makermare/UAV-FlyingControlSystem-LightFlightControl/5. 飞控官方基础源代码/对应的光流模块源码/README.txt

This is a Micro Python board

You can get started right away by writing your Python code in 'main.py'.

For a serial prompt:
 - Windows: you need to go to 'Device manager', right click on the unknown device,
   then update the driver software, using the 'openmv.inf' file found on this drive.
   Then use a terminal program like Hyperterminal or putty.
 - Mac OS X: use the command: screen /dev/tty.usbmodem*
 - Linux: use the command: screen /dev/ttyACM0

Please visit https://openmv.io/ or http://micropython.org/help/ for further help.
