makermare/UAV-FlyingControlSystem-LightFlightControl/15. 飞控外围模块资料2：蓝牙模块配置资料/先读我，补充说明.txt

蓝牙 与飞控连接  之前

确认蓝牙与TTL 是否连接正常(TXD接RXD)，波特率是否与AT指令模式 的波特率 一致
蓝牙模块未连接设备就一直是AT指令模式，AT指令模式的波特率 默认是9600，
而卖家发货前已修改为38400，以后是上一次更改过的

指令集中的 发送 AT\r\n 的本质不是让你 发送 “AT\r\n ”字符串，而是发送“AT”后加回车结尾，
加回车结尾 千万别理解成 回车键是发送，“AT”后加回车结尾 然后手动点击发送 检查是否通信正常，
有无OK回应，不正常请检查前几步骤。

发送“AT+BAUD6“ 后加回车结尾 改波特率为38400,1停止位,无校验
