makermare/UAV-FlyingControlSystem-LightFlightControl/6. 飞控官方源代码讲解/代码讲解.md

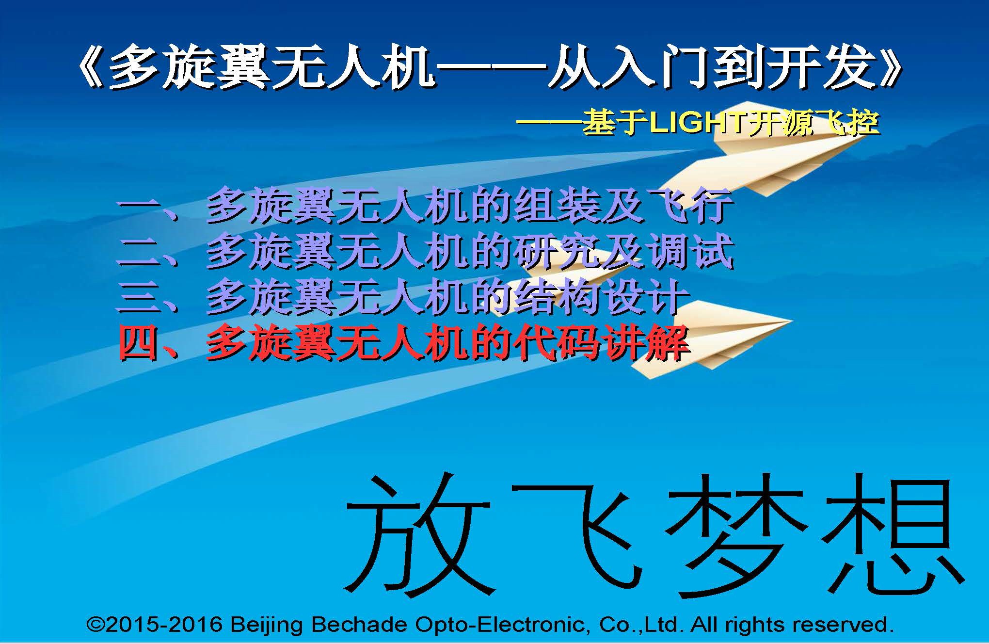
[picture p87: 6. 飞控官方源代码讲解/media/image1.jpeg]


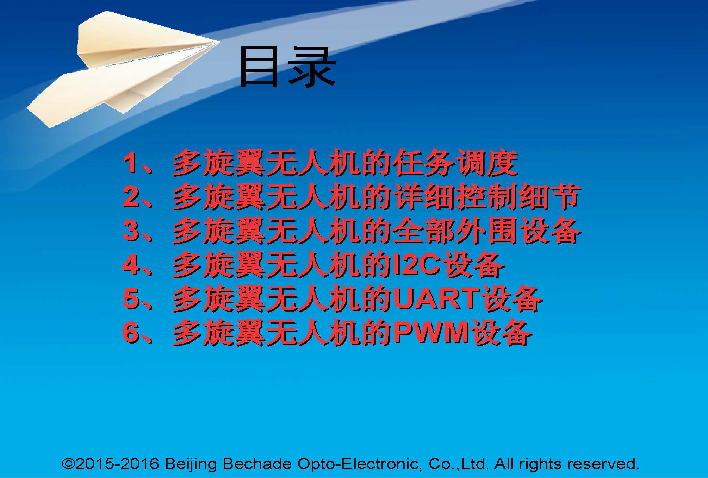
[picture p88: 6. 飞控官方源代码讲解/media/image2.jpeg]


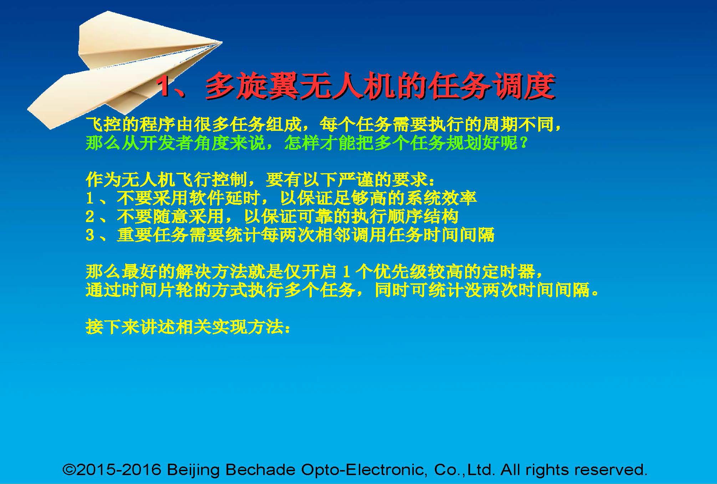
[picture p89: 6. 飞控官方源代码讲解/media/image3.jpeg]


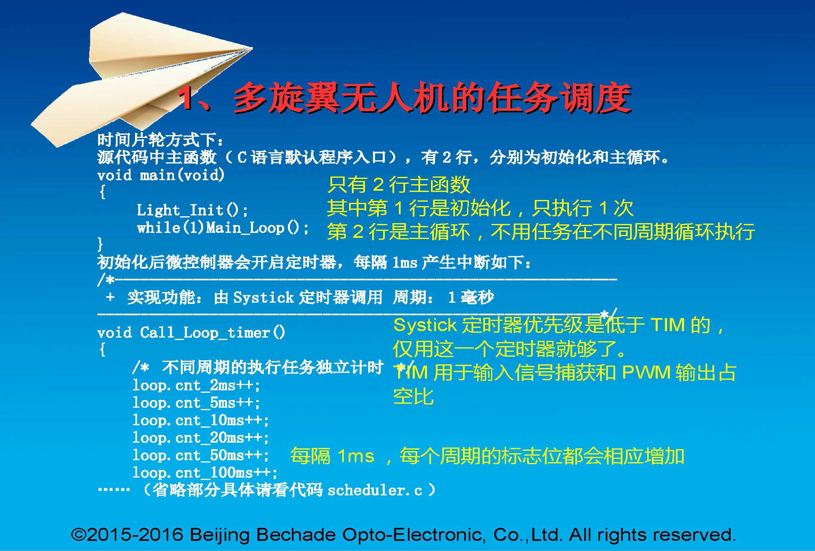
[picture p90: 6. 飞控官方源代码讲解/media/image4.jpeg]


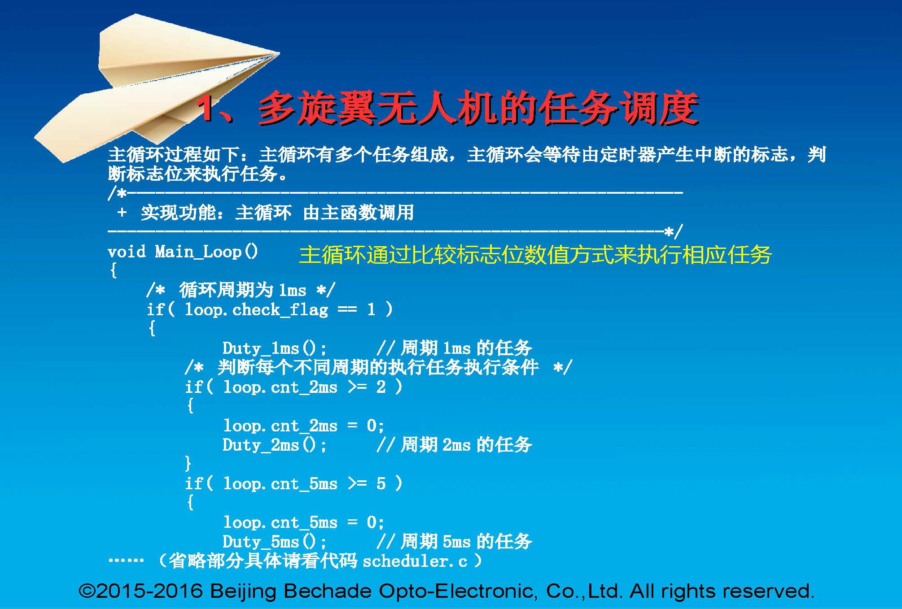
[picture p91: 6. 飞控官方源代码讲解/media/image5.jpeg]


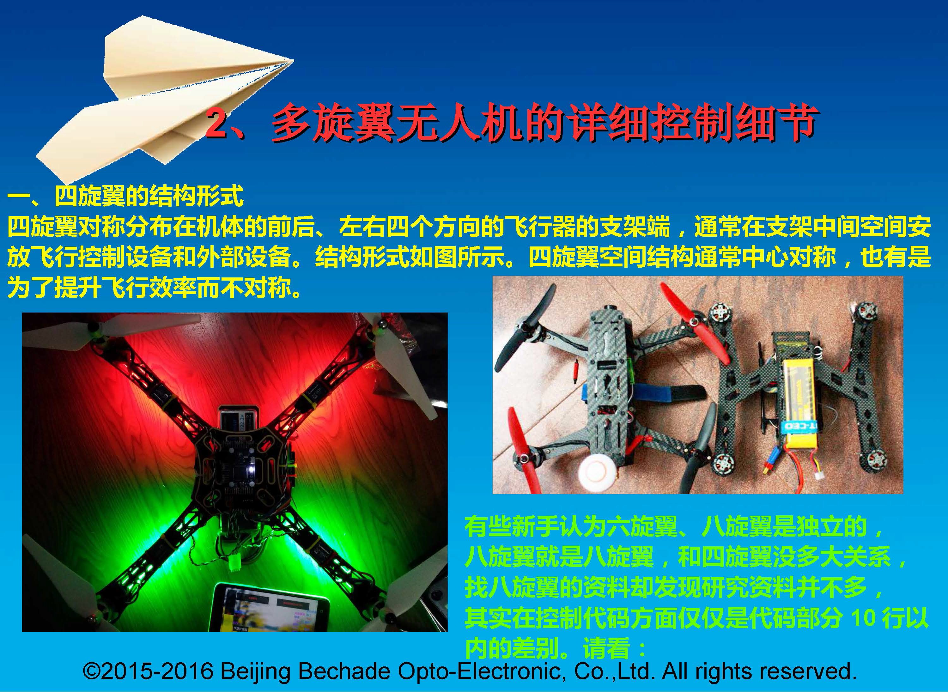
[picture p92: 6. 飞控官方源代码讲解/media/image6.jpeg]


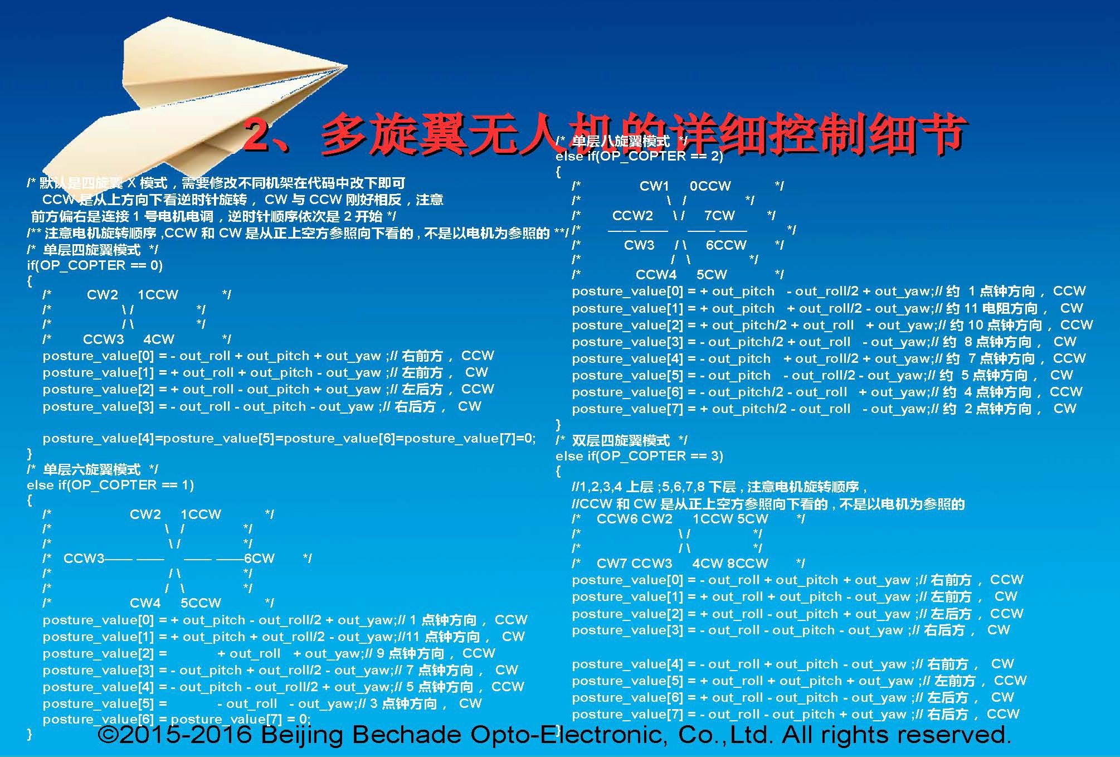
[picture p93: 6. 飞控官方源代码讲解/media/image7.jpeg]


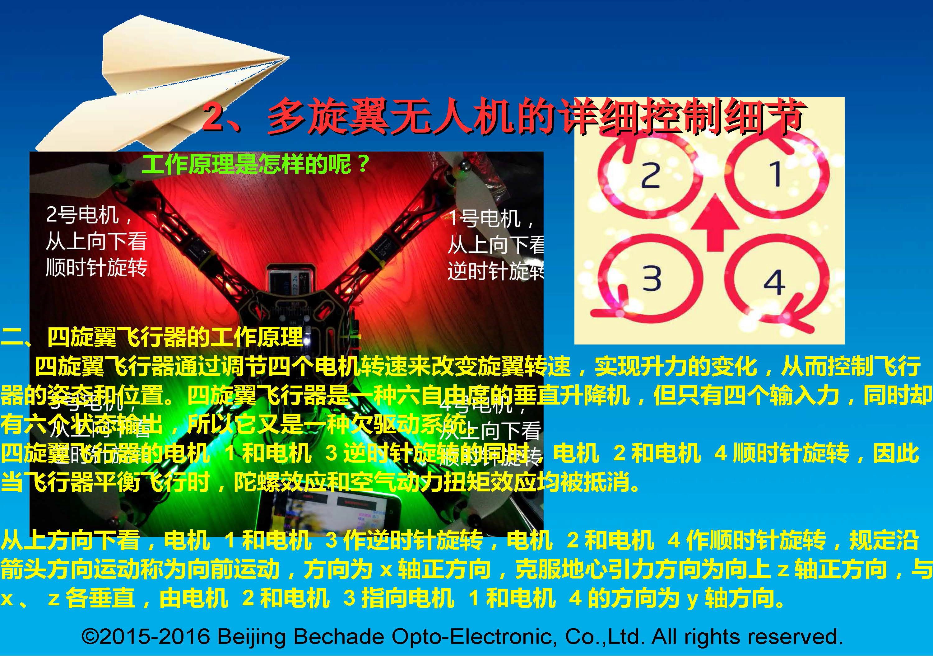
[picture p94: 6. 飞控官方源代码讲解/media/image8.jpeg]


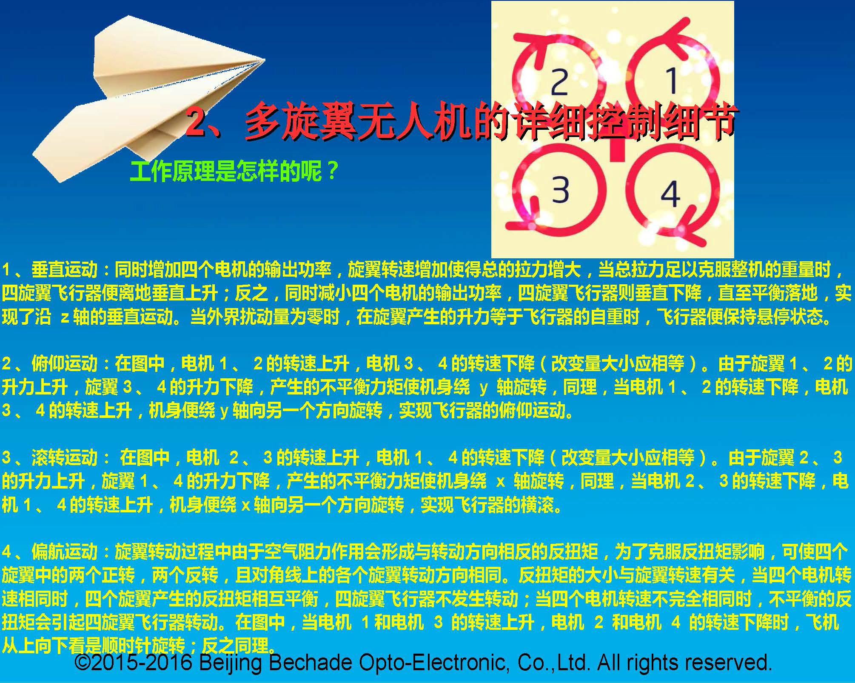
[picture p95: 6. 飞控官方源代码讲解/media/image9.jpeg]


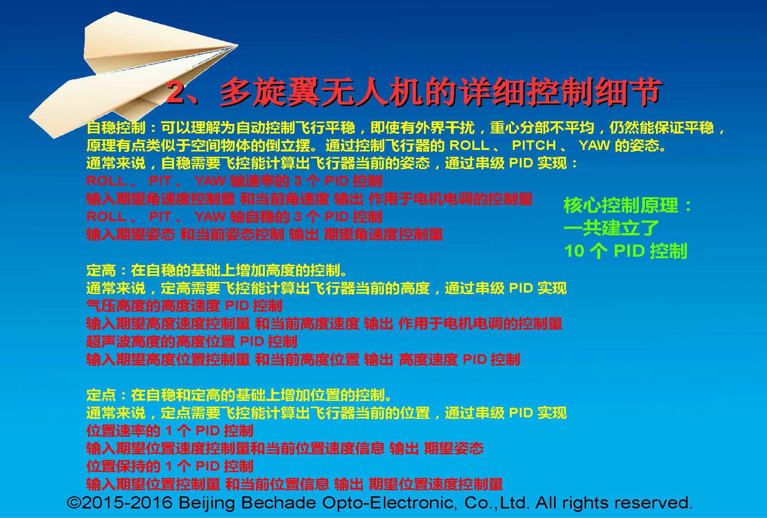
[picture p96: 6. 飞控官方源代码讲解/media/image10.jpeg]


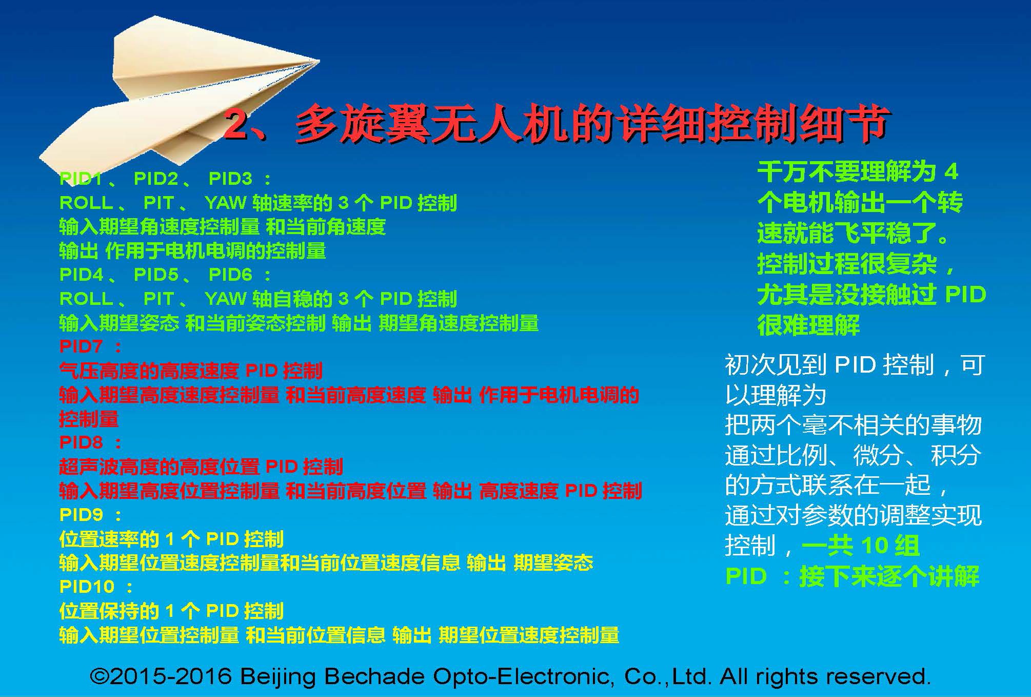
[picture p97: 6. 飞控官方源代码讲解/media/image11.jpeg]


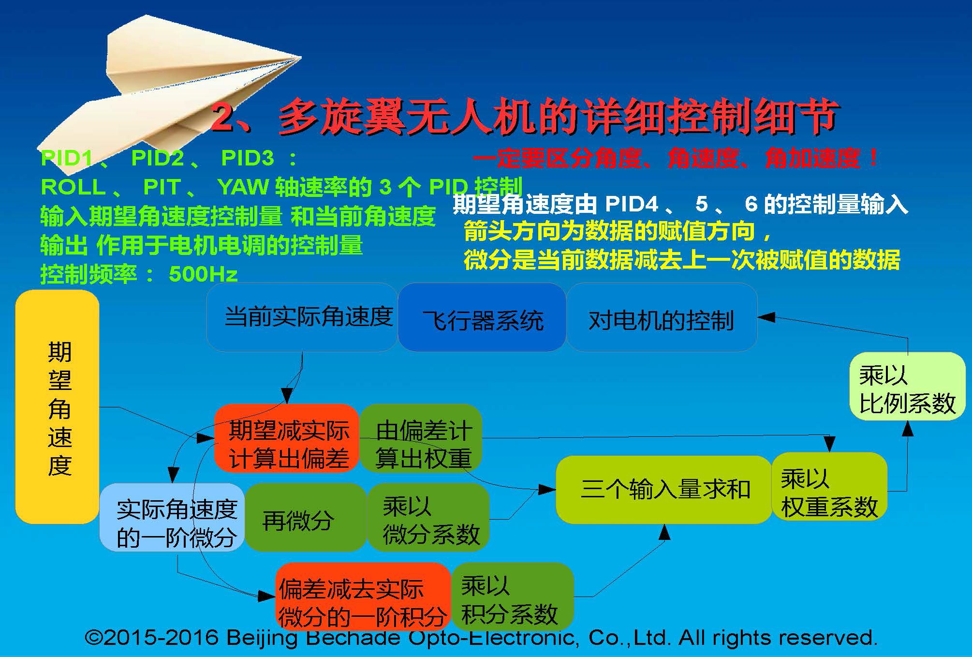
[picture p98: 6. 飞控官方源代码讲解/media/image12.jpeg]


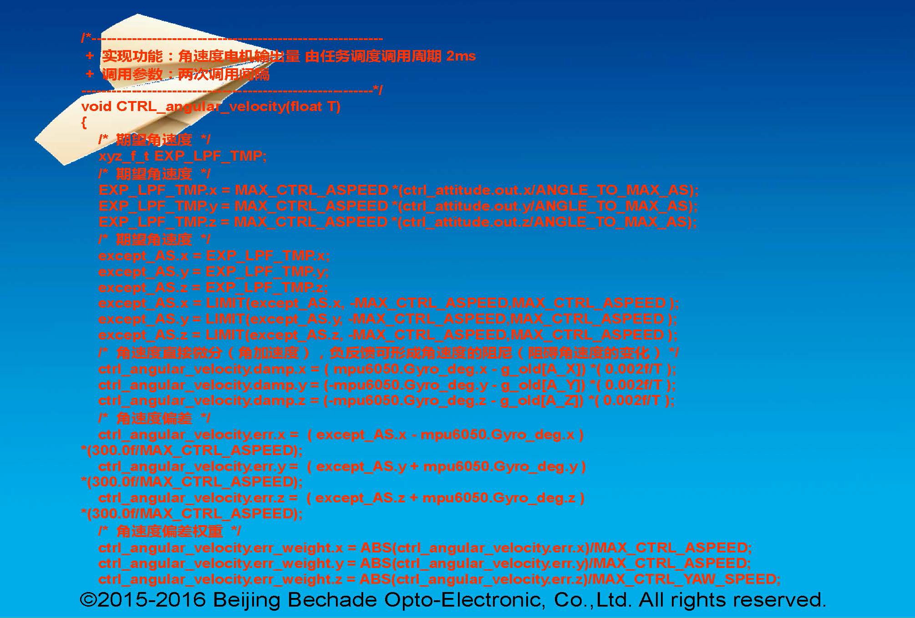
[picture p99: 6. 飞控官方源代码讲解/media/image13.jpeg]


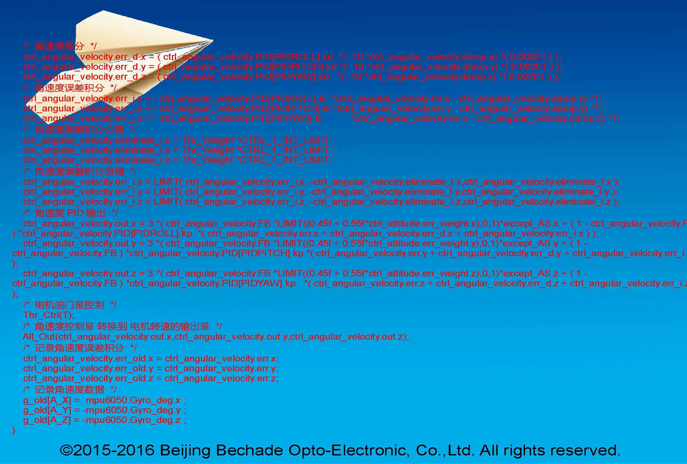
[picture p100: 6. 飞控官方源代码讲解/media/image14.jpeg]


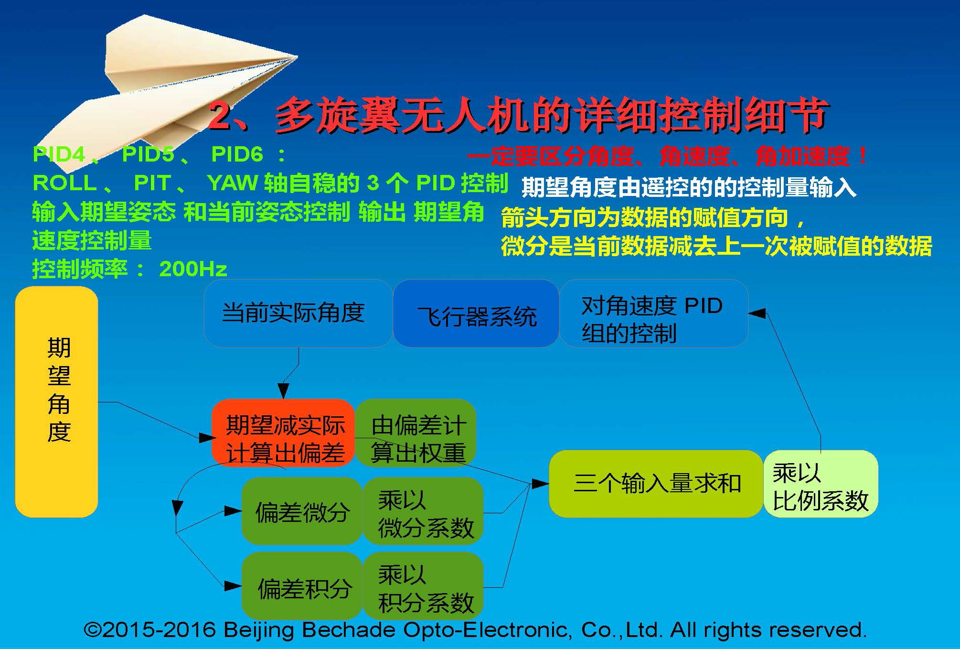
[picture p101: 6. 飞控官方源代码讲解/media/image15.jpeg]


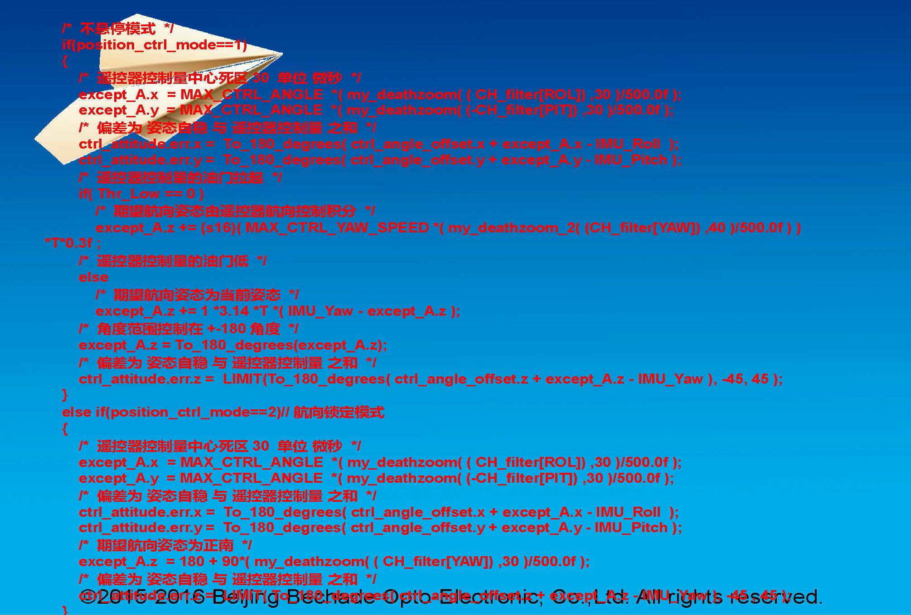
[picture p102: 6. 飞控官方源代码讲解/media/image16.jpeg]


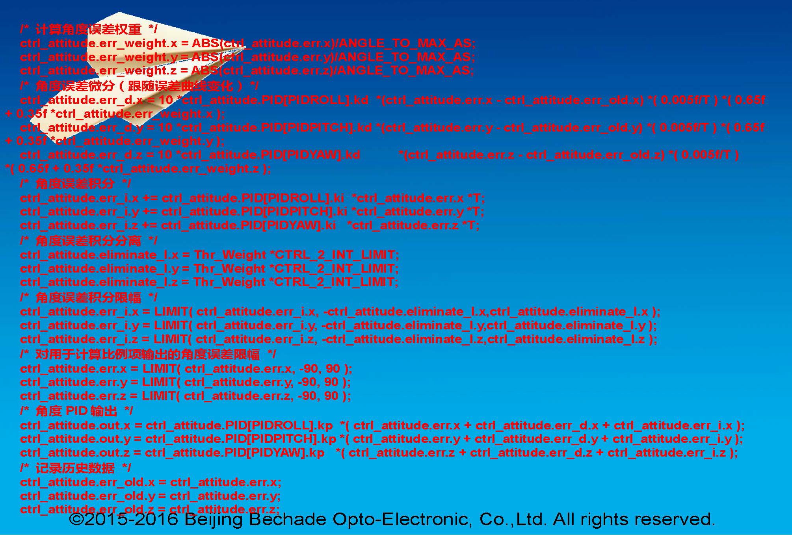
[picture p103: 6. 飞控官方源代码讲解/media/image17.jpeg]


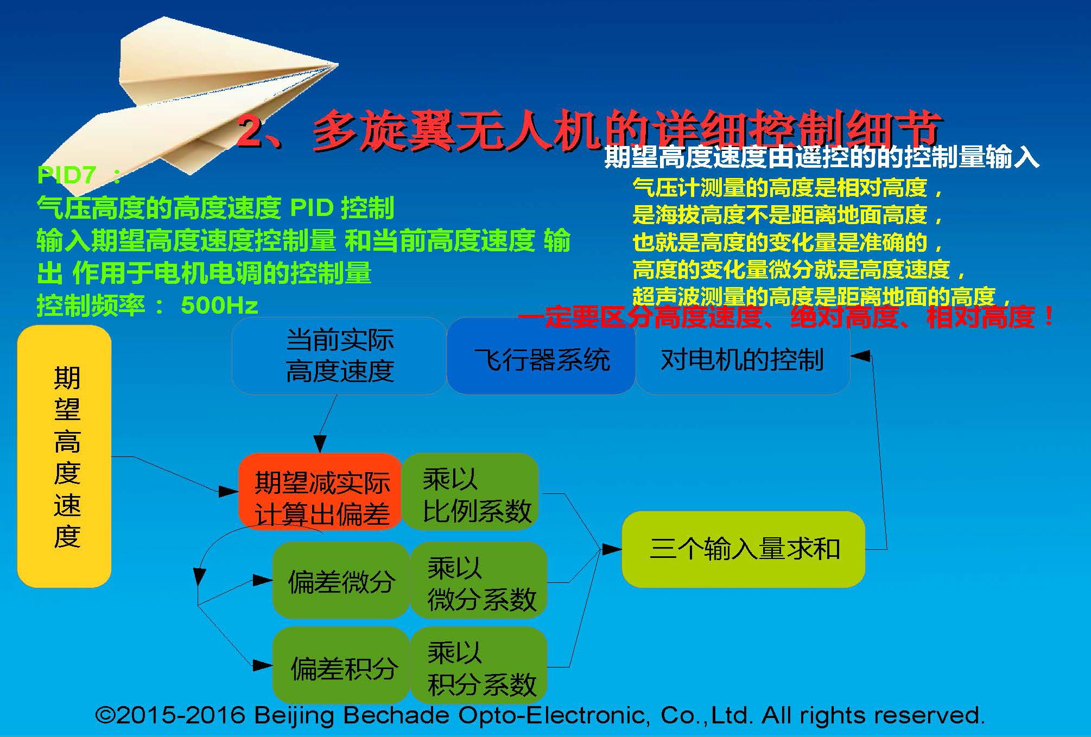
[picture p104: 6. 飞控官方源代码讲解/media/image18.jpeg]


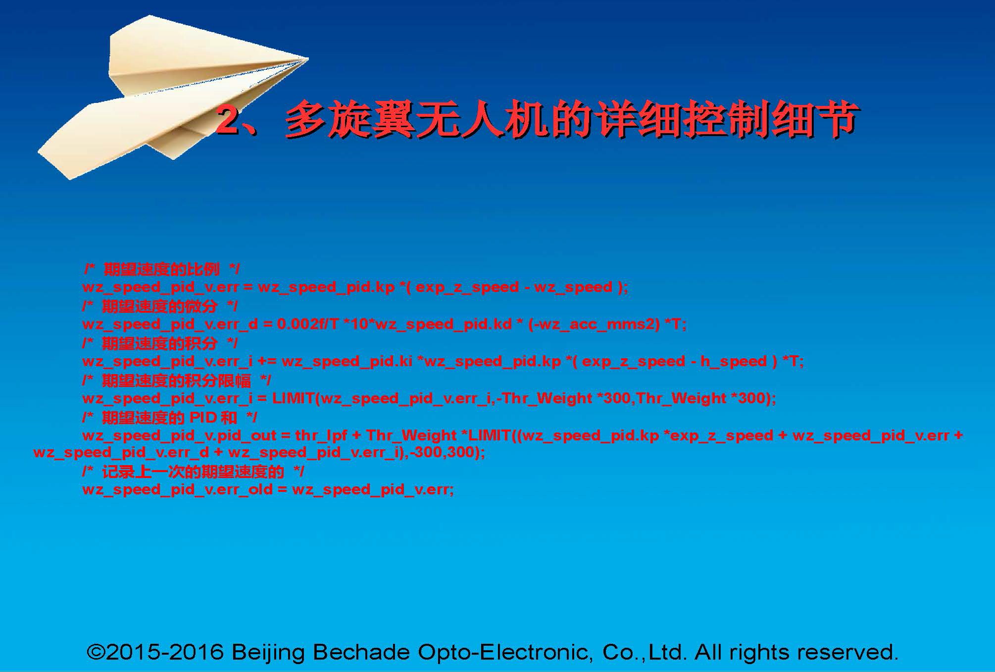
[picture p105: 6. 飞控官方源代码讲解/media/image19.jpeg]


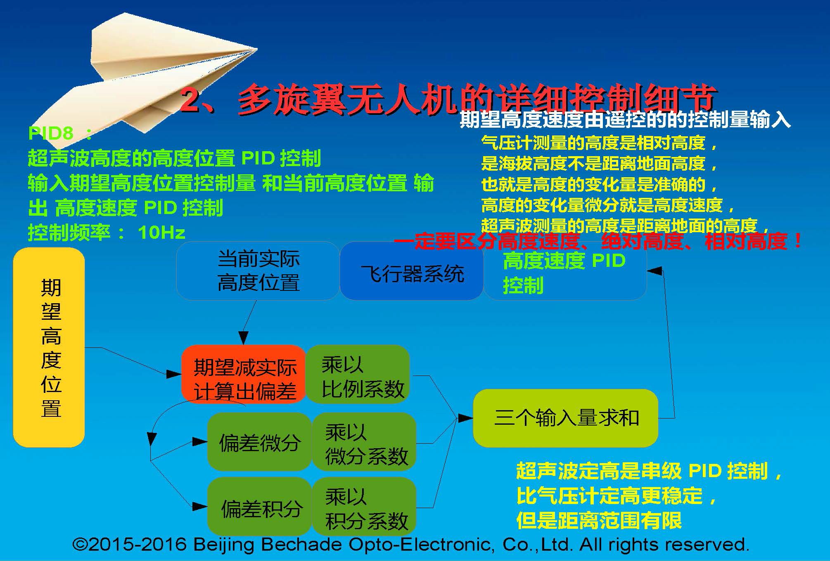
[picture p106: 6. 飞控官方源代码讲解/media/image20.jpeg]


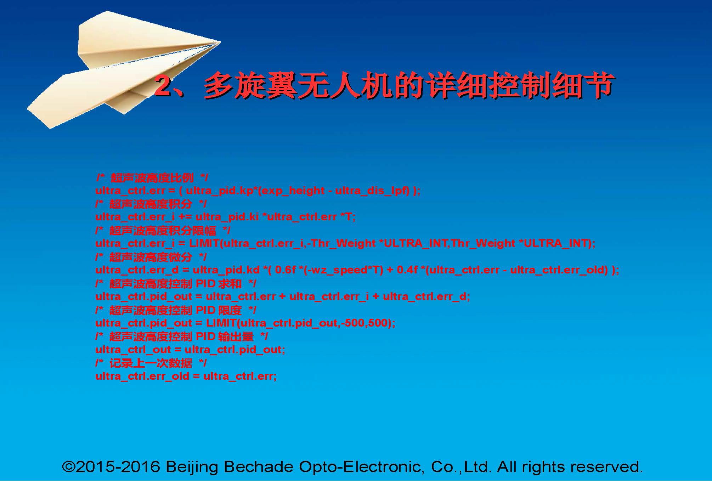
[picture p107: 6. 飞控官方源代码讲解/media/image21.jpeg]


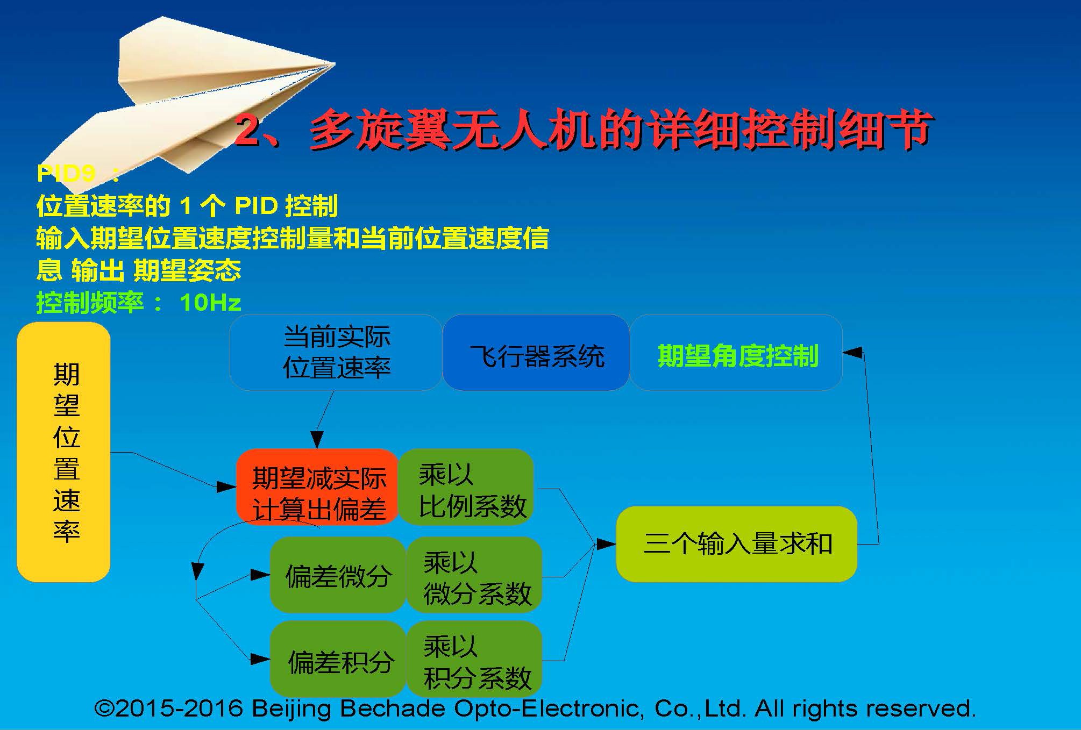
[picture p108: 6. 飞控官方源代码讲解/media/image22.jpeg]


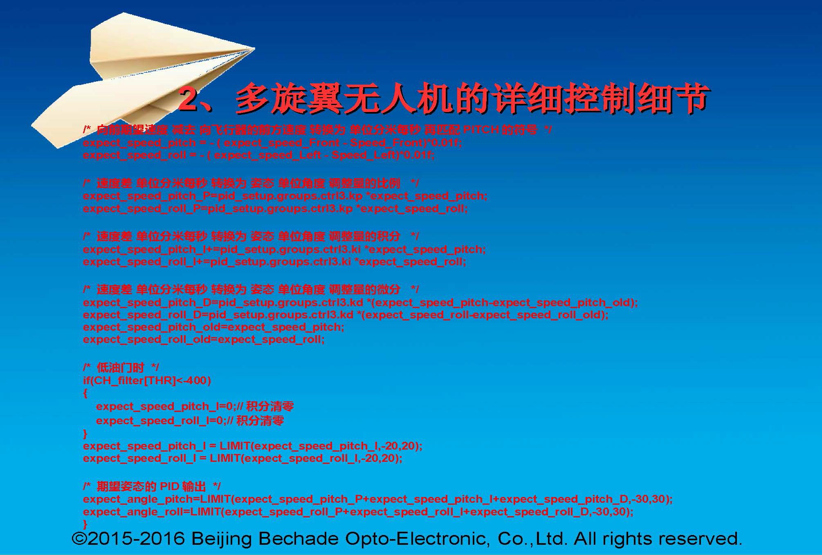
[picture p109: 6. 飞控官方源代码讲解/media/image23.jpeg]


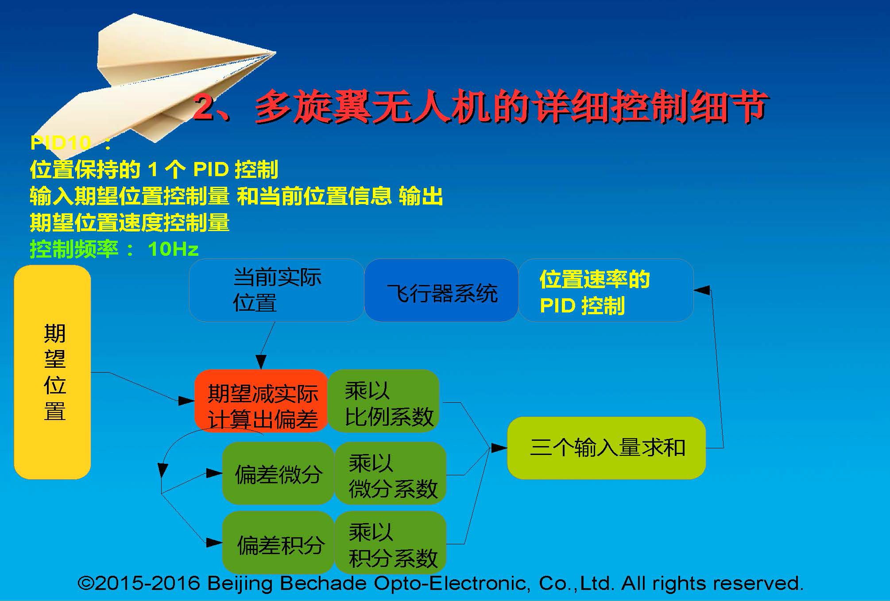
[picture p110: 6. 飞控官方源代码讲解/media/image24.jpeg]


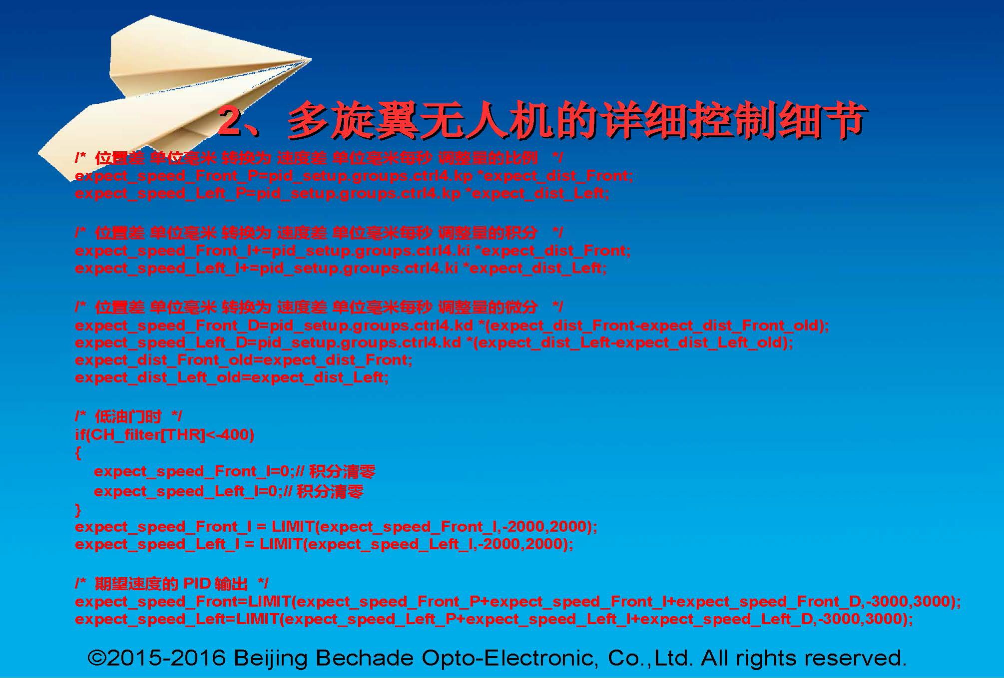
[picture p111: 6. 飞控官方源代码讲解/media/image25.jpeg]


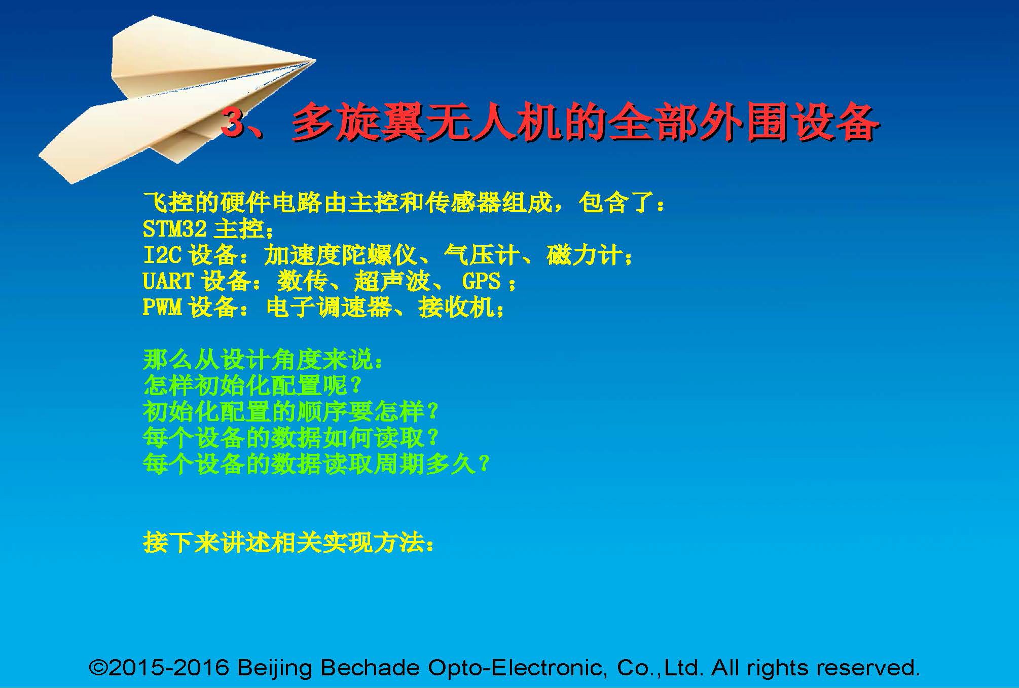
[picture p112: 6. 飞控官方源代码讲解/media/image26.jpeg]


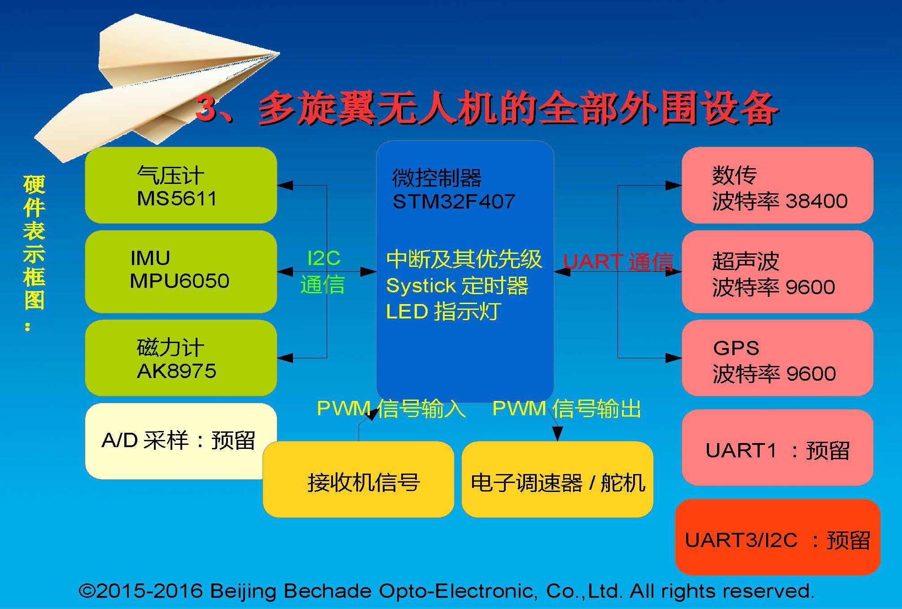
[picture p113: 6. 飞控官方源代码讲解/media/image27.jpeg]


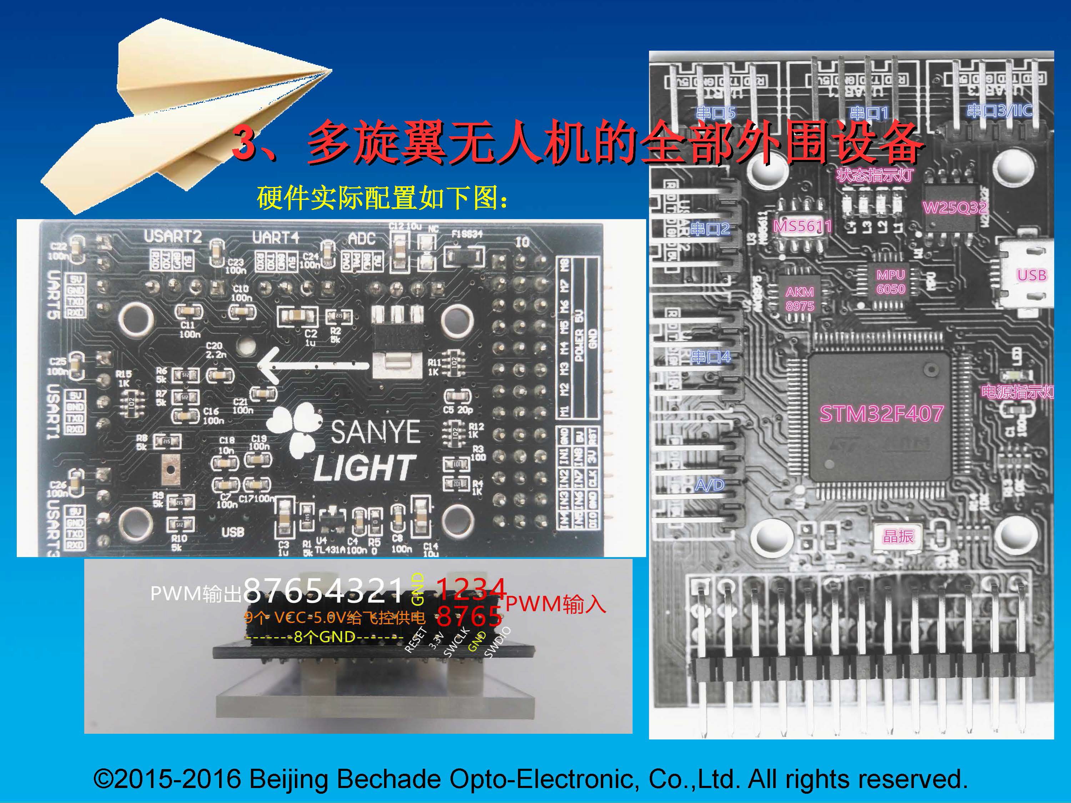
[picture p114: 6. 飞控官方源代码讲解/media/image28.jpeg]


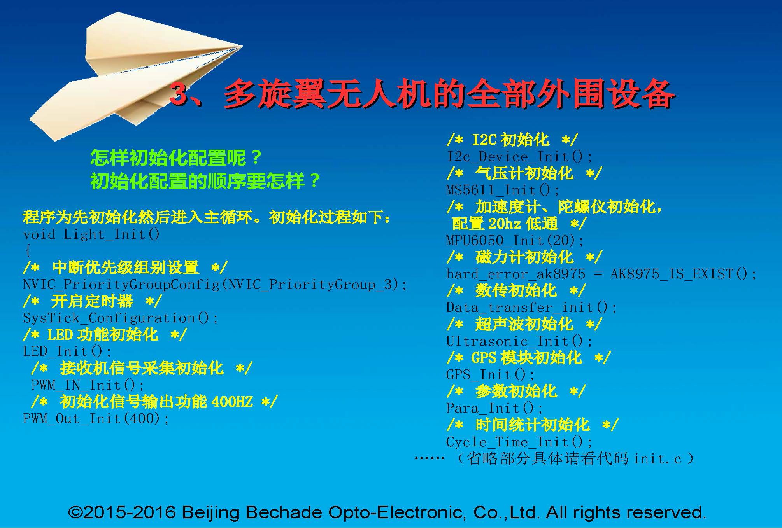
[picture p115: 6. 飞控官方源代码讲解/media/image29.jpeg]


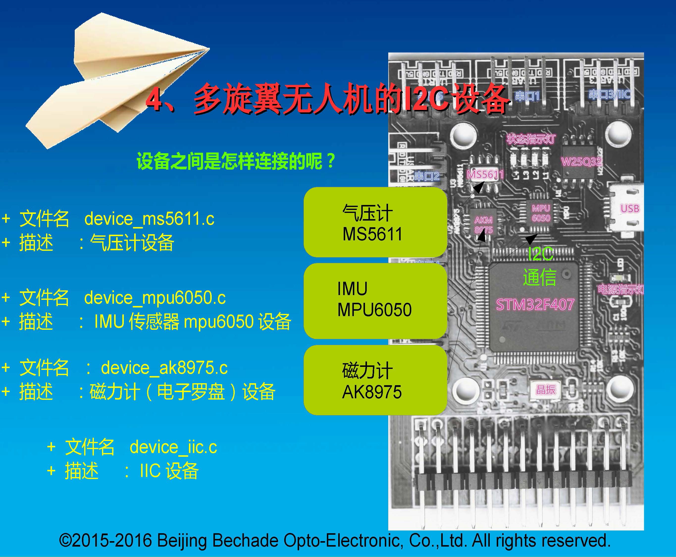
[picture p116: 6. 飞控官方源代码讲解/media/image30.jpeg]


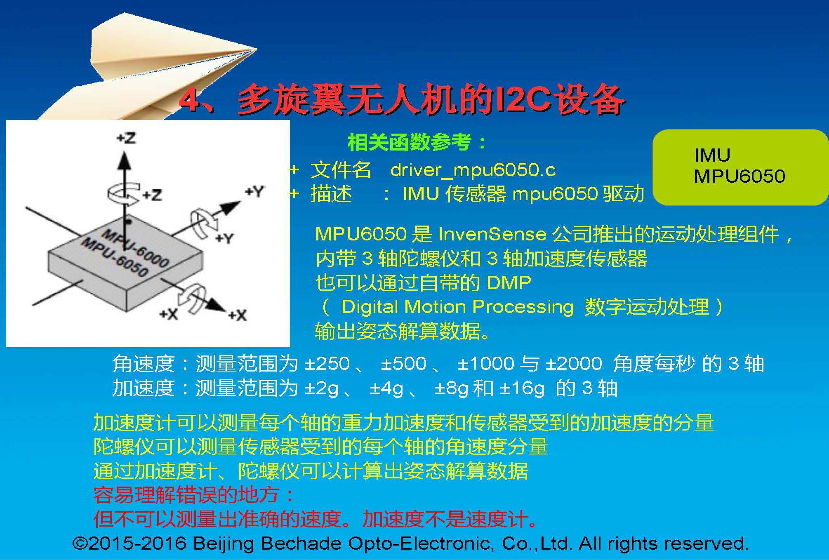
[picture p117: 6. 飞控官方源代码讲解/media/image31.jpeg]


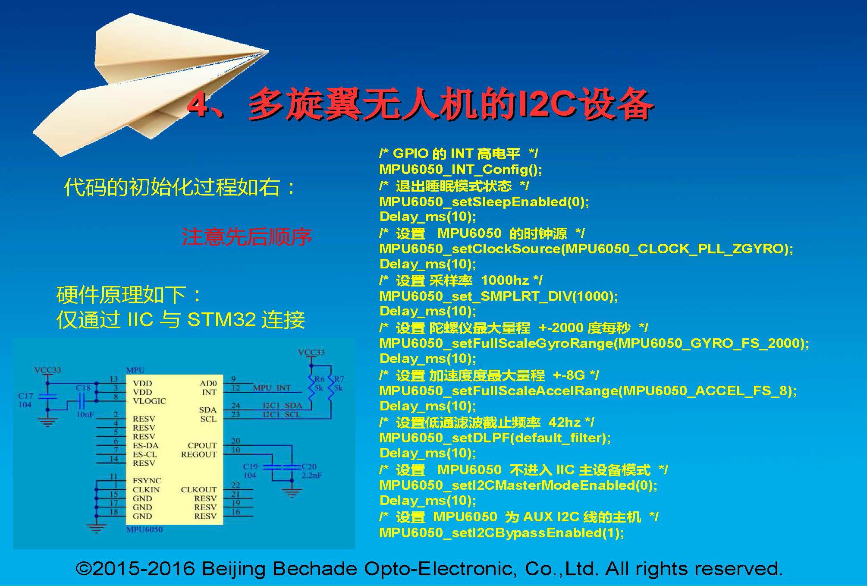
[picture p118: 6. 飞控官方源代码讲解/media/image32.jpeg]


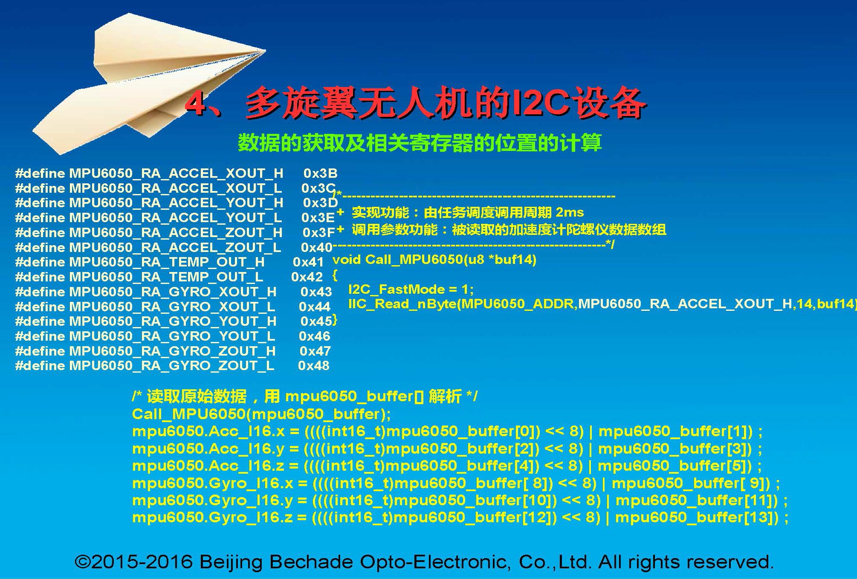
[picture p119: 6. 飞控官方源代码讲解/media/image33.jpeg]


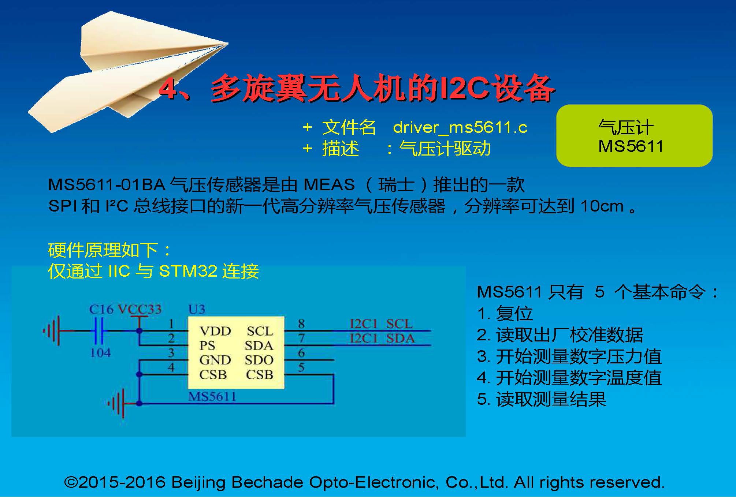
[picture p120: 6. 飞控官方源代码讲解/media/image34.jpeg]


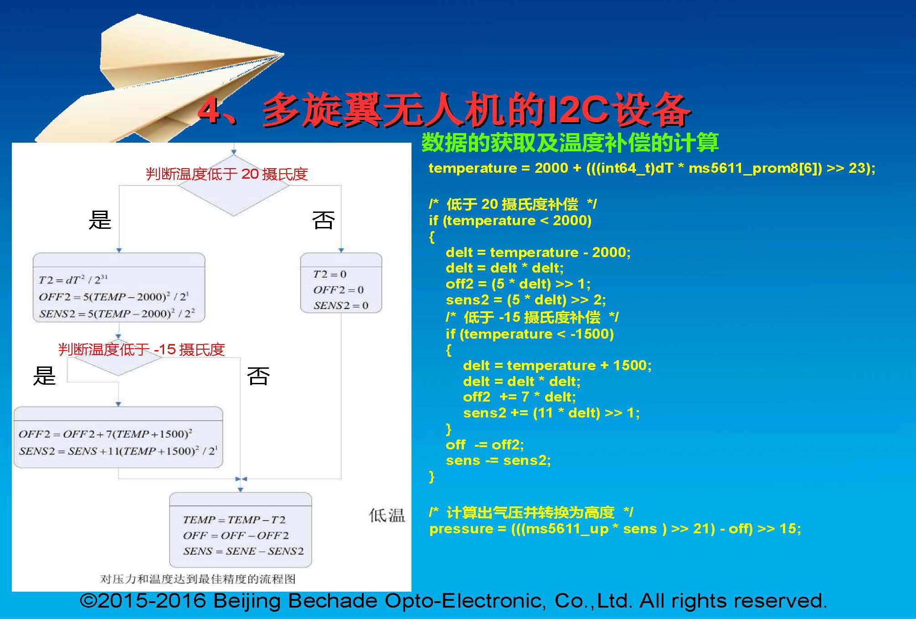
[picture p121: 6. 飞控官方源代码讲解/media/image35.jpeg]


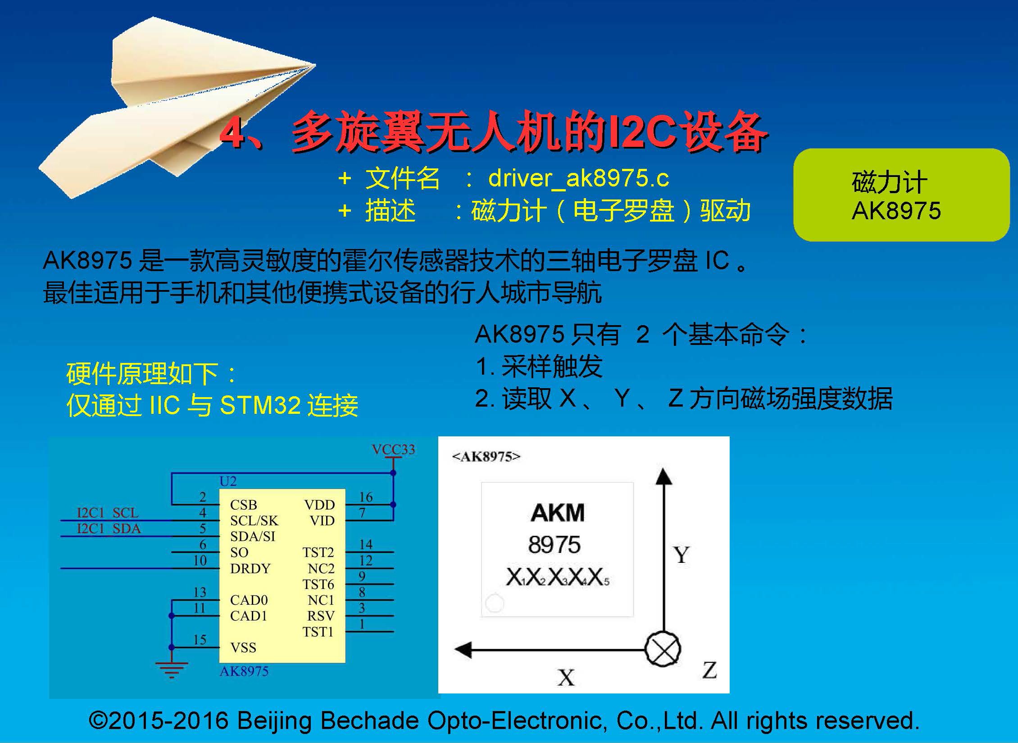
[picture p122: 6. 飞控官方源代码讲解/media/image36.jpeg]


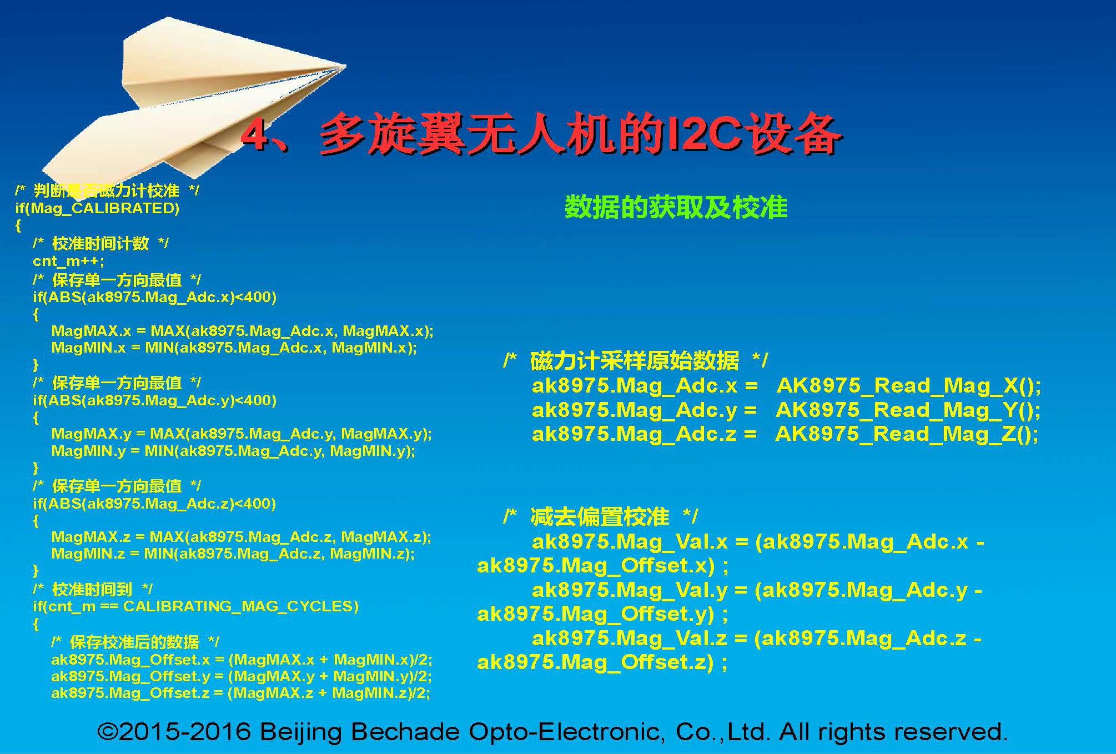
[picture p123: 6. 飞控官方源代码讲解/media/image37.jpeg]


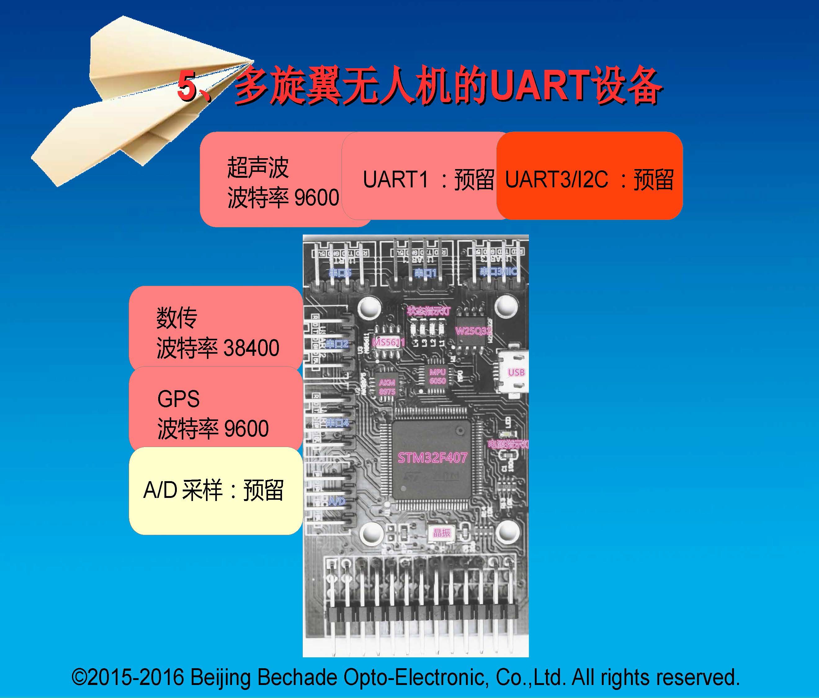
[picture p124: 6. 飞控官方源代码讲解/media/image38.jpeg]


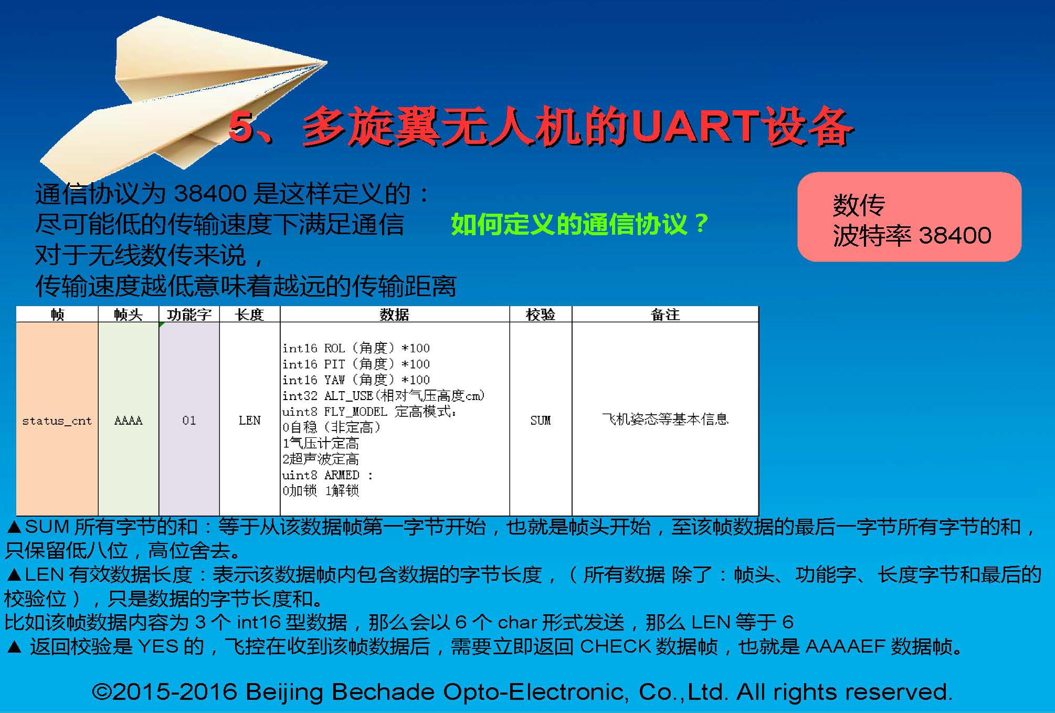
[picture p125: 6. 飞控官方源代码讲解/media/image39.jpeg]


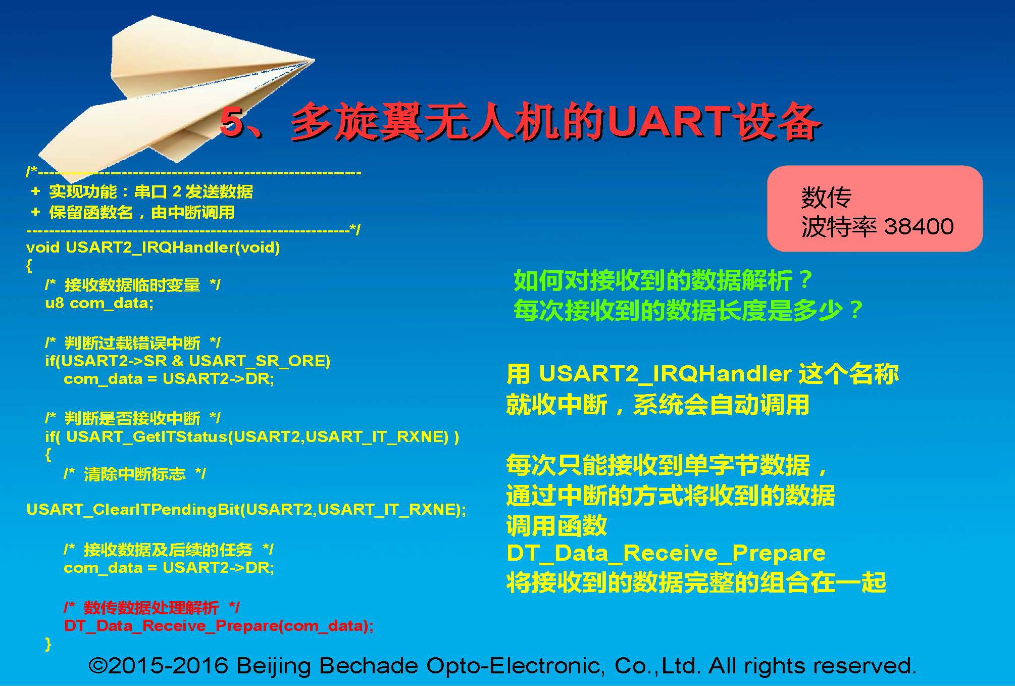
[picture p126: 6. 飞控官方源代码讲解/media/image40.jpeg]


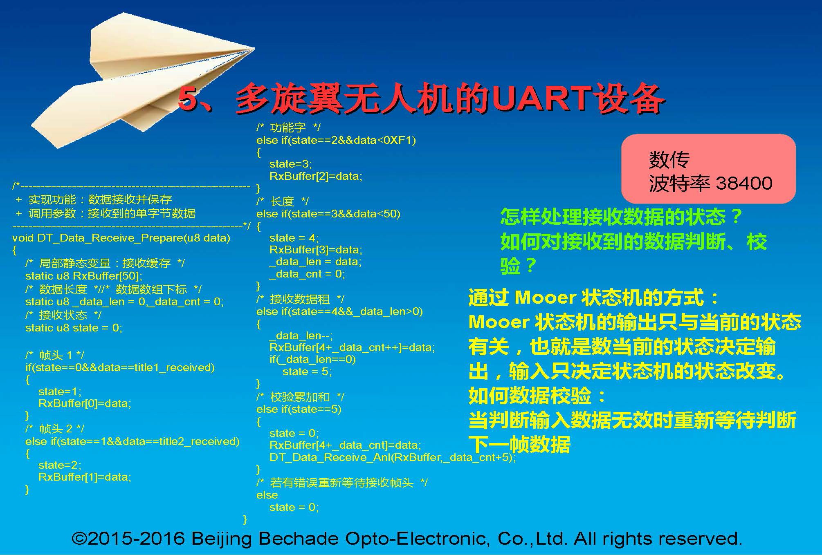
[picture p127: 6. 飞控官方源代码讲解/media/image41.jpeg]


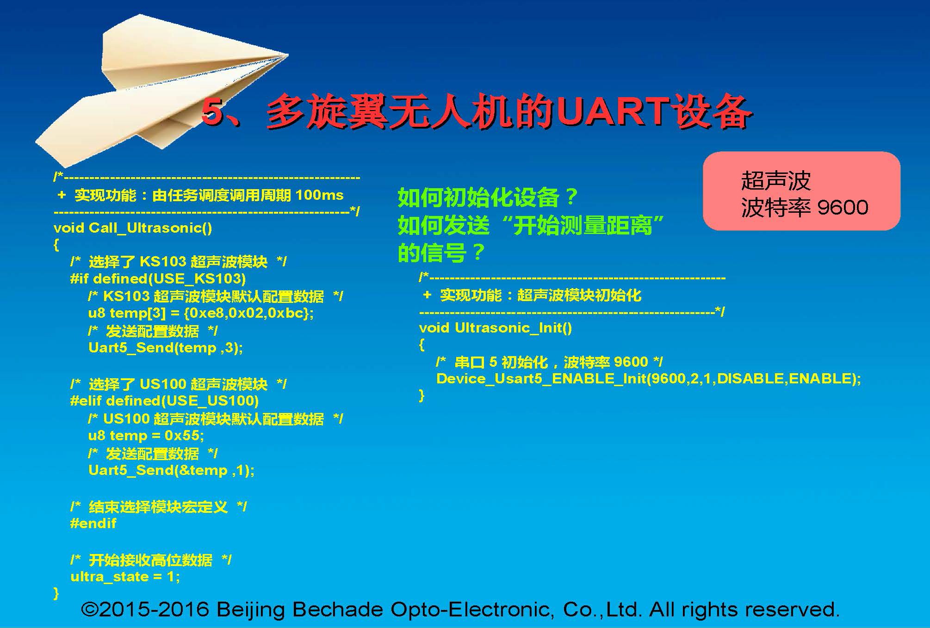
[picture p128: 6. 飞控官方源代码讲解/media/image42.jpeg]


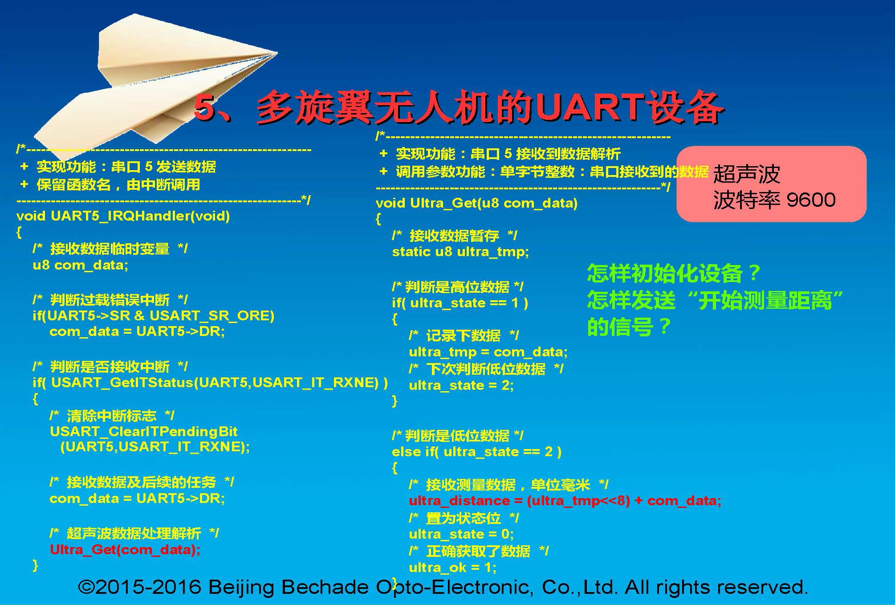
[picture p129: 6. 飞控官方源代码讲解/media/image43.jpeg]


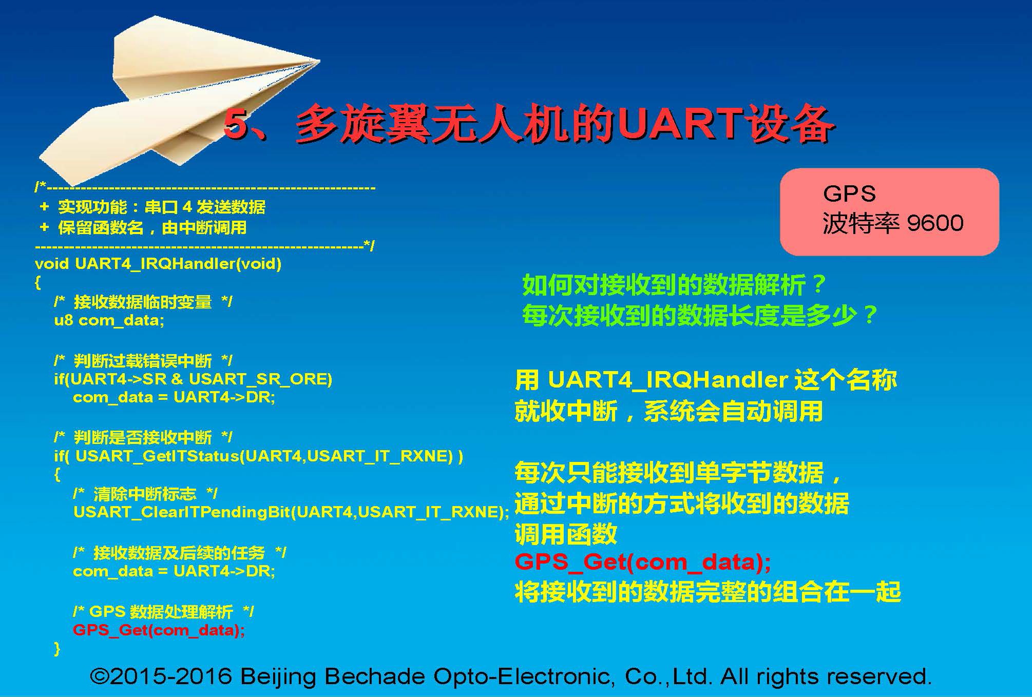
[picture p130: 6. 飞控官方源代码讲解/media/image44.jpeg]


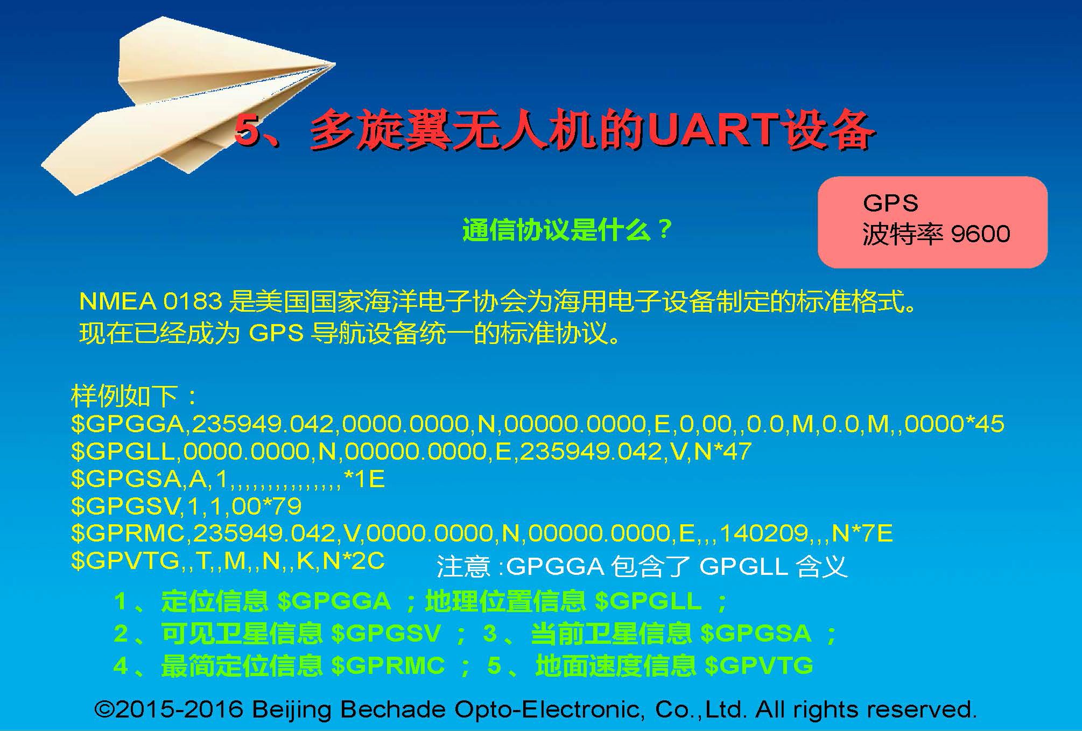
[picture p131: 6. 飞控官方源代码讲解/media/image45.jpeg]


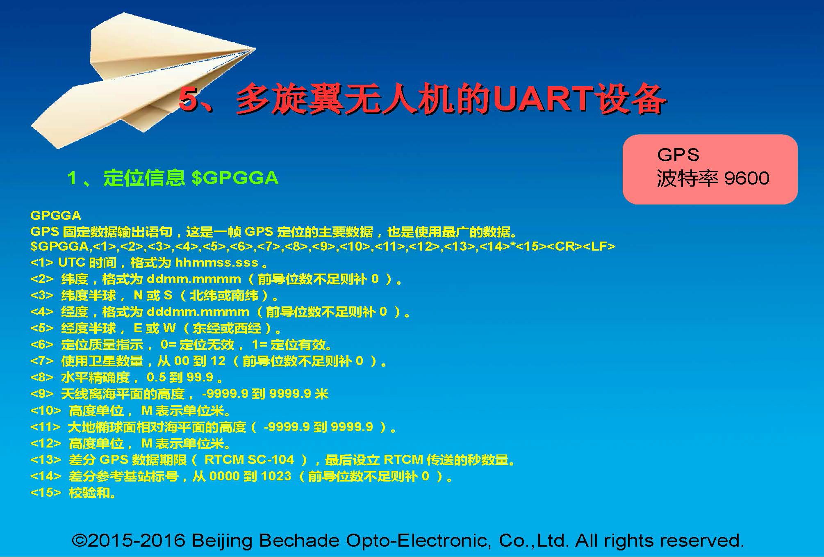
[picture p132: 6. 飞控官方源代码讲解/media/image46.jpeg]


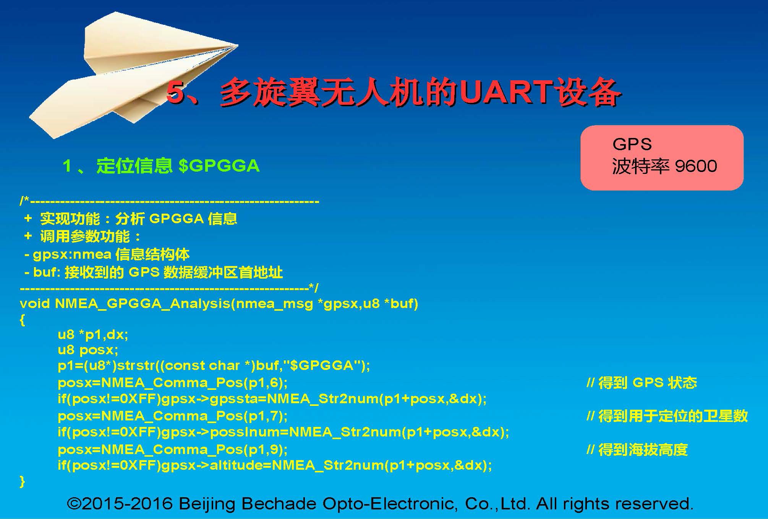
[picture p133: 6. 飞控官方源代码讲解/media/image47.jpeg]


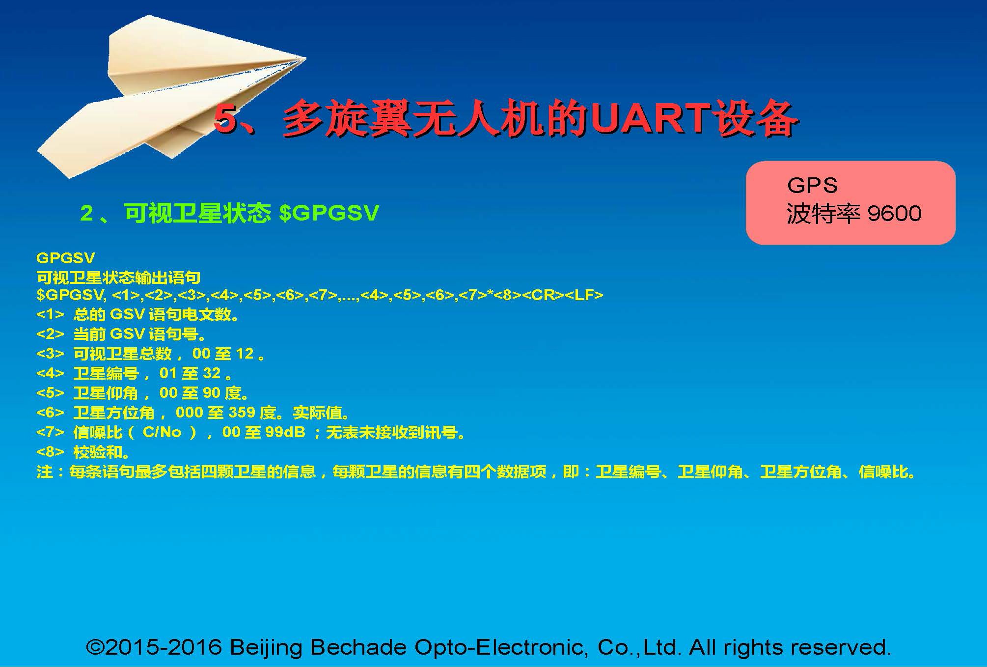
[picture p134: 6. 飞控官方源代码讲解/media/image48.jpeg]


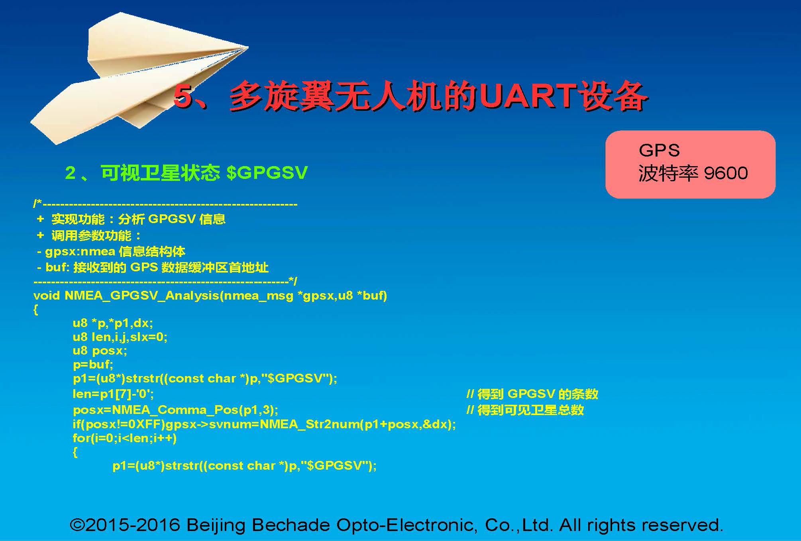
[picture p135: 6. 飞控官方源代码讲解/media/image49.jpeg]


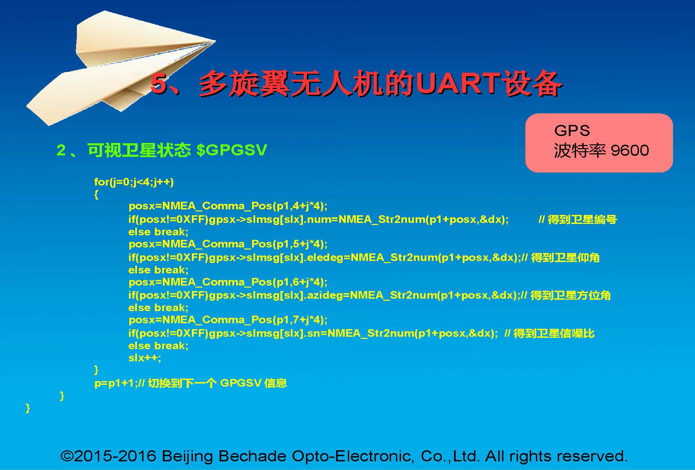
[picture p136: 6. 飞控官方源代码讲解/media/image50.jpeg]


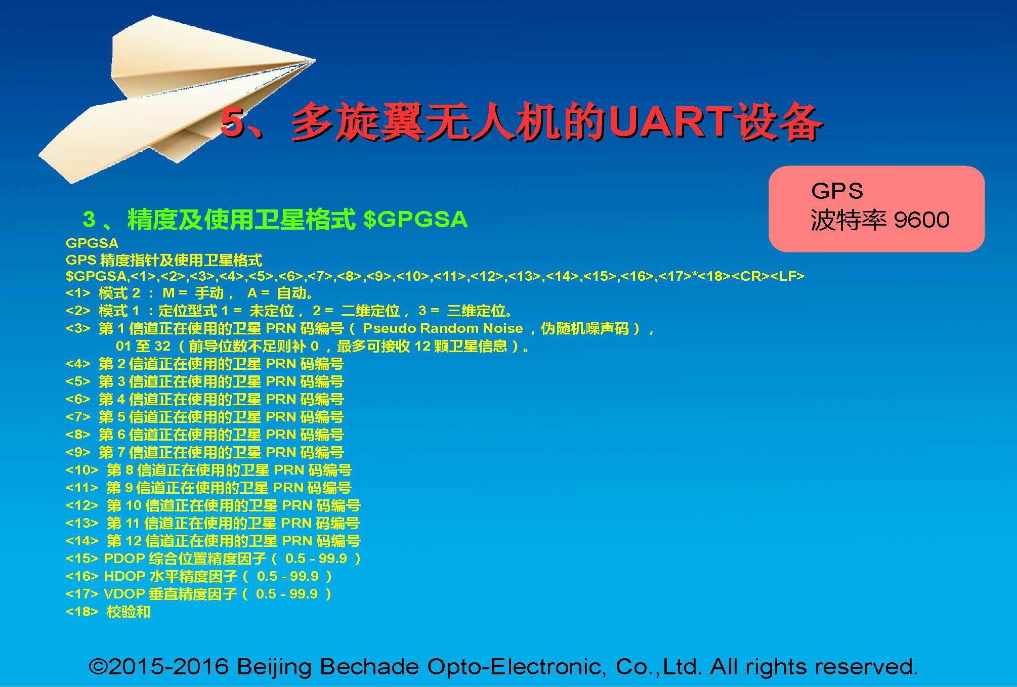
[picture p137: 6. 飞控官方源代码讲解/media/image51.jpeg]


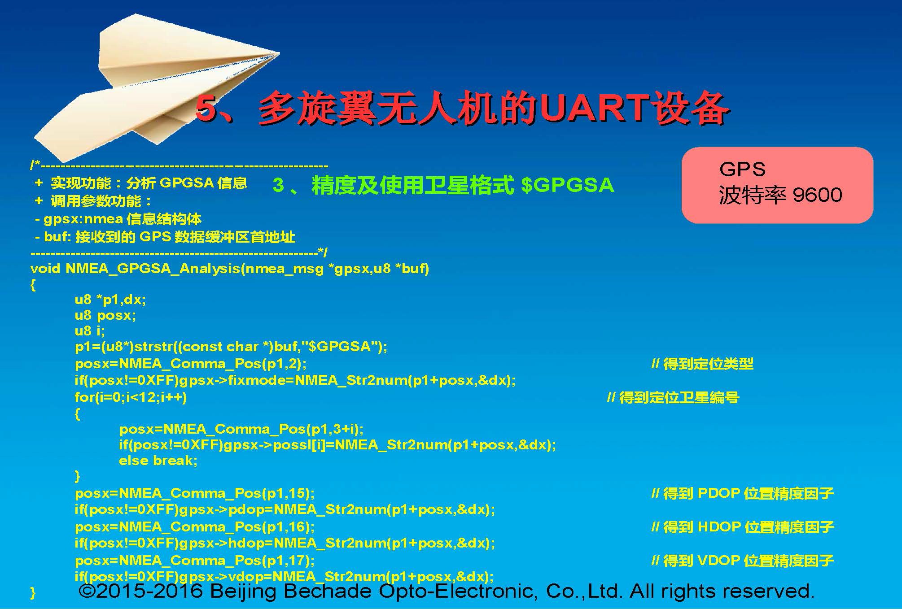
[picture p138: 6. 飞控官方源代码讲解/media/image52.jpeg]


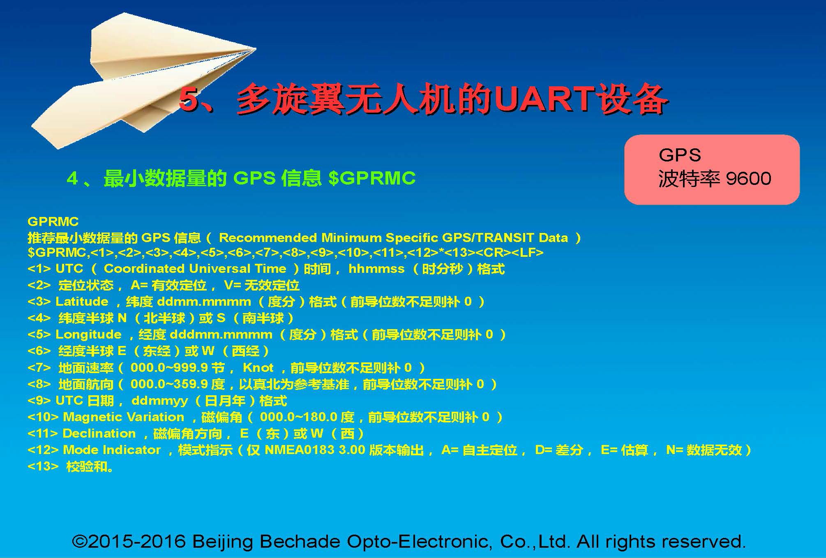
[picture p139: 6. 飞控官方源代码讲解/media/image53.jpeg]


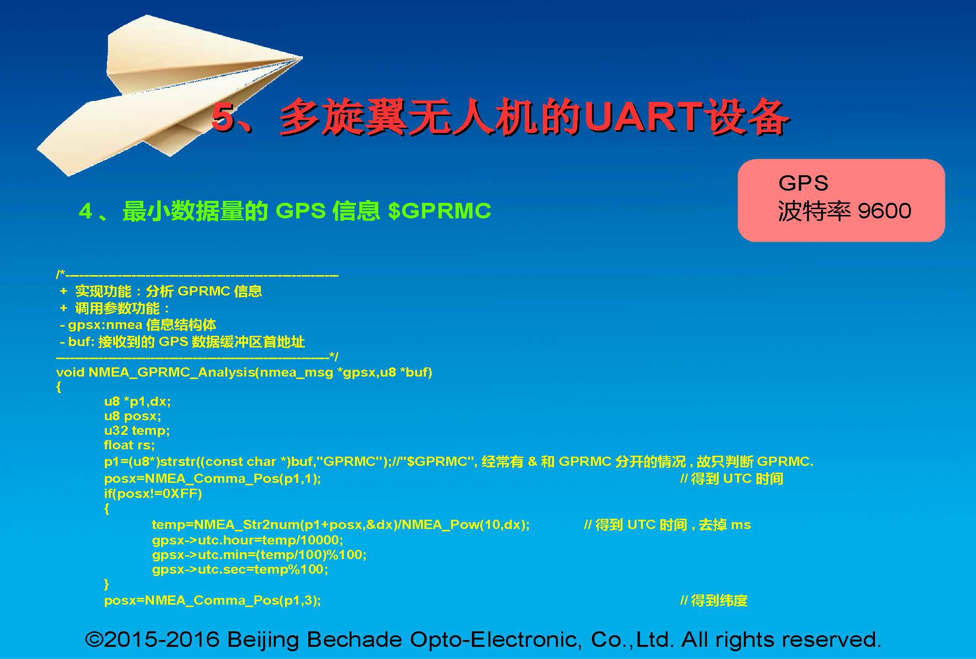
[picture p140: 6. 飞控官方源代码讲解/media/image54.jpeg]


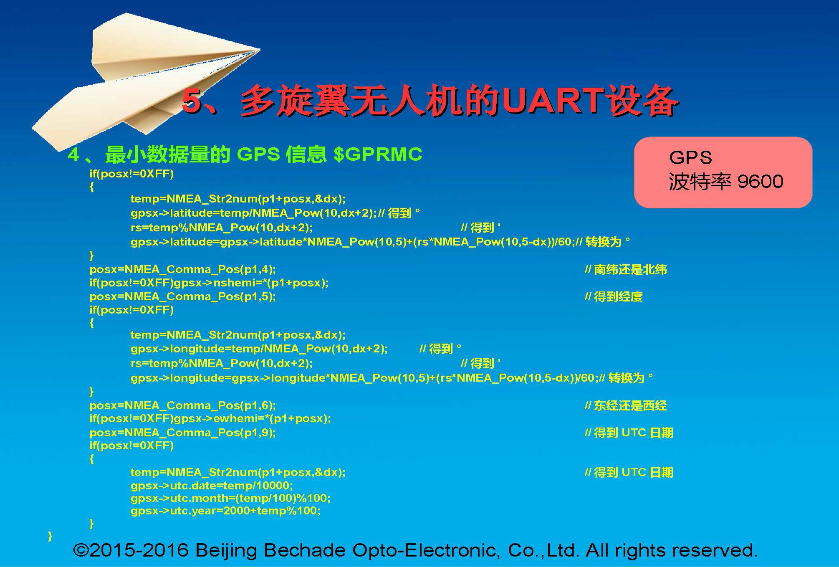
[picture p141: 6. 飞控官方源代码讲解/media/image55.jpeg]


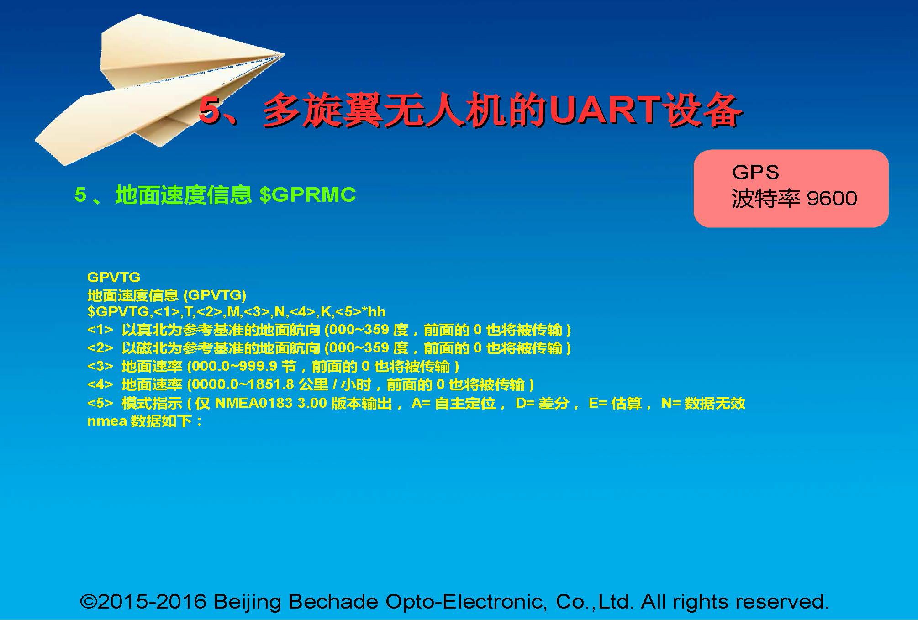
[picture p142: 6. 飞控官方源代码讲解/media/image56.jpeg]


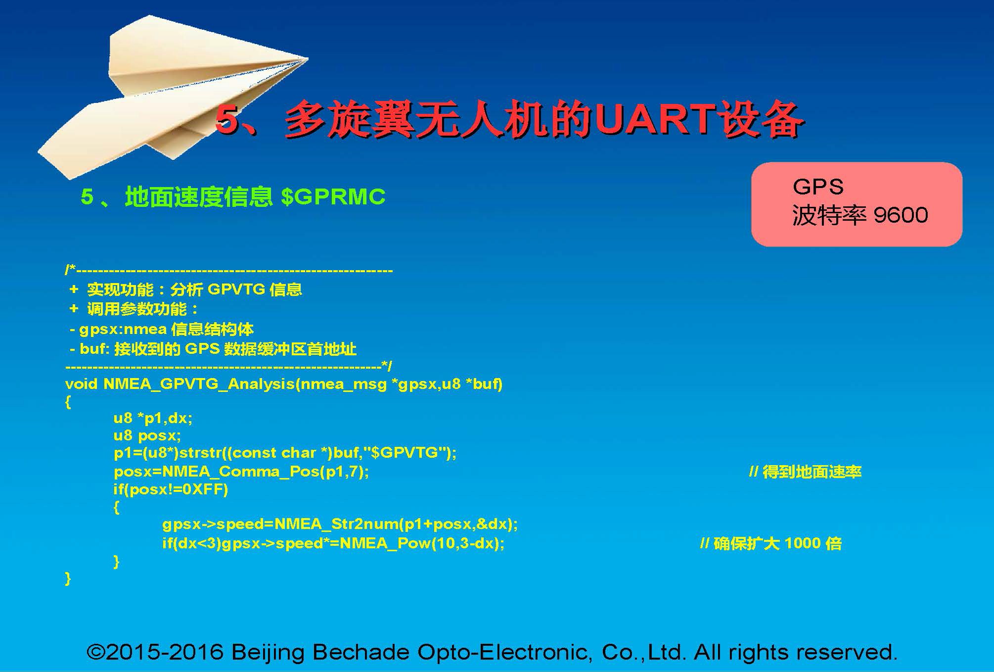
[picture p143: 6. 飞控官方源代码讲解/media/image57.jpeg]


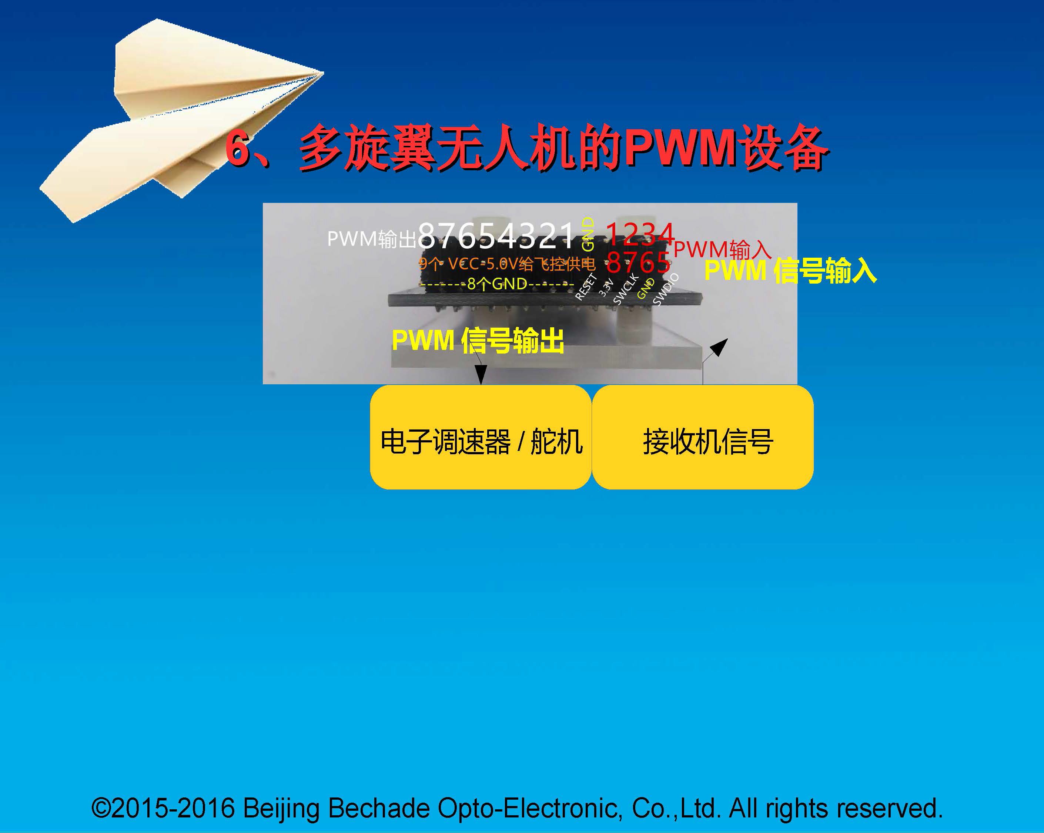
[picture p144: 6. 飞控官方源代码讲解/media/image58.jpeg]


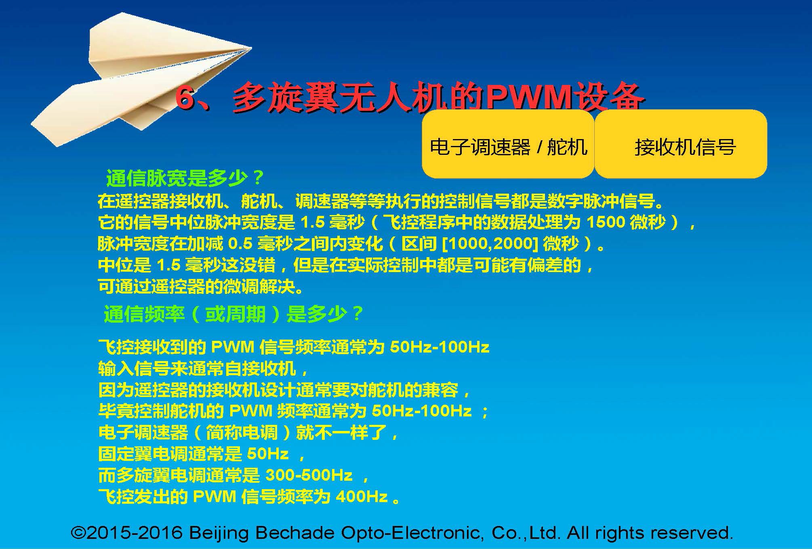
[picture p145: 6. 飞控官方源代码讲解/media/image59.jpeg]


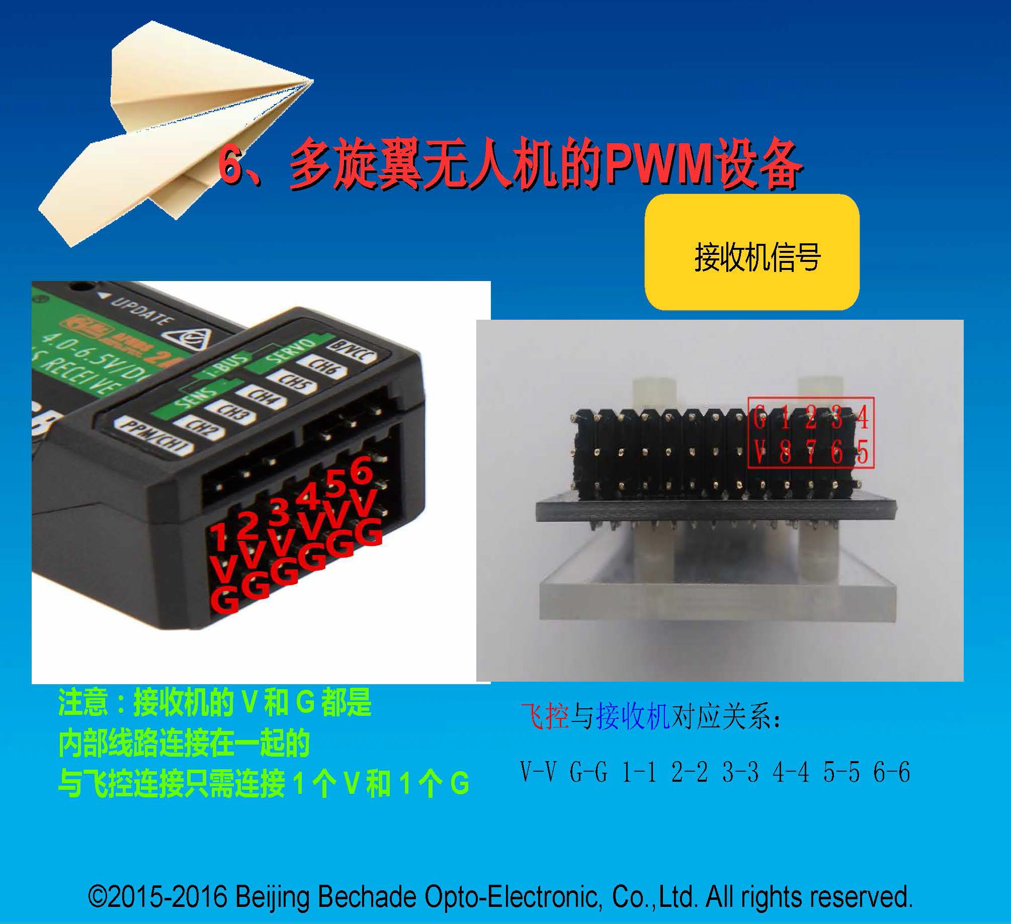
[picture p146: 6. 飞控官方源代码讲解/media/image60.jpeg]


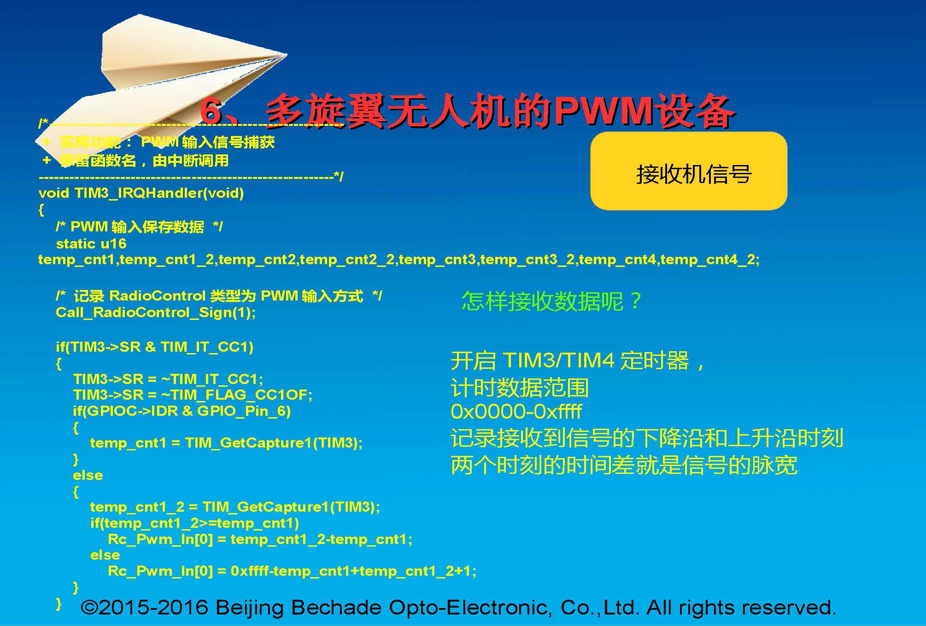
[picture p147: 6. 飞控官方源代码讲解/media/image61.jpeg]


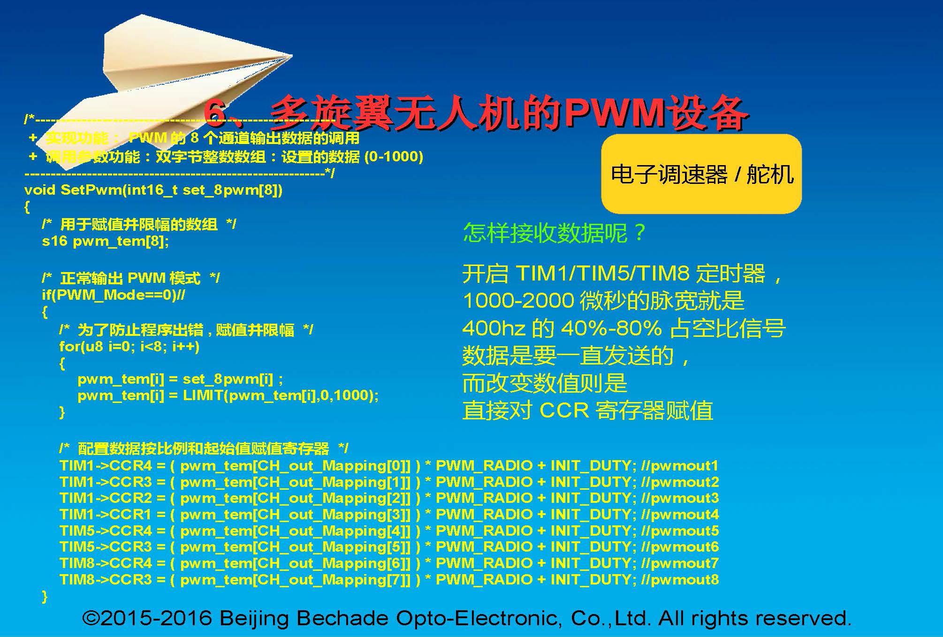
[picture p148: 6. 飞控官方源代码讲解/media/image62.jpeg]
