makermare/UAV-FlyingControlSystem-LightFlightControl/2. 使用说明必看！/media/image79.jpeg

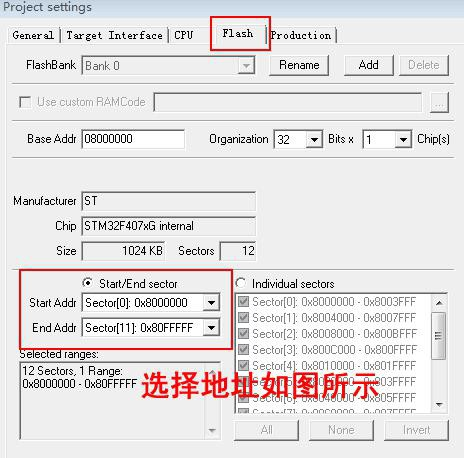
2. 使用说明必看！/media/image79.jpeg
