makermare/UAV-FlyingControlSystem-LightFlightControl/6. 飞控官方源代码讲解/参考目录 (3).png

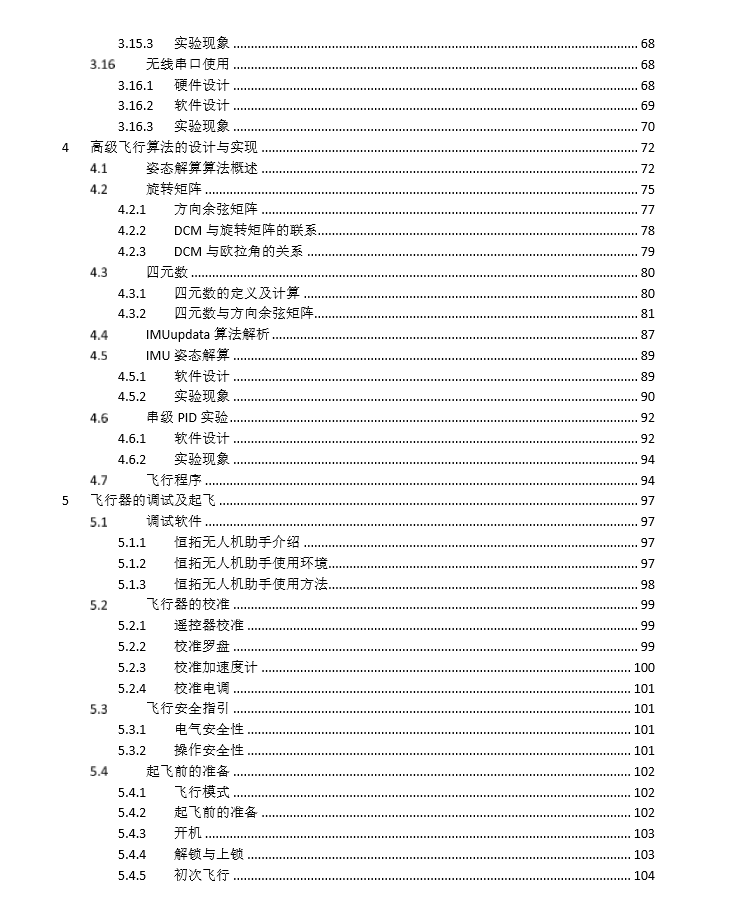
6. 飞控官方源代码讲解/参考目录 (3).png
