makermare/UAV-FlyingControlSystem-LightFlightControl/8. 飞控三方源代码结合OpenMV/LIGHT飞控代码201708-光流定点(OpenMV串级PID)/build/F407_FC.htm

# Static Call Graph for image .\build\F407_FC.axf

#<CALLGRAPH># ARM Linker, 5050169: Last Updated: Wed Dec 13 13:20:43 2017

### Maximum Stack Usage = 504 bytes + Unknown(Cycles, Untraceable Function Pointers)

### Call chain for Maximum Stack Depth:

USBD_EndPoint0 ⇒ USBD_EndPoint0_Out_HID_ReqToIF ⇒ USBD_HID_SetReport ⇒ usbd_hid_set_report ⇒ LIGHT_DT_Data_Receive_Prepare ⇒ LIGHT_DT_Data_Receive_Anl ⇒ Para_ResetToFactorySetup ⇒ Para_WriteSettingToFile ⇒ f_open ⇒ follow_path ⇒ dir_find ⇒ dir_next ⇒ create_chain ⇒ put_fat ⇒ move_window ⇒ sync_window ⇒ disk_write ⇒ Flash_SectorsWrite ⇒ Flash_PageWrite ⇒ Flash_WaitForEnd ⇒ Flash_SendByte ⇒ SPI_I2S_SendData

### Mutually Recursive functions

- HardFault_Handler ⇒ HardFault_Handler
- PendSV_Handler ⇒ PendSV_Handler
- ADC_IRQHandler ⇒ ADC_IRQHandler

### Function Pointers

- ADC_IRQHandler from startup_stm32f4xx.o(.text) referenced from startup_stm32f4xx.o(RESET)
- BusFault_Handler from stm32f4xx_it.o(.text) referenced from startup_stm32f4xx.o(RESET)
- CAN1_RX0_IRQHandler from startup_stm32f4xx.o(.text) referenced from startup_stm32f4xx.o(RESET)
- CAN1_RX1_IRQHandler from startup_stm32f4xx.o(.text) referenced from startup_stm32f4xx.o(RESET)
- CAN1_SCE_IRQHandler from startup_stm32f4xx.o(.text) referenced from startup_stm32f4xx.o(RESET)
- CAN1_TX_IRQHandler from startup_stm32f4xx.o(.text) referenced from startup_stm32f4xx.o(RESET)
- CAN2_RX0_IRQHandler from startup_stm32f4xx.o(.text) referenced from startup_stm32f4xx.o(RESET)
- CAN2_RX1_IRQHandler from startup_stm32f4xx.o(.text) referenced from startup_stm32f4xx.o(RESET)
- CAN2_SCE_IRQHandler from startup_stm32f4xx.o(.text) referenced from startup_stm32f4xx.o(RESET)
- CAN2_TX_IRQHandler from startup_stm32f4xx.o(.text) referenced from startup_stm32f4xx.o(RESET)
- CRYP_IRQHandler from startup_stm32f4xx.o(.text) referenced from startup_stm32f4xx.o(RESET)
- DCMI_IRQHandler from startup_stm32f4xx.o(.text) referenced from startup_stm32f4xx.o(RESET)
- DMA1_Stream0_IRQHandler from startup_stm32f4xx.o(.text) referenced from startup_stm32f4xx.o(RESET)
- DMA1_Stream1_IRQHandler from startup_stm32f4xx.o(.text) referenced from startup_stm32f4xx.o(RESET)
- DMA1_Stream2_IRQHandler from startup_stm32f4xx.o(.text) referenced from startup_stm32f4xx.o(RESET)
- DMA1_Stream3_IRQHandler from startup_stm32f4xx.o(.text) referenced from startup_stm32f4xx.o(RESET)
- DMA1_Stream4_IRQHandler from startup_stm32f4xx.o(.text) referenced from startup_stm32f4xx.o(RESET)
- DMA1_Stream5_IRQHandler from startup_stm32f4xx.o(.text) referenced from startup_stm32f4xx.o(RESET)
- DMA1_Stream6_IRQHandler from startup_stm32f4xx.o(.text) referenced from startup_stm32f4xx.o(RESET)
- DMA1_Stream7_IRQHandler from startup_stm32f4xx.o(.text) referenced from startup_stm32f4xx.o(RESET)
- DMA2_Stream0_IRQHandler from startup_stm32f4xx.o(.text) referenced from startup_stm32f4xx.o(RESET)
- DMA2_Stream1_IRQHandler from startup_stm32f4xx.o(.text) referenced from startup_stm32f4xx.o(RESET)
- DMA2_Stream2_IRQHandler from startup_stm32f4xx.o(.text) referenced from startup_stm32f4xx.o(RESET)
- DMA2_Stream3_IRQHandler from startup_stm32f4xx.o(.text) referenced from startup_stm32f4xx.o(RESET)
- DMA2_Stream4_IRQHandler from startup_stm32f4xx.o(.text) referenced from startup_stm32f4xx.o(RESET)
- DMA2_Stream5_IRQHandler from startup_stm32f4xx.o(.text) referenced from startup_stm32f4xx.o(RESET)
- DMA2_Stream6_IRQHandler from startup_stm32f4xx.o(.text) referenced from startup_stm32f4xx.o(RESET)
- DMA2_Stream7_IRQHandler from startup_stm32f4xx.o(.text) referenced from startup_stm32f4xx.o(RESET)
- DebugMon_Handler from stm32f4xx_it.o(.text) referenced from startup_stm32f4xx.o(RESET)
- ETH_IRQHandler from startup_stm32f4xx.o(.text) referenced from startup_stm32f4xx.o(RESET)
- ETH_WKUP_IRQHandler from startup_stm32f4xx.o(.text) referenced from startup_stm32f4xx.o(RESET)
- EXTI0_IRQHandler from startup_stm32f4xx.o(.text) referenced from startup_stm32f4xx.o(RESET)
- EXTI15_10_IRQHandler from startup_stm32f4xx.o(.text) referenced from startup_stm32f4xx.o(RESET)
- EXTI1_IRQHandler from startup_stm32f4xx.o(.text) referenced from startup_stm32f4xx.o(RESET)
- EXTI2_IRQHandler from startup_stm32f4xx.o(.text) referenced from startup_stm32f4xx.o(RESET)
- EXTI3_IRQHandler from startup_stm32f4xx.o(.text) referenced from startup_stm32f4xx.o(RESET)
- EXTI4_IRQHandler from startup_stm32f4xx.o(.text) referenced from startup_stm32f4xx.o(RESET)
- EXTI9_5_IRQHandler from startup_stm32f4xx.o(.text) referenced from startup_stm32f4xx.o(RESET)
- FLASH_IRQHandler from startup_stm32f4xx.o(.text) referenced from startup_stm32f4xx.o(RESET)
- FPU_IRQHandler from startup_stm32f4xx.o(.text) referenced from startup_stm32f4xx.o(RESET)
- FSMC_IRQHandler from startup_stm32f4xx.o(.text) referenced from startup_stm32f4xx.o(RESET)
- HASH_RNG_IRQHandler from startup_stm32f4xx.o(.text) referenced from startup_stm32f4xx.o(RESET)
- HardFault_Handler from startup_stm32f4xx.o(.text) referenced from startup_stm32f4xx.o(RESET)
- I2C1_ER_IRQHandler from startup_stm32f4xx.o(.text) referenced from startup_stm32f4xx.o(RESET)
- I2C1_EV_IRQHandler from startup_stm32f4xx.o(.text) referenced from startup_stm32f4xx.o(RESET)
- I2C2_ER_IRQHandler from startup_stm32f4xx.o(.text) referenced from startup_stm32f4xx.o(RESET)
- I2C2_EV_IRQHandler from startup_stm32f4xx.o(.text) referenced from startup_stm32f4xx.o(RESET)
- I2C3_ER_IRQHandler from startup_stm32f4xx.o(.text) referenced from startup_stm32f4xx.o(RESET)
- I2C3_EV_IRQHandler from startup_stm32f4xx.o(.text) referenced from startup_stm32f4xx.o(RESET)
- MemManage_Handler from stm32f4xx_it.o(.text) referenced from startup_stm32f4xx.o(RESET)
- NMI_Handler from stm32f4xx_it.o(.text) referenced from startup_stm32f4xx.o(RESET)
- OTG_FS_IRQHandler from usbd_stm32f4xx_fs.o(.text) referenced from startup_stm32f4xx.o(RESET)
- OTG_FS_WKUP_IRQHandler from startup_stm32f4xx.o(.text) referenced from startup_stm32f4xx.o(RESET)
- OTG_HS_EP1_IN_IRQHandler from startup_stm32f4xx.o(.text) referenced from startup_stm32f4xx.o(RESET)
- OTG_HS_EP1_OUT_IRQHandler from startup_stm32f4xx.o(.text) referenced from startup_stm32f4xx.o(RESET)
- OTG_HS_IRQHandler from startup_stm32f4xx.o(.text) referenced from startup_stm32f4xx.o(RESET)
- OTG_HS_WKUP_IRQHandler from startup_stm32f4xx.o(.text) referenced from startup_stm32f4xx.o(RESET)
- PVD_IRQHandler from startup_stm32f4xx.o(.text) referenced from startup_stm32f4xx.o(RESET)
- PendSV_Handler from startup_stm32f4xx.o(.text) referenced from startup_stm32f4xx.o(RESET)
- RCC_IRQHandler from startup_stm32f4xx.o(.text) referenced from startup_stm32f4xx.o(RESET)
- RTC_Alarm_IRQHandler from startup_stm32f4xx.o(.text) referenced from startup_stm32f4xx.o(RESET)
- RTC_WKUP_IRQHandler from startup_stm32f4xx.o(.text) referenced from startup_stm32f4xx.o(RESET)
- Reset_Handler from startup_stm32f4xx.o(.text) referenced from startup_stm32f4xx.o(RESET)
- SDIO_IRQHandler from startup_stm32f4xx.o(.text) referenced from startup_stm32f4xx.o(RESET)
- SPI1_IRQHandler from startup_stm32f4xx.o(.text) referenced from startup_stm32f4xx.o(RESET)
- SPI2_IRQHandler from startup_stm32f4xx.o(.text) referenced from startup_stm32f4xx.o(RESET)
- SPI3_IRQHandler from startup_stm32f4xx.o(.text) referenced from startup_stm32f4xx.o(RESET)
- SVC_Handler from stm32f4xx_it.o(.text) referenced from startup_stm32f4xx.o(RESET)
- SysTick_Handler from stm32f4xx_it.o(.text) referenced from startup_stm32f4xx.o(RESET)
- SystemInit from system_stm32f4xx.o(.text) referenced from startup_stm32f4xx.o(.text)
- TAMP_STAMP_IRQHandler from startup_stm32f4xx.o(.text) referenced from startup_stm32f4xx.o(RESET)
- TIM1_BRK_TIM9_IRQHandler from startup_stm32f4xx.o(.text) referenced from startup_stm32f4xx.o(RESET)
- TIM1_CC_IRQHandler from startup_stm32f4xx.o(.text) referenced from startup_stm32f4xx.o(RESET)
- TIM1_TRG_COM_TIM11_IRQHandler from startup_stm32f4xx.o(.text) referenced from startup_stm32f4xx.o(RESET)
- TIM1_UP_TIM10_IRQHandler from startup_stm32f4xx.o(.text) referenced from startup_stm32f4xx.o(RESET)
- TIM2_IRQHandler from startup_stm32f4xx.o(.text) referenced from startup_stm32f4xx.o(RESET)
- TIM3_IRQHandler from stm32f4xx_it.o(.text) referenced from startup_stm32f4xx.o(RESET)
- TIM4_IRQHandler from stm32f4xx_it.o(.text) referenced from startup_stm32f4xx.o(RESET)
- TIM5_IRQHandler from startup_stm32f4xx.o(.text) referenced from startup_stm32f4xx.o(RESET)
- TIM6_DAC_IRQHandler from startup_stm32f4xx.o(.text) referenced from startup_stm32f4xx.o(RESET)
- TIM7_IRQHandler from startup_stm32f4xx.o(.text) referenced from startup_stm32f4xx.o(RESET)
- TIM8_BRK_TIM12_IRQHandler from startup_stm32f4xx.o(.text) referenced from startup_stm32f4xx.o(RESET)
- TIM8_CC_IRQHandler from startup_stm32f4xx.o(.text) referenced from startup_stm32f4xx.o(RESET)
- TIM8_TRG_COM_TIM14_IRQHandler from startup_stm32f4xx.o(.text) referenced from startup_stm32f4xx.o(RESET)
- TIM8_UP_TIM13_IRQHandler from startup_stm32f4xx.o(.text) referenced from startup_stm32f4xx.o(RESET)
- UART4_IRQHandler from startup_stm32f4xx.o(.text) referenced from startup_stm32f4xx.o(RESET)
- UART5_IRQHandler from stm32f4xx_it.o(.text) referenced from startup_stm32f4xx.o(RESET)
- USART1_IRQHandler from usart.o(.text) referenced from startup_stm32f4xx.o(RESET)
- USART2_IRQHandler from stm32f4xx_it.o(.text) referenced from startup_stm32f4xx.o(RESET)
- USART3_IRQHandler from startup_stm32f4xx.o(.text) referenced from startup_stm32f4xx.o(RESET)
- USART6_IRQHandler from startup_stm32f4xx.o(.text) referenced from startup_stm32f4xx.o(RESET)
- USBD_Configure_Event from usb_config.o(.text) referenced from usb_config.o(.constdata)
- USBD_EndPoint0 from usbd_core.o(.text) referenced from usb_config.o(.constdata)
- USBD_HID_EP_INT_Event from usbd_hid.o(.text) referenced from usb_config.o(.constdata)
- USBD_SOF_Event from usb_config.o(.text) referenced from usb_config.o(.constdata)
- UsageFault_Handler from stm32f4xx_it.o(.text) referenced from startup_stm32f4xx.o(RESET)
- WWDG_IRQHandler from startup_stm32f4xx.o(.text) referenced from startup_stm32f4xx.o(RESET)
- __main from entry.o(.ARM.Collect$$$$00000000) referenced from startup_stm32f4xx.o(.text)
- main from main.o(.text) referenced from entry9a.o(.ARM.Collect$$$$0000000B)

### Global Symbols

__main (Thumb, 0 bytes, Stack size unknown bytes, entry.o(.ARM.Collect$$$$00000000))
[Address Reference Count : 1]

- startup_stm32f4xx.o(.text)

_main_stk (Thumb, 0 bytes, Stack size unknown bytes, entry2.o(.ARM.Collect$$$$00000001))

_main_scatterload (Thumb, 0 bytes, Stack size unknown bytes, entry5.o(.ARM.Collect$$$$00000004))

[Calls]

- >> __scatterload

__main_after_scatterload (Thumb, 0 bytes, Stack size unknown bytes, entry5.o(.ARM.Collect$$$$00000004))

[Called By]

- >> __scatterload

_main_clock (Thumb, 0 bytes, Stack size unknown bytes, entry7b.o(.ARM.Collect$$$$00000008))

_main_cpp_init (Thumb, 0 bytes, Stack size unknown bytes, entry8b.o(.ARM.Collect$$$$0000000A))

_main_init (Thumb, 0 bytes, Stack size unknown bytes, entry9a.o(.ARM.Collect$$$$0000000B))

__rt_final_cpp (Thumb, 0 bytes, Stack size unknown bytes, entry10a.o(.ARM.Collect$$$$0000000D))

__rt_final_exit (Thumb, 0 bytes, Stack size unknown bytes, entry11a.o(.ARM.Collect$$$$0000000F))

assert_failed (Thumb, 4 bytes, Stack size 0 bytes, main.o(.text))

[Called By]

- >> NVIC_PriorityGroupConfig
- >> NVIC_SystemLPConfig
- >> NVIC_SetVectorTable
- >> SPI_Init
- >> SPI_I2S_SendData
- >> SPI_I2S_ReceiveData
- >> SPI_I2S_GetFlagStatus
- >> SPI_I2S_DeInit
- >> SPI_Cmd
- >> GPIO_WriteBit
- >> USART_ReceiveData
- >> USART_Init
- >> USART_ITConfig
- >> USART_GetITStatus
- >> USART_Cmd
- >> USART_ClockInit
- >> USART_ClearITPendingBit
- >> GPIO_SetBits
- >> TIM_OC4PreloadConfig
- >> TIM_OC4Init
- >> TIM_OC3PreloadConfig
- >> TIM_OC3Init
- >> TIM_OC2Init
- >> TIM_OC1Init
- >> TIM_CtrlPWMOutputs
- >> TIM_ARRPreloadConfig
- >> RCC_APB2PeriphClockCmd
- >> TIM_ICInit
- >> TIM_GetCapture4
- >> TIM_GetCapture3
- >> TIM_GetCapture2
- >> TIM_GetCapture1
- >> RCC_AHB1PeriphClockCmd
- >> GPIO_PinAFConfig
- >> GPIO_Init
- >> TIM_TimeBaseInit
- >> TIM_ITConfig
- >> TIM_DeInit
- >> TIM_Cmd
- >> TIM_ClearFlag
- >> SysTick_CLKSourceConfig
- >> RCC_APB1PeriphClockCmd
- >> NVIC_Init
- >> USART_ClearFlag
- >> USART_GetFlagStatus
- >> USART_DMACmd
- >> USART_IrDACmd
- >> USART_IrDAConfig
- >> USART_SmartCardNACKCmd
- >> USART_SmartCardCmd
- >> USART_SetGuardTime
- >> USART_HalfDuplexCmd
- >> USART_SendBreak
- >> USART_LINCmd
- >> USART_LINBreakDetectLengthConfig
- >> USART_WakeUpConfig
- >> USART_ReceiverWakeUpCmd
- >> USART_SetAddress
- >> USART_SendData
- >> USART_OneBitMethodCmd
- >> USART_OverSampling8Cmd
- >> USART_SetPrescaler
- >> USART_DeInit
- >> TIM_RemapConfig
- >> TIM_SelectHallSensor
- >> TIM_EncoderInterfaceConfig
- >> TIM_SelectMasterSlaveMode
- >> TIM_SelectSlaveMode
- >> TIM_SelectOutputTrigger
- >> TIM_ETRClockMode2Config
- >> TIM_ETRClockMode1Config
- >> TIM_ETRConfig
- >> TIM_TIxExternalClockConfig
- >> TIM_ITRxExternalClockConfig
- >> TIM_SelectInputTrigger
- >> TIM_InternalClockConfig
- >> TIM_SelectCCDMA
- >> TIM_DMACmd
- >> TIM_DMAConfig
- >> TIM_ClearITPendingBit
- >> TIM_GetITStatus
- >> TIM_GetFlagStatus
- >> TIM_GenerateEvent
- >> TIM_CCPreloadControl
- >> TIM_SelectCOM
- >> TIM_BDTRConfig
- >> TIM_PWMIConfig
- >> TIM_SetIC1Prescaler
- >> TIM_SetIC2Prescaler
- >> TIM_SetIC3Prescaler
- >> TIM_SetIC4Prescaler
- >> TIM_CCxNCmd
- >> TIM_CCxCmd
- >> TIM_OC4PolarityConfig
- >> TIM_OC3NPolarityConfig
- >> TIM_OC3PolarityConfig
- >> TIM_OC2NPolarityConfig
- >> TIM_OC2PolarityConfig
- >> TIM_OC1NPolarityConfig
- >> TIM_OC1PolarityConfig
- >> TIM_ClearOC4Ref
- >> TIM_ClearOC3Ref
- >> TIM_ClearOC2Ref
- >> TIM_ClearOC1Ref
- >> TIM_OC4FastConfig
- >> TIM_OC3FastConfig
- >> TIM_OC2FastConfig
- >> TIM_OC1FastConfig
- >> TIM_OC2PreloadConfig
- >> TIM_OC1PreloadConfig
- >> TIM_ForcedOC4Config
- >> TIM_ForcedOC3Config
- >> TIM_ForcedOC2Config
- >> TIM_ForcedOC1Config
- >> TIM_SetCompare4
- >> TIM_SetCompare3
- >> TIM_SetCompare2
- >> TIM_SetCompare1
- >> TIM_SelectOCxM
- >> TIM_SetClockDivision
- >> TIM_SelectOnePulseMode
- >> TIM_UpdateRequestConfig
- >> TIM_UpdateDisableConfig
- >> TIM_GetPrescaler
- >> TIM_GetCounter
- >> TIM_SetAutoreload
- >> TIM_SetCounter
- >> TIM_CounterModeConfig
- >> TIM_PrescalerConfig
- >> SPI_I2S_ClearITPendingBit
- >> SPI_I2S_GetITStatus
- >> SPI_I2S_ClearFlag
- >> SPI_I2S_ITConfig
- >> SPI_I2S_DMACmd
- >> SPI_GetCRCPolynomial
- >> SPI_GetCRC
- >> SPI_TransmitCRC
- >> SPI_CalculateCRC
- >> I2S_FullDuplexConfig
- >> SPI_TIModeCmd
- >> SPI_SSOutputCmd
- >> SPI_NSSInternalSoftwareConfig
- >> SPI_BiDirectionalLineConfig
- >> SPI_DataSizeConfig
- >> I2S_Cmd
- >> I2S_Init
- >> RCC_ClearITPendingBit
- >> RCC_GetITStatus
- >> RCC_ITConfig
- >> RCC_APB2PeriphClockLPModeCmd
- >> RCC_APB1PeriphClockLPModeCmd
- >> RCC_AHB3PeriphClockLPModeCmd
- >> RCC_AHB2PeriphClockLPModeCmd
- >> RCC_AHB1PeriphClockLPModeCmd
- >> RCC_AHB3PeriphResetCmd
- >> RCC_AHB2PeriphResetCmd
- >> RCC_AHB3PeriphClockCmd
- >> RCC_AHB2PeriphClockCmd
- >> RCC_I2SCLKConfig
- >> RCC_BackupResetCmd
- >> RCC_RTCCLKCmd
- >> RCC_RTCCLKConfig
- >> RCC_PCLK2Config
- >> RCC_PCLK1Config
- >> RCC_HCLKConfig
- >> RCC_SYSCLKConfig
- >> RCC_MCO2Config
- >> RCC_MCO1Config
- >> RCC_ClockSecuritySystemCmd
- >> RCC_PLLI2SCmd
- >> RCC_PLLI2SConfig
- >> RCC_PLLCmd
- >> RCC_PLLConfig
- >> RCC_LSICmd
- >> RCC_LSEConfig
- >> RCC_HSICmd
- >> RCC_AdjustHSICalibrationValue
- >> RCC_GetFlagStatus
- >> RCC_HSEConfig
- >> RCC_APB1PeriphResetCmd
- >> RCC_AHB1PeriphResetCmd
- >> GPIO_ToggleBits
- >> GPIO_Write
- >> GPIO_ResetBits
- >> GPIO_ReadOutputData
- >> GPIO_ReadOutputDataBit
- >> GPIO_ReadInputData
- >> GPIO_ReadInputDataBit
- >> GPIO_PinLockConfig
- >> GPIO_DeInit
- >> RCC_APB2PeriphResetCmd

main (Thumb, 16 bytes, Stack size 0 bytes, main.o(.text))

[Stack]

- Max Depth = 480
- Call Chain = main ⇒ Duty_Loop ⇒ Duty_2ms ⇒ MPU6050_Data_Prepare ⇒ MPU6050_Data_Offset ⇒ Param_SaveGyroOffset ⇒ Para_WriteSettingToFile ⇒ f_open ⇒ follow_path ⇒ dir_find ⇒ dir_next ⇒ create_chain ⇒ put_fat ⇒ move_window ⇒ sync_window ⇒ disk_write ⇒ Flash_SectorsWrite ⇒ Flash_PageWrite ⇒ Flash_WaitForEnd ⇒ Flash_SendByte ⇒ SPI_I2S_SendData

[Calls]

- >> Duty_Loop
- >> All_Init

[Address Reference Count : 1]

- entry9a.o(.ARM.Collect$$$$0000000B)

NMI_Handler (Thumb, 2 bytes, Stack size 0 bytes, stm32f4xx_it.o(.text))
[Address Reference Count : 1]

- startup_stm32f4xx.o(RESET)

MemManage_Handler (Thumb, 4 bytes, Stack size 0 bytes, stm32f4xx_it.o(.text))
[Address Reference Count : 1]

- startup_stm32f4xx.o(RESET)

BusFault_Handler (Thumb, 4 bytes, Stack size 0 bytes, stm32f4xx_it.o(.text))
[Address Reference Count : 1]

- startup_stm32f4xx.o(RESET)

UsageFault_Handler (Thumb, 4 bytes, Stack size 0 bytes, stm32f4xx_it.o(.text))
[Address Reference Count : 1]

- startup_stm32f4xx.o(RESET)

SVC_Handler (Thumb, 2 bytes, Stack size 0 bytes, stm32f4xx_it.o(.text))
[Address Reference Count : 1]

- startup_stm32f4xx.o(RESET)

DebugMon_Handler (Thumb, 2 bytes, Stack size 0 bytes, stm32f4xx_it.o(.text))
[Address Reference Count : 1]

- startup_stm32f4xx.o(RESET)

SysTick_Handler (Thumb, 18 bytes, Stack size 8 bytes, stm32f4xx_it.o(.text))

[Stack]

- Max Depth = 24
- Call Chain = SysTick_Handler ⇒ sys_time ⇒ Loop_check

[Calls]

- >> sys_time

[Address Reference Count : 1]

- startup_stm32f4xx.o(RESET)

TIM3_IRQHandler (Thumb, 8 bytes, Stack size 8 bytes, stm32f4xx_it.o(.text))

[Stack]

- Max Depth = 24
- Call Chain = TIM3_IRQHandler ⇒ _TIM3_IRQHandler ⇒ TIM_GetCapture4

[Calls]

- >> _TIM3_IRQHandler

[Address Reference Count : 1]

- startup_stm32f4xx.o(RESET)

TIM4_IRQHandler (Thumb, 8 bytes, Stack size 8 bytes, stm32f4xx_it.o(.text))

[Stack]

- Max Depth = 24
- Call Chain = TIM4_IRQHandler ⇒ _TIM4_IRQHandler ⇒ TIM_GetCapture4

[Calls]

- >> _TIM4_IRQHandler

[Address Reference Count : 1]

- startup_stm32f4xx.o(RESET)

USART2_IRQHandler (Thumb, 8 bytes, Stack size 8 bytes, stm32f4xx_it.o(.text))

[Stack]

- Max Depth = 456
- Call Chain = USART2_IRQHandler ⇒ Usart2_IRQ ⇒ LIGHT_DT_Data_Receive_Prepare ⇒ LIGHT_DT_Data_Receive_Anl ⇒ Para_ResetToFactorySetup ⇒ Para_WriteSettingToFile ⇒ f_open ⇒ follow_path ⇒ dir_find ⇒ dir_next ⇒ create_chain ⇒ put_fat ⇒ move_window ⇒ sync_window ⇒ disk_write ⇒ Flash_SectorsWrite ⇒ Flash_PageWrite ⇒ Flash_WaitForEnd ⇒ Flash_SendByte ⇒ SPI_I2S_SendData

[Calls]

- >> Usart2_IRQ

[Address Reference Count : 1]

- startup_stm32f4xx.o(RESET)

UART5_IRQHandler (Thumb, 8 bytes, Stack size 8 bytes, stm32f4xx_it.o(.text))

[Stack]

- Max Depth = 48
- Call Chain = UART5_IRQHandler ⇒ Uart5_IRQ ⇒ USART_GetITStatus

[Calls]

- >> Uart5_IRQ

[Address Reference Count : 1]

- startup_stm32f4xx.o(RESET)

Loop_check (Thumb, 92 bytes, Stack size 8 bytes, scheduler.o(.text))

[Stack]

- Max Depth = 8
- Call Chain = Loop_check

[Calls]

- >> LED_1ms_DRV

[Called By]

- >> sys_time

Duty_1ms (Thumb, 14 bytes, Stack size 8 bytes, scheduler.o(.text))

[Stack]

- Max Depth = 168
- Call Chain = Duty_1ms ⇒ LIGHT_DT_Data_Exchange ⇒ LIGHT_DT_Send_PID ⇒ LIGHT_DT_Send_Data ⇒ Usart2_Send ⇒ USART_ITConfig

[Calls]

- >> LIGHT_DT_Data_Exchange
- >> Get_Cycle_T

[Called By]

- >> Duty_Loop

Duty_2ms (Thumb, 192 bytes, Stack size 16 bytes, scheduler.o(.text))

[Stack]

- Max Depth = 472
- Call Chain = Duty_2ms ⇒ MPU6050_Data_Prepare ⇒ MPU6050_Data_Offset ⇒ Param_SaveGyroOffset ⇒ Para_WriteSettingToFile ⇒ f_open ⇒ follow_path ⇒ dir_find ⇒ dir_next ⇒ create_chain ⇒ put_fat ⇒ move_window ⇒ sync_window ⇒ disk_write ⇒ Flash_SectorsWrite ⇒ Flash_PageWrite ⇒ Flash_WaitForEnd ⇒ Flash_SendByte ⇒ SPI_I2S_SendData

[Calls]

- >> RC_Duty
- >> MPU6050_Read
- >> MPU6050_Data_Prepare
- >> IMUupdate
- >> Get_Cycle_T
- >> GetSysTime_us
- >> CTRL_1

[Called By]

- >> Duty_Loop

Duty_5ms (Thumb, 98 bytes, Stack size 16 bytes, scheduler.o(.text))

[Stack]

- Max Depth = 168
- Call Chain = Duty_5ms ⇒ CTRL_2 ⇒ __aeabi_dmul ⇒ _double_epilogue ⇒ _double_round

[Calls]

- >> Get_Cycle_T
- >> GetSysTime_us
- >> CTRL_2

[Called By]

- >> Duty_Loop

Duty_10ms (Thumb, 8 bytes, Stack size 8 bytes, scheduler.o(.text))

[Stack]

- Max Depth = 440
- Call Chain = Duty_10ms ⇒ LIGHT_AK8975_Read ⇒ LIGHT_AK8975_Read_Mag_Data ⇒ LIGHT_AK8975_CalOffset_Mag ⇒ Param_SaveMagOffset ⇒ Para_WriteSettingToFile ⇒ f_open ⇒ follow_path ⇒ dir_find ⇒ dir_next ⇒ create_chain ⇒ put_fat ⇒ move_window ⇒ sync_window ⇒ disk_write ⇒ Flash_SectorsWrite ⇒ Flash_PageWrite ⇒ Flash_WaitForEnd ⇒ Flash_SendByte ⇒ SPI_I2S_SendData

[Calls]

- >> LIGHT_AK8975_Read

[Called By]

- >> Duty_Loop

Duty_20ms (Thumb, 8 bytes, Stack size 8 bytes, scheduler.o(.text))

[Stack]

- Max Depth = 408
- Call Chain = Duty_20ms ⇒ Parameter_Save ⇒ Param_SavePID ⇒ Para_WriteSettingToFile ⇒ f_open ⇒ follow_path ⇒ dir_find ⇒ dir_next ⇒ create_chain ⇒ put_fat ⇒ move_window ⇒ sync_window ⇒ disk_write ⇒ Flash_SectorsWrite ⇒ Flash_PageWrite ⇒ Flash_WaitForEnd ⇒ Flash_SendByte ⇒ SPI_I2S_SendData

[Calls]

- >> Parameter_Save

[Called By]

- >> Duty_Loop

Track_Line (Thumb, 406 bytes, Stack size 24 bytes, scheduler.o(.text))

[Stack]

- Max Depth = 112
- Call Chain = Track_Line ⇒ __aeabi_dsub ⇒ __aeabi_dadd ⇒ _double_epilogue ⇒ _double_round

[Calls]

- >> __aeabi_f2d
- >> __aeabi_dsub
- >> __aeabi_d2f

[Called By]

- >> Duty_50ms

Duty_50ms (Thumb, 24 bytes, Stack size 8 bytes, scheduler.o(.text))

[Stack]

- Max Depth = 120
- Call Chain = Duty_50ms ⇒ Track_Line ⇒ __aeabi_dsub ⇒ __aeabi_dadd ⇒ _double_epilogue ⇒ _double_round

[Calls]

- >> mode_check
- >> Ultra_Duty
- >> LED_Duty
- >> Track_Line

[Called By]

- >> Duty_Loop

Duty_Loop (Thumb, 132 bytes, Stack size 8 bytes, scheduler.o(.text))

[Stack]

- Max Depth = 480
- Call Chain = Duty_Loop ⇒ Duty_2ms ⇒ MPU6050_Data_Prepare ⇒ MPU6050_Data_Offset ⇒ Param_SaveGyroOffset ⇒ Para_WriteSettingToFile ⇒ f_open ⇒ follow_path ⇒ dir_find ⇒ dir_next ⇒ create_chain ⇒ put_fat ⇒ move_window ⇒ sync_window ⇒ disk_write ⇒ Flash_SectorsWrite ⇒ Flash_PageWrite ⇒ Flash_WaitForEnd ⇒ Flash_SendByte ⇒ SPI_I2S_SendData

[Calls]

- >> Duty_50ms
- >> Duty_20ms
- >> Duty_10ms
- >> Duty_5ms
- >> Duty_2ms
- >> Duty_1ms

[Called By]

- >> main

All_Init (Thumb, 146 bytes, Stack size 8 bytes, init.o(.text))

[Stack]

- Max Depth = 408
- Call Chain = All_Init ⇒ Para_Init ⇒ Para_ResetToFactorySetup ⇒ Para_WriteSettingToFile ⇒ f_open ⇒ follow_path ⇒ dir_find ⇒ dir_next ⇒ create_chain ⇒ put_fat ⇒ move_window ⇒ sync_window ⇒ disk_write ⇒ Flash_SectorsWrite ⇒ Flash_PageWrite ⇒ Flash_WaitForEnd ⇒ Flash_SendByte ⇒ SPI_I2S_SendData

[Calls]

- >> aircraft_mode_led
- >> Usb_Hid_Init
- >> Usart2_Init
- >> Usart1_Init
- >> Ultrasonic_Init
- >> SysTick_Configuration
- >> Para_Init
- >> PWM_Out_Init
- >> PWM_IN_Init
- >> NVIC_PriorityGroupConfig
- >> MS5611_Init
- >> MPU6050_Init
- >> LIGHT_AK8975_Run
- >> LED_Mag_Err
- >> LED_MS5611_Err
- >> LED_MPU_Err
- >> LED_Init
- >> I2c_Soft_Init
- >> Delay_ms
- >> Cycle_Time_Init

[Called By]

- >> main

PID_Para_Init (Thumb, 12 bytes, Stack size 8 bytes, parameter.o(.text))

[Stack]

- Max Depth = 8
- Call Chain = PID_Para_Init

[Calls]

- >> h_pid_init
- >> Ctrl_Para_Init

[Called By]

- >> LIGHT_DT_Data_Receive_Anl
- >> Para_ResetToFactorySetup
- >> Para_Init

Para_ResetToFactorySetup (Thumb, 392 bytes, Stack size 8 bytes, parameter.o(.text))

[Stack]

- Max Depth = 392
- Call Chain = Para_ResetToFactorySetup ⇒ Para_WriteSettingToFile ⇒ f_open ⇒ follow_path ⇒ dir_find ⇒ dir_next ⇒ create_chain ⇒ put_fat ⇒ move_window ⇒ sync_window ⇒ disk_write ⇒ Flash_SectorsWrite ⇒ Flash_PageWrite ⇒ Flash_WaitForEnd ⇒ Flash_SendByte ⇒ SPI_I2S_SendData

[Calls]

- >> f_mkfs
- >> PID_Para_Init
- >> Param_SetSettingToFC
- >> Para_WriteSettingToFile

[Called By]

- >> LIGHT_DT_Data_Receive_Anl
- >> Para_Init

Para_Init (Thumb, 32 bytes, Stack size 8 bytes, parameter.o(.text))

[Stack]

- Max Depth = 400
- Call Chain = Para_Init ⇒ Para_ResetToFactorySetup ⇒ Para_WriteSettingToFile ⇒ f_open ⇒ follow_path ⇒ dir_find ⇒ dir_next ⇒ create_chain ⇒ put_fat ⇒ move_window ⇒ sync_window ⇒ disk_write ⇒ Flash_SectorsWrite ⇒ Flash_PageWrite ⇒ Flash_WaitForEnd ⇒ Flash_SendByte ⇒ SPI_I2S_SendData

[Calls]

- >> Para_ResetToFactorySetup
- >> PID_Para_Init
- >> Param_SetSettingToFC
- >> Para_ReadSettingFromFile

[Called By]

- >> All_Init

Param_SaveAccelOffset (Thumb, 40 bytes, Stack size 8 bytes, parameter.o(.text))

[Stack]

- Max Depth = 392
- Call Chain = Param_SaveAccelOffset ⇒ Para_WriteSettingToFile ⇒ f_open ⇒ follow_path ⇒ dir_find ⇒ dir_next ⇒ create_chain ⇒ put_fat ⇒ move_window ⇒ sync_window ⇒ disk_write ⇒ Flash_SectorsWrite ⇒ Flash_PageWrite ⇒ Flash_WaitForEnd ⇒ Flash_SendByte ⇒ SPI_I2S_SendData

[Calls]

- >> Para_WriteSettingToFile

[Called By]

- >> MPU6050_Data_Offset

Param_SaveGyroOffset (Thumb, 42 bytes, Stack size 8 bytes, parameter.o(.text))

[Stack]

- Max Depth = 392
- Call Chain = Param_SaveGyroOffset ⇒ Para_WriteSettingToFile ⇒ f_open ⇒ follow_path ⇒ dir_find ⇒ dir_next ⇒ create_chain ⇒ put_fat ⇒ move_window ⇒ sync_window ⇒ disk_write ⇒ Flash_SectorsWrite ⇒ Flash_PageWrite ⇒ Flash_WaitForEnd ⇒ Flash_SendByte ⇒ SPI_I2S_SendData

[Calls]

- >> Para_WriteSettingToFile

[Called By]

- >> MPU6050_Data_Offset

Param_SaveMagOffset (Thumb, 30 bytes, Stack size 8 bytes, parameter.o(.text))

[Stack]

- Max Depth = 392
- Call Chain = Param_SaveMagOffset ⇒ Para_WriteSettingToFile ⇒ f_open ⇒ follow_path ⇒ dir_find ⇒ dir_next ⇒ create_chain ⇒ put_fat ⇒ move_window ⇒ sync_window ⇒ disk_write ⇒ Flash_SectorsWrite ⇒ Flash_PageWrite ⇒ Flash_WaitForEnd ⇒ Flash_SendByte ⇒ SPI_I2S_SendData

[Calls]

- >> Para_WriteSettingToFile

[Called By]

- >> LIGHT_AK8975_CalOffset_Mag

Param_Save_3d_offset (Thumb, 30 bytes, Stack size 8 bytes, parameter.o(.text), UNUSED)

[Calls]

- >> Para_WriteSettingToFile

Param_SavePID (Thumb, 124 bytes, Stack size 8 bytes, parameter.o(.text))

[Stack]

- Max Depth = 392
- Call Chain = Param_SavePID ⇒ Para_WriteSettingToFile ⇒ f_open ⇒ follow_path ⇒ dir_find ⇒ dir_next ⇒ create_chain ⇒ put_fat ⇒ move_window ⇒ sync_window ⇒ disk_write ⇒ Flash_SectorsWrite ⇒ Flash_PageWrite ⇒ Flash_WaitForEnd ⇒ Flash_SendByte ⇒ SPI_I2S_SendData

[Calls]

- >> Para_WriteSettingToFile

[Called By]

- >> Parameter_Save

Parameter_Save (Thumb, 44 bytes, Stack size 8 bytes, parameter.o(.text))

[Stack]

- Max Depth = 400
- Call Chain = Parameter_Save ⇒ Param_SavePID ⇒ Para_WriteSettingToFile ⇒ f_open ⇒ follow_path ⇒ dir_find ⇒ dir_next ⇒ create_chain ⇒ put_fat ⇒ move_window ⇒ sync_window ⇒ disk_write ⇒ Flash_SectorsWrite ⇒ Flash_PageWrite ⇒ Flash_WaitForEnd ⇒ Flash_SendByte ⇒ SPI_I2S_SendData

[Calls]

- >> Param_SavePID

[Called By]

- >> Duty_20ms

Ctrl_Para_Init (Thumb, 36 bytes, Stack size 0 bytes, ctrl.o(.text))

[Called By]

- >> PID_Para_Init

CTRL_2 (Thumb, 1578 bytes, Stack size 64 bytes, ctrl.o(.text))

[Stack]

- Max Depth = 152
- Call Chain = CTRL_2 ⇒ __aeabi_dmul ⇒ _double_epilogue ⇒ _double_round

[Calls]

- >> my_deathzoom_2
- >> my_deathzoom
- >> __aeabi_dmul
- >> __aeabi_dadd
- >> To_180_degrees
- >> __aeabi_f2d
- >> __aeabi_d2f

[Called By]

- >> Duty_5ms

All_Out (Thumb, 606 bytes, Stack size 40 bytes, ctrl.o(.text))

[Stack]

- Max Depth = 60
- Call Chain = All_Out ⇒ SetPwm

[Calls]

- >> SetPwm

[Called By]

- >> CTRL_1

Thr_Ctrl (Thumb, 448 bytes, Stack size 16 bytes, ctrl.o(.text))

[Stack]

- Max Depth = 184
- Call Chain = Thr_Ctrl ⇒ Height_Ctrl ⇒ baro_ctrl ⇒ MS5611_Update ⇒ MS5611_BaroAltCalculate ⇒ Moving_Median

[Calls]

- >> Height_Ctrl

[Called By]

- >> CTRL_1

CTRL_1 (Thumb, 1870 bytes, Stack size 24 bytes, ctrl.o(.text))

[Stack]

- Max Depth = 208
- Call Chain = CTRL_1 ⇒ Thr_Ctrl ⇒ Height_Ctrl ⇒ baro_ctrl ⇒ MS5611_Update ⇒ MS5611_BaroAltCalculate ⇒ Moving_Median

[Calls]

- >> Thr_Ctrl
- >> All_Out

[Called By]

- >> Duty_2ms

IMUupdate (Thumb, 2594 bytes, Stack size 80 bytes, imu.o(.text))

[Stack]

- Max Depth = 280
- Call Chain = IMUupdate ⇒ __hardfp_asin ⇒ __kernel_poly ⇒ __aeabi_dmul ⇒ _double_epilogue ⇒ _double_round

[Calls]

- >> simple_3d_trans
- >> my_sqrt
- >> fast_atan2
- >> __aeabi_dmul
- >> To_180_degrees
- >> __aeabi_f2d
- >> __aeabi_d2f
- >> __hardfp_asin

[Called By]

- >> Duty_2ms

my_abs (Thumb, 26 bytes, Stack size 0 bytes, mymath.o(.text))

[Called By]

- >> fast_atan2

fast_atan2 (Thumb, 350 bytes, Stack size 4 bytes, mymath.o(.text))

[Stack]

- Max Depth = 4
- Call Chain = fast_atan2

[Calls]

- >> my_abs

[Called By]

- >> my_atan
- >> IMUupdate

my_atan (Thumb, 24 bytes, Stack size 4 bytes, mymath.o(.text), UNUSED)

[Calls]

- >> fast_atan2

my_sqrt (Thumb, 88 bytes, Stack size 0 bytes, mymath.o(.text))

[Called By]

- >> simple_3d_trans
- >> IMUupdate
- >> MPU6050_Data_Offset
- >> baro_compensate

mx_sin (Thumb, 292 bytes, Stack size 48 bytes, mymath.o(.text), UNUSED)

[Calls]

- >> __aeabi_drsub
- >> __aeabi_cdcmple
- >> __aeabi_dmul
- >> __aeabi_dadd
- >> __aeabi_dsub

[Called By]

- >> my_sin

my_sin (Thumb, 108 bytes, Stack size 32 bytes, mymath.o(.text), UNUSED)

[Calls]

- >> __aeabi_i2d
- >> __aeabi_cdrcmple
- >> mx_sin
- >> __aeabi_dmul
- >> __aeabi_dsub

[Called By]

- >> my_cos

my_cos (Thumb, 136 bytes, Stack size 40 bytes, mymath.o(.text), UNUSED)

[Calls]

- >> __aeabi_i2d
- >> __aeabi_cdrcmple
- >> my_sin
- >> __aeabi_dmul
- >> __aeabi_dadd
- >> __aeabi_dsub
- >> __aeabi_d2f

my_deadzone_p (Thumb, 142 bytes, Stack size 0 bytes, mymath.o(.text), UNUSED)

my_deadzone_n (Thumb, 44 bytes, Stack size 0 bytes, mymath.o(.text), UNUSED)

my_deathzoom (Thumb, 54 bytes, Stack size 0 bytes, mymath.o(.text))

[Called By]

- >> Height_Ctrl
- >> CTRL_2
- >> acc_fusion
- >> fusion_prepare
- >> baro_ctrl

my_deathzoom_2 (Thumb, 48 bytes, Stack size 0 bytes, mymath.o(.text))

[Called By]

- >> Height_Ctrl
- >> CTRL_2

To_180_degrees_db (Thumb, 108 bytes, Stack size 16 bytes, mymath.o(.text), UNUSED)

[Calls]

- >> __aeabi_cdrcmple
- >> __aeabi_cdcmple
- >> __aeabi_dadd
- >> __aeabi_dsub

To_180_degrees (Thumb, 58 bytes, Stack size 0 bytes, mymath.o(.text))

[Called By]

- >> IMUupdate
- >> CTRL_2

linear_interpolation_5 (Thumb, 310 bytes, Stack size 0 bytes, mymath.o(.text), UNUSED)

LIGHT_DT_Send_Data (Thumb, 24 bytes, Stack size 16 bytes, data_transfer.o(.text))

[Stack]

- Max Depth = 64
- Call Chain = LIGHT_DT_Send_Data ⇒ Usart2_Send ⇒ USART_ITConfig

[Calls]

- >> Usb_Hid_Adddata
- >> Usart2_Send

[Called By]

- >> LIGHT_DT_Send_Version
- >> LIGHT_DT_Send_Status
- >> LIGHT_DT_Send_Speed
- >> LIGHT_DT_Send_User
- >> LIGHT_DT_Send_Senser
- >> LIGHT_DT_Send_Senser2
- >> LIGHT_DT_Send_RCData
- >> LIGHT_DT_Send_MotoPWM
- >> LIGHT_DT_Send_Power
- >> LIGHT_DT_Send_PID
- >> LIGHT_DT_Send_Location
- >> LIGHT_DT_Send_Msg
- >> LIGHT_DT_Send_Check

LIGHT_DT_Send_Location (Thumb, 290 bytes, Stack size 48 bytes, data_transfer.o(.text))

[Stack]

- Max Depth = 112
- Call Chain = LIGHT_DT_Send_Location ⇒ LIGHT_DT_Send_Data ⇒ Usart2_Send ⇒ USART_ITConfig

[Calls]

- >> LIGHT_DT_Send_Data

[Called By]

- >> LIGHT_DT_Data_Exchange

LIGHT_DT_Send_PID (Thumb, 574 bytes, Stack size 64 bytes, data_transfer.o(.text))

[Stack]

- Max Depth = 128
- Call Chain = LIGHT_DT_Send_PID ⇒ LIGHT_DT_Send_Data ⇒ Usart2_Send ⇒ USART_ITConfig

[Calls]

- >> LIGHT_DT_Send_Data

[Called By]

- >> LIGHT_DT_Data_Exchange

LIGHT_DT_Send_Power (Thumb, 136 bytes, Stack size 24 bytes, data_transfer.o(.text))

[Stack]

- Max Depth = 88
- Call Chain = LIGHT_DT_Send_Power ⇒ LIGHT_DT_Send_Data ⇒ Usart2_Send ⇒ USART_ITConfig

[Calls]

- >> LIGHT_DT_Send_Data

[Called By]

- >> LIGHT_DT_Data_Exchange

LIGHT_DT_Send_MotoPWM (Thumb, 294 bytes, Stack size 32 bytes, data_transfer.o(.text))

[Stack]

- Max Depth = 96
- Call Chain = LIGHT_DT_Send_MotoPWM ⇒ LIGHT_DT_Send_Data ⇒ Usart2_Send ⇒ USART_ITConfig

[Calls]

- >> LIGHT_DT_Send_Data

[Called By]

- >> LIGHT_DT_Data_Exchange

LIGHT_DT_Send_RCData (Thumb, 350 bytes, Stack size 32 bytes, data_transfer.o(.text))

[Stack]

- Max Depth = 96
- Call Chain = LIGHT_DT_Send_RCData ⇒ LIGHT_DT_Send_Data ⇒ Usart2_Send ⇒ USART_ITConfig

[Calls]

- >> LIGHT_DT_Send_Data

[Called By]

- >> LIGHT_DT_Data_Exchange

LIGHT_DT_Send_Senser2 (Thumb, 154 bytes, Stack size 24 bytes, data_transfer.o(.text))

[Stack]

- Max Depth = 88
- Call Chain = LIGHT_DT_Send_Senser2 ⇒ LIGHT_DT_Send_Data ⇒ Usart2_Send ⇒ USART_ITConfig

[Calls]

- >> LIGHT_DT_Send_Data

[Called By]

- >> LIGHT_DT_Data_Exchange

LIGHT_DT_Send_Senser (Thumb, 412 bytes, Stack size 40 bytes, data_transfer.o(.text))

[Stack]

- Max Depth = 104
- Call Chain = LIGHT_DT_Send_Senser ⇒ LIGHT_DT_Send_Data ⇒ Usart2_Send ⇒ USART_ITConfig

[Calls]

- >> LIGHT_DT_Send_Data

[Called By]

- >> LIGHT_DT_Data_Exchange

LIGHT_DT_Send_User (Thumb, 400 bytes, Stack size 16 bytes, data_transfer.o(.text))

[Stack]

- Max Depth = 80
- Call Chain = LIGHT_DT_Send_User ⇒ LIGHT_DT_Send_Data ⇒ Usart2_Send ⇒ USART_ITConfig

[Calls]

- >> LIGHT_DT_Send_Data

[Called By]

- >> LIGHT_DT_Data_Exchange

LIGHT_DT_Send_Speed (Thumb, 242 bytes, Stack size 32 bytes, data_transfer.o(.text))

[Stack]

- Max Depth = 96
- Call Chain = LIGHT_DT_Send_Speed ⇒ LIGHT_DT_Send_Data ⇒ Usart2_Send ⇒ USART_ITConfig

[Calls]

- >> LIGHT_DT_Send_Data

[Called By]

- >> LIGHT_DT_Data_Exchange

LIGHT_DT_Send_Status (Thumb, 376 bytes, Stack size 48 bytes, data_transfer.o(.text))

[Stack]

- Max Depth = 112
- Call Chain = LIGHT_DT_Send_Status ⇒ LIGHT_DT_Send_Data ⇒ Usart2_Send ⇒ USART_ITConfig

[Calls]

- >> LIGHT_DT_Send_Data

[Called By]

- >> LIGHT_DT_Data_Exchange

LIGHT_DT_Send_Version (Thumb, 192 bytes, Stack size 32 bytes, data_transfer.o(.text))

[Stack]

- Max Depth = 96
- Call Chain = LIGHT_DT_Send_Version ⇒ LIGHT_DT_Send_Data ⇒ Usart2_Send ⇒ USART_ITConfig

[Calls]

- >> LIGHT_DT_Send_Data

[Called By]

- >> LIGHT_DT_Data_Exchange

LIGHT_DT_Data_Exchange (Thumb, 1546 bytes, Stack size 32 bytes, data_transfer.o(.text))

[Stack]

- Max Depth = 160
- Call Chain = LIGHT_DT_Data_Exchange ⇒ LIGHT_DT_Send_PID ⇒ LIGHT_DT_Send_Data ⇒ Usart2_Send ⇒ USART_ITConfig

[Calls]

- >> Usb_Hid_Send
- >> LIGHT_DT_Send_Version
- >> LIGHT_DT_Send_Status
- >> LIGHT_DT_Send_Speed
- >> LIGHT_DT_Send_User
- >> LIGHT_DT_Send_Senser
- >> LIGHT_DT_Send_Senser2
- >> LIGHT_DT_Send_RCData
- >> LIGHT_DT_Send_MotoPWM
- >> LIGHT_DT_Send_Power
- >> LIGHT_DT_Send_PID
- >> LIGHT_DT_Send_Location
- >> LIGHT_DT_Send_Msg
- >> LIGHT_DT_Send_Check

[Called By]

- >> Duty_1ms

LIGHT_DT_Data_Receive_Anl (Thumb, 3680 bytes, Stack size 40 bytes, data_transfer.o(.text))

[Stack]

- Max Depth = 432
- Call Chain = LIGHT_DT_Data_Receive_Anl ⇒ Para_ResetToFactorySetup ⇒ Para_WriteSettingToFile ⇒ f_open ⇒ follow_path ⇒ dir_find ⇒ dir_next ⇒ create_chain ⇒ put_fat ⇒ move_window ⇒ sync_window ⇒ disk_write ⇒ Flash_SectorsWrite ⇒ Flash_PageWrite ⇒ Flash_WaitForEnd ⇒ Flash_SendByte ⇒ SPI_I2S_SendData

[Calls]

- >> Feed_Rc_Dog
- >> __aeabi_i2d
- >> __aeabi_dmul
- >> Para_ResetToFactorySetup
- >> PID_Para_Init
- >> __aeabi_d2f

[Called By]

- >> LIGHT_DT_Data_Receive_Prepare

LIGHT_DT_Data_Receive_Prepare (Thumb, 216 bytes, Stack size 8 bytes, data_transfer.o(.text))

[Stack]

- Max Depth = 440
- Call Chain = LIGHT_DT_Data_Receive_Prepare ⇒ LIGHT_DT_Data_Receive_Anl ⇒ Para_ResetToFactorySetup ⇒ Para_WriteSettingToFile ⇒ f_open ⇒ follow_path ⇒ dir_find ⇒ dir_next ⇒ create_chain ⇒ put_fat ⇒ move_window ⇒ sync_window ⇒ disk_write ⇒ Flash_SectorsWrite ⇒ Flash_PageWrite ⇒ Flash_WaitForEnd ⇒ Flash_SendByte ⇒ SPI_I2S_SendData

[Calls]

- >> LIGHT_DT_Data_Receive_Anl

[Called By]

- >> Usart2_IRQ
- >> usbd_hid_set_report

CH_Mapping_Fun (Thumb, 28 bytes, Stack size 0 bytes, rc.o(.text))

[Called By]

- >> RC_Duty

Fly_Ready (Thumb, 524 bytes, Stack size 0 bytes, rc.o(.text))

[Called By]

- >> RC_Duty

RC_Duty (Thumb, 1198 bytes, Stack size 28 bytes, rc.o(.text))

[Stack]

- Max Depth = 28
- Call Chain = RC_Duty

[Calls]

- >> Fly_Ready
- >> CH_Mapping_Fun

[Called By]

- >> Duty_2ms

Feed_Rc_Dog (Thumb, 12 bytes, Stack size 0 bytes, rc.o(.text))

[Called By]

- >> LIGHT_DT_Data_Receive_Anl
- >> _TIM4_IRQHandler
- >> _TIM3_IRQHandler

USBD_Configure_Event (Thumb, 4 bytes, Stack size 0 bytes, usb_config.o(.text))

[Calls]

- >> USBD_HID_Configure_Event

[Address Reference Count : 1]

- usb_config.o(.constdata)

USBD_ReqClrFeature_MSC (Thumb, 2 bytes, Stack size 0 bytes, usb_config.o(.text))

[Called By]

- >> USBD_ReqSetClrFeature

USBD_EndPoint0_Setup_MSC_ReqToIF (Thumb, 4 bytes, Stack size 0 bytes, usb_config.o(.text))

[Called By]

- >> USBD_EndPoint0

USBD_EndPoint0_Out_MSC_ReqToIF (Thumb, 4 bytes, Stack size 0 bytes, usb_config.o(.text), UNUSED)

USBD_EndPoint0_Setup_ADC_ReqToIF (Thumb, 4 bytes, Stack size 0 bytes, usb_config.o(.text), UNUSED)

USBD_EndPoint0_Setup_ADC_ReqToEP (Thumb, 4 bytes, Stack size 0 bytes, usb_config.o(.text), UNUSED)

USBD_EndPoint0_Out_ADC_ReqToIF (Thumb, 4 bytes, Stack size 0 bytes, usb_config.o(.text), UNUSED)

USBD_EndPoint0_Out_ADC_ReqToEP (Thumb, 4 bytes, Stack size 0 bytes, usb_config.o(.text), UNUSED)

USBD_EndPoint0_Setup_CDC_ReqToIF (Thumb, 4 bytes, Stack size 0 bytes, usb_config.o(.text))

[Called By]

- >> USBD_EndPoint0

USBD_EndPoint0_Out_CDC_ReqToIF (Thumb, 4 bytes, Stack size 0 bytes, usb_config.o(.text))

[Called By]

- >> USBD_EndPoint0

USBD_EndPoint0_Setup_CLS_ReqToDEV (Thumb, 4 bytes, Stack size 0 bytes, usb_config.o(.text), UNUSED)

USBD_EndPoint0_Setup_CLS_ReqToIF (Thumb, 4 bytes, Stack size 0 bytes, usb_config.o(.text), UNUSED)

USBD_EndPoint0_Setup_CLS_ReqToEP (Thumb, 4 bytes, Stack size 0 bytes, usb_config.o(.text), UNUSED)

USBD_EndPoint0_Out_CLS_ReqToDEV (Thumb, 4 bytes, Stack size 0 bytes, usb_config.o(.text), UNUSED)

USBD_EndPoint0_Out_CLS_ReqToIF (Thumb, 4 bytes, Stack size 0 bytes, usb_config.o(.text), UNUSED)

USBD_EndPoint0_Out_CLS_ReqToEP (Thumb, 4 bytes, Stack size 0 bytes, usb_config.o(.text), UNUSED)

USBD_SOF_Event (Thumb, 4 bytes, Stack size 0 bytes, usb_config.o(.text))

[Stack]

- Max Depth = 60
- Call Chain = USBD_SOF_Event ⇒ USBD_HID_SOF_Event ⇒ USBD_HID_EP_INTIN_Event ⇒ USBD_WriteEP

[Calls]

- >> USBD_HID_SOF_Event

[Address Reference Count : 1]

- usb_config.o(.constdata)

usbd_os_evt_set (Thumb, 2 bytes, Stack size 0 bytes, usb_config.o(.text), UNUSED)

usbd_os_evt_get (Thumb, 4 bytes, Stack size 0 bytes, usb_config.o(.text), UNUSED)

usbd_os_evt_wait_or (Thumb, 4 bytes, Stack size 0 bytes, usb_config.o(.text), UNUSED)

usbd_class_init (Thumb, 4 bytes, Stack size 0 bytes, usb_config.o(.text))

[Calls]

- >> usbd_hid_init

[Called By]

- >> usbd_init

USBD_RTX_TaskInit (Thumb, 2 bytes, Stack size 0 bytes, usb_config.o(.text))

[Called By]

- >> usbd_init

Usb_Hid_Init (Thumb, 14 bytes, Stack size 8 bytes, usbd_user_hid.o(.text))

[Stack]

- Max Depth = 20
- Call Chain = Usb_Hid_Init ⇒ usbd_init ⇒ USBD_Init

[Calls]

- >> usbd_init
- >> usbd_connect

[Called By]

- >> All_Init

Usb_Hid_Adddata (Thumb, 36 bytes, Stack size 16 bytes, usbd_user_hid.o(.text))

[Stack]

- Max Depth = 16
- Call Chain = Usb_Hid_Adddata

[Called By]

- >> LIGHT_DT_Send_Data

Usb_Hid_Send (Thumb, 406 bytes, Stack size 8 bytes, usbd_user_hid.o(.text))

[Stack]

- Max Depth = 60
- Call Chain = Usb_Hid_Send ⇒ usbd_hid_get_report_trigger ⇒ USBD_HID_EP_INTIN_Event ⇒ USBD_WriteEP

[Calls]

- >> usbd_hid_get_report_trigger

[Called By]

- >> LIGHT_DT_Data_Exchange

usbd_hid_get_report (Thumb, 54 bytes, Stack size 8 bytes, usbd_user_hid.o(.text))

[Stack]

- Max Depth = 8
- Call Chain = usbd_hid_get_report

[Called By]

- >> USBD_HID_EP_INTIN_Event
- >> USBD_HID_GetReport

usbd_hid_set_report (Thumb, 54 bytes, Stack size 32 bytes, usbd_user_hid.o(.text))

[Stack]

- Max Depth = 472
- Call Chain = usbd_hid_set_report ⇒ LIGHT_DT_Data_Receive_Prepare ⇒ LIGHT_DT_Data_Receive_Anl ⇒ Para_ResetToFactorySetup ⇒ Para_WriteSettingToFile ⇒ f_open ⇒ follow_path ⇒ dir_find ⇒ dir_next ⇒ create_chain ⇒ put_fat ⇒ move_window ⇒ sync_window ⇒ disk_write ⇒ Flash_SectorsWrite ⇒ Flash_PageWrite ⇒ Flash_WaitForEnd ⇒ Flash_SendByte ⇒ SPI_I2S_SendData

[Calls]

- >> LIGHT_DT_Data_Receive_Prepare

[Called By]

- >> USBD_HID_EP_INTOUT_Event
- >> USBD_HID_SetReport

get_len_string_interface (Thumb, 18 bytes, Stack size 8 bytes, version.o(.text))

[Stack]

- Max Depth = 8
- Call Chain = get_len_string_interface

[Calls]

- >> strlen

[Called By]

- >> USBD_ReqGetDescriptor

get_uid_string_interface (Thumb, 4 bytes, Stack size 0 bytes, version.o(.text))

[Called By]

- >> USBD_ReqGetDescriptor

filter_1 (Thumb, 366 bytes, Stack size 0 bytes, filter.o(.text))

[Called By]

- >> acc_fusion

Moving_Average (Thumb, 94 bytes, Stack size 12 bytes, filter.o(.text))

[Stack]

- Max Depth = 12
- Call Chain = Moving_Average

[Called By]

- >> fusion_prepare

Moving_Median (Thumb, 304 bytes, Stack size 32 bytes, filter.o(.text))

[Stack]

- Max Depth = 32
- Call Chain = Moving_Median

[Called By]

- >> MS5611_BaroAltCalculate

simple_3d_trans (Thumb, 264 bytes, Stack size 16 bytes, filter.o(.text))

[Stack]

- Max Depth = 16
- Call Chain = simple_3d_trans

[Calls]

- >> my_sqrt

[Called By]

- >> IMUupdate

auto_take_off_land (Thumb, 266 bytes, Stack size 0 bytes, height_ctrl.o(.text), UNUSED)

h_pid_init (Thumb, 624 bytes, Stack size 0 bytes, height_ctrl.o(.text))

[Called By]

- >> PID_Para_Init

Height_Ctrl (Thumb, 3682 bytes, Stack size 32 bytes, height_ctrl.o(.text))

[Stack]

- Max Depth = 168
- Call Chain = Height_Ctrl ⇒ baro_ctrl ⇒ MS5611_Update ⇒ MS5611_BaroAltCalculate ⇒ Moving_Median

[Calls]

- >> my_deathzoom_2
- >> my_deathzoom
- >> baro_ctrl
- >> PID_calculate

[Called By]

- >> Thr_Ctrl

mode_check (Thumb, 514 bytes, Stack size 0 bytes, fly_mode.o(.text))

[Called By]

- >> Duty_50ms

PID_calculate (Thumb, 406 bytes, Stack size 0 bytes, pid.o(.text))

[Called By]

- >> Height_Ctrl

baro_compensate (Thumb, 274 bytes, Stack size 32 bytes, baro_ctrl.o(.text))

[Stack]

- Max Depth = 32
- Call Chain = baro_compensate

[Calls]

- >> my_sqrt

[Called By]

- >> baro_ctrl

fusion_prepare (Thumb, 178 bytes, Stack size 32 bytes, baro_ctrl.o(.text))

[Stack]

- Max Depth = 44
- Call Chain = fusion_prepare ⇒ Moving_Average

[Calls]

- >> my_deathzoom
- >> Moving_Average

[Called By]

- >> baro_ctrl

acc_fusion (Thumb, 388 bytes, Stack size 24 bytes, baro_ctrl.o(.text))

[Stack]

- Max Depth = 24
- Call Chain = acc_fusion

[Calls]

- >> my_deathzoom
- >> filter_1

[Called By]

- >> baro_ctrl

baro_ctrl (Thumb, 760 bytes, Stack size 32 bytes, baro_ctrl.o(.text))

[Stack]

- Max Depth = 136
- Call Chain = baro_ctrl ⇒ MS5611_Update ⇒ MS5611_BaroAltCalculate ⇒ Moving_Median

[Calls]

- >> my_deathzoom
- >> MS5611_Update
- >> acc_fusion
- >> fusion_prepare
- >> baro_compensate

[Called By]

- >> Height_Ctrl

TIM_CONF (Thumb, 86 bytes, Stack size 16 bytes, time.o(.text), UNUSED)

[Calls]

- >> TIM_TimeBaseInit
- >> TIM_ITConfig
- >> TIM_DeInit
- >> TIM_Cmd
- >> TIM_ClearFlag
- >> RCC_APB1PeriphClockCmd

[Called By]

- >> TIM_INIT

TIM_NVIC (Thumb, 34 bytes, Stack size 8 bytes, time.o(.text), UNUSED)

[Calls]

- >> NVIC_Init

[Called By]

- >> TIM_INIT

TIM_INIT (Thumb, 20 bytes, Stack size 8 bytes, time.o(.text), UNUSED)

[Calls]

- >> RCC_APB1PeriphClockCmd
- >> TIM_NVIC
- >> TIM_CONF

SysTick_Configuration (Thumb, 100 bytes, Stack size 32 bytes, time.o(.text))

[Stack]

- Max Depth = 52
- Call Chain = SysTick_Configuration ⇒ RCC_GetClocksFreq

[Calls]

- >> SysTick_CLKSourceConfig
- >> RCC_GetClocksFreq

[Called By]

- >> All_Init

GetSysTime_us (Thumb, 48 bytes, Stack size 0 bytes, time.o(.text))

[Called By]

- >> Get_Cycle_T
- >> Duty_5ms
- >> Duty_2ms
- >> Delay_us

Delay_us (Thumb, 24 bytes, Stack size 12 bytes, time.o(.text))

[Stack]

- Max Depth = 12
- Call Chain = Delay_us

[Calls]

- >> GetSysTime_us

[Called By]

- >> Delay_ms

Delay_ms (Thumb, 24 bytes, Stack size 8 bytes, time.o(.text))

[Stack]

- Max Depth = 20
- Call Chain = Delay_ms ⇒ Delay_us

[Calls]

- >> Delay_us

[Called By]

- >> MS5611_Init
- >> MPU6050_Init
- >> LED_Mag_Err
- >> LED_MS5611_Err
- >> LED_MPU_Err
- >> All_Init
- >> double_flash

sys_time (Thumb, 126 bytes, Stack size 8 bytes, time.o(.text))

[Stack]

- Max Depth = 16
- Call Chain = sys_time ⇒ Loop_check

[Calls]

- >> Loop_check

[Called By]

- >> SysTick_Handler

Get_Cycle_T (Thumb, 118 bytes, Stack size 8 bytes, time.o(.text))

[Stack]

- Max Depth = 8
- Call Chain = Get_Cycle_T

[Calls]

- >> GetSysTime_us

[Called By]

- >> Cycle_Time_Init
- >> Duty_5ms
- >> Duty_2ms
- >> Duty_1ms

Cycle_Time_Init (Thumb, 22 bytes, Stack size 8 bytes, time.o(.text))

[Stack]

- Max Depth = 16
- Call Chain = Cycle_Time_Init ⇒ Get_Cycle_T

[Calls]

- >> Get_Cycle_T

[Called By]

- >> All_Init

PWM_IN_Init (Thumb, 698 bytes, Stack size 32 bytes, pwm_in.o(.text))

[Stack]

- Max Depth = 68
- Call Chain = PWM_IN_Init ⇒ TIM_ICInit ⇒ TI1_Config

[Calls]

- >> TIM_ICInit
- >> RCC_AHB1PeriphClockCmd
- >> GPIO_PinAFConfig
- >> GPIO_Init
- >> TIM_ITConfig
- >> TIM_Cmd
- >> RCC_APB1PeriphClockCmd
- >> NVIC_Init

[Called By]

- >> All_Init

_TIM3_IRQHandler (Thumb, 526 bytes, Stack size 8 bytes, pwm_in.o(.text))

[Stack]

- Max Depth = 16
- Call Chain = _TIM3_IRQHandler ⇒ TIM_GetCapture4

[Calls]

- >> Feed_Rc_Dog
- >> TIM_GetCapture4
- >> TIM_GetCapture3
- >> TIM_GetCapture2
- >> TIM_GetCapture1

[Called By]

- >> TIM3_IRQHandler

_TIM4_IRQHandler (Thumb, 450 bytes, Stack size 8 bytes, pwm_in.o(.text))

[Stack]

- Max Depth = 16
- Call Chain = _TIM4_IRQHandler ⇒ TIM_GetCapture4

[Calls]

- >> Feed_Rc_Dog
- >> TIM_GetCapture4
- >> TIM_GetCapture3
- >> TIM_GetCapture2
- >> TIM_GetCapture1

[Called By]

- >> TIM4_IRQHandler

PWM_Out_Init (Thumb, 706 bytes, Stack size 56 bytes, pwm_out.o(.text))

[Stack]

- Max Depth = 80
- Call Chain = PWM_Out_Init ⇒ TIM_OC4Init

[Calls]

- >> TIM_TimeBaseStructInit
- >> TIM_OCStructInit
- >> TIM_OC4PreloadConfig
- >> TIM_OC4Init
- >> TIM_OC3PreloadConfig
- >> TIM_OC3Init
- >> TIM_OC2Init
- >> TIM_OC1Init
- >> TIM_CtrlPWMOutputs
- >> TIM_ARRPreloadConfig
- >> RCC_APB2PeriphClockCmd
- >> RCC_AHB1PeriphClockCmd
- >> GPIO_PinAFConfig
- >> GPIO_Init
- >> TIM_TimeBaseInit
- >> TIM_Cmd
- >> RCC_APB1PeriphClockCmd

[Called By]

- >> All_Init

CH_out_Mapping_Fun (Thumb, 28 bytes, Stack size 0 bytes, pwm_out.o(.text), UNUSED)

SetPwm (Thumb, 124 bytes, Stack size 20 bytes, pwm_out.o(.text))

[Stack]

- Max Depth = 20
- Call Chain = SetPwm

[Called By]

- >> All_Out

I2c_Soft_delay (Thumb, 42 bytes, Stack size 0 bytes, i2c_soft.o(.text))

[Called By]

- >> I2c_Soft_ReadByte
- >> I2c_Soft_SendByte
- >> I2c_Soft_WaitAsk
- >> I2c_Soft_NoAsk
- >> I2c_Soft_Ask
- >> I2c_Soft_Stop
- >> I2c_Soft_Start

I2c_Soft_Init (Thumb, 46 bytes, Stack size 16 bytes, i2c_soft.o(.text))

[Stack]

- Max Depth = 40
- Call Chain = I2c_Soft_Init ⇒ GPIO_Init

[Calls]

- >> RCC_AHB1PeriphClockCmd
- >> GPIO_Init

[Called By]

- >> MPU6050_Init
- >> All_Init

I2c_Soft_Start (Thumb, 86 bytes, Stack size 4 bytes, i2c_soft.o(.text))

[Stack]

- Max Depth = 4
- Call Chain = I2c_Soft_Start

[Calls]

- >> I2c_Soft_delay

[Called By]

- >> IIC_Read_nByte
- >> IIC_Write_nByte
- >> IIC_Read_1Byte
- >> IIC_Write_1Byte

I2c_Soft_Stop (Thumb, 52 bytes, Stack size 4 bytes, i2c_soft.o(.text))

[Stack]

- Max Depth = 4
- Call Chain = I2c_Soft_Stop

[Calls]

- >> I2c_Soft_delay

[Called By]

- >> IIC_Read_nByte
- >> IIC_Write_nByte
- >> IIC_Read_1Byte
- >> IIC_Write_1Byte
- >> I2c_Soft_WaitAsk

I2c_Soft_Ask (Thumb, 52 bytes, Stack size 4 bytes, i2c_soft.o(.text))

[Stack]

- Max Depth = 4
- Call Chain = I2c_Soft_Ask

[Calls]

- >> I2c_Soft_delay

[Called By]

- >> I2c_Soft_ReadByte

I2c_Soft_NoAsk (Thumb, 52 bytes, Stack size 4 bytes, i2c_soft.o(.text))

[Stack]

- Max Depth = 4
- Call Chain = I2c_Soft_NoAsk

[Calls]

- >> I2c_Soft_delay

[Called By]

- >> I2c_Soft_ReadByte

I2c_Soft_WaitAsk (Thumb, 88 bytes, Stack size 4 bytes, i2c_soft.o(.text))

[Stack]

- Max Depth = 8
- Call Chain = I2c_Soft_WaitAsk ⇒ I2c_Soft_Stop

[Calls]

- >> I2c_Soft_Stop
- >> I2c_Soft_delay

[Called By]

- >> IIC_Read_nByte
- >> IIC_Write_nByte
- >> IIC_Read_1Byte
- >> IIC_Write_1Byte

I2c_Soft_SendByte (Thumb, 84 bytes, Stack size 8 bytes, i2c_soft.o(.text))

[Stack]

- Max Depth = 8
- Call Chain = I2c_Soft_SendByte

[Calls]

- >> I2c_Soft_delay

[Called By]

- >> IIC_Read_nByte
- >> IIC_Write_nByte
- >> IIC_Read_1Byte
- >> IIC_Write_1Byte

I2c_Soft_ReadByte (Thumb, 96 bytes, Stack size 12 bytes, i2c_soft.o(.text))

[Stack]

- Max Depth = 16
- Call Chain = I2c_Soft_ReadByte ⇒ I2c_Soft_NoAsk

[Calls]

- >> I2c_Soft_NoAsk
- >> I2c_Soft_Ask
- >> I2c_Soft_delay

[Called By]

- >> IIC_Read_nByte
- >> IIC_Read_1Byte

IIC_Write_1Byte (Thumb, 62 bytes, Stack size 16 bytes, i2c_soft.o(.text))

[Stack]

- Max Depth = 24
- Call Chain = IIC_Write_1Byte ⇒ I2c_Soft_SendByte

[Calls]

- >> I2c_Soft_SendByte
- >> I2c_Soft_WaitAsk
- >> I2c_Soft_Stop
- >> I2c_Soft_Start

[Called By]

- >> LIGHT_AK8975_Run
- >> MS5611_Start_P
- >> MS5611_Start_T
- >> MS5611_Reset
- >> MPU6050_set_SMPLRT_DIV
- >> IICwriteBits
- >> IICwriteBit

IIC_Read_1Byte (Thumb, 80 bytes, Stack size 16 bytes, i2c_soft.o(.text))

[Stack]

- Max Depth = 32
- Call Chain = IIC_Read_1Byte ⇒ I2c_Soft_ReadByte ⇒ I2c_Soft_NoAsk

[Calls]

- >> I2c_Soft_ReadByte
- >> I2c_Soft_SendByte
- >> I2c_Soft_WaitAsk
- >> I2c_Soft_Stop
- >> I2c_Soft_Start

[Called By]

- >> LIGHT_AK8975_Read_Mag_Data

IIC_Write_nByte (Thumb, 78 bytes, Stack size 20 bytes, i2c_soft.o(.text), UNUSED)

[Calls]

- >> I2c_Soft_SendByte
- >> I2c_Soft_WaitAsk
- >> I2c_Soft_Stop
- >> I2c_Soft_Start

IIC_Read_nByte (Thumb, 108 bytes, Stack size 20 bytes, i2c_soft.o(.text))

[Stack]

- Max Depth = 36
- Call Chain = IIC_Read_nByte ⇒ I2c_Soft_ReadByte ⇒ I2c_Soft_NoAsk

[Calls]

- >> I2c_Soft_ReadByte
- >> I2c_Soft_SendByte
- >> I2c_Soft_WaitAsk
- >> I2c_Soft_Stop
- >> I2c_Soft_Start

[Called By]

- >> MPU6050_Read
- >> MS5611_Read_Adc_P
- >> MS5611_Read_Adc_T
- >> MS5611_Read_Prom
- >> IICwriteBits
- >> IICwriteBit

MPU6050_Read (Thumb, 22 bytes, Stack size 8 bytes, mpu6050.o(.text))

[Stack]

- Max Depth = 44
- Call Chain = MPU6050_Read ⇒ IIC_Read_nByte ⇒ I2c_Soft_ReadByte ⇒ I2c_Soft_NoAsk

[Calls]

- >> IIC_Read_nByte

[Called By]

- >> Duty_2ms

IICwriteBit (Thumb, 78 bytes, Stack size 24 bytes, mpu6050.o(.text))

[Stack]

- Max Depth = 60
- Call Chain = IICwriteBit ⇒ IIC_Read_nByte ⇒ I2c_Soft_ReadByte ⇒ I2c_Soft_NoAsk

[Calls]

- >> IIC_Read_nByte
- >> IIC_Write_1Byte

[Called By]

- >> MPU6050_setI2CBypassEnabled
- >> MPU6050_setI2CMasterModeEnabled
- >> MPU6050_setSleepEnabled

IICwriteBits (Thumb, 102 bytes, Stack size 32 bytes, mpu6050.o(.text))

[Stack]

- Max Depth = 68
- Call Chain = IICwriteBits ⇒ IIC_Read_nByte ⇒ I2c_Soft_ReadByte ⇒ I2c_Soft_NoAsk

[Calls]

- >> IIC_Read_nByte
- >> IIC_Write_1Byte

[Called By]

- >> MPU6050_setDLPF
- >> MPU6050_setFullScaleAccelRange
- >> MPU6050_setFullScaleGyroRange
- >> MPU6050_setClockSource

MPU6050_set_SMPLRT_DIV (Thumb, 28 bytes, Stack size 16 bytes, mpu6050.o(.text))

[Stack]

- Max Depth = 40
- Call Chain = MPU6050_set_SMPLRT_DIV ⇒ IIC_Write_1Byte ⇒ I2c_Soft_SendByte

[Calls]

- >> IIC_Write_1Byte

[Called By]

- >> MPU6050_Init

MPU6050_setClockSource (Thumb, 20 bytes, Stack size 16 bytes, mpu6050.o(.text))

[Stack]

- Max Depth = 84
- Call Chain = MPU6050_setClockSource ⇒ IICwriteBits ⇒ IIC_Read_nByte ⇒ I2c_Soft_ReadByte ⇒ I2c_Soft_NoAsk

[Calls]

- >> IICwriteBits

[Called By]

- >> MPU6050_Init

MPU6050_setFullScaleGyroRange (Thumb, 36 bytes, Stack size 16 bytes, mpu6050.o(.text))

[Stack]

- Max Depth = 84
- Call Chain = MPU6050_setFullScaleGyroRange ⇒ IICwriteBits ⇒ IIC_Read_nByte ⇒ I2c_Soft_ReadByte ⇒ I2c_Soft_NoAsk

[Calls]

- >> IICwriteBits

[Called By]

- >> MPU6050_Init

MPU6050_setFullScaleAccelRange (Thumb, 36 bytes, Stack size 16 bytes, mpu6050.o(.text))

[Stack]

- Max Depth = 84
- Call Chain = MPU6050_setFullScaleAccelRange ⇒ IICwriteBits ⇒ IIC_Read_nByte ⇒ I2c_Soft_ReadByte ⇒ I2c_Soft_NoAsk

[Calls]

- >> IICwriteBits

[Called By]

- >> MPU6050_Init

MPU6050_setSleepEnabled (Thumb, 18 bytes, Stack size 8 bytes, mpu6050.o(.text))

[Stack]

- Max Depth = 68
- Call Chain = MPU6050_setSleepEnabled ⇒ IICwriteBit ⇒ IIC_Read_nByte ⇒ I2c_Soft_ReadByte ⇒ I2c_Soft_NoAsk

[Calls]

- >> IICwriteBit

[Called By]

- >> MPU6050_Init

MPU6050_setI2CMasterModeEnabled (Thumb, 18 bytes, Stack size 8 bytes, mpu6050.o(.text))

[Stack]

- Max Depth = 68
- Call Chain = MPU6050_setI2CMasterModeEnabled ⇒ IICwriteBit ⇒ IIC_Read_nByte ⇒ I2c_Soft_ReadByte ⇒ I2c_Soft_NoAsk

[Calls]

- >> IICwriteBit

[Called By]

- >> MPU6050_Init

MPU6050_setI2CBypassEnabled (Thumb, 18 bytes, Stack size 8 bytes, mpu6050.o(.text))

[Stack]

- Max Depth = 68
- Call Chain = MPU6050_setI2CBypassEnabled ⇒ IICwriteBit ⇒ IIC_Read_nByte ⇒ I2c_Soft_ReadByte ⇒ I2c_Soft_NoAsk

[Calls]

- >> IICwriteBit

[Called By]

- >> MPU6050_Init

MPU6050_setDLPF (Thumb, 20 bytes, Stack size 16 bytes, mpu6050.o(.text))

[Stack]

- Max Depth = 84
- Call Chain = MPU6050_setDLPF ⇒ IICwriteBits ⇒ IIC_Read_nByte ⇒ I2c_Soft_ReadByte ⇒ I2c_Soft_NoAsk

[Calls]

- >> IICwriteBits

[Called By]

- >> MPU6050_Init

MPU6050_INT_Config (Thumb, 56 bytes, Stack size 16 bytes, mpu6050.o(.text))

[Stack]

- Max Depth = 40
- Call Chain = MPU6050_INT_Config ⇒ GPIO_Init

[Calls]

- >> GPIO_SetBits
- >> RCC_AHB1PeriphClockCmd
- >> GPIO_Init

[Called By]

- >> MPU6050_Init

MPU6050_Init (Thumb, 184 bytes, Stack size 16 bytes, mpu6050.o(.text))

[Stack]

- Max Depth = 100
- Call Chain = MPU6050_Init ⇒ MPU6050_setDLPF ⇒ IICwriteBits ⇒ IIC_Read_nByte ⇒ I2c_Soft_ReadByte ⇒ I2c_Soft_NoAsk

[Calls]

- >> I2c_Soft_Init
- >> Delay_ms
- >> MPU6050_INT_Config
- >> MPU6050_setDLPF
- >> MPU6050_setI2CBypassEnabled
- >> MPU6050_setI2CMasterModeEnabled
- >> MPU6050_setSleepEnabled
- >> MPU6050_setFullScaleAccelRange
- >> MPU6050_setFullScaleGyroRange
- >> MPU6050_setClockSource
- >> MPU6050_set_SMPLRT_DIV

[Called By]

- >> All_Init

MPU6050_Data_Offset (Thumb, 648 bytes, Stack size 8 bytes, mpu6050.o(.text))

[Stack]

- Max Depth = 400
- Call Chain = MPU6050_Data_Offset ⇒ Param_SaveGyroOffset ⇒ Para_WriteSettingToFile ⇒ f_open ⇒ follow_path ⇒ dir_find ⇒ dir_next ⇒ create_chain ⇒ put_fat ⇒ move_window ⇒ sync_window ⇒ disk_write ⇒ Flash_SectorsWrite ⇒ Flash_PageWrite ⇒ Flash_WaitForEnd ⇒ Flash_SendByte ⇒ SPI_I2S_SendData

[Calls]

- >> my_sqrt
- >> Param_SaveGyroOffset
- >> Param_SaveAccelOffset

[Called By]

- >> MPU6050_Data_Prepare

Transform (Thumb, 14 bytes, Stack size 0 bytes, mpu6050.o(.text))

[Called By]

- >> MPU6050_Data_Prepare

MPU6050_Data_Prepare (Thumb, 1174 bytes, Stack size 56 bytes, mpu6050.o(.text))

[Stack]

- Max Depth = 456
- Call Chain = MPU6050_Data_Prepare ⇒ MPU6050_Data_Offset ⇒ Param_SaveGyroOffset ⇒ Para_WriteSettingToFile ⇒ f_open ⇒ follow_path ⇒ dir_find ⇒ dir_next ⇒ create_chain ⇒ put_fat ⇒ move_window ⇒ sync_window ⇒ disk_write ⇒ Flash_SectorsWrite ⇒ Flash_PageWrite ⇒ Flash_WaitForEnd ⇒ Flash_SendByte ⇒ SPI_I2S_SendData

[Calls]

- >> Transform
- >> MPU6050_Data_Offset
- >> __aeabi_memclr4

[Called By]

- >> Duty_2ms

LIGHT_AK8975_Run (Thumb, 22 bytes, Stack size 8 bytes, ak8975.o(.text))

[Stack]

- Max Depth = 32
- Call Chain = LIGHT_AK8975_Run ⇒ IIC_Write_1Byte ⇒ I2c_Soft_SendByte

[Calls]

- >> IIC_Write_1Byte

[Called By]

- >> All_Init
- >> LIGHT_AK8975_Read_Mag_Data

XYZ_STRUCT_COPY (Thumb, 40 bytes, Stack size 16 bytes, ak8975.o(.text), UNUSED)

LIGHT_AK8975_CalOffset_Mag (Thumb, 760 bytes, Stack size 8 bytes, ak8975.o(.text))

[Stack]

- Max Depth = 400
- Call Chain = LIGHT_AK8975_CalOffset_Mag ⇒ Param_SaveMagOffset ⇒ Para_WriteSettingToFile ⇒ f_open ⇒ follow_path ⇒ dir_find ⇒ dir_next ⇒ create_chain ⇒ put_fat ⇒ move_window ⇒ sync_window ⇒ disk_write ⇒ Flash_SectorsWrite ⇒ Flash_PageWrite ⇒ Flash_WaitForEnd ⇒ Flash_SendByte ⇒ SPI_I2S_SendData

[Calls]

- >> Param_SaveMagOffset

[Called By]

- >> LIGHT_AK8975_Read_Mag_Data

LIGHT_AK8975_Read_Mag_Data (Thumb, 274 bytes, Stack size 24 bytes, ak8975.o(.text))

[Stack]

- Max Depth = 424
- Call Chain = LIGHT_AK8975_Read_Mag_Data ⇒ LIGHT_AK8975_CalOffset_Mag ⇒ Param_SaveMagOffset ⇒ Para_WriteSettingToFile ⇒ f_open ⇒ follow_path ⇒ dir_find ⇒ dir_next ⇒ create_chain ⇒ put_fat ⇒ move_window ⇒ sync_window ⇒ disk_write ⇒ Flash_SectorsWrite ⇒ Flash_PageWrite ⇒ Flash_WaitForEnd ⇒ Flash_SendByte ⇒ SPI_I2S_SendData

[Calls]

- >> LIGHT_AK8975_Run
- >> LIGHT_AK8975_CalOffset_Mag
- >> IIC_Read_1Byte

[Called By]

- >> LIGHT_AK8975_Read

LIGHT_AK8975_Get_Mag (Thumb, 16 bytes, Stack size 0 bytes, ak8975.o(.text), UNUSED)

LIGHT_AK8975_Read (Thumb, 8 bytes, Stack size 8 bytes, ak8975.o(.text))

[Stack]

- Max Depth = 432
- Call Chain = LIGHT_AK8975_Read ⇒ LIGHT_AK8975_Read_Mag_Data ⇒ LIGHT_AK8975_CalOffset_Mag ⇒ Param_SaveMagOffset ⇒ Para_WriteSettingToFile ⇒ f_open ⇒ follow_path ⇒ dir_find ⇒ dir_next ⇒ create_chain ⇒ put_fat ⇒ move_window ⇒ sync_window ⇒ disk_write ⇒ Flash_SectorsWrite ⇒ Flash_PageWrite ⇒ Flash_WaitForEnd ⇒ Flash_SendByte ⇒ SPI_I2S_SendData

[Calls]

- >> LIGHT_AK8975_Read_Mag_Data

[Called By]

- >> Duty_10ms

LED_Init (Thumb, 74 bytes, Stack size 16 bytes, led.o(.text))

[Stack]

- Max Depth = 40
- Call Chain = LED_Init ⇒ GPIO_Init

[Calls]

- >> GPIO_SetBits
- >> RCC_AHB1PeriphClockCmd
- >> GPIO_Init

[Called By]

- >> All_Init

double_flash (Thumb, 102 bytes, Stack size 8 bytes, led.o(.text))

[Stack]

- Max Depth = 28
- Call Chain = double_flash ⇒ Delay_ms ⇒ Delay_us

[Calls]

- >> Delay_ms

[Called By]

- >> aircraft_mode_led

aircraft_mode_led (Thumb, 66 bytes, Stack size 8 bytes, led.o(.text))

[Stack]

- Max Depth = 36
- Call Chain = aircraft_mode_led ⇒ double_flash ⇒ Delay_ms ⇒ Delay_us

[Calls]

- >> double_flash

[Called By]

- >> All_Init

LED_1ms_DRV (Thumb, 180 bytes, Stack size 0 bytes, led.o(.text))

[Called By]

- >> Loop_check

led_breath (Thumb, 288 bytes, Stack size 8 bytes, led.o(.text))

[Stack]

- Max Depth = 8
- Call Chain = led_breath

[Called By]

- >> LED_Duty

led_flash (Thumb, 206 bytes, Stack size 20 bytes, led.o(.text))

[Stack]

- Max Depth = 20
- Call Chain = led_flash

[Called By]

- >> LED_Duty

led_cnt_restar (Thumb, 42 bytes, Stack size 0 bytes, led.o(.text))

[Called By]

- >> led_cnt_res_check

led_cnt_res_check (Thumb, 28 bytes, Stack size 4 bytes, led.o(.text))

[Stack]

- Max Depth = 4
- Call Chain = led_cnt_res_check

[Calls]

- >> led_cnt_restar

[Called By]

- >> LED_Duty

LED_Duty (Thumb, 1436 bytes, Stack size 12 bytes, led.o(.text))

[Stack]

- Max Depth = 32
- Call Chain = LED_Duty ⇒ led_flash

[Calls]

- >> led_cnt_res_check
- >> led_flash
- >> led_breath

[Called By]

- >> Duty_50ms

LED_MPU_Err (Thumb, 46 bytes, Stack size 0 bytes, led.o(.text))

[Stack]

- Max Depth = 20
- Call Chain = LED_MPU_Err ⇒ Delay_ms ⇒ Delay_us

[Calls]

- >> Delay_ms

[Called By]

- >> All_Init

LED_Mag_Err (Thumb, 72 bytes, Stack size 0 bytes, led.o(.text))

[Stack]

- Max Depth = 20
- Call Chain = LED_Mag_Err ⇒ Delay_ms ⇒ Delay_us

[Calls]

- >> Delay_ms

[Called By]

- >> All_Init

LED_MS5611_Err (Thumb, 96 bytes, Stack size 0 bytes, led.o(.text))

[Stack]

- Max Depth = 20
- Call Chain = LED_MS5611_Err ⇒ Delay_ms ⇒ Delay_us

[Calls]

- >> Delay_ms

[Called By]

- >> All_Init

MS5611_Reset (Thumb, 14 bytes, Stack size 8 bytes, ms5611.o(.text))

[Stack]

- Max Depth = 32
- Call Chain = MS5611_Reset ⇒ IIC_Write_1Byte ⇒ I2c_Soft_SendByte

[Calls]

- >> IIC_Write_1Byte

[Called By]

- >> MS5611_Init

MS5611_Read_Prom (Thumb, 72 bytes, Stack size 16 bytes, ms5611.o(.text))

[Stack]

- Max Depth = 52
- Call Chain = MS5611_Read_Prom ⇒ IIC_Read_nByte ⇒ I2c_Soft_ReadByte ⇒ I2c_Soft_NoAsk

[Calls]

- >> IIC_Read_nByte

[Called By]

- >> MS5611_Init

MS5611_Read_Adc_T (Thumb, 16 bytes, Stack size 8 bytes, ms5611.o(.text))

[Stack]

- Max Depth = 44
- Call Chain = MS5611_Read_Adc_T ⇒ IIC_Read_nByte ⇒ I2c_Soft_ReadByte ⇒ I2c_Soft_NoAsk

[Calls]

- >> IIC_Read_nByte

[Called By]

- >> MS5611_Update

MS5611_Read_Adc_P (Thumb, 16 bytes, Stack size 8 bytes, ms5611.o(.text))

[Stack]

- Max Depth = 44
- Call Chain = MS5611_Read_Adc_P ⇒ IIC_Read_nByte ⇒ I2c_Soft_ReadByte ⇒ I2c_Soft_NoAsk

[Calls]

- >> IIC_Read_nByte

[Called By]

- >> MS5611_Update

MS5611_Start_T (Thumb, 14 bytes, Stack size 8 bytes, ms5611.o(.text))

[Stack]

- Max Depth = 32
- Call Chain = MS5611_Start_T ⇒ IIC_Write_1Byte ⇒ I2c_Soft_SendByte

[Calls]

- >> IIC_Write_1Byte

[Called By]

- >> MS5611_Init
- >> MS5611_Update

MS5611_Start_P (Thumb, 14 bytes, Stack size 8 bytes, ms5611.o(.text))

[Stack]

- Max Depth = 32
- Call Chain = MS5611_Start_P ⇒ IIC_Write_1Byte ⇒ I2c_Soft_SendByte

[Calls]

- >> IIC_Write_1Byte

[Called By]

- >> MS5611_Update

MS5611_Init (Thumb, 40 bytes, Stack size 8 bytes, ms5611.o(.text))

[Stack]

- Max Depth = 60
- Call Chain = MS5611_Init ⇒ MS5611_Read_Prom ⇒ IIC_Read_nByte ⇒ I2c_Soft_ReadByte ⇒ I2c_Soft_NoAsk

[Calls]

- >> Delay_ms
- >> MS5611_Start_T
- >> MS5611_Read_Prom
- >> MS5611_Reset

[Called By]

- >> All_Init

MS5611_BaroAltCalculate (Thumb, 646 bytes, Stack size 64 bytes, ms5611.o(.text))

[Stack]

- Max Depth = 96
- Call Chain = MS5611_BaroAltCalculate ⇒ Moving_Median

[Calls]

- >> Moving_Median

[Called By]

- >> MS5611_Update

MS5611_Update (Thumb, 48 bytes, Stack size 8 bytes, ms5611.o(.text))

[Stack]

- Max Depth = 104
- Call Chain = MS5611_Update ⇒ MS5611_BaroAltCalculate ⇒ Moving_Median

[Calls]

- >> MS5611_BaroAltCalculate
- >> MS5611_Start_P
- >> MS5611_Start_T
- >> MS5611_Read_Adc_P
- >> MS5611_Read_Adc_T

[Called By]

- >> baro_ctrl

Usart1_Init (Thumb, 202 bytes, Stack size 40 bytes, usart.o(.text))

[Stack]

- Max Depth = 108
- Call Chain = Usart1_Init ⇒ USART_Init ⇒ RCC_GetClocksFreq

[Calls]

- >> USART_Init
- >> USART_ITConfig
- >> USART_Cmd
- >> RCC_APB2PeriphClockCmd
- >> RCC_AHB1PeriphClockCmd
- >> GPIO_PinAFConfig
- >> GPIO_Init
- >> NVIC_Init

[Called By]

- >> All_Init

USART1_IRQHandler (Thumb, 1668 bytes, Stack size 128 bytes, usart.o(.text))

[Stack]

- Max Depth = 288
- Call Chain = USART1_IRQHandler ⇒ __hardfp_atan ⇒ __kernel_poly ⇒ __aeabi_dmul ⇒ _double_epilogue ⇒ _double_round

[Calls]

- >> __aeabi_dmul
- >> __aeabi_f2d
- >> __aeabi_dsub
- >> __aeabi_d2f
- >> __aeabi_ddiv
- >> USART_ReceiveData
- >> USART_GetITStatus
- >> USART_ClearITPendingBit
- >> __hardfp_atan

[Address Reference Count : 1]

- startup_stm32f4xx.o(RESET)

Usart2_Init (Thumb, 230 bytes, Stack size 48 bytes, usart.o(.text))

[Stack]

- Max Depth = 116
- Call Chain = Usart2_Init ⇒ USART_Init ⇒ RCC_GetClocksFreq

[Calls]

- >> USART_Init
- >> USART_ITConfig
- >> USART_Cmd
- >> USART_ClockInit
- >> RCC_AHB1PeriphClockCmd
- >> GPIO_PinAFConfig
- >> GPIO_Init
- >> RCC_APB1PeriphClockCmd
- >> NVIC_Init

[Called By]

- >> All_Init

Usart2_IRQ (Thumb, 232 bytes, Stack size 8 bytes, usart.o(.text))

[Stack]

- Max Depth = 448
- Call Chain = Usart2_IRQ ⇒ LIGHT_DT_Data_Receive_Prepare ⇒ LIGHT_DT_Data_Receive_Anl ⇒ Para_ResetToFactorySetup ⇒ Para_WriteSettingToFile ⇒ f_open ⇒ follow_path ⇒ dir_find ⇒ dir_next ⇒ create_chain ⇒ put_fat ⇒ move_window ⇒ sync_window ⇒ disk_write ⇒ Flash_SectorsWrite ⇒ Flash_PageWrite ⇒ Flash_WaitForEnd ⇒ Flash_SendByte ⇒ SPI_I2S_SendData

[Calls]

- >> LIGHT_DT_Data_Receive_Prepare
- >> USART_GetITStatus
- >> USART_ClearITPendingBit

[Called By]

- >> USART2_IRQHandler

Usart2_Send (Thumb, 62 bytes, Stack size 16 bytes, usart.o(.text))

[Stack]

- Max Depth = 48
- Call Chain = Usart2_Send ⇒ USART_ITConfig

[Calls]

- >> USART_ITConfig

[Called By]

- >> LIGHT_DT_Send_Data

Uart5_Init (Thumb, 206 bytes, Stack size 40 bytes, usart.o(.text))

[Stack]

- Max Depth = 108
- Call Chain = Uart5_Init ⇒ USART_Init ⇒ RCC_GetClocksFreq

[Calls]

- >> USART_Init
- >> USART_ITConfig
- >> USART_Cmd
- >> RCC_AHB1PeriphClockCmd
- >> GPIO_PinAFConfig
- >> GPIO_Init
- >> RCC_APB1PeriphClockCmd
- >> NVIC_Init

[Called By]

- >> Ultrasonic_Init

Uart5_IRQ (Thumb, 94 bytes, Stack size 8 bytes, usart.o(.text))

[Stack]

- Max Depth = 40
- Call Chain = Uart5_IRQ ⇒ USART_GetITStatus

[Calls]

- >> Ultra_Get
- >> USART_GetITStatus
- >> USART_ClearITPendingBit

[Called By]

- >> UART5_IRQHandler

Uart5_Send (Thumb, 60 bytes, Stack size 16 bytes, usart.o(.text))

[Stack]

- Max Depth = 48
- Call Chain = Uart5_Send ⇒ USART_ITConfig

[Calls]

- >> USART_ITConfig

[Called By]

- >> Ultra_Duty

usbd_stm32_delay (Thumb, 40 bytes, Stack size 0 bytes, usbd_stm32f4xx_fs.o(.text))

[Called By]

- >> USBD_WakeUp
- >> USBD_Init

USBD_IntrEna (Thumb, 26 bytes, Stack size 0 bytes, usbd_stm32f4xx_fs.o(.text))

[Called By]

- >> USBD_Init

USBD_Init (Thumb, 462 bytes, Stack size 4 bytes, usbd_stm32f4xx_fs.o(.text))

[Stack]

- Max Depth = 4
- Call Chain = USBD_Init

[Calls]

- >> USBD_IntrEna
- >> usbd_stm32_delay

[Called By]

- >> usbd_init

USBD_Connect (Thumb, 62 bytes, Stack size 0 bytes, usbd_stm32f4xx_fs.o(.text))

[Called By]

- >> usbd_connect

USBD_SetAddress (Thumb, 24 bytes, Stack size 0 bytes, usbd_stm32f4xx_fs.o(.text))

[Called By]

- >> USBD_EndPoint0
- >> USBD_Reset

USBD_Reset (Thumb, 192 bytes, Stack size 8 bytes, usbd_stm32f4xx_fs.o(.text))

[Stack]

- Max Depth = 8
- Call Chain = USBD_Reset

[Calls]

- >> USBD_SetAddress

[Called By]

- >> OTG_FS_IRQHandler

USBD_Suspend (Thumb, 2 bytes, Stack size 0 bytes, usbd_stm32f4xx_fs.o(.text))

[Called By]

- >> OTG_FS_IRQHandler

USBD_Resume (Thumb, 2 bytes, Stack size 0 bytes, usbd_stm32f4xx_fs.o(.text))

[Called By]

- >> OTG_FS_IRQHandler

USBD_WakeUp (Thumb, 34 bytes, Stack size 4 bytes, usbd_stm32f4xx_fs.o(.text), UNUSED)

[Calls]

- >> usbd_stm32_delay

USBD_WakeUpCfg (Thumb, 2 bytes, Stack size 0 bytes, usbd_stm32f4xx_fs.o(.text))

[Called By]

- >> USBD_ReqSetClrFeature

USBD_Configure (Thumb, 14 bytes, Stack size 0 bytes, usbd_stm32f4xx_fs.o(.text))

[Called By]

- >> USBD_ReqSetConfiguration

USBD_ConfigEP (Thumb, 250 bytes, Stack size 16 bytes, usbd_stm32f4xx_fs.o(.text))

[Stack]

- Max Depth = 16
- Call Chain = USBD_ConfigEP

[Called By]

- >> USBD_ReqSetInterface
- >> USBD_ReqSetConfiguration

USBD_DirCtrlEP (Thumb, 2 bytes, Stack size 0 bytes, usbd_stm32f4xx_fs.o(.text))

[Called By]

- >> USBD_EndPoint0

USBD_EnableEP (Thumb, 200 bytes, Stack size 0 bytes, usbd_stm32f4xx_fs.o(.text))

[Called By]

- >> USBD_ReqSetInterface
- >> USBD_ReqSetConfiguration

USBD_DisableEP (Thumb, 418 bytes, Stack size 16 bytes, usbd_stm32f4xx_fs.o(.text))

[Stack]

- Max Depth = 16
- Call Chain = USBD_DisableEP

[Called By]

- >> USBD_ReqSetInterface
- >> USBD_ReqSetConfiguration

USBD_GetFrame (Thumb, 12 bytes, Stack size 0 bytes, usbd_stm32f4xx_fs.o(.text))

[Called By]

- >> OTG_FS_IRQHandler
- >> USBD_WriteEP
- >> USBD_ResetEP

USBD_ResetEP (Thumb, 206 bytes, Stack size 8 bytes, usbd_stm32f4xx_fs.o(.text))

[Stack]

- Max Depth = 8
- Call Chain = USBD_ResetEP

[Calls]

- >> USBD_GetFrame
- >> USBD_FlushInEpFifo

[Called By]

- >> USBD_ReqSetInterface
- >> USBD_ReqSetConfiguration

USBD_SetStallEP (Thumb, 268 bytes, Stack size 16 bytes, usbd_stm32f4xx_fs.o(.text))

[Stack]

- Max Depth = 16
- Call Chain = USBD_SetStallEP

[Calls]

- >> USBD_FlushInEpFifo

[Called By]

- >> USBD_EndPoint0
- >> USBD_ReqSetClrFeature

USBD_ClrStallEP (Thumb, 186 bytes, Stack size 8 bytes, usbd_stm32f4xx_fs.o(.text))

[Stack]

- Max Depth = 8
- Call Chain = USBD_ClrStallEP

[Calls]

- >> USBD_FlushInEpFifo

[Called By]

- >> USBD_EndPoint0
- >> USBD_ReqSetClrFeature

USBD_ClearEPBuf (Thumb, 70 bytes, Stack size 8 bytes, usbd_stm32f4xx_fs.o(.text), UNUSED)

[Calls]

- >> USBD_FlushInEpFifo

USBD_ReadEP (Thumb, 200 bytes, Stack size 16 bytes, usbd_stm32f4xx_fs.o(.text))

[Stack]

- Max Depth = 16
- Call Chain = USBD_ReadEP

[Called By]

- >> OTG_FS_IRQHandler
- >> USBD_HID_EP_INTOUT_Event
- >> USBD_StatusOutStage
- >> USBD_DataOutStage
- >> USBD_SetupStage

USBD_WriteEP (Thumb, 368 bytes, Stack size 20 bytes, usbd_stm32f4xx_fs.o(.text))

[Stack]

- Max Depth = 20
- Call Chain = USBD_WriteEP

[Calls]

- >> USBD_GetFrame

[Called By]

- >> OTG_FS_IRQHandler
- >> USBD_HID_EP_INTIN_Event
- >> USBD_StatusInStage
- >> USBD_DataInStage

OTG_FS_IRQHandler (Thumb, 1660 bytes, Stack size 24 bytes, usbd_stm32f4xx_fs.o(.text))

[Stack]

- Max Depth = 44
- Call Chain = OTG_FS_IRQHandler ⇒ USBD_WriteEP

[Calls]

- >> usbd_reset_core
- >> USBD_WriteEP
- >> USBD_ReadEP
- >> USBD_GetFrame
- >> USBD_Resume
- >> USBD_Suspend
- >> USBD_Reset
- >> USBD_FlushInEpFifo

[Address Reference Count : 1]

- startup_stm32f4xx.o(RESET)

Flash_Init (Thumb, 370 bytes, Stack size 40 bytes, drv_w25qxx.o(.text))

[Stack]

- Max Depth = 80
- Call Chain = Flash_Init ⇒ Flash_ReadID ⇒ Flash_SendByte ⇒ SPI_I2S_SendData

[Calls]

- >> SPI_Init
- >> SPI_I2S_DeInit
- >> SPI_Cmd
- >> GPIO_WriteBit
- >> Flash_ReadID
- >> Flash_SendByte
- >> RCC_APB2PeriphClockCmd
- >> RCC_AHB1PeriphClockCmd
- >> GPIO_PinAFConfig
- >> GPIO_Init

[Called By]

- >> disk_initialize

Flash_SectorErase (Thumb, 66 bytes, Stack size 16 bytes, drv_w25qxx.o(.text))

[Stack]

- Max Depth = 48
- Call Chain = Flash_SectorErase ⇒ Flash_WaitForEnd ⇒ Flash_SendByte ⇒ SPI_I2S_SendData

[Calls]

- >> GPIO_WriteBit
- >> Flash_WaitForEnd
- >> Flash_WriteEnable
- >> Flash_SendByte

[Called By]

- >> Flash_SectorsWrite

Flash_PageWrite (Thumb, 84 bytes, Stack size 16 bytes, drv_w25qxx.o(.text))

[Stack]

- Max Depth = 48
- Call Chain = Flash_PageWrite ⇒ Flash_WaitForEnd ⇒ Flash_SendByte ⇒ SPI_I2S_SendData

[Calls]

- >> GPIO_WriteBit
- >> Flash_WaitForEnd
- >> Flash_WriteEnable
- >> Flash_SendByte

[Called By]

- >> Flash_SectorsWrite

Flash_PageRead (Thumb, 78 bytes, Stack size 16 bytes, drv_w25qxx.o(.text))

[Stack]

- Max Depth = 40
- Call Chain = Flash_PageRead ⇒ Flash_SendByte ⇒ SPI_I2S_SendData

[Calls]

- >> GPIO_WriteBit
- >> Flash_SendByte

[Called By]

- >> Flash_SectorsRead

Flash_SectorsRead (Thumb, 52 bytes, Stack size 24 bytes, drv_w25qxx.o(.text))

[Stack]

- Max Depth = 64
- Call Chain = Flash_SectorsRead ⇒ Flash_PageRead ⇒ Flash_SendByte ⇒ SPI_I2S_SendData

[Calls]

- >> Flash_PageRead

[Called By]

- >> disk_read

Flash_SectorsWrite (Thumb, 104 bytes, Stack size 24 bytes, drv_w25qxx.o(.text))

[Stack]

- Max Depth = 72
- Call Chain = Flash_SectorsWrite ⇒ Flash_PageWrite ⇒ Flash_WaitForEnd ⇒ Flash_SendByte ⇒ SPI_I2S_SendData

[Calls]

- >> Flash_PageWrite
- >> Flash_SectorErase
- >> Flash_WriteEnable

[Called By]

- >> disk_write

Flash_GetInfo (Thumb, 4 bytes, Stack size 0 bytes, drv_w25qxx.o(.text))

[Called By]

- >> disk_initialize

Ultrasonic_Init (Thumb, 12 bytes, Stack size 8 bytes, ultrasonic.o(.text))

[Stack]

- Max Depth = 116
- Call Chain = Ultrasonic_Init ⇒ Uart5_Init ⇒ USART_Init ⇒ RCC_GetClocksFreq

[Calls]

- >> Uart5_Init

[Called By]

- >> All_Init

Ultra_Duty (Thumb, 88 bytes, Stack size 8 bytes, ultrasonic.o(.text))

[Stack]

- Max Depth = 56
- Call Chain = Ultra_Duty ⇒ Uart5_Send ⇒ USART_ITConfig

[Calls]

- >> Uart5_Send

[Called By]

- >> Duty_50ms

Ultra_Get (Thumb, 140 bytes, Stack size 0 bytes, ultrasonic.o(.text))

[Called By]

- >> Uart5_IRQ

NVIC_PriorityGroupConfig (Thumb, 54 bytes, Stack size 8 bytes, misc.o(.text))

[Stack]

- Max Depth = 8
- Call Chain = NVIC_PriorityGroupConfig

[Calls]

- >> assert_failed

[Called By]

- >> All_Init

NVIC_Init (Thumb, 164 bytes, Stack size 24 bytes, misc.o(.text))

[Stack]

- Max Depth = 24
- Call Chain = NVIC_Init

[Calls]

- >> assert_failed

[Called By]

- >> Usart2_Init
- >> Usart1_Init
- >> PWM_IN_Init
- >> Uart5_Init
- >> TIM_NVIC

NVIC_SetVectorTable (Thumb, 60 bytes, Stack size 16 bytes, misc.o(.text), UNUSED)

[Calls]

- >> assert_failed

NVIC_SystemLPConfig (Thumb, 78 bytes, Stack size 16 bytes, misc.o(.text), UNUSED)

[Calls]

- >> assert_failed

SysTick_CLKSourceConfig (Thumb, 62 bytes, Stack size 8 bytes, misc.o(.text))

[Stack]

- Max Depth = 8
- Call Chain = SysTick_CLKSourceConfig

[Calls]

- >> assert_failed

[Called By]

- >> SysTick_Configuration

GPIO_DeInit (Thumb, 284 bytes, Stack size 8 bytes, stm32f4xx_gpio.o(.text), UNUSED)

[Calls]

- >> assert_failed
- >> RCC_AHB1PeriphResetCmd

GPIO_Init (Thumb, 342 bytes, Stack size 24 bytes, stm32f4xx_gpio.o(.text))

[Stack]

- Max Depth = 24
- Call Chain = GPIO_Init

[Calls]

- >> assert_failed

[Called By]

- >> Usart2_Init
- >> Usart1_Init
- >> PWM_Out_Init
- >> PWM_IN_Init
- >> LED_Init
- >> I2c_Soft_Init
- >> Flash_Init
- >> Uart5_Init
- >> MPU6050_INT_Config

GPIO_StructInit (Thumb, 18 bytes, Stack size 0 bytes, stm32f4xx_gpio.o(.text), UNUSED)

GPIO_PinLockConfig (Thumb, 122 bytes, Stack size 16 bytes, stm32f4xx_gpio.o(.text), UNUSED)

[Calls]

- >> assert_failed

GPIO_ReadInputDataBit (Thumb, 182 bytes, Stack size 16 bytes, stm32f4xx_gpio.o(.text), UNUSED)

[Calls]

- >> assert_failed

GPIO_ReadInputData (Thumb, 174 bytes, Stack size 8 bytes, stm32f4xx_gpio.o(.text), UNUSED)

[Calls]

- >> assert_failed

GPIO_ReadOutputDataBit (Thumb, 186 bytes, Stack size 16 bytes, stm32f4xx_gpio.o(.text), UNUSED)

[Calls]

- >> assert_failed

GPIO_ReadOutputData (Thumb, 78 bytes, Stack size 8 bytes, stm32f4xx_gpio.o(.text), UNUSED)

[Calls]

- >> assert_failed

GPIO_SetBits (Thumb, 98 bytes, Stack size 16 bytes, stm32f4xx_gpio.o(.text))

[Stack]

- Max Depth = 16
- Call Chain = GPIO_SetBits

[Calls]

- >> assert_failed

[Called By]

- >> LED_Init
- >> MPU6050_INT_Config

GPIO_ResetBits (Thumb, 98 bytes, Stack size 16 bytes, stm32f4xx_gpio.o(.text), UNUSED)

[Calls]

- >> assert_failed

GPIO_WriteBit (Thumb, 200 bytes, Stack size 16 bytes, stm32f4xx_gpio.o(.text))

[Stack]

- Max Depth = 16
- Call Chain = GPIO_WriteBit

[Calls]

- >> assert_failed

[Called By]

- >> Flash_PageRead
- >> Flash_PageWrite
- >> Flash_SectorErase
- >> Flash_Init
- >> Flash_WaitForEnd
- >> Flash_WriteEnable
- >> Flash_ReadID

GPIO_Write (Thumb, 78 bytes, Stack size 16 bytes, stm32f4xx_gpio.o(.text), UNUSED)

[Calls]

- >> assert_failed

GPIO_ToggleBits (Thumb, 82 bytes, Stack size 16 bytes, stm32f4xx_gpio.o(.text), UNUSED)

[Calls]

- >> assert_failed

GPIO_PinAFConfig (Thumb, 384 bytes, Stack size 24 bytes, stm32f4xx_gpio.o(.text))

[Stack]

- Max Depth = 24
- Call Chain = GPIO_PinAFConfig

[Calls]

- >> assert_failed

[Called By]

- >> Usart2_Init
- >> Usart1_Init
- >> PWM_Out_Init
- >> PWM_IN_Init
- >> Flash_Init
- >> Uart5_Init

RCC_DeInit (Thumb, 60 bytes, Stack size 0 bytes, stm32f4xx_rcc.o(.text), UNUSED)

RCC_HSEConfig (Thumb, 38 bytes, Stack size 8 bytes, stm32f4xx_rcc.o(.text), UNUSED)

[Calls]

- >> assert_failed

RCC_GetFlagStatus (Thumb, 130 bytes, Stack size 24 bytes, stm32f4xx_rcc.o(.text), UNUSED)

[Calls]

- >> assert_failed

[Called By]

- >> RCC_WaitForHSEStartUp

RCC_WaitForHSEStartUp (Thumb, 56 bytes, Stack size 16 bytes, stm32f4xx_rcc.o(.text), UNUSED)

[Calls]

- >> RCC_GetFlagStatus

RCC_AdjustHSICalibrationValue (Thumb, 38 bytes, Stack size 16 bytes, stm32f4xx_rcc.o(.text), UNUSED)

[Calls]

- >> assert_failed

RCC_HSICmd (Thumb, 28 bytes, Stack size 8 bytes, stm32f4xx_rcc.o(.text), UNUSED)

[Calls]

- >> assert_failed

RCC_LSEConfig (Thumb, 72 bytes, Stack size 8 bytes, stm32f4xx_rcc.o(.text), UNUSED)

[Calls]

- >> assert_failed

RCC_LSICmd (Thumb, 28 bytes, Stack size 8 bytes, stm32f4xx_rcc.o(.text), UNUSED)

[Calls]

- >> assert_failed

RCC_PLLConfig (Thumb, 156 bytes, Stack size 24 bytes, stm32f4xx_rcc.o(.text), UNUSED)

[Calls]

- >> assert_failed

RCC_PLLCmd (Thumb, 28 bytes, Stack size 8 bytes, stm32f4xx_rcc.o(.text), UNUSED)

[Calls]

- >> assert_failed

RCC_PLLI2SConfig (Thumb, 62 bytes, Stack size 16 bytes, stm32f4xx_rcc.o(.text), UNUSED)

[Calls]

- >> assert_failed

RCC_PLLI2SCmd (Thumb, 28 bytes, Stack size 8 bytes, stm32f4xx_rcc.o(.text), UNUSED)

[Calls]

- >> assert_failed

RCC_ClockSecuritySystemCmd (Thumb, 28 bytes, Stack size 8 bytes, stm32f4xx_rcc.o(.text), UNUSED)

[Calls]

- >> assert_failed

RCC_MCO1Config (Thumb, 102 bytes, Stack size 16 bytes, stm32f4xx_rcc.o(.text), UNUSED)

[Calls]

- >> assert_failed

RCC_MCO2Config (Thumb, 102 bytes, Stack size 16 bytes, stm32f4xx_rcc.o(.text), UNUSED)

[Calls]

- >> assert_failed

RCC_SYSCLKConfig (Thumb, 124 bytes, Stack size 16 bytes, stm32f4xx_rcc.o(.text), UNUSED)

[Calls]

- >> assert_failed

RCC_GetSYSCLKSource (Thumb, 10 bytes, Stack size 0 bytes, stm32f4xx_rcc.o(.text), UNUSED)

RCC_HCLKConfig (Thumb, 68 bytes, Stack size 16 bytes, stm32f4xx_rcc.o(.text), UNUSED)

[Calls]

- >> assert_failed

RCC_PCLK1Config (Thumb, 60 bytes, Stack size 16 bytes, stm32f4xx_rcc.o(.text), UNUSED)

[Calls]

- >> assert_failed

RCC_PCLK2Config (Thumb, 62 bytes, Stack size 16 bytes, stm32f4xx_rcc.o(.text), UNUSED)

[Calls]

- >> assert_failed

RCC_GetClocksFreq (Thumb, 214 bytes, Stack size 20 bytes, stm32f4xx_rcc.o(.text))

[Stack]

- Max Depth = 20
- Call Chain = RCC_GetClocksFreq

[Called By]

- >> SysTick_Configuration
- >> USART_Init

RCC_RTCCLKConfig (Thumb, 262 bytes, Stack size 16 bytes, stm32f4xx_rcc.o(.text), UNUSED)

[Calls]

- >> assert_failed

RCC_RTCCLKCmd (Thumb, 30 bytes, Stack size 8 bytes, stm32f4xx_rcc.o(.text), UNUSED)

[Calls]

- >> assert_failed

RCC_BackupResetCmd (Thumb, 32 bytes, Stack size 8 bytes, stm32f4xx_rcc.o(.text), UNUSED)

[Calls]

- >> assert_failed

RCC_I2SCLKConfig (Thumb, 30 bytes, Stack size 8 bytes, stm32f4xx_rcc.o(.text), UNUSED)

[Calls]

- >> assert_failed

RCC_AHB1PeriphClockCmd (Thumb, 82 bytes, Stack size 16 bytes, stm32f4xx_rcc.o(.text))

[Stack]

- Max Depth = 16
- Call Chain = RCC_AHB1PeriphClockCmd

[Calls]

- >> assert_failed

[Called By]

- >> Usart2_Init
- >> Usart1_Init
- >> PWM_Out_Init
- >> PWM_IN_Init
- >> LED_Init
- >> I2c_Soft_Init
- >> Flash_Init
- >> Uart5_Init
- >> MPU6050_INT_Config

RCC_AHB2PeriphClockCmd (Thumb, 82 bytes, Stack size 16 bytes, stm32f4xx_rcc.o(.text), UNUSED)

[Calls]

- >> assert_failed

RCC_AHB3PeriphClockCmd (Thumb, 232 bytes, Stack size 16 bytes, stm32f4xx_rcc.o(.text), UNUSED)

[Calls]

- >> assert_failed

RCC_APB1PeriphClockCmd (Thumb, 82 bytes, Stack size 16 bytes, stm32f4xx_rcc.o(.text))

[Stack]

- Max Depth = 16
- Call Chain = RCC_APB1PeriphClockCmd

[Calls]

- >> assert_failed

[Called By]

- >> Usart2_Init
- >> PWM_Out_Init
- >> PWM_IN_Init
- >> Uart5_Init
- >> TIM_INIT
- >> TIM_CONF

RCC_APB2PeriphClockCmd (Thumb, 82 bytes, Stack size 16 bytes, stm32f4xx_rcc.o(.text))

[Stack]

- Max Depth = 16
- Call Chain = RCC_APB2PeriphClockCmd

[Calls]

- >> assert_failed

[Called By]

- >> Usart1_Init
- >> PWM_Out_Init
- >> Flash_Init

RCC_AHB1PeriphResetCmd (Thumb, 82 bytes, Stack size 16 bytes, stm32f4xx_rcc.o(.text), UNUSED)

[Calls]

- >> assert_failed

[Called By]

- >> GPIO_DeInit

RCC_AHB2PeriphResetCmd (Thumb, 82 bytes, Stack size 16 bytes, stm32f4xx_rcc.o(.text), UNUSED)

[Calls]

- >> assert_failed

RCC_AHB3PeriphResetCmd (Thumb, 82 bytes, Stack size 16 bytes, stm32f4xx_rcc.o(.text), UNUSED)

[Calls]

- >> assert_failed

RCC_APB1PeriphResetCmd (Thumb, 82 bytes, Stack size 16 bytes, stm32f4xx_rcc.o(.text))

[Stack]

- Max Depth = 16
- Call Chain = RCC_APB1PeriphResetCmd

[Calls]

- >> assert_failed

[Called By]

- >> SPI_I2S_DeInit
- >> TIM_DeInit
- >> USART_DeInit

RCC_APB2PeriphResetCmd (Thumb, 82 bytes, Stack size 16 bytes, stm32f4xx_rcc.o(.text))

[Stack]

- Max Depth = 16
- Call Chain = RCC_APB2PeriphResetCmd

[Calls]

- >> assert_failed

[Called By]

- >> SPI_I2S_DeInit
- >> TIM_DeInit
- >> USART_DeInit

RCC_AHB1PeriphClockLPModeCmd (Thumb, 82 bytes, Stack size 16 bytes, stm32f4xx_rcc.o(.text), UNUSED)

[Calls]

- >> assert_failed

RCC_AHB2PeriphClockLPModeCmd (Thumb, 82 bytes, Stack size 16 bytes, stm32f4xx_rcc.o(.text), UNUSED)

[Calls]

- >> assert_failed

RCC_AHB3PeriphClockLPModeCmd (Thumb, 82 bytes, Stack size 16 bytes, stm32f4xx_rcc.o(.text), UNUSED)

[Calls]

- >> assert_failed

RCC_APB1PeriphClockLPModeCmd (Thumb, 82 bytes, Stack size 16 bytes, stm32f4xx_rcc.o(.text), UNUSED)

[Calls]

- >> assert_failed

RCC_APB2PeriphClockLPModeCmd (Thumb, 106 bytes, Stack size 16 bytes, stm32f4xx_rcc.o(.text), UNUSED)

[Calls]

- >> assert_failed

RCC_ITConfig (Thumb, 74 bytes, Stack size 16 bytes, stm32f4xx_rcc.o(.text), UNUSED)

[Calls]

- >> assert_failed

RCC_ClearFlag (Thumb, 18 bytes, Stack size 0 bytes, stm32f4xx_rcc.o(.text), UNUSED)

RCC_GetITStatus (Thumb, 68 bytes, Stack size 16 bytes, stm32f4xx_rcc.o(.text), UNUSED)

[Calls]

- >> assert_failed

RCC_ClearITPendingBit (Thumb, 34 bytes, Stack size 8 bytes, stm32f4xx_rcc.o(.text), UNUSED)

[Calls]

- >> assert_failed

SPI_I2S_DeInit (Thumb, 104 bytes, Stack size 8 bytes, stm32f4xx_spi.o(.text))

[Stack]

- Max Depth = 24
- Call Chain = SPI_I2S_DeInit ⇒ RCC_APB1PeriphResetCmd

[Calls]

- >> assert_failed
- >> RCC_APB1PeriphResetCmd
- >> RCC_APB2PeriphResetCmd

[Called By]

- >> Flash_Init

SPI_Init (Thumb, 348 bytes, Stack size 16 bytes, stm32f4xx_spi.o(.text))

[Stack]

- Max Depth = 16
- Call Chain = SPI_Init

[Calls]

- >> assert_failed

[Called By]

- >> Flash_Init

I2S_Init (Thumb, 508 bytes, Stack size 48 bytes, stm32f4xx_spi.o(.text), UNUSED)

[Calls]

- >> assert_failed

SPI_StructInit (Thumb, 24 bytes, Stack size 0 bytes, stm32f4xx_spi.o(.text), UNUSED)

I2S_StructInit (Thumb, 104 bytes, Stack size 0 bytes, stm32f4xx_spi.o(.text), UNUSED)

SPI_Cmd (Thumb, 82 bytes, Stack size 16 bytes, stm32f4xx_spi.o(.text))

[Stack]

- Max Depth = 16
- Call Chain = SPI_Cmd

[Calls]

- >> assert_failed

[Called By]

- >> Flash_Init

I2S_Cmd (Thumb, 88 bytes, Stack size 16 bytes, stm32f4xx_spi.o(.text), UNUSED)

[Calls]

- >> assert_failed

SPI_DataSizeConfig (Thumb, 78 bytes, Stack size 16 bytes, stm32f4xx_spi.o(.text), UNUSED)

[Calls]

- >> assert_failed

SPI_BiDirectionalLineConfig (Thumb, 94 bytes, Stack size 16 bytes, stm32f4xx_spi.o(.text), UNUSED)

[Calls]

- >> assert_failed

SPI_NSSInternalSoftwareConfig (Thumb, 96 bytes, Stack size 16 bytes, stm32f4xx_spi.o(.text), UNUSED)

[Calls]

- >> assert_failed

SPI_SSOutputCmd (Thumb, 82 bytes, Stack size 16 bytes, stm32f4xx_spi.o(.text), UNUSED)

[Calls]

- >> assert_failed

SPI_TIModeCmd (Thumb, 82 bytes, Stack size 16 bytes, stm32f4xx_spi.o(.text), UNUSED)

[Calls]

- >> assert_failed

I2S_FullDuplexConfig (Thumb, 258 bytes, Stack size 24 bytes, stm32f4xx_spi.o(.text), UNUSED)

[Calls]

- >> assert_failed

SPI_I2S_ReceiveData (Thumb, 52 bytes, Stack size 8 bytes, stm32f4xx_spi.o(.text))

[Stack]

- Max Depth = 8
- Call Chain = SPI_I2S_ReceiveData

[Calls]

- >> assert_failed

[Called By]

- >> Flash_SendByte

SPI_I2S_SendData (Thumb, 54 bytes, Stack size 16 bytes, stm32f4xx_spi.o(.text))

[Stack]

- Max Depth = 16
- Call Chain = SPI_I2S_SendData

[Calls]

- >> assert_failed

[Called By]

- >> Flash_SendByte

SPI_CalculateCRC (Thumb, 98 bytes, Stack size 16 bytes, stm32f4xx_spi.o(.text), UNUSED)

[Calls]

- >> assert_failed

SPI_TransmitCRC (Thumb, 46 bytes, Stack size 8 bytes, stm32f4xx_spi.o(.text), UNUSED)

[Calls]

- >> assert_failed

SPI_GetCRC (Thumb, 74 bytes, Stack size 16 bytes, stm32f4xx_spi.o(.text), UNUSED)

[Calls]

- >> assert_failed

SPI_GetCRCPolynomial (Thumb, 40 bytes, Stack size 8 bytes, stm32f4xx_spi.o(.text), UNUSED)

[Calls]

- >> assert_failed

SPI_I2S_DMACmd (Thumb, 114 bytes, Stack size 16 bytes, stm32f4xx_spi.o(.text), UNUSED)

[Calls]

- >> assert_failed

SPI_I2S_ITConfig (Thumb, 138 bytes, Stack size 24 bytes, stm32f4xx_spi.o(.text), UNUSED)

[Calls]

- >> assert_failed

SPI_I2S_GetFlagStatus (Thumb, 120 bytes, Stack size 16 bytes, stm32f4xx_spi.o(.text))

[Stack]

- Max Depth = 16
- Call Chain = SPI_I2S_GetFlagStatus

[Calls]

- >> assert_failed

[Called By]

- >> Flash_SendByte

SPI_I2S_ClearFlag (Thumb, 74 bytes, Stack size 16 bytes, stm32f4xx_spi.o(.text), UNUSED)

[Calls]

- >> assert_failed

SPI_I2S_GetITStatus (Thumb, 154 bytes, Stack size 32 bytes, stm32f4xx_spi.o(.text), UNUSED)

[Calls]

- >> assert_failed

SPI_I2S_ClearITPendingBit (Thumb, 86 bytes, Stack size 16 bytes, stm32f4xx_spi.o(.text), UNUSED)

[Calls]

- >> assert_failed

TIM_DeInit (Thumb, 440 bytes, Stack size 8 bytes, stm32f4xx_tim.o(.text), UNUSED)

[Calls]

- >> assert_failed
- >> RCC_APB1PeriphResetCmd
- >> RCC_APB2PeriphResetCmd

[Called By]

- >> TIM_CONF

TIM_TimeBaseInit (Thumb, 278 bytes, Stack size 16 bytes, stm32f4xx_tim.o(.text))

[Stack]

- Max Depth = 16
- Call Chain = TIM_TimeBaseInit

[Calls]

- >> assert_failed

[Called By]

- >> PWM_Out_Init
- >> TIM_CONF

TIM_TimeBaseStructInit (Thumb, 18 bytes, Stack size 0 bytes, stm32f4xx_tim.o(.text))

[Called By]

- >> PWM_Out_Init

TIM_PrescalerConfig (Thumb, 128 bytes, Stack size 16 bytes, stm32f4xx_tim.o(.text), UNUSED)

[Calls]

- >> assert_failed

TIM_CounterModeConfig (Thumb, 100 bytes, Stack size 16 bytes, stm32f4xx_tim.o(.text), UNUSED)

[Calls]

- >> assert_failed

TIM_SetCounter (Thumb, 222 bytes, Stack size 16 bytes, stm32f4xx_tim.o(.text), UNUSED)

[Calls]

- >> assert_failed

TIM_SetAutoreload (Thumb, 108 bytes, Stack size 16 bytes, stm32f4xx_tim.o(.text), UNUSED)

[Calls]

- >> assert_failed

TIM_GetCounter (Thumb, 106 bytes, Stack size 8 bytes, stm32f4xx_tim.o(.text), UNUSED)

[Calls]

- >> assert_failed

TIM_GetPrescaler (Thumb, 106 bytes, Stack size 8 bytes, stm32f4xx_tim.o(.text), UNUSED)

[Calls]

- >> assert_failed

TIM_UpdateDisableConfig (Thumb, 148 bytes, Stack size 16 bytes, stm32f4xx_tim.o(.text), UNUSED)

[Calls]

- >> assert_failed

TIM_UpdateRequestConfig (Thumb, 148 bytes, Stack size 16 bytes, stm32f4xx_tim.o(.text), UNUSED)

[Calls]

- >> assert_failed

TIM_ARRPreloadConfig (Thumb, 148 bytes, Stack size 16 bytes, stm32f4xx_tim.o(.text))

[Stack]

- Max Depth = 16
- Call Chain = TIM_ARRPreloadConfig

[Calls]

- >> assert_failed

[Called By]

- >> PWM_Out_Init

TIM_SelectOnePulseMode (Thumb, 142 bytes, Stack size 16 bytes, stm32f4xx_tim.o(.text), UNUSED)

[Calls]

- >> assert_failed

TIM_SetClockDivision (Thumb, 192 bytes, Stack size 16 bytes, stm32f4xx_tim.o(.text), UNUSED)

[Calls]

- >> assert_failed

TIM_Cmd (Thumb, 148 bytes, Stack size 16 bytes, stm32f4xx_tim.o(.text))

[Stack]

- Max Depth = 16
- Call Chain = TIM_Cmd

[Calls]

- >> assert_failed

[Called By]

- >> PWM_Out_Init
- >> PWM_IN_Init
- >> TIM_CONF

TIM_OC1Init (Thumb, 416 bytes, Stack size 24 bytes, stm32f4xx_tim.o(.text))

[Stack]

- Max Depth = 24
- Call Chain = TIM_OC1Init

[Calls]

- >> assert_failed

[Called By]

- >> PWM_Out_Init

TIM_OC2Init (Thumb, 486 bytes, Stack size 24 bytes, stm32f4xx_tim.o(.text))

[Stack]

- Max Depth = 24
- Call Chain = TIM_OC2Init

[Calls]

- >> assert_failed

[Called By]

- >> PWM_Out_Init

TIM_OC3Init (Thumb, 416 bytes, Stack size 24 bytes, stm32f4xx_tim.o(.text))

[Stack]

- Max Depth = 24
- Call Chain = TIM_OC3Init

[Calls]

- >> assert_failed

[Called By]

- >> PWM_Out_Init
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

[Stack]

- Max Depth = 16
- Call Chain = TIM_ITConfig

[Calls]

- >> assert_failed

[Called By]

- >> PWM_IN_Init
- >> TIM_CONF

TIM_GenerateEvent (Thumb, 126 bytes, Stack size 16 bytes, stm32f4xx_tim.o(.text), UNUSED)

[Calls]

- >> assert_failed

TIM_GetFlagStatus (Thumb, 188 bytes, Stack size 16 bytes, stm32f4xx_tim.o(.text), UNUSED)

[Calls]

- >> assert_failed

TIM_ClearFlag (Thumb, 108 bytes, Stack size 16 bytes, stm32f4xx_tim.o(.text), UNUSED)

[Calls]

- >> assert_failed

[Called By]

- >> TIM_CONF

TIM_GetITStatus (Thumb, 186 bytes, Stack size 24 bytes, stm32f4xx_tim.o(.text), UNUSED)

[Calls]

- >> assert_failed

TIM_ClearITPendingBit (Thumb, 108 bytes, Stack size 16 bytes, stm32f4xx_tim.o(.text), UNUSED)

[Calls]

- >> assert_failed

TIM_DMAConfig (Thumb, 334 bytes, Stack size 16 bytes, stm32f4xx_tim.o(.text), UNUSED)

[Calls]

- >> assert_failed

TIM_DMACmd (Thumb, 126 bytes, Stack size 16 bytes, stm32f4xx_tim.o(.text), UNUSED)

[Calls]

- >> assert_failed

TIM_SelectCCDMA (Thumb, 96 bytes, Stack size 16 bytes, stm32f4xx_tim.o(.text), UNUSED)

[Calls]

- >> assert_failed

TIM_InternalClockConfig (Thumb, 76 bytes, Stack size 8 bytes, stm32f4xx_tim.o(.text), UNUSED)

[Calls]

- >> assert_failed

TIM_SelectInputTrigger (Thumb, 148 bytes, Stack size 16 bytes, stm32f4xx_tim.o(.text), UNUSED)

[Calls]

- >> assert_failed

[Called By]

- >> TIM_TIxExternalClockConfig
- >> TIM_ITRxExternalClockConfig

TIM_ITRxExternalClockConfig (Thumb, 110 bytes, Stack size 16 bytes, stm32f4xx_tim.o(.text), UNUSED)

[Calls]

- >> assert_failed
- >> TIM_SelectInputTrigger

TIM_TIxExternalClockConfig (Thumb, 184 bytes, Stack size 24 bytes, stm32f4xx_tim.o(.text), UNUSED)

[Calls]

- >> assert_failed
- >> TIM_SelectInputTrigger
- >> TI1_Config
- >> TI2_Config

TIM_ETRConfig (Thumb, 164 bytes, Stack size 24 bytes, stm32f4xx_tim.o(.text), UNUSED)

[Calls]

- >> assert_failed

[Called By]

- >> TIM_ETRClockMode2Config
- >> TIM_ETRClockMode1Config

TIM_ETRClockMode1Config (Thumb, 228 bytes, Stack size 24 bytes, stm32f4xx_tim.o(.text), UNUSED)

[Calls]

- >> assert_failed
- >> TIM_ETRConfig

TIM_ETRClockMode2Config (Thumb, 152 bytes, Stack size 24 bytes, stm32f4xx_tim.o(.text), UNUSED)

[Calls]

- >> assert_failed
- >> TIM_ETRConfig

TIM_SelectOutputTrigger (Thumb, 126 bytes, Stack size 16 bytes, stm32f4xx_tim.o(.text), UNUSED)

[Calls]

- >> assert_failed

TIM_SelectSlaveMode (Thumb, 112 bytes, Stack size 16 bytes, stm32f4xx_tim.o(.text), UNUSED)

[Calls]

- >> assert_failed

TIM_SelectMasterSlaveMode (Thumb, 102 bytes, Stack size 16 bytes, stm32f4xx_tim.o(.text), UNUSED)

[Calls]

- >> assert_failed

TIM_EncoderInterfaceConfig (Thumb, 226 bytes, Stack size 32 bytes, stm32f4xx_tim.o(.text), UNUSED)

[Calls]

- >> assert_failed

TIM_SelectHallSensor (Thumb, 108 bytes, Stack size 16 bytes, stm32f4xx_tim.o(.text), UNUSED)

[Calls]

- >> assert_failed

TIM_RemapConfig (Thumb, 138 bytes, Stack size 16 bytes, stm32f4xx_tim.o(.text), UNUSED)

[Calls]

- >> assert_failed

USART_DeInit (Thumb, 202 bytes, Stack size 8 bytes, stm32f4xx_usart.o(.text), UNUSED)

[Calls]

- >> assert_failed
- >> RCC_APB1PeriphResetCmd
- >> RCC_APB2PeriphResetCmd

USART_Init (Thumb, 456 bytes, Stack size 48 bytes, stm32f4xx_usart.o(.text))

[Stack]

- Max Depth = 68
- Call Chain = USART_Init ⇒ RCC_GetClocksFreq

[Calls]

- >> assert_failed
- >> RCC_GetClocksFreq

[Called By]

- >> Usart2_Init
- >> Usart1_Init
- >> Uart5_Init

USART_StructInit (Thumb, 24 bytes, Stack size 0 bytes, stm32f4xx_usart.o(.text), UNUSED)

USART_ClockInit (Thumb, 166 bytes, Stack size 16 bytes, stm32f4xx_usart.o(.text))

[Stack]

- Max Depth = 16
- Call Chain = USART_ClockInit

[Calls]

- >> assert_failed

[Called By]

- >> Usart2_Init

USART_ClockStructInit (Thumb, 12 bytes, Stack size 0 bytes, stm32f4xx_usart.o(.text), UNUSED)

USART_Cmd (Thumb, 96 bytes, Stack size 16 bytes, stm32f4xx_usart.o(.text))

[Stack]

- Max Depth = 16
- Call Chain = USART_Cmd

[Calls]

- >> assert_failed

[Called By]

- >> Usart2_Init
- >> Usart1_Init
- >> Uart5_Init

USART_SetPrescaler (Thumb, 160 bytes, Stack size 16 bytes, stm32f4xx_usart.o(.text), UNUSED)

[Calls]

- >> assert_failed

USART_OverSampling8Cmd (Thumb, 98 bytes, Stack size 16 bytes, stm32f4xx_usart.o(.text), UNUSED)

[Calls]

- >> assert_failed

USART_OneBitMethodCmd (Thumb, 100 bytes, Stack size 16 bytes, stm32f4xx_usart.o(.text), UNUSED)

[Calls]

- >> assert_failed

USART_SendData (Thumb, 84 bytes, Stack size 16 bytes, stm32f4xx_usart.o(.text), UNUSED)

[Calls]

- >> assert_failed

USART_ReceiveData (Thumb, 62 bytes, Stack size 8 bytes, stm32f4xx_usart.o(.text))

[Stack]

- Max Depth = 8
- Call Chain = USART_ReceiveData

[Calls]

- >> assert_failed

[Called By]

- >> USART1_IRQHandler

USART_SetAddress (Thumb, 92 bytes, Stack size 16 bytes, stm32f4xx_usart.o(.text), UNUSED)

[Calls]

- >> assert_failed

USART_ReceiverWakeUpCmd (Thumb, 100 bytes, Stack size 16 bytes, stm32f4xx_usart.o(.text), UNUSED)

[Calls]

- >> assert_failed

USART_WakeUpConfig (Thumb, 96 bytes, Stack size 16 bytes, stm32f4xx_usart.o(.text), UNUSED)

[Calls]

- >> assert_failed

USART_LINBreakDetectLengthConfig (Thumb, 94 bytes, Stack size 16 bytes, stm32f4xx_usart.o(.text), UNUSED)

[Calls]

- >> assert_failed

USART_LINCmd (Thumb, 100 bytes, Stack size 16 bytes, stm32f4xx_usart.o(.text), UNUSED)

[Calls]

- >> assert_failed

USART_SendBreak (Thumb, 64 bytes, Stack size 8 bytes, stm32f4xx_usart.o(.text), UNUSED)

[Calls]

- >> assert_failed

USART_HalfDuplexCmd (Thumb, 100 bytes, Stack size 16 bytes, stm32f4xx_usart.o(.text), UNUSED)

[Calls]

- >> assert_failed

USART_SetGuardTime (Thumb, 86 bytes, Stack size 16 bytes, stm32f4xx_usart.o(.text), UNUSED)

[Calls]

- >> assert_failed

USART_SmartCardCmd (Thumb, 88 bytes, Stack size 16 bytes, stm32f4xx_usart.o(.text), UNUSED)

[Calls]

- >> assert_failed

USART_SmartCardNACKCmd (Thumb, 88 bytes, Stack size 16 bytes, stm32f4xx_usart.o(.text), UNUSED)

[Calls]

- >> assert_failed

USART_IrDAConfig (Thumb, 94 bytes, Stack size 16 bytes, stm32f4xx_usart.o(.text), UNUSED)

[Calls]

- >> assert_failed

USART_IrDACmd (Thumb, 100 bytes, Stack size 16 bytes, stm32f4xx_usart.o(.text), UNUSED)

[Calls]

- >> assert_failed

USART_DMACmd (Thumb, 120 bytes, Stack size 16 bytes, stm32f4xx_usart.o(.text), UNUSED)

[Calls]

- >> assert_failed

USART_ITConfig (Thumb, 268 bytes, Stack size 32 bytes, stm32f4xx_usart.o(.text))

[Stack]

- Max Depth = 32
- Call Chain = USART_ITConfig

[Calls]

- >> assert_failed

[Called By]

- >> Usart2_Send
- >> Usart2_Init
- >> Usart1_Init
- >> Uart5_Send
- >> Uart5_Init

USART_GetFlagStatus (Thumb, 176 bytes, Stack size 16 bytes, stm32f4xx_usart.o(.text), UNUSED)

[Calls]

- >> assert_failed

USART_ClearFlag (Thumb, 160 bytes, Stack size 16 bytes, stm32f4xx_usart.o(.text), UNUSED)

[Calls]

- >> assert_failed

USART_GetITStatus (Thumb, 284 bytes, Stack size 32 bytes, stm32f4xx_usart.o(.text))

[Stack]

- Max Depth = 32
- Call Chain = USART_GetITStatus

[Calls]

- >> assert_failed

[Called By]

- >> Usart2_IRQ
- >> Uart5_IRQ
- >> USART1_IRQHandler

USART_ClearITPendingBit (Thumb, 170 bytes, Stack size 24 bytes, stm32f4xx_usart.o(.text))

[Stack]

- Max Depth = 24
- Call Chain = USART_ClearITPendingBit

[Calls]

- >> assert_failed

[Called By]

- >> Usart2_IRQ
- >> Uart5_IRQ
- >> USART1_IRQHandler

SystemInit (Thumb, 88 bytes, Stack size 8 bytes, system_stm32f4xx.o(.text))

[Stack]

- Max Depth = 20
- Call Chain = SystemInit ⇒ SetSysClock

[Calls]

- >> SetSysClock

[Address Reference Count : 1]

- startup_stm32f4xx.o(.text)

SystemCoreClockUpdate (Thumb, 174 bytes, Stack size 16 bytes, system_stm32f4xx.o(.text), UNUSED)

Reset_Handler (Thumb, 8 bytes, Stack size 0 bytes, startup_stm32f4xx.o(.text))
[Address Reference Count : 1]

- startup_stm32f4xx.o(RESET)

HardFault_Handler (Thumb, 2 bytes, Stack size 0 bytes, startup_stm32f4xx.o(.text))

[Calls]

- >> HardFault_Handler

[Called By]

- >> HardFault_Handler

[Address Reference Count : 1]

- startup_stm32f4xx.o(RESET)

PendSV_Handler (Thumb, 2 bytes, Stack size 0 bytes, startup_stm32f4xx.o(.text))

[Calls]

- >> PendSV_Handler

[Called By]

- >> PendSV_Handler

[Address Reference Count : 1]

- startup_stm32f4xx.o(RESET)

ADC_IRQHandler (Thumb, 0 bytes, Stack size 0 bytes, startup_stm32f4xx.o(.text))

[Calls]

- >> ADC_IRQHandler

[Called By]

- >> ADC_IRQHandler

[Address Reference Count : 1]

- startup_stm32f4xx.o(RESET)

CAN1_RX0_IRQHandler (Thumb, 0 bytes, Stack size 0 bytes, startup_stm32f4xx.o(.text))
[Address Reference Count : 1]

- startup_stm32f4xx.o(RESET)

CAN1_RX1_IRQHandler (Thumb, 0 bytes, Stack size 0 bytes, startup_stm32f4xx.o(.text))
[Address Reference Count : 1]

- startup_stm32f4xx.o(RESET)

CAN1_SCE_IRQHandler (Thumb, 0 bytes, Stack size 0 bytes, startup_stm32f4xx.o(.text))
[Address Reference Count : 1]

- startup_stm32f4xx.o(RESET)

CAN1_TX_IRQHandler (Thumb, 0 bytes, Stack size 0 bytes, startup_stm32f4xx.o(.text))
[Address Reference Count : 1]

- startup_stm32f4xx.o(RESET)

CAN2_RX0_IRQHandler (Thumb, 0 bytes, Stack size 0 bytes, startup_stm32f4xx.o(.text))
[Address Reference Count : 1]

- startup_stm32f4xx.o(RESET)

CAN2_RX1_IRQHandler (Thumb, 0 bytes, Stack size 0 bytes, startup_stm32f4xx.o(.text))
[Address Reference Count : 1]

- startup_stm32f4xx.o(RESET)

CAN2_SCE_IRQHandler (Thumb, 0 bytes, Stack size 0 bytes, startup_stm32f4xx.o(.text))
[Address Reference Count : 1]

- startup_stm32f4xx.o(RESET)

CAN2_TX_IRQHandler (Thumb, 0 bytes, Stack size 0 bytes, startup_stm32f4xx.o(.text))
[Address Reference Count : 1]

- startup_stm32f4xx.o(RESET)

CRYP_IRQHandler (Thumb, 0 bytes, Stack size 0 bytes, startup_stm32f4xx.o(.text))
[Address Reference Count : 1]

- startup_stm32f4xx.o(RESET)

DCMI_IRQHandler (Thumb, 0 bytes, Stack size 0 bytes, startup_stm32f4xx.o(.text))
[Address Reference Count : 1]

- startup_stm32f4xx.o(RESET)

DMA1_Stream0_IRQHandler (Thumb, 0 bytes, Stack size 0 bytes, startup_stm32f4xx.o(.text))
[Address Reference Count : 1]

- startup_stm32f4xx.o(RESET)

DMA1_Stream1_IRQHandler (Thumb, 0 bytes, Stack size 0 bytes, startup_stm32f4xx.o(.text))
[Address Reference Count : 1]

- startup_stm32f4xx.o(RESET)

DMA1_Stream2_IRQHandler (Thumb, 0 bytes, Stack size 0 bytes, startup_stm32f4xx.o(.text))
[Address Reference Count : 1]

- startup_stm32f4xx.o(RESET)

DMA1_Stream3_IRQHandler (Thumb, 0 bytes, Stack size 0 bytes, startup_stm32f4xx.o(.text))
[Address Reference Count : 1]

- startup_stm32f4xx.o(RESET)

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

TIM1_UP_TIM10_IRQHandler (Thumb, 0 bytes, Stack size 0 bytes, startup_stm32f4xx.o(.text))
[Address Reference Count : 1]

- startup_stm32f4xx.o(RESET)

TIM2_IRQHandler (Thumb, 0 bytes, Stack size 0 bytes, startup_stm32f4xx.o(.text))
[Address Reference Count : 1]

- startup_stm32f4xx.o(RESET)

TIM5_IRQHandler (Thumb, 0 bytes, Stack size 0 bytes, startup_stm32f4xx.o(.text))
[Address Reference Count : 1]

- startup_stm32f4xx.o(RESET)

TIM6_DAC_IRQHandler (Thumb, 0 bytes, Stack size 0 bytes, startup_stm32f4xx.o(.text))
[Address Reference Count : 1]

- startup_stm32f4xx.o(RESET)

TIM7_IRQHandler (Thumb, 0 bytes, Stack size 0 bytes, startup_stm32f4xx.o(.text))
[Address Reference Count : 1]

- startup_stm32f4xx.o(RESET)

TIM8_BRK_TIM12_IRQHandler (Thumb, 0 bytes, Stack size 0 bytes, startup_stm32f4xx.o(.text))
[Address Reference Count : 1]

- startup_stm32f4xx.o(RESET)

TIM8_CC_IRQHandler (Thumb, 0 bytes, Stack size 0 bytes, startup_stm32f4xx.o(.text))
[Address Reference Count : 1]

- startup_stm32f4xx.o(RESET)

TIM8_TRG_COM_TIM14_IRQHandler (Thumb, 0 bytes, Stack size 0 bytes, startup_stm32f4xx.o(.text))
[Address Reference Count : 1]

- startup_stm32f4xx.o(RESET)

TIM8_UP_TIM13_IRQHandler (Thumb, 0 bytes, Stack size 0 bytes, startup_stm32f4xx.o(.text))
[Address Reference Count : 1]

- startup_stm32f4xx.o(RESET)

UART4_IRQHandler (Thumb, 0 bytes, Stack size 0 bytes, startup_stm32f4xx.o(.text))
[Address Reference Count : 1]

- startup_stm32f4xx.o(RESET)

USART3_IRQHandler (Thumb, 0 bytes, Stack size 0 bytes, startup_stm32f4xx.o(.text))
[Address Reference Count : 1]

- startup_stm32f4xx.o(RESET)

USART6_IRQHandler (Thumb, 0 bytes, Stack size 0 bytes, startup_stm32f4xx.o(.text))
[Address Reference Count : 1]

- startup_stm32f4xx.o(RESET)

WWDG_IRQHandler (Thumb, 0 bytes, Stack size 0 bytes, startup_stm32f4xx.o(.text))
[Address Reference Count : 1]

- startup_stm32f4xx.o(RESET)

usbd_init (Thumb, 22 bytes, Stack size 8 bytes, usbd_core.o(.text))

[Stack]

- Max Depth = 12
- Call Chain = usbd_init ⇒ USBD_Init

[Calls]

- >> USBD_RTX_TaskInit
- >> usbd_class_init
- >> USBD_Init

[Called By]

- >> Usb_Hid_Init

usbd_connect (Thumb, 12 bytes, Stack size 8 bytes, usbd_core.o(.text))

[Stack]

- Max Depth = 8
- Call Chain = usbd_connect

[Calls]

- >> USBD_Connect

[Called By]

- >> Usb_Hid_Init

usbd_reset_core (Thumb, 38 bytes, Stack size 0 bytes, usbd_core.o(.text))

[Called By]

- >> OTG_FS_IRQHandler

usbd_configured (Thumb, 14 bytes, Stack size 0 bytes, usbd_core.o(.text), UNUSED)

USBD_SetupStage (Thumb, 12 bytes, Stack size 8 bytes, usbd_core.o(.text))

[Stack]

- Max Depth = 24
- Call Chain = USBD_SetupStage ⇒ USBD_ReadEP

[Calls]

- >> USBD_ReadEP

[Called By]

- >> USBD_EndPoint0

USBD_DataInStage (Thumb, 66 bytes, Stack size 8 bytes, usbd_core.o(.text))

[Stack]

- Max Depth = 28
- Call Chain = USBD_DataInStage ⇒ USBD_WriteEP

[Calls]

- >> USBD_WriteEP

[Called By]

- >> USBD_EndPoint0
- >> USBD_EndPoint0_Setup_HID_ReqToIF

USBD_DataOutStage (Thumb, 34 bytes, Stack size 8 bytes, usbd_core.o(.text))

[Stack]

- Max Depth = 24
- Call Chain = USBD_DataOutStage ⇒ USBD_ReadEP

[Calls]

- >> USBD_ReadEP

[Called By]

- >> USBD_EndPoint0

USBD_StatusInStage (Thumb, 14 bytes, Stack size 8 bytes, usbd_core.o(.text))

[Stack]

- Max Depth = 28
- Call Chain = USBD_StatusInStage ⇒ USBD_WriteEP

[Calls]

- >> USBD_WriteEP

[Called By]

- >> USBD_EndPoint0
- >> USBD_EndPoint0_Setup_HID_ReqToIF
- >> USBD_EndPoint0_Out_HID_ReqToIF

USBD_StatusOutStage (Thumb, 12 bytes, Stack size 8 bytes, usbd_core.o(.text))

[Stack]

- Max Depth = 24
- Call Chain = USBD_StatusOutStage ⇒ USBD_ReadEP

[Calls]

- >> USBD_ReadEP

[Called By]

- >> USBD_EndPoint0

USBD_ReqGetStatus (Thumb, 160 bytes, Stack size 0 bytes, usbd_core.o(.text))

[Called By]

- >> USBD_EndPoint0

USBD_ReqSetClrFeature (Thumb, 216 bytes, Stack size 16 bytes, usbd_core.o(.text))

[Stack]

- Max Depth = 32
- Call Chain = USBD_ReqSetClrFeature ⇒ USBD_SetStallEP

[Calls]

- >> USBD_ReqClrFeature_MSC
- >> USBD_ClrStallEP
- >> USBD_SetStallEP
- >> USBD_WakeUpCfg

[Called By]

- >> USBD_EndPoint0

USBD_ReqGetDescriptor (Thumb, 496 bytes, Stack size 16 bytes, usbd_core.o(.text))

[Stack]

- Max Depth = 24
- Call Chain = USBD_ReqGetDescriptor ⇒ get_len_string_interface

[Calls]

- >> get_uid_string_interface
- >> get_len_string_interface
- >> USBD_ReqGetDescriptor_HID

[Called By]

- >> USBD_EndPoint0

USBD_ReqGetConfiguration (Thumb, 28 bytes, Stack size 0 bytes, usbd_core.o(.text))

[Called By]

- >> USBD_EndPoint0

USBD_ReqSetConfiguration (Thumb, 432 bytes, Stack size 24 bytes, usbd_core.o(.text))

[Stack]

- Max Depth = 40
- Call Chain = USBD_ReqSetConfiguration ⇒ USBD_DisableEP

[Calls]

- >> USBD_ResetEP
- >> USBD_DisableEP
- >> USBD_EnableEP
- >> USBD_ConfigEP
- >> USBD_Configure

[Called By]

- >> USBD_EndPoint0

USBD_ReqGetInterface (Thumb, 60 bytes, Stack size 0 bytes, usbd_core.o(.text))

[Called By]

- >> USBD_EndPoint0

USBD_ReqSetInterface (Thumb, 308 bytes, Stack size 40 bytes, usbd_core.o(.text))

[Stack]

- Max Depth = 56
- Call Chain = USBD_ReqSetInterface ⇒ USBD_DisableEP

[Calls]

- >> USBD_ResetEP
- >> USBD_DisableEP
- >> USBD_EnableEP
- >> USBD_ConfigEP

[Called By]

- >> USBD_EndPoint0

USBD_EndPoint0 (Thumb, 682 bytes, Stack size 8 bytes, usbd_core.o(.text))

[Stack]

- Max Depth = 504
- Call Chain = USBD_EndPoint0 ⇒ USBD_EndPoint0_Out_HID_ReqToIF ⇒ USBD_HID_SetReport ⇒ usbd_hid_set_report ⇒ LIGHT_DT_Data_Receive_Prepare ⇒ LIGHT_DT_Data_Receive_Anl ⇒ Para_ResetToFactorySetup ⇒ Para_WriteSettingToFile ⇒ f_open ⇒ follow_path ⇒ dir_find ⇒ dir_next ⇒ create_chain ⇒ put_fat ⇒ move_window ⇒ sync_window ⇒ disk_write ⇒ Flash_SectorsWrite ⇒ Flash_PageWrite ⇒ Flash_WaitForEnd ⇒ Flash_SendByte ⇒ SPI_I2S_SendData

[Calls]

- >> USBD_EndPoint0_Out_CDC_ReqToIF
- >> USBD_EndPoint0_Setup_CDC_ReqToIF
- >> USBD_EndPoint0_Setup_MSC_ReqToIF
- >> USBD_ClrStallEP
- >> USBD_SetStallEP
- >> USBD_DirCtrlEP
- >> USBD_SetAddress
- >> USBD_EndPoint0_Setup_HID_ReqToIF
- >> USBD_EndPoint0_Out_HID_ReqToIF
- >> USBD_ReqSetInterface
- >> USBD_ReqGetInterface
- >> USBD_ReqSetConfiguration
- >> USBD_ReqGetConfiguration
- >> USBD_ReqGetDescriptor
- >> USBD_ReqSetClrFeature
- >> USBD_ReqGetStatus
- >> USBD_StatusOutStage
- >> USBD_StatusInStage
- >> USBD_DataOutStage
- >> USBD_DataInStage
- >> USBD_SetupStage

[Address Reference Count : 1]

- usb_config.o(.constdata)

USBD_ReqGetDescriptor_HID (Thumb, 132 bytes, Stack size 0 bytes, usbd_core_hid.o(.text))

[Called By]

- >> USBD_ReqGetDescriptor

USBD_EndPoint0_Setup_HID_ReqToIF (Thumb, 200 bytes, Stack size 8 bytes, usbd_core_hid.o(.text))

[Stack]

- Max Depth = 36
- Call Chain = USBD_EndPoint0_Setup_HID_ReqToIF ⇒ USBD_StatusInStage ⇒ USBD_WriteEP

[Calls]

- >> USBD_HID_SetProtocol
- >> USBD_HID_SetIdle
- >> USBD_HID_GetReport
- >> USBD_HID_GetProtocol
- >> USBD_HID_GetIdle
- >> USBD_StatusInStage
- >> USBD_DataInStage

[Called By]

- >> USBD_EndPoint0

USBD_EndPoint0_Out_HID_ReqToIF (Thumb, 44 bytes, Stack size 8 bytes, usbd_core_hid.o(.text))

[Stack]

- Max Depth = 496
- Call Chain = USBD_EndPoint0_Out_HID_ReqToIF ⇒ USBD_HID_SetReport ⇒ usbd_hid_set_report ⇒ LIGHT_DT_Data_Receive_Prepare ⇒ LIGHT_DT_Data_Receive_Anl ⇒ Para_ResetToFactorySetup ⇒ Para_WriteSettingToFile ⇒ f_open ⇒ follow_path ⇒ dir_find ⇒ dir_next ⇒ create_chain ⇒ put_fat ⇒ move_window ⇒ sync_window ⇒ disk_write ⇒ Flash_SectorsWrite ⇒ Flash_PageWrite ⇒ Flash_WaitForEnd ⇒ Flash_SendByte ⇒ SPI_I2S_SendData

[Calls]

- >> USBD_HID_SetReport
- >> USBD_StatusInStage

[Called By]

- >> USBD_EndPoint0

usbd_hid_init (Thumb, 2 bytes, Stack size 0 bytes, usbd_hid.o(.text))

[Called By]

- >> usbd_class_init

usbd_hid_get_protocol (Thumb, 4 bytes, Stack size 0 bytes, usbd_hid.o(.text))

[Called By]

- >> USBD_HID_GetProtocol

usbd_hid_set_protocol (Thumb, 2 bytes, Stack size 0 bytes, usbd_hid.o(.text))

[Called By]

- >> USBD_HID_SetProtocol

USBD_HID_GetReport (Thumb, 54 bytes, Stack size 8 bytes, usbd_hid.o(.text))

[Stack]

- Max Depth = 16
- Call Chain = USBD_HID_GetReport ⇒ usbd_hid_get_report

[Calls]

- >> usbd_hid_get_report

[Called By]

- >> USBD_EndPoint0_Setup_HID_ReqToIF

USBD_HID_SetReport (Thumb, 58 bytes, Stack size 16 bytes, usbd_hid.o(.text))

[Stack]

- Max Depth = 488
- Call Chain = USBD_HID_SetReport ⇒ usbd_hid_set_report ⇒ LIGHT_DT_Data_Receive_Prepare ⇒ LIGHT_DT_Data_Receive_Anl ⇒ Para_ResetToFactorySetup ⇒ Para_WriteSettingToFile ⇒ f_open ⇒ follow_path ⇒ dir_find ⇒ dir_next ⇒ create_chain ⇒ put_fat ⇒ move_window ⇒ sync_window ⇒ disk_write ⇒ Flash_SectorsWrite ⇒ Flash_PageWrite ⇒ Flash_WaitForEnd ⇒ Flash_SendByte ⇒ SPI_I2S_SendData

[Calls]

- >> usbd_hid_set_report

[Called By]

- >> USBD_EndPoint0_Out_HID_ReqToIF

USBD_HID_GetIdle (Thumb, 16 bytes, Stack size 0 bytes, usbd_hid.o(.text))

[Called By]

- >> USBD_EndPoint0_Setup_HID_ReqToIF

USBD_HID_SetIdle (Thumb, 48 bytes, Stack size 0 bytes, usbd_hid.o(.text))

[Called By]

- >> USBD_EndPoint0_Setup_HID_ReqToIF

USBD_HID_GetProtocol (Thumb, 14 bytes, Stack size 8 bytes, usbd_hid.o(.text))

[Stack]

- Max Depth = 8
- Call Chain = USBD_HID_GetProtocol

[Calls]

- >> usbd_hid_get_protocol

[Called By]

- >> USBD_EndPoint0_Setup_HID_ReqToIF

USBD_HID_SetProtocol (Thumb, 14 bytes, Stack size 8 bytes, usbd_hid.o(.text))

[Stack]

- Max Depth = 8
- Call Chain = USBD_HID_SetProtocol

[Calls]

- >> usbd_hid_set_protocol

[Called By]

- >> USBD_EndPoint0_Setup_HID_ReqToIF

USBD_HID_EP_INTIN_Event (Thumb, 422 bytes, Stack size 16 bytes, usbd_hid.o(.text))

[Stack]

- Max Depth = 36
- Call Chain = USBD_HID_EP_INTIN_Event ⇒ USBD_WriteEP

[Calls]

- >> USBD_WriteEP
- >> usbd_hid_get_report

[Called By]

- >> USBD_HID_SOF_Event
- >> USBD_HID_EP_INT_Event
- >> usbd_hid_get_report_trigger

USBD_HID_EP_INTOUT_Event (Thumb, 148 bytes, Stack size 16 bytes, usbd_hid.o(.text))

[Stack]

- Max Depth = 488
- Call Chain = USBD_HID_EP_INTOUT_Event ⇒ usbd_hid_set_report ⇒ LIGHT_DT_Data_Receive_Prepare ⇒ LIGHT_DT_Data_Receive_Anl ⇒ Para_ResetToFactorySetup ⇒ Para_WriteSettingToFile ⇒ f_open ⇒ follow_path ⇒ dir_find ⇒ dir_next ⇒ create_chain ⇒ put_fat ⇒ move_window ⇒ sync_window ⇒ disk_write ⇒ Flash_SectorsWrite ⇒ Flash_PageWrite ⇒ Flash_WaitForEnd ⇒ Flash_SendByte ⇒ SPI_I2S_SendData

[Calls]

- >> USBD_ReadEP
- >> usbd_hid_set_report

[Called By]

- >> USBD_HID_EP_INT_Event

USBD_HID_Configure_Event (Thumb, 48 bytes, Stack size 0 bytes, usbd_hid.o(.text))

[Called By]

- >> USBD_Configure_Event

USBD_HID_EP_INT_Event (Thumb, 30 bytes, Stack size 8 bytes, usbd_hid.o(.text))

[Stack]

- Max Depth = 496
- Call Chain = USBD_HID_EP_INT_Event ⇒ USBD_HID_EP_INTOUT_Event ⇒ usbd_hid_set_report ⇒ LIGHT_DT_Data_Receive_Prepare ⇒ LIGHT_DT_Data_Receive_Anl ⇒ Para_ResetToFactorySetup ⇒ Para_WriteSettingToFile ⇒ f_open ⇒ follow_path ⇒ dir_find ⇒ dir_next ⇒ create_chain ⇒ put_fat ⇒ move_window ⇒ sync_window ⇒ disk_write ⇒ Flash_SectorsWrite ⇒ Flash_PageWrite ⇒ Flash_WaitForEnd ⇒ Flash_SendByte ⇒ SPI_I2S_SendData

[Calls]

- >> USBD_HID_EP_INTOUT_Event
- >> USBD_HID_EP_INTIN_Event

[Address Reference Count : 1]

- usb_config.o(.constdata)

USBD_HID_SOF_Event (Thumb, 460 bytes, Stack size 24 bytes, usbd_hid.o(.text))

[Stack]

- Max Depth = 60
- Call Chain = USBD_HID_SOF_Event ⇒ USBD_HID_EP_INTIN_Event ⇒ USBD_WriteEP

[Calls]

- >> USBD_HID_EP_INTIN_Event

[Called By]

- >> USBD_SOF_Event

usbd_hid_get_report_trigger (Thumb, 148 bytes, Stack size 16 bytes, usbd_hid.o(.text))

[Stack]

- Max Depth = 52
- Call Chain = usbd_hid_get_report_trigger ⇒ USBD_HID_EP_INTIN_Event ⇒ USBD_WriteEP

[Calls]

- >> USBD_HID_EP_INTIN_Event
- >> __aeabi_memcpy

[Called By]

- >> Usb_Hid_Send

disk_status (Thumb, 24 bytes, Stack size 0 bytes, diskio.o(.text))

[Called By]

- >> validate
- >> find_volume

disk_initialize (Thumb, 34 bytes, Stack size 8 bytes, diskio.o(.text))

[Stack]

- Max Depth = 88
- Call Chain = disk_initialize ⇒ Flash_Init ⇒ Flash_ReadID ⇒ Flash_SendByte ⇒ SPI_I2S_SendData

[Calls]

- >> Flash_GetInfo
- >> Flash_Init

[Called By]

- >> f_mkfs
- >> find_volume

disk_read (Thumb, 56 bytes, Stack size 24 bytes, diskio.o(.text))

[Stack]

- Max Depth = 88
- Call Chain = disk_read ⇒ Flash_SectorsRead ⇒ Flash_PageRead ⇒ Flash_SendByte ⇒ SPI_I2S_SendData

[Calls]

- >> Flash_SectorsRead

[Called By]

- >> f_write
- >> f_read
- >> f_lseek
- >> move_window

disk_write (Thumb, 56 bytes, Stack size 24 bytes, diskio.o(.text))

[Stack]

- Max Depth = 96
- Call Chain = disk_write ⇒ Flash_SectorsWrite ⇒ Flash_PageWrite ⇒ Flash_WaitForEnd ⇒ Flash_SendByte ⇒ SPI_I2S_SendData

[Calls]

- >> Flash_SectorsWrite

[Called By]

- >> f_write
- >> f_read
- >> f_mkfs
- >> f_truncate
- >> f_lseek
- >> f_sync
- >> sync_fs
- >> sync_window

disk_ioctl (Thumb, 60 bytes, Stack size 0 bytes, diskio.o(.text))

[Called By]

- >> f_mkfs
- >> find_volume
- >> sync_fs

get_fattime (Thumb, 4 bytes, Stack size 0 bytes, diskio.o(.text))

[Called By]

- >> f_open
- >> f_mkfs
- >> f_mkdir
- >> f_sync

clust2sect (Thumb, 26 bytes, Stack size 0 bytes, ff.o(.text))

[Called By]

- >> f_write
- >> f_read
- >> f_rename
- >> f_mkdir
- >> f_lseek
- >> dir_next
- >> dir_sdi

get_fat (Thumb, 318 bytes, Stack size 40 bytes, ff.o(.text))

[Stack]

- Max Depth = 176
- Call Chain = get_fat ⇒ move_window ⇒ sync_window ⇒ disk_write ⇒ Flash_SectorsWrite ⇒ Flash_PageWrite ⇒ Flash_WaitForEnd ⇒ Flash_SendByte ⇒ SPI_I2S_SendData

[Calls]

- >> move_window

[Called By]

- >> f_read
- >> f_truncate
- >> f_getfree
- >> f_lseek
- >> dir_next
- >> dir_sdi
- >> create_chain
- >> remove_chain

put_fat (Thumb, 392 bytes, Stack size 40 bytes, ff.o(.text))

[Stack]

- Max Depth = 176
- Call Chain = put_fat ⇒ move_window ⇒ sync_window ⇒ disk_write ⇒ Flash_SectorsWrite ⇒ Flash_PageWrite ⇒ Flash_WaitForEnd ⇒ Flash_SendByte ⇒ SPI_I2S_SendData

[Calls]

- >> move_window

[Called By]

- >> f_truncate
- >> create_chain
- >> remove_chain

f_mount (Thumb, 86 bytes, Stack size 40 bytes, ff.o(.text))

[Stack]

- Max Depth = 280
- Call Chain = f_mount ⇒ find_volume ⇒ check_fs ⇒ move_window ⇒ sync_window ⇒ disk_write ⇒ Flash_SectorsWrite ⇒ Flash_PageWrite ⇒ Flash_WaitForEnd ⇒ Flash_SendByte ⇒ SPI_I2S_SendData

[Calls]

- >> find_volume
- >> get_ldnumber

[Called By]

- >> Para_WriteSettingToFile
- >> Para_ReadSettingFromFile

f_open (Thumb, 356 bytes, Stack size 80 bytes, ff.o(.text))

[Stack]

- Max Depth = 368
- Call Chain = f_open ⇒ follow_path ⇒ dir_find ⇒ dir_next ⇒ create_chain ⇒ put_fat ⇒ move_window ⇒ sync_window ⇒ disk_write ⇒ Flash_SectorsWrite ⇒ Flash_PageWrite ⇒ Flash_WaitForEnd ⇒ Flash_SendByte ⇒ SPI_I2S_SendData

[Calls]

- >> find_volume
- >> follow_path
- >> dir_register
- >> st_clust
- >> ld_clust
- >> remove_chain
- >> move_window
- >> get_fattime

[Called By]

- >> Para_WriteSettingToFile
- >> Para_ReadSettingFromFile

f_read (Thumb, 498 bytes, Stack size 72 bytes, ff.o(.text))

[Stack]

- Max Depth = 248
- Call Chain = f_read ⇒ get_fat ⇒ move_window ⇒ sync_window ⇒ disk_write ⇒ Flash_SectorsWrite ⇒ Flash_PageWrite ⇒ Flash_WaitForEnd ⇒ Flash_SendByte ⇒ SPI_I2S_SendData

[Calls]

- >> get_fat
- >> clust2sect
- >> validate
- >> clmt_clust
- >> mem_cpy
- >> disk_write
- >> disk_read

[Called By]

- >> Para_ReadSettingFromFile

f_write (Thumb, 540 bytes, Stack size 64 bytes, ff.o(.text))

[Stack]

- Max Depth = 272
- Call Chain = f_write ⇒ create_chain ⇒ put_fat ⇒ move_window ⇒ sync_window ⇒ disk_write ⇒ Flash_SectorsWrite ⇒ Flash_PageWrite ⇒ Flash_WaitForEnd ⇒ Flash_SendByte ⇒ SPI_I2S_SendData

[Calls]

- >> clust2sect
- >> validate
- >> clmt_clust
- >> create_chain
- >> mem_cpy
- >> disk_write
- >> disk_read

[Called By]

- >> Para_WriteSettingToFile

f_sync (Thumb, 176 bytes, Stack size 24 bytes, ff.o(.text))

[Stack]

- Max Depth = 160
- Call Chain = f_sync ⇒ sync_fs ⇒ sync_window ⇒ disk_write ⇒ Flash_SectorsWrite ⇒ Flash_PageWrite ⇒ Flash_WaitForEnd ⇒ Flash_SendByte ⇒ SPI_I2S_SendData

[Calls]

- >> validate
- >> st_clust
- >> sync_fs
- >> move_window
- >> get_fattime
- >> disk_write

[Called By]

- >> f_close

f_close (Thumb, 32 bytes, Stack size 16 bytes, ff.o(.text))

[Stack]

- Max Depth = 176
- Call Chain = f_close ⇒ f_sync ⇒ sync_fs ⇒ sync_window ⇒ disk_write ⇒ Flash_SectorsWrite ⇒ Flash_PageWrite ⇒ Flash_WaitForEnd ⇒ Flash_SendByte ⇒ SPI_I2S_SendData

[Calls]

- >> f_sync
- >> validate

[Called By]

- >> Para_WriteSettingToFile
- >> Para_ReadSettingFromFile

f_lseek (Thumb, 726 bytes, Stack size 64 bytes, ff.o(.text), UNUSED)

[Calls]

- >> get_fat
- >> clust2sect
- >> validate
- >> clmt_clust
- >> create_chain
- >> disk_write
- >> disk_read

f_opendir (Thumb, 110 bytes, Stack size 40 bytes, ff.o(.text))

[Stack]

- Max Depth = 328
- Call Chain = f_opendir ⇒ follow_path ⇒ dir_find ⇒ dir_next ⇒ create_chain ⇒ put_fat ⇒ move_window ⇒ sync_window ⇒ disk_write ⇒ Flash_SectorsWrite ⇒ Flash_PageWrite ⇒ Flash_WaitForEnd ⇒ Flash_SendByte ⇒ SPI_I2S_SendData

[Calls]

- >> find_volume
- >> follow_path
- >> ld_clust
- >> dir_sdi

[Called By]

- >> Para_WriteSettingToFile
- >> Para_ReadSettingFromFile

f_closedir (Thumb, 22 bytes, Stack size 16 bytes, ff.o(.text), UNUSED)

[Calls]

- >> validate

f_readdir (Thumb, 88 bytes, Stack size 32 bytes, ff.o(.text), UNUSED)

[Calls]

- >> validate
- >> get_fileinfo
- >> dir_read
- >> dir_next
- >> dir_sdi

f_stat (Thumb, 60 bytes, Stack size 64 bytes, ff.o(.text), UNUSED)

[Calls]

- >> find_volume
- >> follow_path
- >> get_fileinfo

f_getfree (Thumb, 258 bytes, Stack size 56 bytes, ff.o(.text), UNUSED)

[Calls]

- >> get_fat
- >> find_volume
- >> move_window

f_truncate (Thumb, 184 bytes, Stack size 16 bytes, ff.o(.text), UNUSED)

[Calls]

- >> put_fat
- >> get_fat
- >> validate
- >> remove_chain
- >> disk_write

f_unlink (Thumb, 166 bytes, Stack size 88 bytes, ff.o(.text), UNUSED)

[Calls]

- >> find_volume
- >> follow_path
- >> dir_remove
- >> dir_read
- >> ld_clust
- >> dir_sdi
- >> remove_chain
- >> sync_fs
- >> mem_cpy

f_mkdir (Thumb, 352 bytes, Stack size 80 bytes, ff.o(.text), UNUSED)

[Calls]

- >> clust2sect
- >> find_volume
- >> follow_path
- >> dir_register
- >> st_clust
- >> create_chain
- >> remove_chain
- >> sync_fs
- >> sync_window
- >> mem_set
- >> mem_cpy
- >> get_fattime

f_chmod (Thumb, 84 bytes, Stack size 72 bytes, ff.o(.text), UNUSED)

[Calls]

- >> find_volume
- >> follow_path
- >> sync_fs

f_rename (Thumb, 258 bytes, Stack size 120 bytes, ff.o(.text), UNUSED)

[Calls]

- >> clust2sect
- >> find_volume
- >> get_ldnumber
- >> follow_path
- >> dir_remove
- >> dir_register
- >> st_clust
- >> ld_clust
- >> sync_fs
- >> move_window
- >> mem_cpy

f_utime (Thumb, 86 bytes, Stack size 64 bytes, ff.o(.text), UNUSED)

[Calls]

- >> find_volume
- >> follow_path
- >> sync_fs

f_mkfs (Thumb, 1624 bytes, Stack size 112 bytes, ff.o(.text))

[Stack]

- Max Depth = 208
- Call Chain = f_mkfs ⇒ disk_write ⇒ Flash_SectorsWrite ⇒ Flash_PageWrite ⇒ Flash_WaitForEnd ⇒ Flash_SendByte ⇒ SPI_I2S_SendData

[Calls]

- >> get_ldnumber
- >> mem_set
- >> mem_cpy
- >> get_fattime
- >> disk_ioctl
- >> disk_write
- >> disk_initialize

[Called By]

- >> Para_ResetToFactorySetup
- >> Para_WriteSettingToFile
- >> Para_ReadSettingFromFile

__aeabi_memcpy (Thumb, 36 bytes, Stack size 0 bytes, memcpya.o(.text))

[Called By]

- >> usbd_hid_get_report_trigger

__aeabi_memcpy4 (Thumb, 0 bytes, Stack size 0 bytes, memcpya.o(.text), UNUSED)

__aeabi_memcpy8 (Thumb, 0 bytes, Stack size 0 bytes, memcpya.o(.text), UNUSED)

__aeabi_memset (Thumb, 14 bytes, Stack size 0 bytes, memseta.o(.text), UNUSED)

[Called By]

- >> _memset$wrapper
- >> __aeabi_memclr

__aeabi_memset4 (Thumb, 0 bytes, Stack size 0 bytes, memseta.o(.text), UNUSED)

__aeabi_memset8 (Thumb, 0 bytes, Stack size 0 bytes, memseta.o(.text), UNUSED)

__aeabi_memclr (Thumb, 4 bytes, Stack size 0 bytes, memseta.o(.text), UNUSED)

[Calls]

- >> __aeabi_memset

__aeabi_memclr4 (Thumb, 0 bytes, Stack size 0 bytes, memseta.o(.text))

[Called By]

- >> MPU6050_Data_Prepare

__aeabi_memclr8 (Thumb, 0 bytes, Stack size 0 bytes, memseta.o(.text), UNUSED)

_memset$wrapper (Thumb, 18 bytes, Stack size 8 bytes, memseta.o(.text), UNUSED)

[Calls]

- >> __aeabi_memset

strlen (Thumb, 14 bytes, Stack size 0 bytes, strlen.o(.text))

[Called By]

- >> get_len_string_interface

__aeabi_dadd (Thumb, 322 bytes, Stack size 48 bytes, dadd.o(.text))

[Stack]

- Max Depth = 88
- Call Chain = __aeabi_dadd ⇒ _double_epilogue ⇒ _double_round

[Calls]

- >> __aeabi_lasr
- >> __aeabi_llsl
- >> _double_round
- >> _double_epilogue

[Called By]

- >> __aeabi_drsub
- >> To_180_degrees_db
- >> my_cos
- >> mx_sin
- >> __aeabi_dsub
- >> CTRL_2
- >> __kernel_poly
- >> __mathlib_dbl_infnan
- >> __hardfp_atan
- >> __hardfp_asin

__aeabi_dsub (Thumb, 6 bytes, Stack size 0 bytes, dadd.o(.text))

[Stack]

- Max Depth = 88
- Call Chain = __aeabi_dsub ⇒ __aeabi_dadd ⇒ _double_epilogue ⇒ _double_round

[Calls]

- >> __aeabi_dadd

[Called By]

- >> To_180_degrees_db
- >> my_cos
- >> my_sin
- >> mx_sin
- >> Track_Line
- >> USART1_IRQHandler
- >> __hardfp_atan
- >> __hardfp_asin

__aeabi_drsub (Thumb, 6 bytes, Stack size 0 bytes, dadd.o(.text))

[Stack]

- Max Depth = 88
- Call Chain = __aeabi_drsub ⇒ __aeabi_dadd ⇒ _double_epilogue ⇒ _double_round

[Calls]

- >> __aeabi_dadd

[Called By]

- >> mx_sin
- >> __hardfp_atan
- >> __hardfp_asin

__aeabi_dmul (Thumb, 228 bytes, Stack size 48 bytes, dmul.o(.text))

[Stack]

- Max Depth = 88
- Call Chain = __aeabi_dmul ⇒ _double_epilogue ⇒ _double_round

[Calls]

- >> _double_epilogue

[Called By]

- >> LIGHT_DT_Data_Receive_Anl
- >> my_cos
- >> my_sin
- >> mx_sin
- >> IMUupdate
- >> CTRL_2
- >> USART1_IRQHandler
- >> __kernel_poly
- >> __mathlib_dbl_underflow
- >> __hardfp_atan
- >> __hardfp_asin

__aeabi_ddiv (Thumb, 222 bytes, Stack size 32 bytes, ddiv.o(.text))

[Stack]

- Max Depth = 40
- Call Chain = __aeabi_ddiv ⇒ _double_round

[Calls]

- >> _double_round

[Called By]

- >> USART1_IRQHandler
- >> __mathlib_dbl_invalid
- >> __hardfp_atan
- >> __hardfp_asin

__aeabi_i2d (Thumb, 34 bytes, Stack size 16 bytes, dflti.o(.text))

[Stack]

- Max Depth = 56
- Call Chain = __aeabi_i2d ⇒ _double_epilogue ⇒ _double_round

[Calls]

- >> _double_epilogue

[Called By]

- >> LIGHT_DT_Data_Receive_Anl
- >> my_cos
- >> my_sin

__aeabi_f2d (Thumb, 38 bytes, Stack size 0 bytes, f2d.o(.text))

[Called By]

- >> IMUupdate
- >> CTRL_2
- >> Track_Line
- >> USART1_IRQHandler

__aeabi_cdcmpeq (Thumb, 0 bytes, Stack size 0 bytes, cdcmple.o(.text), UNUSED)

__aeabi_cdcmple (Thumb, 48 bytes, Stack size 0 bytes, cdcmple.o(.text), UNUSED)

[Called By]

- >> To_180_degrees_db
- >> mx_sin

__aeabi_cdrcmple (Thumb, 48 bytes, Stack size 0 bytes, cdrcmple.o(.text), UNUSED)

[Called By]

- >> To_180_degrees_db
- >> my_cos
- >> my_sin

__aeabi_d2f (Thumb, 56 bytes, Stack size 8 bytes, d2f.o(.text))

[Stack]

- Max Depth = 8
- Call Chain = __aeabi_d2f

[Calls]

- >> _float_round

[Called By]

- >> LIGHT_DT_Data_Receive_Anl
- >> my_cos
- >> IMUupdate
- >> CTRL_2
- >> Track_Line
- >> USART1_IRQHandler

__aeabi_llsl (Thumb, 30 bytes, Stack size 0 bytes, llshl.o(.text))

[Called By]

- >> __aeabi_dadd
- >> _double_epilogue

_ll_shift_l (Thumb, 0 bytes, Stack size 0 bytes, llshl.o(.text), UNUSED)

__aeabi_lasr (Thumb, 36 bytes, Stack size 0 bytes, llsshr.o(.text))

[Called By]

- >> __aeabi_dadd

_ll_sshift_r (Thumb, 0 bytes, Stack size 0 bytes, llsshr.o(.text), UNUSED)

__I$use$fp (Thumb, 0 bytes, Stack size 0 bytes, iusefp.o(.text), UNUSED)

_float_round (Thumb, 18 bytes, Stack size 0 bytes, fepilogue.o(.text))

[Called By]

- >> __aeabi_d2f

_float_epilogue (Thumb, 92 bytes, Stack size 4 bytes, fepilogue.o(.text), UNUSED)

_double_round (Thumb, 30 bytes, Stack size 8 bytes, depilogue.o(.text))

[Stack]

- Max Depth = 8
- Call Chain = _double_round

[Called By]

- >> __aeabi_dadd
- >> __aeabi_ddiv
- >> _dsqrt
- >> _double_epilogue

_double_epilogue (Thumb, 156 bytes, Stack size 32 bytes, depilogue.o(.text))

[Stack]

- Max Depth = 40
- Call Chain = _double_epilogue ⇒ _double_round

[Calls]

- >> __aeabi_llsr
- >> __aeabi_llsl
- >> _double_round

[Called By]

- >> __aeabi_i2d
- >> __aeabi_dmul
- >> __aeabi_dadd

__scatterload (Thumb, 28 bytes, Stack size 0 bytes, init.o(.text))

[Calls]

- >> __main_after_scatterload

[Called By]

- >> _main_scatterload

__scatterload_rt2 (Thumb, 0 bytes, Stack size 0 bytes, init.o(.text), UNUSED)

__aeabi_llsr (Thumb, 32 bytes, Stack size 0 bytes, llushr.o(.text))

[Called By]

- >> _dsqrt
- >> _double_epilogue

_ll_ushift_r (Thumb, 0 bytes, Stack size 0 bytes, llushr.o(.text), UNUSED)

_dsqrt (Thumb, 162 bytes, Stack size 32 bytes, dsqrt.o(.text))

[Stack]

- Max Depth = 40
- Call Chain = _dsqrt ⇒ _double_round

[Calls]

- >> __aeabi_llsr
- >> _double_round

[Called By]

- >> sqrt

__decompress (Thumb, 0 bytes, Stack size unknown bytes, __dczerorl2.o(.text), UNUSED)

__decompress1 (Thumb, 86 bytes, Stack size unknown bytes, __dczerorl2.o(.text), UNUSED)

__ARM_fpclassify (Thumb, 48 bytes, Stack size 8 bytes, fpclassify.o(i.__ARM_fpclassify))

[Stack]

- Max Depth = 8
- Call Chain = __ARM_fpclassify

[Called By]

- >> __hardfp_atan
- >> __hardfp_asin

__hardfp_asin (Thumb, 770 bytes, Stack size 88 bytes, asin.o(i.__hardfp_asin))

[Stack]

- Max Depth = 200
- Call Chain = __hardfp_asin ⇒ __kernel_poly ⇒ __aeabi_dmul ⇒ _double_epilogue ⇒ _double_round

[Calls]

- >> __aeabi_drsub
- >> __aeabi_dmul
- >> __aeabi_dadd
- >> __aeabi_dsub
- >> __aeabi_ddiv
- >> __set_errno
- >> sqrt
- >> __kernel_poly
- >> __ARM_fpclassify
- >> fabs
- >> __mathlib_dbl_underflow
- >> __mathlib_dbl_invalid
- >> __mathlib_dbl_infnan

[Called By]

- >> IMUupdate

__hardfp_atan (Thumb, 622 bytes, Stack size 48 bytes, atan.o(i.__hardfp_atan))

[Stack]

- Max Depth = 160
- Call Chain = __hardfp_atan ⇒ __kernel_poly ⇒ __aeabi_dmul ⇒ _double_epilogue ⇒ _double_round

[Calls]

- >> __aeabi_drsub
- >> __aeabi_dmul
- >> __aeabi_dadd
- >> __aeabi_dsub
- >> __aeabi_ddiv
- >> __kernel_poly
- >> __ARM_fpclassify
- >> fabs
- >> __mathlib_dbl_underflow
- >> __mathlib_dbl_infnan

[Called By]

- >> USART1_IRQHandler

__kernel_poly (Thumb, 248 bytes, Stack size 24 bytes, poly.o(i.__kernel_poly))

[Stack]

- Max Depth = 112
- Call Chain = __kernel_poly ⇒ __aeabi_dmul ⇒ _double_epilogue ⇒ _double_round

[Calls]

- >> __aeabi_dmul
- >> __aeabi_dadd

[Called By]

- >> __hardfp_atan
- >> __hardfp_asin

__mathlib_dbl_infnan (Thumb, 20 bytes, Stack size 8 bytes, dunder.o(i.__mathlib_dbl_infnan))

[Stack]

- Max Depth = 96
- Call Chain = __mathlib_dbl_infnan ⇒ __aeabi_dadd ⇒ _double_epilogue ⇒ _double_round

[Calls]

- >> __aeabi_dadd

[Called By]

- >> __hardfp_atan
- >> __hardfp_asin

__mathlib_dbl_invalid (Thumb, 24 bytes, Stack size 8 bytes, dunder.o(i.__mathlib_dbl_invalid))

[Stack]

- Max Depth = 48
- Call Chain = __mathlib_dbl_invalid ⇒ __aeabi_ddiv ⇒ _double_round

[Calls]

- >> __aeabi_ddiv

[Called By]

- >> __hardfp_asin

__mathlib_dbl_underflow (Thumb, 24 bytes, Stack size 8 bytes, dunder.o(i.__mathlib_dbl_underflow))

[Stack]

- Max Depth = 96
- Call Chain = __mathlib_dbl_underflow ⇒ __aeabi_dmul ⇒ _double_epilogue ⇒ _double_round

[Calls]

- >> __aeabi_dmul

[Called By]

- >> __hardfp_atan
- >> __hardfp_asin

__scatterload_copy (Thumb, 14 bytes, Stack size unknown bytes, handlers.o(i.__scatterload_copy), UNUSED)

__scatterload_null (Thumb, 2 bytes, Stack size unknown bytes, handlers.o(i.__scatterload_null), UNUSED)

__scatterload_zeroinit (Thumb, 14 bytes, Stack size unknown bytes, handlers.o(i.__scatterload_zeroinit), UNUSED)

__set_errno (Thumb, 6 bytes, Stack size 0 bytes, errno.o(i.__set_errno))

[Called By]

- >> sqrt
- >> __hardfp_asin

fabs (Thumb, 24 bytes, Stack size 8 bytes, fabs.o(i.fabs))

[Stack]

- Max Depth = 8
- Call Chain = fabs

[Called By]

- >> __hardfp_atan
- >> __hardfp_asin

sqrt (Thumb, 110 bytes, Stack size 32 bytes, sqrt.o(i.sqrt))

[Stack]

- Max Depth = 72
- Call Chain = sqrt ⇒ _dsqrt ⇒ _double_round

[Calls]

- >> __set_errno
- >> _dsqrt

[Called By]

- >> __hardfp_asin

### Local Symbols

Para_ReadSettingFromFile (Thumb, 262 bytes, Stack size 16 bytes, parameter.o(.text))

[Stack]

- Max Depth = 384
- Call Chain = Para_ReadSettingFromFile ⇒ f_open ⇒ follow_path ⇒ dir_find ⇒ dir_next ⇒ create_chain ⇒ put_fat ⇒ move_window ⇒ sync_window ⇒ disk_write ⇒ Flash_SectorsWrite ⇒ Flash_PageWrite ⇒ Flash_WaitForEnd ⇒ Flash_SendByte ⇒ SPI_I2S_SendData

[Calls]

- >> f_read
- >> f_opendir
- >> f_open
- >> f_mount
- >> f_mkfs
- >> f_close

[Called By]

- >> Para_Init

Para_WriteSettingToFile (Thumb, 256 bytes, Stack size 16 bytes, parameter.o(.text))

[Stack]

- Max Depth = 384
- Call Chain = Para_WriteSettingToFile ⇒ f_open ⇒ follow_path ⇒ dir_find ⇒ dir_next ⇒ create_chain ⇒ put_fat ⇒ move_window ⇒ sync_window ⇒ disk_write ⇒ Flash_SectorsWrite ⇒ Flash_PageWrite ⇒ Flash_WaitForEnd ⇒ Flash_SendByte ⇒ SPI_I2S_SendData

[Calls]

- >> f_write
- >> f_opendir
- >> f_open
- >> f_mount
- >> f_mkfs
- >> f_close

[Called By]

- >> Param_SavePID
- >> Param_Save_3d_offset
- >> Param_SaveMagOffset
- >> Param_SaveGyroOffset
- >> Param_SaveAccelOffset
- >> Para_ResetToFactorySetup

Param_SetSettingToFC (Thumb, 186 bytes, Stack size 8 bytes, parameter.o(.text))

[Stack]

- Max Depth = 8
- Call Chain = Param_SetSettingToFC

[Called By]

- >> Para_ResetToFactorySetup
- >> Para_Init

LIGHT_DT_Send_Check (Thumb, 62 bytes, Stack size 16 bytes, data_transfer.o(.text))

[Stack]

- Max Depth = 80
- Call Chain = LIGHT_DT_Send_Check ⇒ LIGHT_DT_Send_Data ⇒ Usart2_Send ⇒ USART_ITConfig

[Calls]

- >> LIGHT_DT_Send_Data

[Called By]

- >> LIGHT_DT_Data_Exchange

LIGHT_DT_Send_Msg (Thumb, 62 bytes, Stack size 16 bytes, data_transfer.o(.text))

[Stack]

- Max Depth = 80
- Call Chain = LIGHT_DT_Send_Msg ⇒ LIGHT_DT_Send_Data ⇒ Usart2_Send ⇒ USART_ITConfig

[Calls]

- >> LIGHT_DT_Send_Data

[Called By]

- >> LIGHT_DT_Data_Exchange

USBD_FlushInEpFifo (Thumb, 60 bytes, Stack size 0 bytes, usbd_stm32f4xx_fs.o(.text))

[Called By]

- >> OTG_FS_IRQHandler
- >> USBD_ClearEPBuf
- >> USBD_ClrStallEP
- >> USBD_SetStallEP
- >> USBD_ResetEP

Flash_SendByte (Thumb, 50 bytes, Stack size 8 bytes, drv_w25qxx.o(.text))

[Stack]

- Max Depth = 24
- Call Chain = Flash_SendByte ⇒ SPI_I2S_SendData

[Calls]

- >> SPI_I2S_SendData
- >> SPI_I2S_ReceiveData
- >> SPI_I2S_GetFlagStatus

[Called By]

- >> Flash_PageRead
- >> Flash_PageWrite
- >> Flash_SectorErase
- >> Flash_Init
- >> Flash_WaitForEnd
- >> Flash_WriteEnable
- >> Flash_ReadID

Flash_ReadID (Thumb, 66 bytes, Stack size 16 bytes, drv_w25qxx.o(.text))

[Stack]

- Max Depth = 40
- Call Chain = Flash_ReadID ⇒ Flash_SendByte ⇒ SPI_I2S_SendData

[Calls]

- >> GPIO_WriteBit
- >> Flash_SendByte

[Called By]

- >> Flash_Init

Flash_WriteEnable (Thumb, 30 bytes, Stack size 8 bytes, drv_w25qxx.o(.text))

[Stack]

- Max Depth = 32
- Call Chain = Flash_WriteEnable ⇒ Flash_SendByte ⇒ SPI_I2S_SendData

[Calls]

- >> GPIO_WriteBit
- >> Flash_SendByte

[Called By]

- >> Flash_SectorsWrite
- >> Flash_PageWrite
- >> Flash_SectorErase

Flash_WaitForEnd (Thumb, 50 bytes, Stack size 8 bytes, drv_w25qxx.o(.text))

[Stack]

- Max Depth = 32
- Call Chain = Flash_WaitForEnd ⇒ Flash_SendByte ⇒ SPI_I2S_SendData

[Calls]

- >> GPIO_WriteBit
- >> Flash_SendByte

[Called By]

- >> Flash_PageWrite
- >> Flash_SectorErase

TI4_Config (Thumb, 128 bytes, Stack size 20 bytes, stm32f4xx_tim.o(.text))

[Stack]

- Max Depth = 20
- Call Chain = TI4_Config

[Called By]

- >> TIM_ICInit

TI3_Config (Thumb, 72 bytes, Stack size 20 bytes, stm32f4xx_tim.o(.text))

[Stack]

- Max Depth = 20
- Call Chain = TI3_Config

[Called By]

- >> TIM_ICInit

TI2_Config (Thumb, 80 bytes, Stack size 20 bytes, stm32f4xx_tim.o(.text))

[Stack]

- Max Depth = 20
- Call Chain = TI2_Config

[Called By]

- >> TIM_ICInit
- >> TIM_TIxExternalClockConfig
- >> TIM_PWMIConfig

TI1_Config (Thumb, 58 bytes, Stack size 20 bytes, stm32f4xx_tim.o(.text))

[Stack]

- Max Depth = 20
- Call Chain = TI1_Config

[Called By]

- >> TIM_ICInit
- >> TIM_TIxExternalClockConfig
- >> TIM_PWMIConfig

SetSysClock (Thumb, 220 bytes, Stack size 12 bytes, system_stm32f4xx.o(.text))

[Stack]

- Max Depth = 12
- Call Chain = SetSysClock

[Called By]

- >> SystemInit

mem_cpy (Thumb, 26 bytes, Stack size 16 bytes, ff.o(.text))

[Stack]

- Max Depth = 16
- Call Chain = mem_cpy

[Called By]

- >> f_write
- >> f_read
- >> f_mkfs
- >> f_rename
- >> f_mkdir
- >> f_unlink
- >> dir_register

mem_set (Thumb, 20 bytes, Stack size 12 bytes, ff.o(.text))

[Stack]

- Max Depth = 12
- Call Chain = mem_set

[Called By]

- >> f_mkfs
- >> f_mkdir
- >> create_name
- >> dir_remove
- >> dir_register
- >> dir_next
- >> sync_fs

mem_cmp (Thumb, 38 bytes, Stack size 20 bytes, ff.o(.text))

[Stack]

- Max Depth = 20
- Call Chain = mem_cmp

[Called By]

- >> dir_find

chk_chr (Thumb, 20 bytes, Stack size 0 bytes, ff.o(.text))

[Called By]

- >> create_name

sync_window (Thumb, 82 bytes, Stack size 24 bytes, ff.o(.text))

[Stack]

- Max Depth = 120
- Call Chain = sync_window ⇒ disk_write ⇒ Flash_SectorsWrite ⇒ Flash_PageWrite ⇒ Flash_WaitForEnd ⇒ Flash_SendByte ⇒ SPI_I2S_SendData

[Calls]

- >> disk_write

[Called By]

- >> f_mkdir
- >> dir_next
- >> sync_fs
- >> move_window

move_window (Thumb, 52 bytes, Stack size 16 bytes, ff.o(.text))

[Stack]

- Max Depth = 136
- Call Chain = move_window ⇒ sync_window ⇒ disk_write ⇒ Flash_SectorsWrite ⇒ Flash_PageWrite ⇒ Flash_WaitForEnd ⇒ Flash_SendByte ⇒ SPI_I2S_SendData

[Calls]

- >> sync_window
- >> disk_read

[Called By]

- >> f_open
- >> f_rename
- >> f_getfree
- >> f_sync
- >> put_fat
- >> get_fat
- >> find_volume
- >> check_fs
- >> dir_remove
- >> dir_register
- >> dir_read
- >> dir_find
- >> dir_alloc

sync_fs (Thumb, 200 bytes, Stack size 16 bytes, ff.o(.text))

[Stack]

- Max Depth = 136
- Call Chain = sync_fs ⇒ sync_window ⇒ disk_write ⇒ Flash_SectorsWrite ⇒ Flash_PageWrite ⇒ Flash_WaitForEnd ⇒ Flash_SendByte ⇒ SPI_I2S_SendData

[Calls]

- >> sync_window
- >> mem_set
- >> disk_ioctl
- >> disk_write

[Called By]

- >> f_utime
- >> f_rename
- >> f_chmod
- >> f_mkdir
- >> f_unlink
- >> f_sync

remove_chain (Thumb, 108 bytes, Stack size 24 bytes, ff.o(.text))

[Stack]

- Max Depth = 200
- Call Chain = remove_chain ⇒ put_fat ⇒ move_window ⇒ sync_window ⇒ disk_write ⇒ Flash_SectorsWrite ⇒ Flash_PageWrite ⇒ Flash_WaitForEnd ⇒ Flash_SendByte ⇒ SPI_I2S_SendData

[Calls]

- >> put_fat
- >> get_fat

[Called By]

- >> f_open
- >> f_mkdir
- >> f_unlink
- >> f_truncate

create_chain (Thumb, 214 bytes, Stack size 32 bytes, ff.o(.text))

[Stack]

- Max Depth = 208
- Call Chain = create_chain ⇒ put_fat ⇒ move_window ⇒ sync_window ⇒ disk_write ⇒ Flash_SectorsWrite ⇒ Flash_PageWrite ⇒ Flash_WaitForEnd ⇒ Flash_SendByte ⇒ SPI_I2S_SendData

[Calls]

- >> put_fat
- >> get_fat

[Called By]

- >> f_write
- >> f_mkdir
- >> f_lseek
- >> dir_next

clmt_clust (Thumb, 56 bytes, Stack size 16 bytes, ff.o(.text))

[Stack]

- Max Depth = 16
- Call Chain = clmt_clust

[Called By]

- >> f_write
- >> f_read
- >> f_lseek

dir_sdi (Thumb, 200 bytes, Stack size 24 bytes, ff.o(.text))

[Stack]

- Max Depth = 200
- Call Chain = dir_sdi ⇒ get_fat ⇒ move_window ⇒ sync_window ⇒ disk_write ⇒ Flash_SectorsWrite ⇒ Flash_PageWrite ⇒ Flash_WaitForEnd ⇒ Flash_SendByte ⇒ SPI_I2S_SendData

[Calls]

- >> get_fat
- >> clust2sect

[Called By]

- >> f_opendir
- >> f_unlink
- >> f_readdir
- >> follow_path
- >> dir_remove
- >> dir_find
- >> dir_alloc

dir_next (Thumb, 314 bytes, Stack size 24 bytes, ff.o(.text))

[Stack]

- Max Depth = 232
- Call Chain = dir_next ⇒ create_chain ⇒ put_fat ⇒ move_window ⇒ sync_window ⇒ disk_write ⇒ Flash_SectorsWrite ⇒ Flash_PageWrite ⇒ Flash_WaitForEnd ⇒ Flash_SendByte ⇒ SPI_I2S_SendData

[Calls]

- >> get_fat
- >> clust2sect
- >> create_chain
- >> sync_window
- >> mem_set

[Called By]

- >> f_readdir
- >> dir_read
- >> dir_find
- >> dir_alloc

dir_alloc (Thumb, 92 bytes, Stack size 24 bytes, ff.o(.text))

[Stack]

- Max Depth = 256
- Call Chain = dir_alloc ⇒ dir_next ⇒ create_chain ⇒ put_fat ⇒ move_window ⇒ sync_window ⇒ disk_write ⇒ Flash_SectorsWrite ⇒ Flash_PageWrite ⇒ Flash_WaitForEnd ⇒ Flash_SendByte ⇒ SPI_I2S_SendData

[Calls]

- >> dir_next
- >> dir_sdi
- >> move_window

[Called By]

- >> dir_register

ld_clust (Thumb, 32 bytes, Stack size 8 bytes, ff.o(.text))

[Stack]

- Max Depth = 8
- Call Chain = ld_clust

[Called By]

- >> f_opendir
- >> f_open
- >> f_rename
- >> f_unlink
- >> follow_path

st_clust (Thumb, 16 bytes, Stack size 0 bytes, ff.o(.text))

[Called By]

- >> f_open
- >> f_rename
- >> f_mkdir
- >> f_sync

dir_find (Thumb, 92 bytes, Stack size 24 bytes, ff.o(.text))

[Stack]

- Max Depth = 256
- Call Chain = dir_find ⇒ dir_next ⇒ create_chain ⇒ put_fat ⇒ move_window ⇒ sync_window ⇒ disk_write ⇒ Flash_SectorsWrite ⇒ Flash_PageWrite ⇒ Flash_WaitForEnd ⇒ Flash_SendByte ⇒ SPI_I2S_SendData

[Calls]

- >> dir_next
- >> dir_sdi
- >> move_window
- >> mem_cmp

[Called By]

- >> follow_path

dir_read (Thumb, 114 bytes, Stack size 32 bytes, ff.o(.text), UNUSED)

[Calls]

- >> dir_next
- >> move_window

[Called By]

- >> f_unlink
- >> f_readdir

dir_register (Thumb, 58 bytes, Stack size 16 bytes, ff.o(.text))

[Stack]

- Max Depth = 272
- Call Chain = dir_register ⇒ dir_alloc ⇒ dir_next ⇒ create_chain ⇒ put_fat ⇒ move_window ⇒ sync_window ⇒ disk_write ⇒ Flash_SectorsWrite ⇒ Flash_PageWrite ⇒ Flash_WaitForEnd ⇒ Flash_SendByte ⇒ SPI_I2S_SendData

[Calls]

- >> dir_alloc
- >> move_window
- >> mem_set
- >> mem_cpy

[Called By]

- >> f_open
- >> f_rename
- >> f_mkdir

dir_remove (Thumb, 54 bytes, Stack size 16 bytes, ff.o(.text), UNUSED)

[Calls]

- >> dir_sdi
- >> move_window
- >> mem_set

[Called By]

- >> f_rename
- >> f_unlink

get_fileinfo (Thumb, 110 bytes, Stack size 20 bytes, ff.o(.text), UNUSED)

[Called By]

- >> f_stat
- >> f_readdir

create_name (Thumb, 336 bytes, Stack size 48 bytes, ff.o(.text))

[Stack]

- Max Depth = 60
- Call Chain = create_name ⇒ mem_set

[Calls]

- >> chk_chr
- >> mem_set

[Called By]

- >> follow_path

follow_path (Thumb, 144 bytes, Stack size 32 bytes, ff.o(.text))

[Stack]

- Max Depth = 288
- Call Chain = follow_path ⇒ dir_find ⇒ dir_next ⇒ create_chain ⇒ put_fat ⇒ move_window ⇒ sync_window ⇒ disk_write ⇒ Flash_SectorsWrite ⇒ Flash_PageWrite ⇒ Flash_WaitForEnd ⇒ Flash_SendByte ⇒ SPI_I2S_SendData

[Calls]

- >> create_name
- >> dir_find
- >> ld_clust
- >> dir_sdi

[Called By]

- >> f_opendir
- >> f_open
- >> f_utime
- >> f_rename
- >> f_chmod
- >> f_mkdir
- >> f_unlink
- >> f_stat

get_ldnumber (Thumb, 74 bytes, Stack size 16 bytes, ff.o(.text))

[Stack]

- Max Depth = 16
- Call Chain = get_ldnumber

[Called By]

- >> f_mount
- >> f_mkfs
- >> f_rename
- >> find_volume

check_fs (Thumb, 140 bytes, Stack size 16 bytes, ff.o(.text))

[Stack]

- Max Depth = 152
- Call Chain = check_fs ⇒ move_window ⇒ sync_window ⇒ disk_write ⇒ Flash_SectorsWrite ⇒ Flash_PageWrite ⇒ Flash_WaitForEnd ⇒ Flash_SendByte ⇒ SPI_I2S_SendData

[Calls]

- >> move_window

[Called By]

- >> find_volume

find_volume (Thumb, 990 bytes, Stack size 88 bytes, ff.o(.text))

[Stack]

- Max Depth = 240
- Call Chain = find_volume ⇒ check_fs ⇒ move_window ⇒ sync_window ⇒ disk_write ⇒ Flash_SectorsWrite ⇒ Flash_PageWrite ⇒ Flash_WaitForEnd ⇒ Flash_SendByte ⇒ SPI_I2S_SendData

[Calls]

- >> check_fs
- >> get_ldnumber
- >> move_window
- >> disk_ioctl
- >> disk_initialize
- >> disk_status

[Called By]

- >> f_opendir
- >> f_open
- >> f_mount
- >> f_utime
- >> f_rename
- >> f_chmod
- >> f_mkdir
- >> f_unlink
- >> f_getfree
- >> f_stat

validate (Thumb, 54 bytes, Stack size 16 bytes, ff.o(.text))

[Stack]

- Max Depth = 16
- Call Chain = validate

[Calls]

- >> disk_status

[Called By]

- >> f_write
- >> f_read
- >> f_close
- >> f_truncate
- >> f_readdir
- >> f_closedir
- >> f_lseek
- >> f_sync

### Undefined Global Symbols
