makermare/UAV-FlyingControlSystem-LightFlightControl/1. 安装说明必看！/组装调试图.md

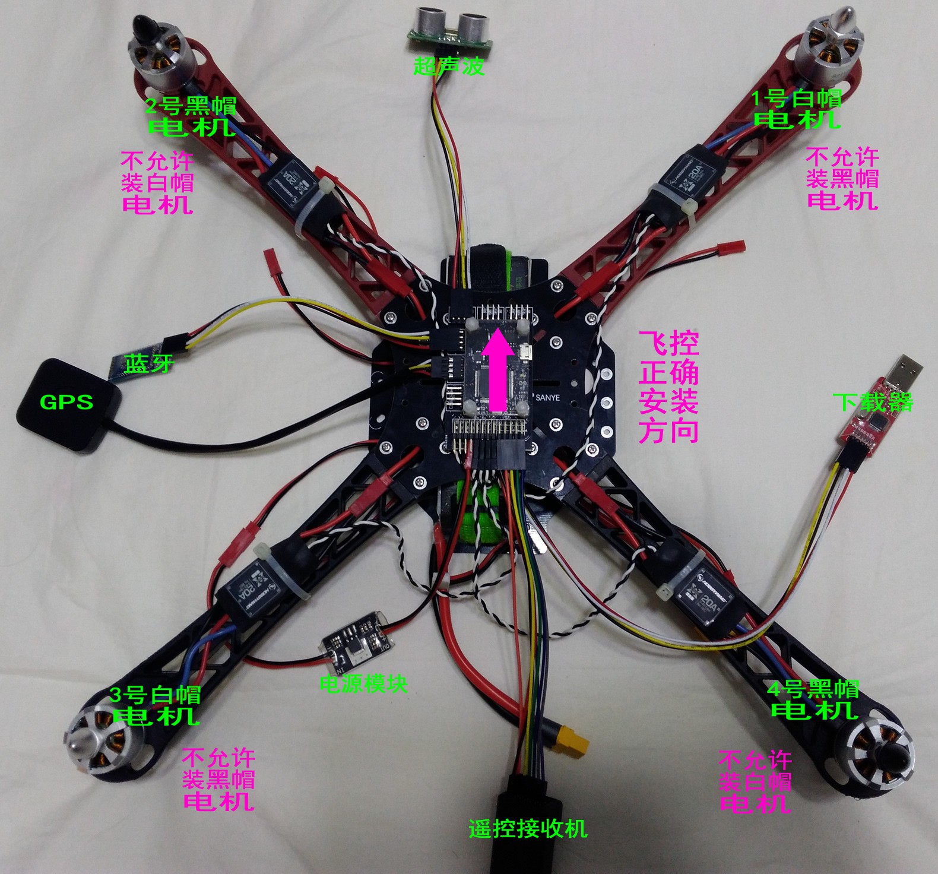
[picture p153: 1. 安装说明必看！/media/image1.jpeg]


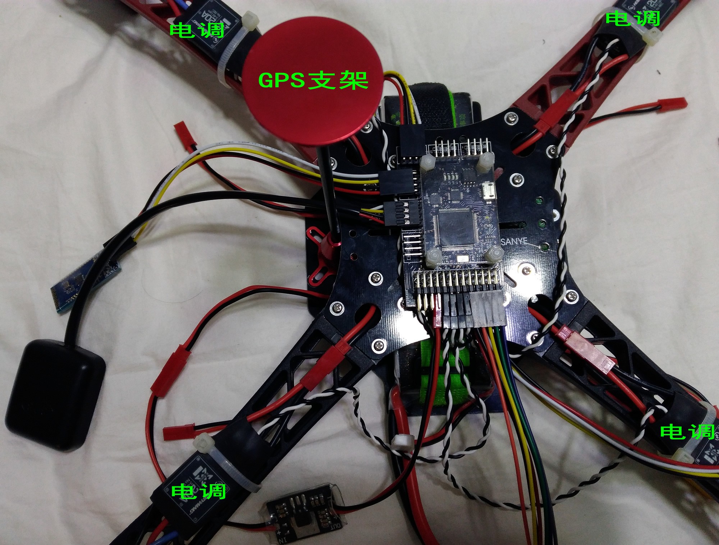
[picture p154: 1. 安装说明必看！/media/image2.jpeg]


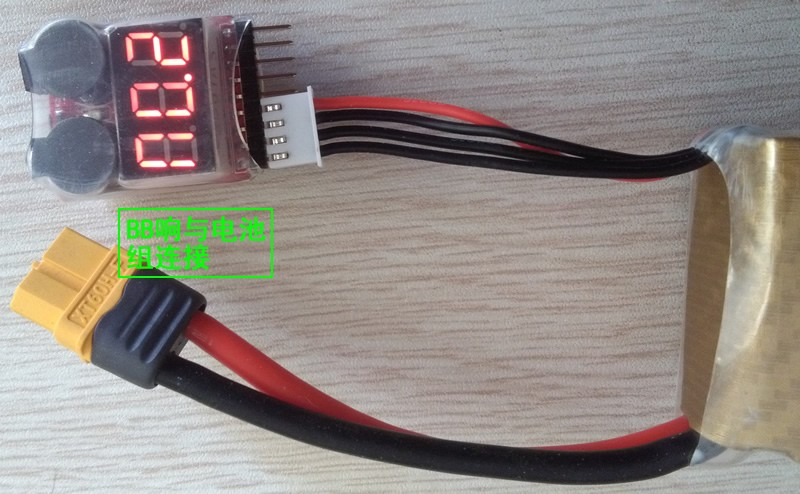
[picture p155: 1. 安装说明必看！/media/image3.jpeg]


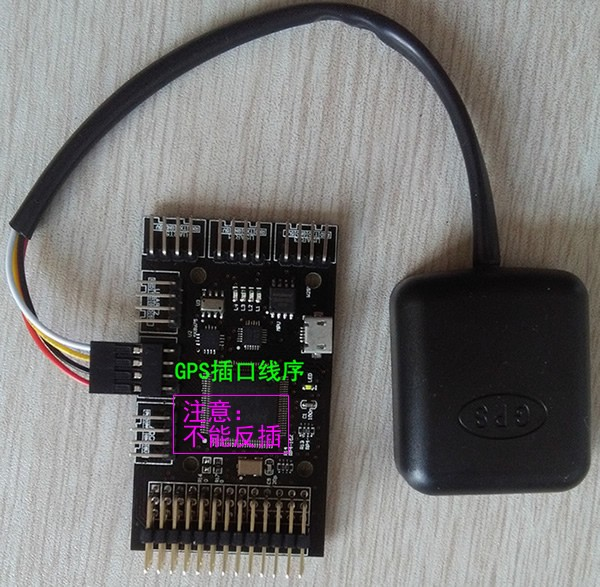
[picture p156: 1. 安装说明必看！/media/image4.jpeg]


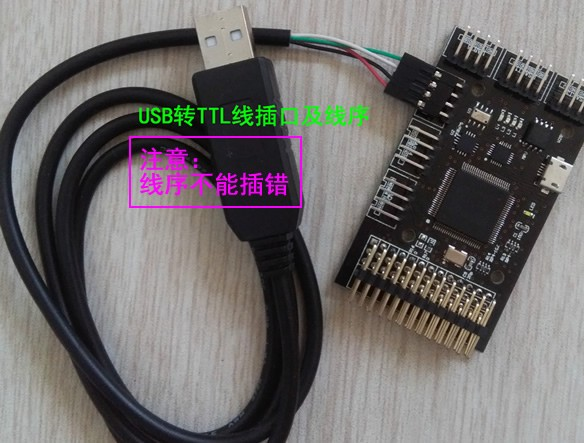
[picture p157: 1. 安装说明必看！/media/image5.jpeg]


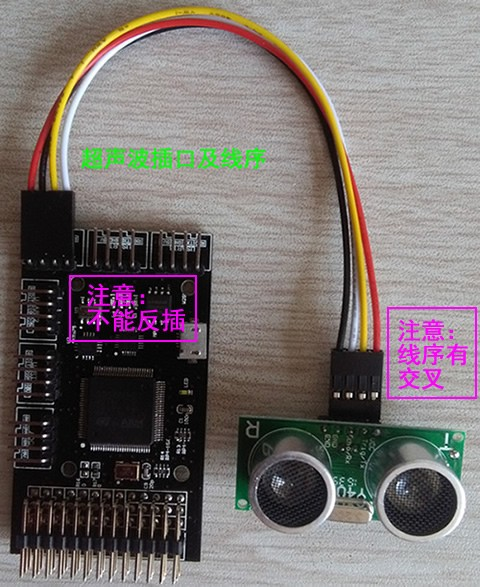
[picture p158: 1. 安装说明必看！/media/image6.jpeg]


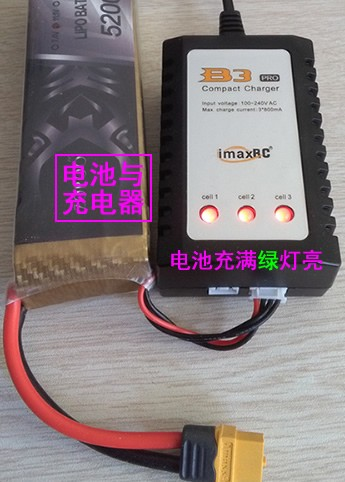
[picture p159: 1. 安装说明必看！/media/image7.jpeg]


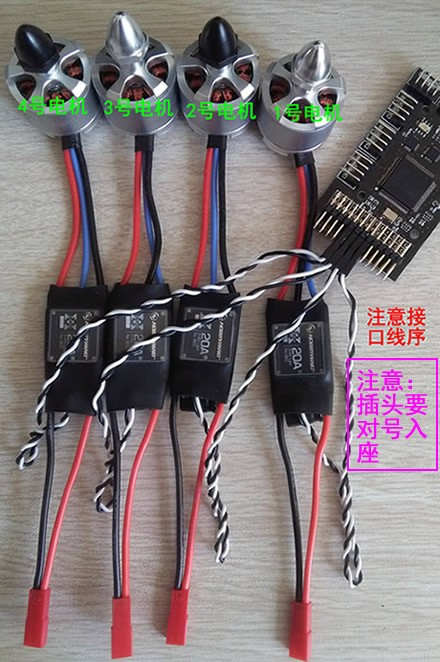
[picture p160: 1. 安装说明必看！/media/image8.jpeg]


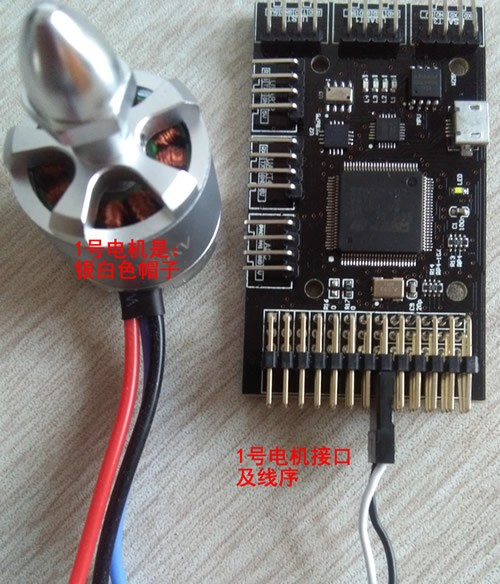
[picture p161: 1. 安装说明必看！/media/image9.jpeg]


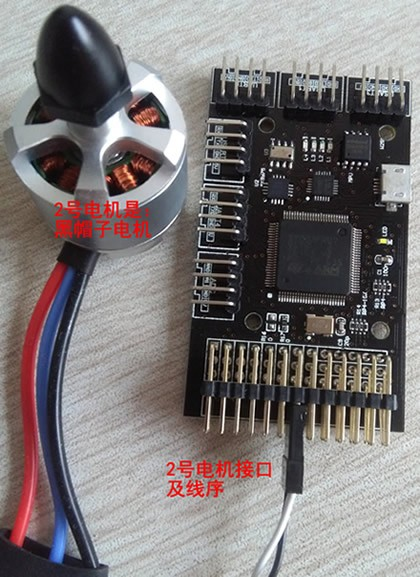
[picture p162: 1. 安装说明必看！/media/image10.jpeg]


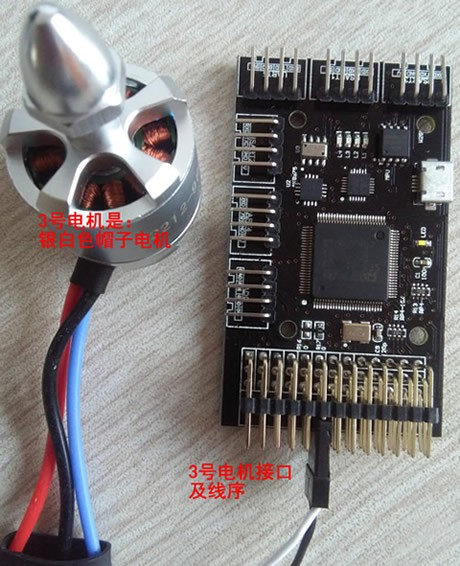
[picture p163: 1. 安装说明必看！/media/image11.jpeg]


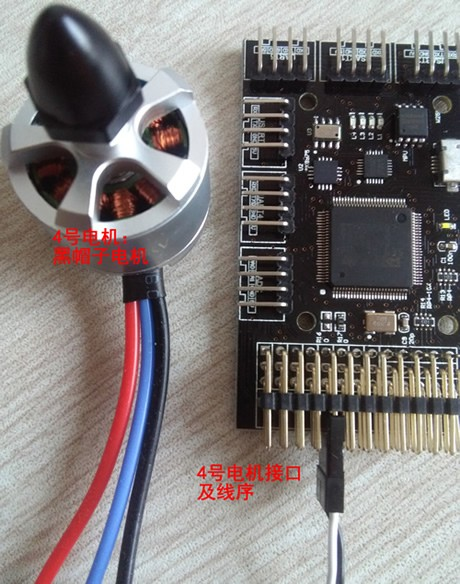
[picture p164: 1. 安装说明必看！/media/image12.jpeg]


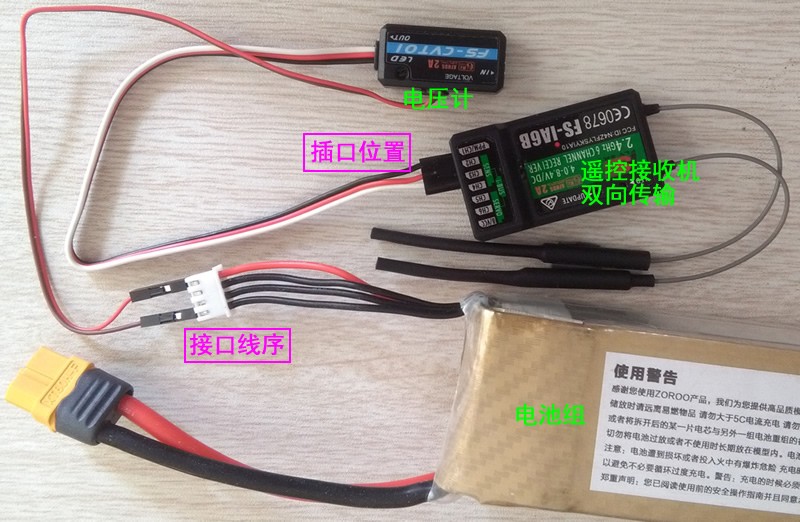
[picture p165: 1. 安装说明必看！/media/image13.jpeg]


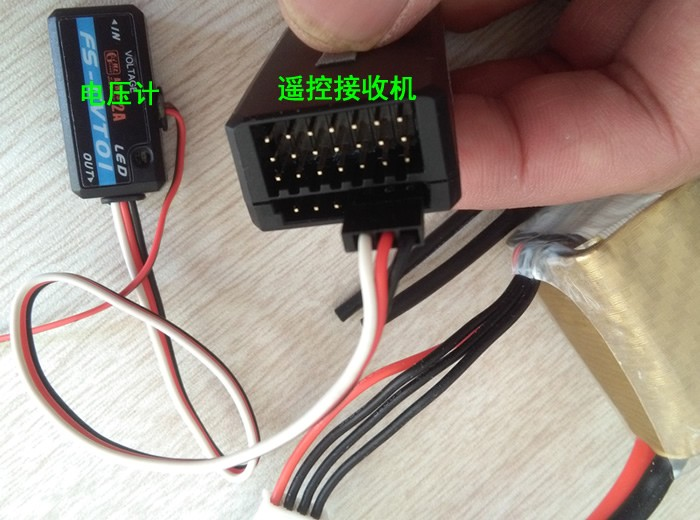
[picture p166: 1. 安装说明必看！/media/image14.jpeg]


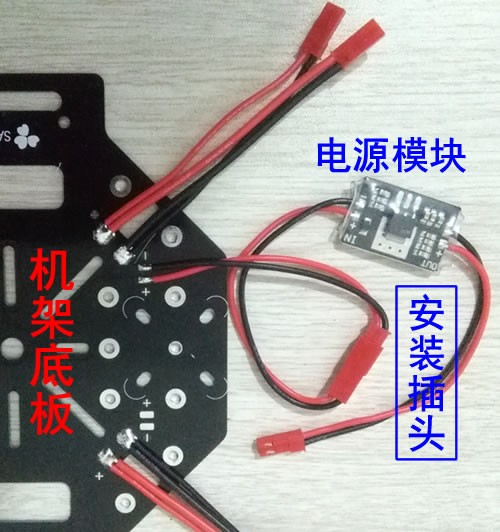
[picture p167: 1. 安装说明必看！/media/image15.jpeg]


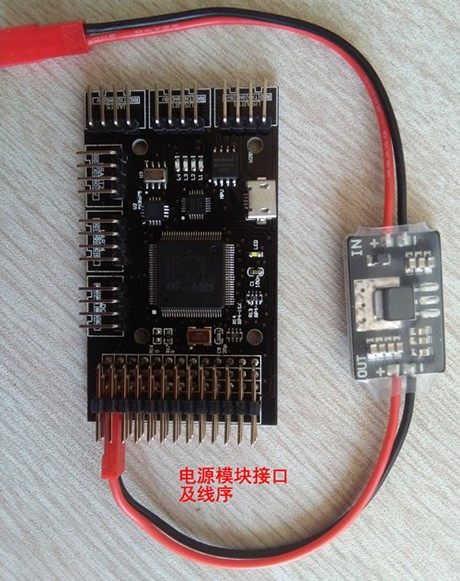
[picture p168: 1. 安装说明必看！/media/image16.jpeg]


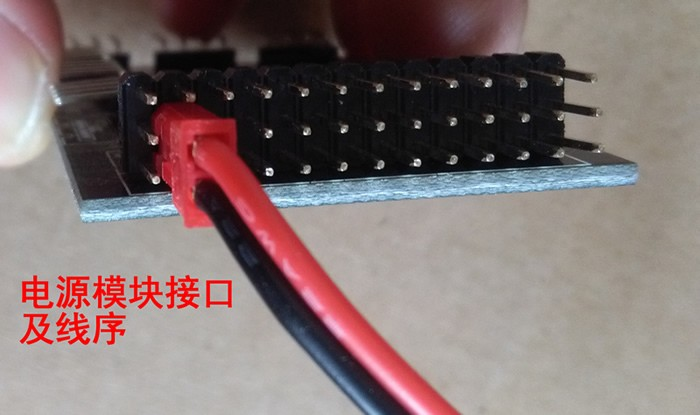
[picture p169: 1. 安装说明必看！/media/image17.jpeg]


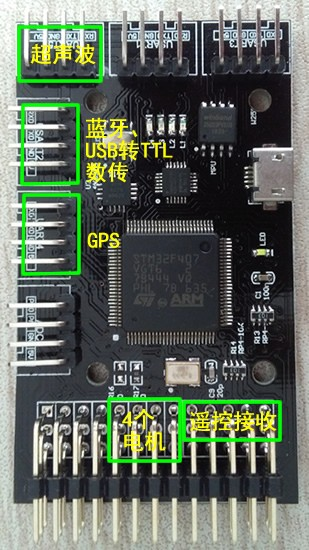
[picture p170: 1. 安装说明必看！/media/image18.jpeg]


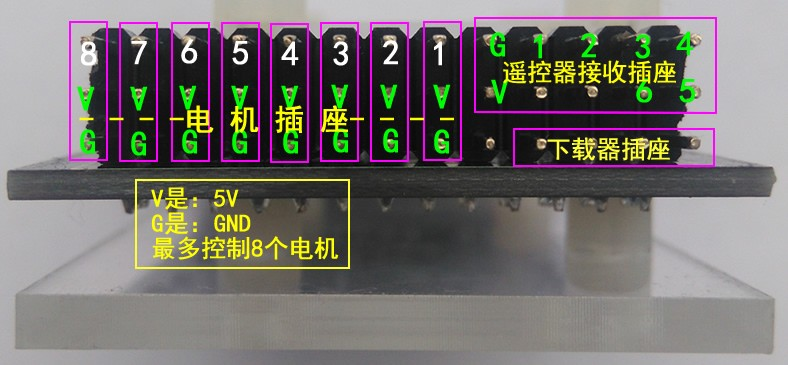
[picture p171: 1. 安装说明必看！/media/image19.jpeg]


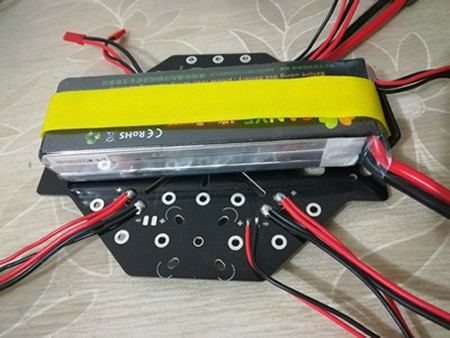
[picture p172: 1. 安装说明必看！/media/image20.jpeg]


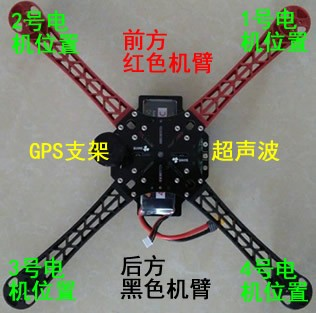
[picture p173: 1. 安装说明必看！/media/image21.jpeg]


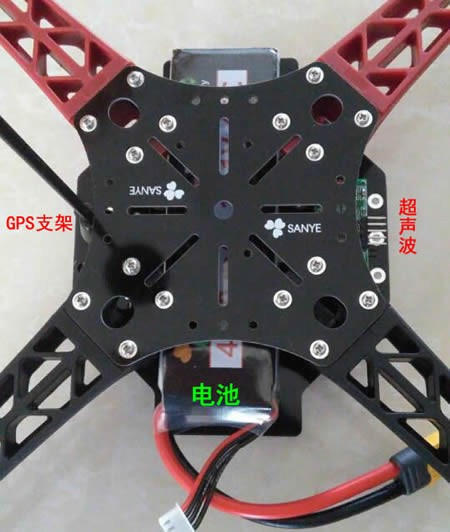
[picture p174: 1. 安装说明必看！/media/image22.jpeg]


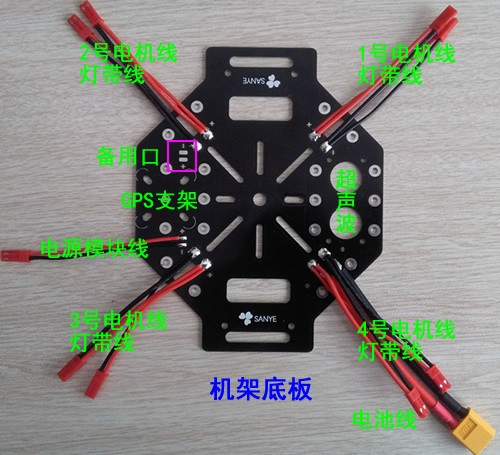
[picture p175: 1. 安装说明必看！/media/image23.jpeg]


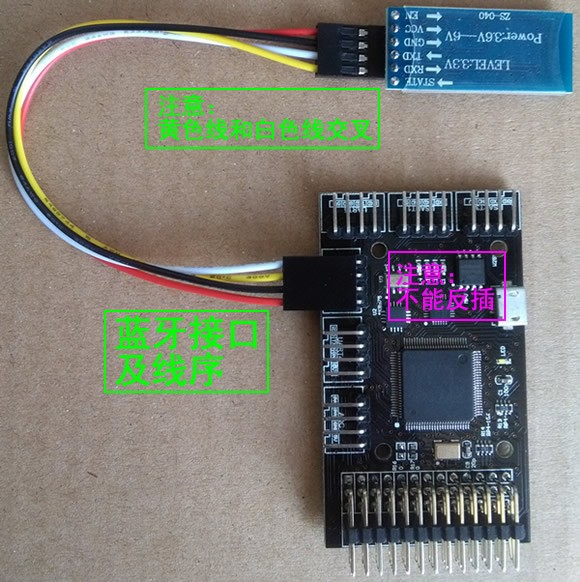
[picture p176: 1. 安装说明必看！/media/image24.jpeg]


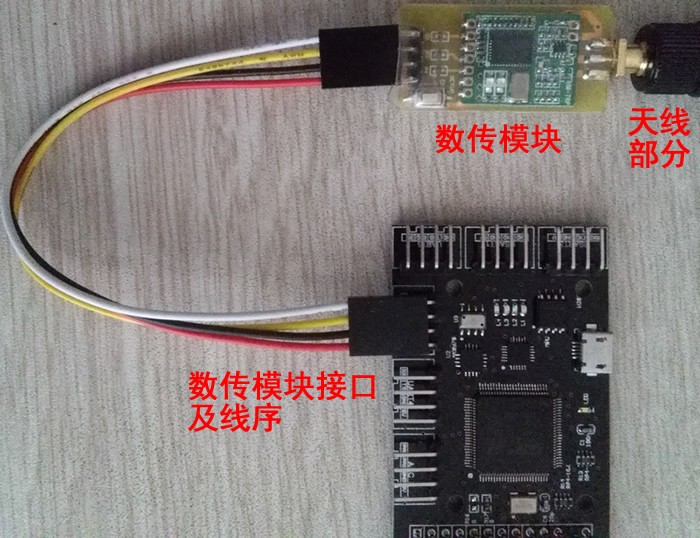
[picture p177: 1. 安装说明必看！/media/image25.jpeg]


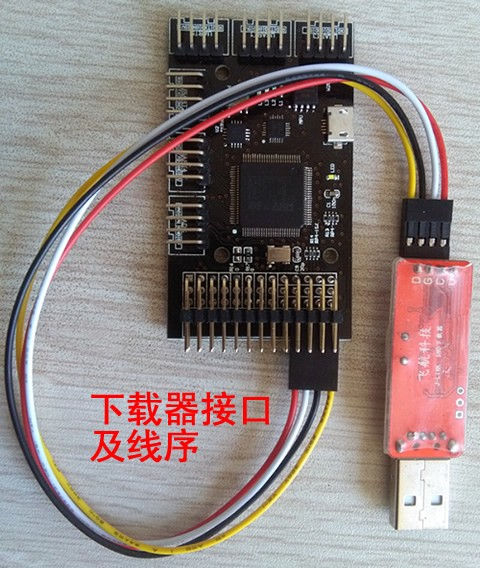
[picture p178: 1. 安装说明必看！/media/image26.jpeg]


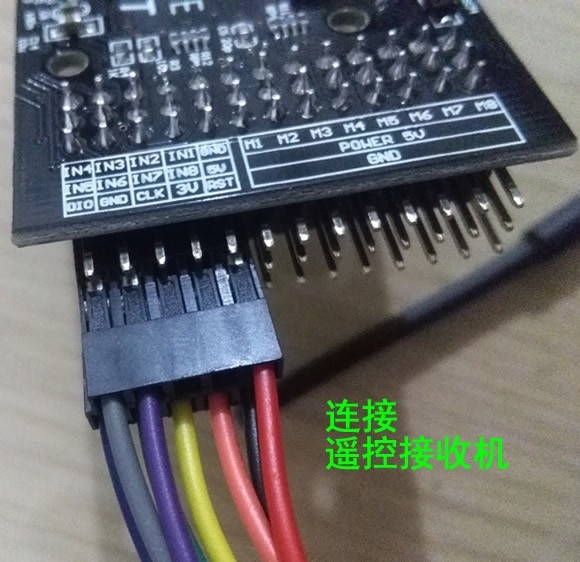
[picture p179: 1. 安装说明必看！/media/image27.jpeg]


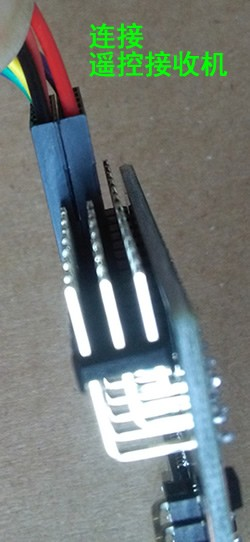
[picture p180: 1. 安装说明必看！/media/image28.jpeg]


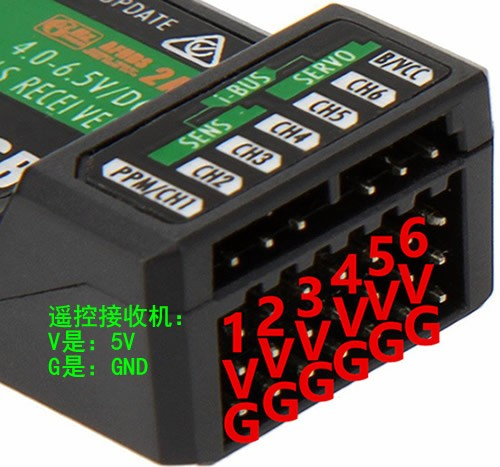
[picture p181: 1. 安装说明必看！/media/image29.jpeg]


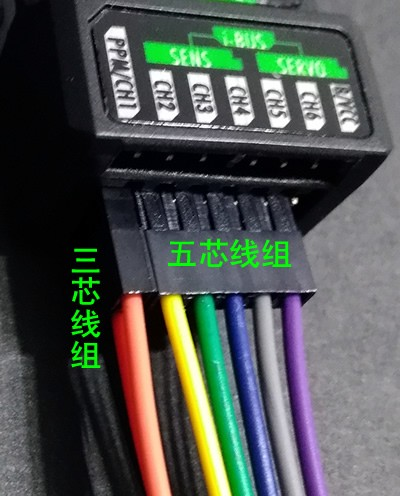
[picture p182: 1. 安装说明必看！/media/image30.jpeg]


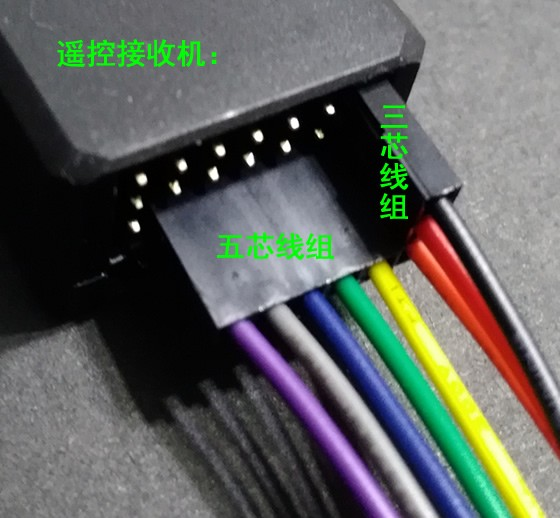
[picture p183: 1. 安装说明必看！/media/image31.jpeg]


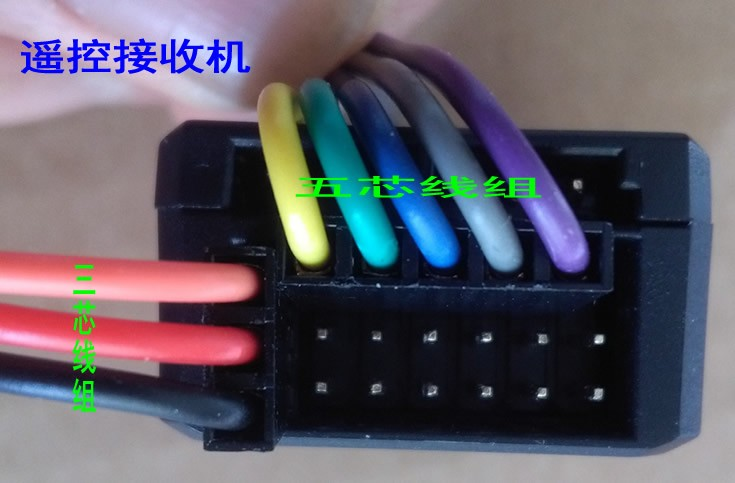
[picture p184: 1. 安装说明必看！/media/image32.jpeg]
