makermare/UAV-FlyingControlSystem-LightFlightControl/5. 飞控官方基础源代码/代码更新日志.txt

有很多版本代码，只需要下载一个即可。后续版本增加了大量注释，便于研究。
已测试均不存在重大BUG，有些客户反映问题是因为，2016-11月后更改了默认参数，请注意！
修改代码请不要随便加延时函数，注意代码严谨，一个细节出问题将会影响整体问题。

默认飞控已载入的程序是：Light飞控源码-2017-02-07 这个程序。

版本优化历史：
1、LightControl飞控源码2016-7-14&LightControl飞控源码2016-7-22：
height_control.c文件增加了超声波定高算法，解决了小概率超声波定高无法起飞问题

2、LightControl飞控源码2016-8-1(默认版本)：LightControl飞控源码2016-8-1(优化)：
device_AK8975.c修改了电子罗盘数据滑动平均滤波为稳定版本，
后者增加了电子罗盘数据滑动平均滤波并校准。

3、LightControl飞控源码2016-10-7&LightControl飞控源码2016-10-17：
driver_GPS.c增加了GPS数据获取及位置信息,单极PID控制位置模型，并发布LightPlannerV2地面站
注意GPS一定要在室外使用，否则室内无法定位。仅首次上电搜星时间较长需要10-20分钟。

4、LightControl飞控源码2016-10-25&Light飞控源码-Beta-2016-11-9：
position.c加速度计积分计算速度和GPS位置差融和计算 串级PID控制位置 代码隔行注释
GPS无法定位，速度数据缺少滤波处理算法，代码里默认不会开启。

5、Light飞控源码-Beta-2016-11-20&Light飞控源码-Beta-2017-01-20
重新建立工程，增加了大量注释，优化了气压、超声波定高算法，更改了默认参数。
发布LIGHT飞控专属通信协议-1.1、LightAssistant1.07、LightPlannerV3

6、Light飞控源码2017-02-08代码增加了：气压超声定高可空中切换！GPS的LED指示！

很多人不懂PID，可以理解为把两个毫不相关的事物通过比例微分积分的方式联系在一起，
参数需要理解后调整。位置部分没有默认参数
比如：
PID1、2、3、4、5、6：每个轴独立
每个轴自稳
输入期望姿态 和当前姿态控制 输出 期望角速度控制量
每个轴速率
输入期望角速度控制量 和当前角速度 输出 作用于电机电调的控制量
PID7、8：
高度保持
输入期望高度位置 和当前高度位置 输出 期望高度速度控制量
高度速率
输入期望高度速度控制量 和当前高度速度 输出 作用于电机电调的控制量
PID9、10：
位置保持(无默认参数)
输入期望位置控制量 和当前位置信息 输出 期望位置速度控制量
位置速率(无默认参数)
输入期望位置速度控制量和当前位置速度信息 输出 期望姿态

LIGHT飞控团队 与2017-02-08日 保留全部源代码著作权
