makermare/UAV-FlyingControlSystem-LightFlightControl/10. 飞控硬件资料/飞控原理图.pdf

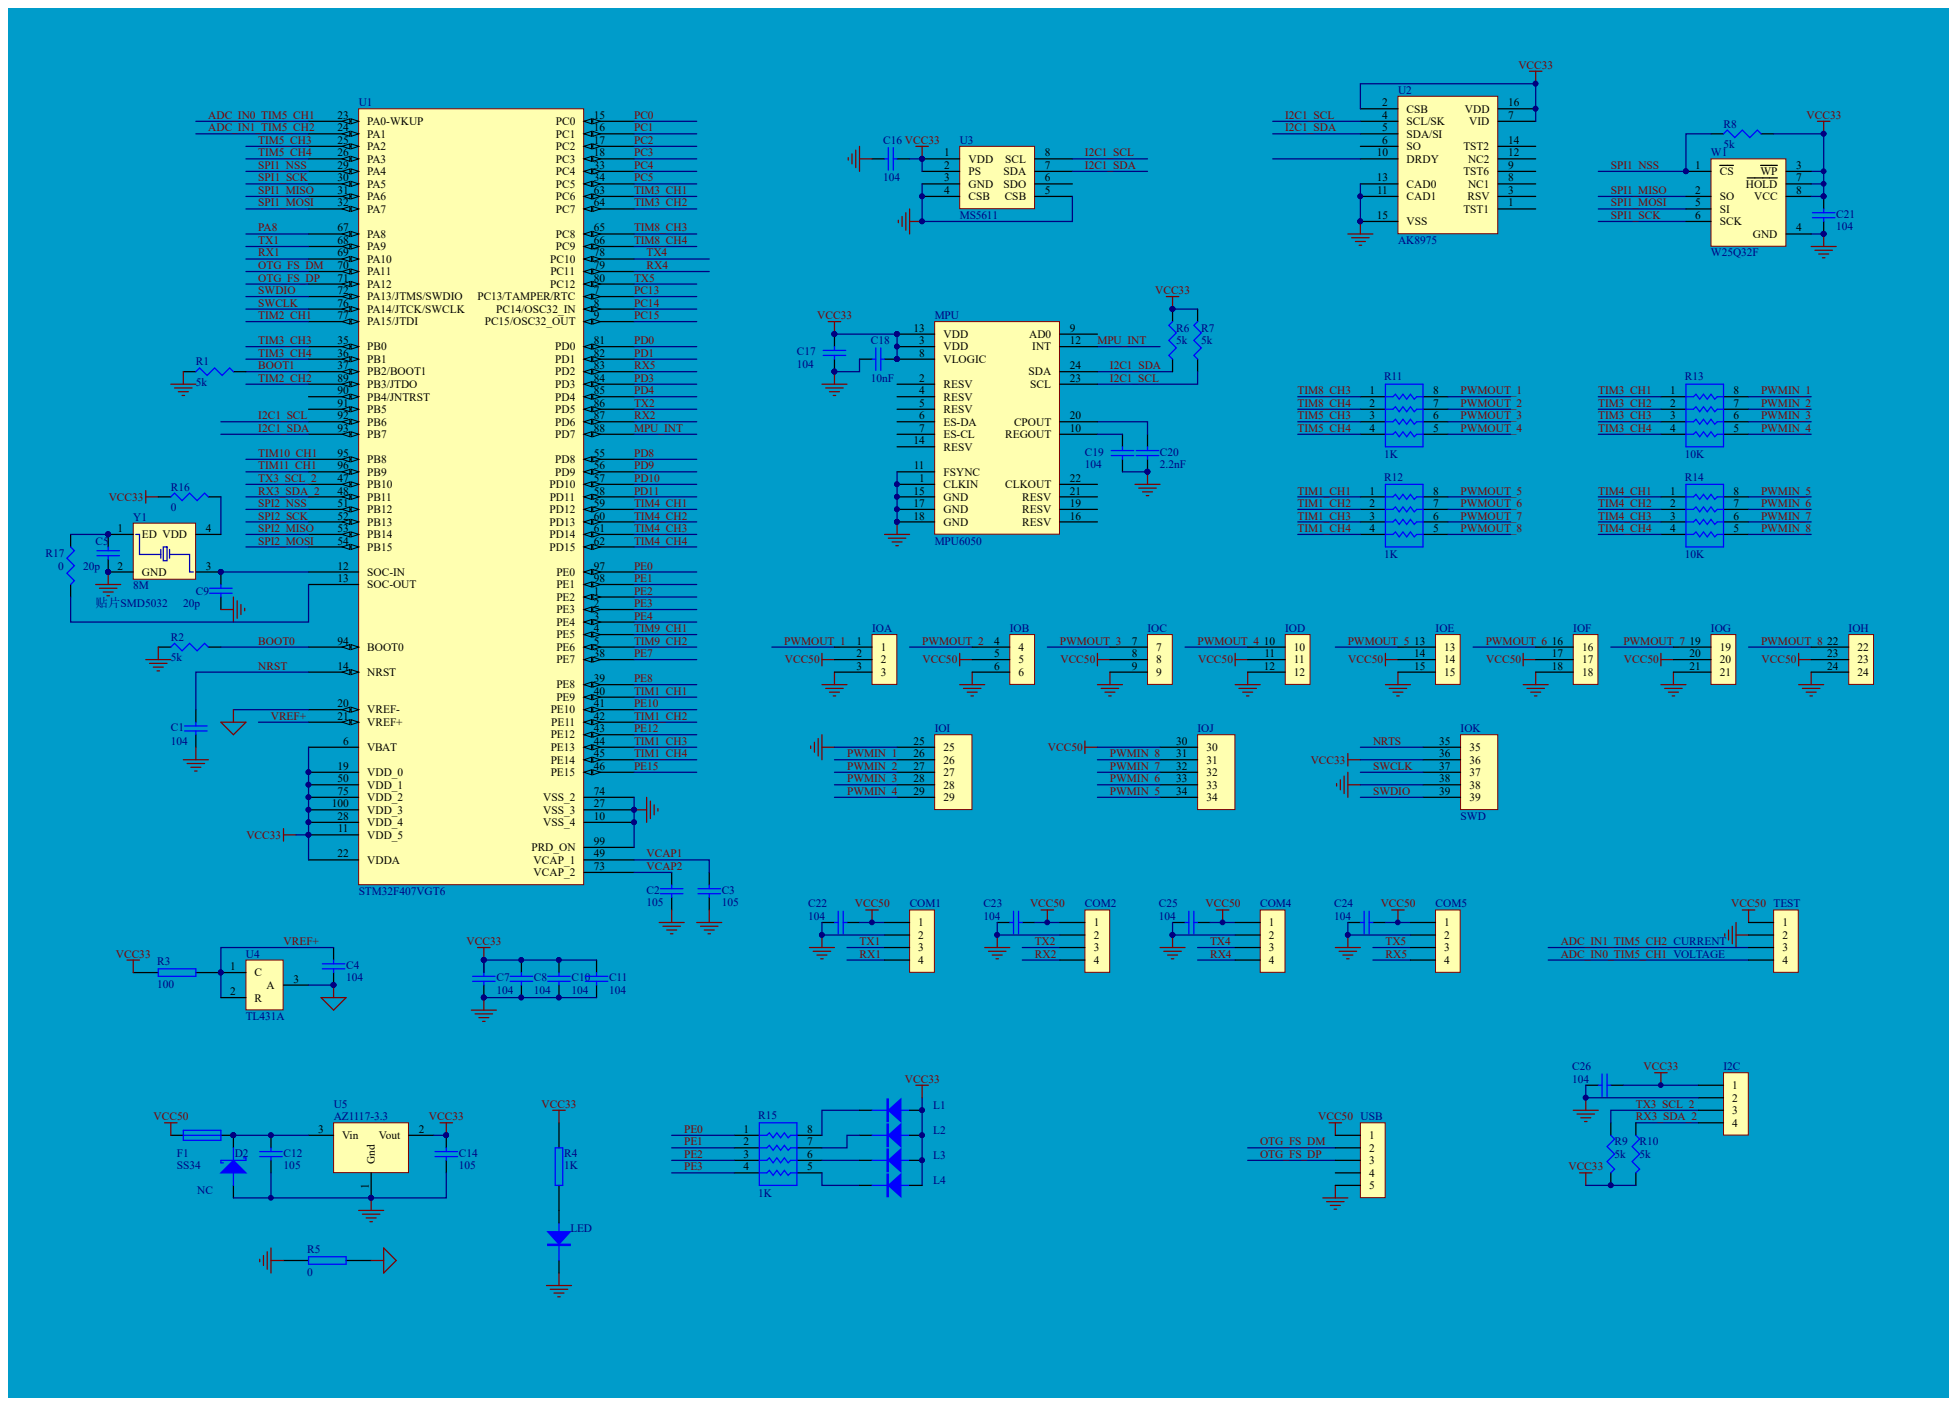
[picture p185: page 1]

VREF- 20

VREF+ | VREF+ 21
