makermare/UAV-FlyingControlSystem-LightFlightControl/8. 飞控三方源代码结合OpenMV/LIGHT飞控代码201708-光流定点(OpenMV串级PID)/applications/ctrl.c

#include "ctrl.h"
#include "height_ctrl.h"
#include "fly_mode.h"

ctrl_t ctrl_1;
ctrl_t ctrl_2;

void Ctrl_Para_Init()//设置默认参数
{
  //==============================
	ctrl_1.PID[PIDROLL].kdamp  = 1;
	ctrl_1.PID[PIDPITCH].kdamp = 1;
	ctrl_1.PID[PIDYAW].kdamp 	 = 1;
	ctrl_1.FB=0.20;   //外  0<fb<1
}

xyz_f_t except_A = {0,0,0};

xyz_f_t ctrl_angle_offset = {0,0,0};

xyz_f_t compensation;
extern u8 PixFlow_TrackLine_flag;
extern float move_front,move_back,turn_right,turn_left;//运动指令
extern float PixFlow_Roll;
extern float PixFlow_Pitch;
extern u8 start_flag;
extern u8 position_control;//位置控制就是进行定点标志=1  进行   =0不进行
void CTRL_2(float T)
{
// 	static xyz_f_t acc_no_g;
// 	static xyz_f_t acc_no_g_lpf;
//=========================== 期望角度 ========================================
	except_A.x  = MAX_CTRL_ANGLE *( my_deathzoom( ( CH_filter[ROL]) ,0,30 )/500.0f );   //30
	except_A.y  = MAX_CTRL_ANGLE *( my_deathzoom( (-CH_filter[PIT]) ,0,30 )/500.0f );  //30
	if(Thr_Low==0)
	{
		except_A.z += (s16)( MAX_CTRL_YAW_SPEED *( my_deathzoom_2( (CH_filter[YAW]) ,0,40 )/500.0f ) ) *T ;  //50
	}
	else
	{
		except_A.z += 1 *3.14 *T *( Yaw - except_A.z );
	}
	except_A.z = To_180_degrees(except_A.z);
  if(PixFlow_TrackLine_flag==1&&position_control!=0)//进入定点模式
	{
	  except_A.x+=PixFlow_Roll;
		except_A.y+=PixFlow_Pitch;
	}
	if(start_flag>=2&&start_flag!=4)
	{
	   except_A.y+=move_front;
		 except_A.z=turn_left;
	}
  /* 得到角度误差 */
	ctrl_2.err.x =  To_180_degrees( ctrl_angle_offset.x + except_A.x - Roll  );
	ctrl_2.err.y =  To_180_degrees( ctrl_angle_offset.y + except_A.y - Pitch );
	ctrl_2.err.z =  To_180_degrees( ctrl_angle_offset.z + except_A.z - Yaw	 );
	/* 计算角度误差权重*/
	ctrl_2.err_weight.x = ABS(ctrl_2.err.x)/ANGLE_TO_MAX_AS;
	ctrl_2.err_weight.y = ABS(ctrl_2.err.y)/ANGLE_TO_MAX_AS;
	ctrl_2.err_weight.z = ABS(ctrl_2.err.z)/ANGLE_TO_MAX_AS;
	/* 角度误差微分（跟随误差曲线变化）*/
	ctrl_2.err_d.x = 10 *ctrl_2.PID[PIDROLL].kd  *(ctrl_2.err.x - ctrl_2.err_old.x) *( 0.005f/T ) ;
	ctrl_2.err_d.y = 10 *ctrl_2.PID[PIDPITCH].kd *(ctrl_2.err.y - ctrl_2.err_old.y) *( 0.005f/T ) ;
	ctrl_2.err_d.z = 10 *ctrl_2.PID[PIDYAW].kd 	 *(ctrl_2.err.z - ctrl_2.err_old.z) *( 0.005f/T ) ;
	/* 角度误差积分 */
	ctrl_2.err_i.x += ctrl_2.PID[PIDROLL].ki  *ctrl_2.err.x *T;
	ctrl_2.err_i.y += ctrl_2.PID[PIDPITCH].ki *ctrl_2.err.y *T;
	ctrl_2.err_i.z += ctrl_2.PID[PIDYAW].ki 	*ctrl_2.err.z *T;
	/* 角度误差积分分离 */
	ctrl_2.eliminate_I.x = Thr_Weight *CTRL_2_INT_LIMIT;
	ctrl_2.eliminate_I.y = Thr_Weight *CTRL_2_INT_LIMIT;
	ctrl_2.eliminate_I.z = Thr_Weight *CTRL_2_INT_LIMIT;
	/* 角度误差积分限幅 */
	ctrl_2.err_i.x = LIMIT( ctrl_2.err_i.x, -ctrl_2.eliminate_I.x,ctrl_2.eliminate_I.x );
	ctrl_2.err_i.y = LIMIT( ctrl_2.err_i.y, -ctrl_2.eliminate_I.y,ctrl_2.eliminate_I.y );
	ctrl_2.err_i.z = LIMIT( ctrl_2.err_i.z, -ctrl_2.eliminate_I.z,ctrl_2.eliminate_I.z );
	/* 记录历史数据 */
	ctrl_2.err_old.x = ctrl_2.err.x;
	ctrl_2.err_old.y = ctrl_2.err.y;
	ctrl_2.err_old.z = ctrl_2.err.z;	
	/* 对用于计算比例项输出的角度误差限幅 */
	ctrl_2.err.x = LIMIT( ctrl_2.err.x, -90, 90 );
	ctrl_2.err.y = LIMIT( ctrl_2.err.y, -90, 90 );
	ctrl_2.err.z = LIMIT( ctrl_2.err.z, -90, 90 );
	/* 角度PID输出 */
	ctrl_2.out.x = ctrl_2.PID[PIDROLL].kp  *( ctrl_2.err.x + ctrl_2.err_d.x + ctrl_2.err_i.x );	//rol
	ctrl_2.out.y = ctrl_2.PID[PIDPITCH].kp *( ctrl_2.err.y + ctrl_2.err_d.y + ctrl_2.err_i.y );  //pit
	ctrl_2.out.z = ctrl_2.PID[PIDYAW].kp   *( ctrl_2.err.z + ctrl_2.err_d.z + ctrl_2.err_i.z );
}

xyz_f_t except_AS;

float g_old[ITEMS];

void CTRL_1(float T)  //x roll,y pitch,z yaw
{
	xyz_f_t EXP_LPF_TMP;
	/* 给期望（目标）角速度 */
	EXP_LPF_TMP.x = MAX_CTRL_ASPEED *(ctrl_2.out.x/ANGLE_TO_MAX_AS);//*( (CH_filter[0])/500.0f );//
	EXP_LPF_TMP.y = MAX_CTRL_ASPEED *(ctrl_2.out.y/ANGLE_TO_MAX_AS);//*( (CH_filter[1])/500.0f );//
	EXP_LPF_TMP.z = MAX_CTRL_YAW_SPEED *(ctrl_2.out.z/ANGLE_TO_MAX_AS);
	
	except_AS.x = EXP_LPF_TMP.x;//20 *3.14 *T *( EXP_LPF_TMP.x - except_AS.x );//
	except_AS.y = EXP_LPF_TMP.y;//20 *3.14 *T *( EXP_LPF_TMP.y - except_AS.y );//
	except_AS.z = EXP_LPF_TMP.z;//20 *3.14 *T *( EXP_LPF_TMP.z - except_AS.z );//
	/* 期望角速度限幅 */
	except_AS.x = LIMIT(except_AS.x, -MAX_CTRL_ASPEED,MAX_CTRL_ASPEED );
	except_AS.y = LIMIT(except_AS.y, -MAX_CTRL_ASPEED,MAX_CTRL_ASPEED );
	except_AS.z = LIMIT(except_AS.z, -MAX_CTRL_YAW_SPEED,MAX_CTRL_YAW_SPEED );

	/* 角速度直接微分（角加速度），负反馈可形成角速度的阻尼（阻碍角速度的变化）*/
	ctrl_1.damp.x = ( mpu6050.Gyro_deg.x - g_old[A_X]) *( 0.002f/T );//ctrl_1.PID[PIDROLL].kdamp
	ctrl_1.damp.y = (-mpu6050.Gyro_deg.y - g_old[A_Y]) *( 0.002f/T );//ctrl_1.PID[PIDPITCH].kdamp *
	ctrl_1.damp.z = (-mpu6050.Gyro_deg.z - g_old[A_Z]) *( 0.002f/T );//ctrl_1.PID[PIDYAW].kdamp	 *
	/* 角速度误差 */
	ctrl_1.err.x =  ( except_AS.x - mpu6050.Gyro_deg.x ) *(300.0f/MAX_CTRL_ASPEED);
	ctrl_1.err.y =  ( except_AS.y + mpu6050.Gyro_deg.y ) *(300.0f/MAX_CTRL_ASPEED);  //-y
	ctrl_1.err.z =  ( except_AS.z + mpu6050.Gyro_deg.z ) *(300.0f/MAX_CTRL_ASPEED);	 //-z
	/* 角速度误差权重 */
	ctrl_1.err_weight.x = ABS(ctrl_1.err.x)/MAX_CTRL_ASPEED;
	ctrl_1.err_weight.y = ABS(ctrl_1.err.y)/MAX_CTRL_ASPEED;
	ctrl_1.err_weight.z = ABS(ctrl_1.err.z)/MAX_CTRL_YAW_SPEED;
	/* 角速度微分 */
	ctrl_1.err_d.x = ( ctrl_1.PID[PIDROLL].kd  *( -10 *ctrl_1.damp.x) *( 0.002f/T ) );
	ctrl_1.err_d.y = ( ctrl_1.PID[PIDPITCH].kd *( -10 *ctrl_1.damp.y) *( 0.002f/T ) );
	ctrl_1.err_d.z = ( ctrl_1.PID[PIDYAW].kd   *( -10 *ctrl_1.damp.z) *( 0.002f/T ) );

	/* 角速度误差积分 */
	ctrl_1.err_i.x += ctrl_1.PID[PIDROLL].ki  *(ctrl_1.err.x - ctrl_1.damp.x) *T;
	ctrl_1.err_i.y += ctrl_1.PID[PIDPITCH].ki *(ctrl_1.err.y - ctrl_1.damp.y) *T;
	ctrl_1.err_i.z += ctrl_1.PID[PIDYAW].ki 	*(ctrl_1.err.z - ctrl_1.damp.z) *T;
	/* 角速度误差积分分离 */
	ctrl_1.eliminate_I.x = Thr_Weight *CTRL_1_INT_LIMIT ;
	ctrl_1.eliminate_I.y = Thr_Weight *CTRL_1_INT_LIMIT ;
	ctrl_1.eliminate_I.z = Thr_Weight *CTRL_1_INT_LIMIT ;
	/* 角速度误差积分限幅 */
	ctrl_1.err_i.x = LIMIT( ctrl_1.err_i.x, -ctrl_1.eliminate_I.x,ctrl_1.eliminate_I.x );
	ctrl_1.err_i.y = LIMIT( ctrl_1.err_i.y, -ctrl_1.eliminate_I.y,ctrl_1.eliminate_I.y );
	ctrl_1.err_i.z = LIMIT( ctrl_1.err_i.z, -ctrl_1.eliminate_I.z,ctrl_1.eliminate_I.z );
	/* 角速度PID输出 */
	ctrl_1.out.x = 2 *( ctrl_1.FB *LIMIT((0.45f + 0.55f*ctrl_2.err_weight.x),0,1)*except_AS.x + ( 1 - ctrl_1.FB ) *ctrl_1.PID[PIDROLL].kp  *( ctrl_1.err.x + ctrl_1.err_d.x + ctrl_1.err_i.x ) );
										//*(MAX_CTRL_ASPEED/300.0f);
	ctrl_1.out.y = 2 *( ctrl_1.FB *LIMIT((0.45f + 0.55f*ctrl_2.err_weight.y),0,1)*except_AS.y + ( 1 - ctrl_1.FB ) *ctrl_1.PID[PIDPITCH].kp *( ctrl_1.err.y + ctrl_1.err_d.y + ctrl_1.err_i.y ) );
										//*(MAX_CTRL_ASPEED/300.0f);
	ctrl_1.out.z = 4 *( ctrl_1.FB *LIMIT((0.45f + 0.55f*ctrl_2.err_weight.z),0,1)*except_AS.z + ( 1 - ctrl_1.FB ) *ctrl_1.PID[PIDYAW].kp   *( ctrl_1.err.z + ctrl_1.err_d.z + ctrl_1.err_i.z ) );
										//*(MAX_CTRL_ASPEED/300.0f);
	Thr_Ctrl(T);// 油门控制
	
	All_Out(ctrl_1.out.x,ctrl_1.out.y,ctrl_1.out.z);

	ctrl_1.err_old.x = ctrl_1.err.x;
	ctrl_1.err_old.y = ctrl_1.err.y;
	ctrl_1.err_old.z = ctrl_1.err.z;

	g_old[A_X] =  mpu6050.Gyro_deg.x ;
	g_old[A_Y] = -mpu6050.Gyro_deg.y ;
	g_old[A_Z] = -mpu6050.Gyro_deg.z ;
}

float thr_value;
u8 Thr_Low;
float Thr_Weight;

void Thr_Ctrl(float T)
{
	static float thr;
	static float Thr_tmp;
	if(mode_state==0)
	{
	  thr = 500 + CH_filter[THR]; //油门值 0 ~ 1000
	}
	else 
	{
		 thr=500;
	}
	Thr_tmp += 10 *3.14f *T *(thr_value/400.0f - Thr_tmp); //低通滤波
	Thr_Weight = LIMIT(Thr_tmp,0,1);    							//后边多处分离数据会用到这个值
	
	if( thr < 100)
	{
		Thr_Low = 1;
	}
	else
	{
		Thr_Low = 0;
	}
	
/////////////////////////////////////////////////////////////////
	//如果是定高模式进入定高模式
	if(mode_value[BARO])
	{
		if(NS==0) //丢失信号,这个可以不用考虑
		{
			thr = LIMIT(thr,0,500);
		}
		thr_value = Height_Ctrl(T,thr,fly_ready,1);   //实际使用值。进入定高串级PID控制
	
	}
	//如果是非定高模式进入手动控制模式，，
	else
	{
		if(NS==0) //丢失信号
		{
			thr = LIMIT(thr,0,350);
		}
		thr_value = Height_Ctrl(T,thr,fly_ready,0);   //en=0，，实际没有作用，，返回值为thr
	}
	thr_value = LIMIT(thr_value,0,10 *MAX_THR *MAX_PWM/100);
}

float motor[MAXMOTORS];
float posture_value[MAXMOTORS];
float curve[MAXMOTORS];
	s16 motor_out[MAXMOTORS];
void All_Out(float out_roll,float out_pitch,float out_yaw)
{

	u8 i;
	float posture_value[MAXMOTORS];
  //float curve[MAXMOTORS];
	

	out_yaw = LIMIT( out_yaw , -5*MAX_THR ,5*MAX_THR ); //50%
	
#if (MAXMOTORS == 4)	
	
	posture_value[0] = - out_roll + out_pitch + out_yaw ;
	posture_value[1] = + out_roll + out_pitch - out_yaw ;
	posture_value[2] = + out_roll - out_pitch + out_yaw ;
	posture_value[3] = - out_roll - out_pitch - out_yaw ;
	
#elif (MAXMOTORS == 6)
	//0.866 == sqrt(3)/2    4/6 == 0.667f
	posture_value[0] = - 0.866f *out_roll + out_pitch + 0.667f *out_yaw ;
	posture_value[1] = + 0.866f *out_roll + out_pitch - 0.667f *out_yaw ;
	posture_value[2] = + 0.866f *out_roll             + 0.667f *out_yaw ;
	posture_value[3] = + 0.866f *out_roll - out_pitch - 0.667f *out_yaw ;
	posture_value[4] = - 0.866f *out_roll - out_pitch + 0.667f *out_yaw ;
	posture_value[5] = - 0.866f *out_roll             - 0.667f *out_yaw ;
	
#elif (MAXMOTORS == 8)
	posture_value[0] = - 0.5f *out_roll + 0.5f *out_pitch + 0.5f *out_yaw ;
	posture_value[1] = + 0.5f *out_roll + 0.5f *out_pitch - 0.5f *out_yaw ;
	posture_value[2] = + 0.5f *out_roll + 0.5f *out_pitch + 0.5f *out_yaw ;
	posture_value[3] = + 0.5f *out_roll - 0.5f *out_pitch - 0.5f *out_yaw ;
	posture_value[4] = + 0.5f *out_roll - 0.5f *out_pitch + 0.5f *out_yaw ;
	posture_value[5] = - 0.5f *out_roll - 0.5f *out_pitch - 0.5f *out_yaw ;
	posture_value[6] = - 0.5f *out_roll - 0.5f *out_pitch + 0.5f *out_yaw ;
	posture_value[7] = - 0.5f *out_roll + 0.5f *out_pitch - 0.5f *out_yaw ;	
	
#else

#endif	
	for(i=0;i<MAXMOTORS;i++)
	{
		posture_value[i] = LIMIT(posture_value[i], -1000,1000 );
		
		motor[i] = thr_value + Thr_Weight *posture_value[i] ;
	}
	
//	curve[0] = posture_value[0] ;//(0.55f + 0.45f *ABS(posture_value[0])/1000.0f) *
//	curve[1] = posture_value[1] ;//(0.55f + 0.45f *ABS(posture_value[1])/1000.0f) *
//	curve[2] = posture_value[2] ;//(0.55f + 0.45f *ABS(posture_value[2])/1000.0f) *
//	curve[3] = posture_value[3] ;//(0.55f + 0.45f *ABS(posture_value[3])/1000.0f) *
//	
//  motor[0] = thr_value + Thr_Weight *curve[0] ;
//	motor[1] = thr_value + Thr_Weight *curve[1] ;
//	motor[2] = thr_value + Thr_Weight *curve[2] ;
//	motor[3] = thr_value + Thr_Weight *curve[3] ;
	
	/* 是否解锁 */
	if(fly_ready)
	{
		if(!Thr_Low)  //油门拉起
		{
			for(i=0;i<MAXMOTORS;i++)
			{
				motor[i] = LIMIT(motor[i], (10 *READY_SPEED),(10*MAX_PWM) );
			}
		}
		else						//油门低
		{
			for(i=0;i<MAXMOTORS;i++)
			{
				motor[i] = LIMIT(motor[i], 100,(10*MAX_PWM) );
			}
		}
	}
	else
	{
		for(i=0;i<MAXMOTORS;i++)
		{
			motor[i] = 0;
		}
	}
	/* xxx */
	for(i=0;i<MAXMOTORS;i++)
	{
		motor_out[i] = (s16)(motor[i]);
	}
		
//	motor_out[0] = (s16)(motor[0]);  
//	motor_out[1] = (s16)(motor[1]);	 
//	motor_out[2] = (s16)(motor[2]);
//	motor_out[3] = (s16)(motor[3]);

	
	SetPwm(motor_out,0,1000); //1000
	
}
