makermare/UAV-FlyingControlSystem-LightFlightControl/7. 飞控三方源代码-基础部分/LIGHT飞控三方代码Keil工程12017-07-20/applications/PID.c

#include "PID.h"



float PID_calculate( float T,            //周期（单位：秒）
										float in_ff,				//前馈值
										float expect,				//期望值（设定值）
										float feedback,			//反馈值（）
										_PID_arg_st *pid_arg, //PID参数结构体
										_PID_val_st *pid_val,	//PID数据结构体
										float inte_lim			//integration limit，积分限幅
										 )	
{
	float out,differential;
	pid_arg->k_inc_d_norm = LIMIT(pid_arg->k_inc_d_norm,0,1);
	
	pid_val->feedback_d = (-1.0f) *(feedback - pid_val->feedback_old) *safe_div(1.0f,T,0);
	
	pid_val->err =  (expect - feedback );
	
	pid_val->err_d = (pid_val->err - pid_val->err_old) *safe_div(1.0f,T,0);
	
	differential = (pid_arg->kd *pid_val->err_d + pid_arg->k_pre_d *pid_val->feedback_d);
	
	LPF_1_(pid_arg->inc_hz,T,differential,pid_val->err_d_lpf );
	
	pid_val->err_i += (pid_val->err + pid_arg->k_pre_d *pid_val->feedback_d )*T;//)*T;//
	pid_val->err_i = LIMIT(pid_val->err_i,-inte_lim,inte_lim);
	
	out = pid_arg->k_ff *in_ff 
	    + pid_arg->kp *pid_val->err  
	    + pid_arg->k_inc_d_norm *pid_val->err_d_lpf + (1.0f-pid_arg->k_inc_d_norm) *differential
    	+ pid_arg->ki *pid_val->err_i;
	
	pid_val->feedback_old = feedback;
	pid_val->err_old = pid_val->err;
	
	return (out);
}
