makermare/UAV-FlyingControlSystem-LightFlightControl/8. 飞控三方源代码结合OpenMV/LIGHT飞控代码201708-光流定点(OpenMV串级PID)/applications/baro_ctrl.c

#include "baro_ctrl.h"
#include "ms5611.h"
#include "filter.h"
#include "fly_mode.h"

float baro_compensate(float dT,float kup,float kdw,float vz,float lim)
{
	float z_sin;
	static float com_val,com_tar;
	
	z_sin = my_sqrt(1-my_pow(vz));
	
	//com_tar = (z_sin/0.44f) *lim;
	LPF_1_(2.0f,dT,((z_sin/0.44f) *lim),com_tar);
	com_tar = LIMIT(com_tar,0,lim);
	
	if(com_val<(com_tar-100))
	{
		com_val += 1000 *dT *kup;
	}
	else if(com_val>(com_tar+100))
	{
		com_val -= 1000 *dT *kdw;
	}
	return (com_val);
}

void fusion_prepare(float dT,float av_arr[],u16 av_num,u16 *av_cnt,float deadzone,_height_st *data,_fusion_p_st *pre_data)
{
	pre_data->dis_deadzone = my_deathzoom(data->relative_height,pre_data->dis_deadzone,deadzone);	
	Moving_Average(av_arr,av_num ,(av_cnt),(10 *pre_data->dis_deadzone ),&(pre_data->displacement)); //厘米->毫米
	
	pre_data->speed = safe_div(pre_data->displacement - pre_data->displacement_old,dT,0);
	pre_data->acceleration = safe_div(pre_data->speed - pre_data->speed_old,dT,0);
	
	pre_data->displacement_old = pre_data->displacement;
	pre_data->speed_old = pre_data->speed;
}

void acc_fusion(float dT,_f_set_st *set,float est_acc,_fusion_p_st *pre_data,_fusion_st *fusion)
{
	fusion->fusion_acceleration.out += est_acc - fusion->est_acc_old; //估计
	filter_1(set->b1,set->g1,dT,pre_data->acceleration,&(fusion->fusion_acceleration));  //pre_data->acceleration //观测、最优
	
	fusion->fusion_speed_m.out += 1.1f *my_deathzoom(fusion->fusion_acceleration.out,0,20) *dT;
	filter_1(set->b2,set->g2,dT,pre_data->speed,&(fusion->fusion_speed_m));
	filter_1(set->b2,set->g2,dT,(-pre_data->speed + fusion->fusion_speed_m.out),&(fusion->fusion_speed_me));
	fusion->fusion_speed_me.out = LIMIT(fusion->fusion_speed_me.out,-200,200);
	fusion->fusion_speed_m.a = LIMIT(fusion->fusion_speed_m.a,-1000,1000);
	
	fusion->fusion_displacement.out += 1.05f *(fusion->fusion_speed_m.out - fusion->fusion_speed_me.out) *dT;
	filter_1(set->b3,set->g3,dT,pre_data->displacement,&(fusion->fusion_displacement));
	
	fusion->est_acc_old = est_acc;
}

//超声波融合参数

#define SONAR_AV_NUM 50
float sonar_av_arr[SONAR_AV_NUM];
u16 sonar_av_cnt;

_fusion_p_st sonar;
_fusion_st sonar_fusion;
_f_set_st sonar_f_set = {
													0.2f,
													0.5f,
													0.8f,
													
													0.2f,
													0.5f,
													0.8f	
//													0.2f,
//													0.3f,
//													0.5f,
//													
//													0.1f,
//													0.3f,
//													0.5f

												};

//气压计融合参数											
#define BARO_AV_NUM 100
float baro_av_arr[BARO_AV_NUM];
u16 baro_av_cnt;
_fusion_p_st baro_p;
_fusion_st baro_fusion;
_f_set_st baro_f_set = {
													0.1f,
													0.2f,
													0.3f,
													
													0.1f,
													0.1f,
													0.2f	
//													0.2f,
//													0.3f,
//													0.5f,
//													
//													0.1f,
//													0.3f,
//													0.5f

												};
float sonar_weight;
float wz_speed,baro_com_val;				
void baro_ctrl(float dT,_hc_value_st *height_value)
{
	static u8 step;
	static float dtime;
	//
	switch(step)
	{
		case 0:
		{
			step = 1;
			break;
		}
		case 1:
		{
			step = 2;
			break;
		}
		case 2:
		{
			
			step = 3;
			break;
		}
		case 3:
		{
			
			step = 4;
			break;
		}	
		case 4:
		{
			
			step = 0;
			break;
		}	
		default:break;	
	}

	dtime+=dT;
	if(dtime>0.01f) //10 ms
	{
		dtime = 0;
 		if(!MS5611_Update())//更新ms5611气压计数据
		{
			baro.relative_height = baro.relative_height - 0.1f *baro_com_val;
			if(step==0)
			{
			 step = 1;//20ms
			}
		}		
	}		
			baro.h_dt = 0.02f; //气压计读取间隔时间20ms
			
			baro_com_val = baro_compensate(dT,1.0f,1.0f,reference_v.z,3500);
	    
			fusion_prepare(dT,sonar_av_arr,SONAR_AV_NUM,&sonar_av_cnt,0,&ultra,&sonar);
			acc_fusion(dT,&sonar_f_set,acc_3d_hg.z,&sonar,&sonar_fusion);
			
			fusion_prepare(dT,baro_av_arr,BARO_AV_NUM,&baro_av_cnt,2,&baro,&baro_p);
			acc_fusion(dT,&baro_f_set,acc_3d_hg.z,&baro_p,&baro_fusion);
	    
//////////////////////////////////////////				
			if(ultra.measure_ok == 1)//超声波数据有效，超声波数据权重增加
			{
				sonar_weight += 0.5f *dtime;
			}
			else//超声波数据失效，，超声波数据权重减少
			{ 
				sonar_weight-= 2.0f *dtime;
			}
			sonar_weight = LIMIT(sonar_weight,0,1);//超声波权重限制范围0--1
			
			//中位不使用超声波
//			if(mode_state == 1)
//			{
//				sonar_weight = 0;
//			}
//////////////////////////////////////////
			wz_speed = baro_fusion.fusion_speed_m.out - baro_fusion.fusion_speed_me.out;
			
			float m_speed,f_speed;
			m_speed = (1 - sonar_weight) *baro_p.speed + sonar_weight *(sonar.speed);
			f_speed = (1 - sonar_weight) *(wz_speed) + sonar_weight *(sonar_fusion.fusion_speed_m.out - sonar_fusion.fusion_speed_me.out);
			
			height_value->m_acc = acc_3d_hg.z;
			height_value->m_speed = m_speed;  //(1 - sonar_weight) *hf1.ref_speed_lpf + sonar_weight *(sonar.speed);
			height_value->m_height = baro_p.displacement;
			height_value->fusion_acc = baro_fusion.fusion_acceleration.out;
			height_value->fusion_speed = my_deathzoom(LIMIT( (f_speed),-MAX_VERTICAL_SPEED_DW,MAX_VERTICAL_SPEED_UP),height_value->fusion_speed,10);
			height_value->fusion_height = baro_fusion.fusion_displacement.out; 
}
