makermare/UAV-FlyingControlSystem-LightFlightControl/8. 飞控三方源代码结合OpenMV/LIGHT飞控代码201708-光流定点(OpenMV串级PID)/applications/height_ctrl.h

#ifndef __HEIGHT_CTRL_H
#define __HEIGHT_CTRL_H

#include "stm32f4xx.h"

#include "parameter.h"

//typedef xyz_f_t _xyz_f_t;
#define _xyz_f_t xyz_f_t

#define THR_TAKE_OFF_LIMIT 550
typedef struct
{
	float m_acc;
	float m_speed;
	float m_height;
	float fusion_acc;
	float fusion_speed;
	float fusion_height;

}_hc_value_st;
extern _hc_value_st hc_value;

float auto_take_off_land(float dT,u8 ready);
float Height_Ctrl(float T,float thr,u8 ready,float en);
void h_pid_init(void);
#endif
