makermare/UAV-FlyingControlSystem-LightFlightControl/7. 飞控三方源代码-基础部分/LIGHT飞控三方代码Keil工程12017-07-20/applications/parameter.c

#include "include.h"
#include "mpu6050.h"
#include "ak8975.h"
#include "ctrl.h"
#include "string.h"
#include "ff.h"
#include "height_ctrl.h"

#define SENSOR_SETUP_FILE      "sensor.bin"
#define PID_SETUP_FILE         "pid.bin"
u8 flash_init_error;
sensor_setup_t sensor_setup;
pid_setup_t pid_setup;

/* 文件相关定义 */
static FATFS fs;
static 	FIL file;
static 	DIR DirInf;
	
static int32_t Para_ReadSettingFromFile(void)
{
	FRESULT result;
	uint32_t bw;

 	/* 挂载文件系统 */
	result = f_mount(&fs, "0:", 1);			/* Mount a logical drive */
	if (result != FR_OK)
	{
		/* 如果挂载不成功，进行格式化 */
		result = f_mkfs("0:",0,0);
		if (result != FR_OK)
		{
			 return -1;     //flash有问题，无法格式化
		}
		else
		{
			/* 重新进行挂载 */
			result = f_mount(&fs, "0:", 0);			/* Mount a logical drive */
	   if (result != FR_OK)
      {
			 	/* 卸载文件系统 */
	      f_mount(NULL, "0:", 0);
			 return -2 ;
			}
		}
	}

	/* 打开根文件夹 */
	result = f_opendir(&DirInf, "/"); 
	if (result != FR_OK)
	{
		/* 卸载文件系统 */
	  f_mount(NULL, "0:", 0);
		return -3;
	}

	/* 打开文件 */
	result = f_open(&file, SENSOR_SETUP_FILE, FA_OPEN_EXISTING | FA_READ);
	if (result !=  FR_OK)
	{
	  /* 卸载文件系统 */
	  f_mount(NULL, "0:", 0);
   /* 文件不存在 */
		return -4;
	}

	/* 读取Sensor配置文件 */
	result = f_read(&file, &sensor_setup.raw_data, sizeof(sensor_setup), &bw);
	if (bw > 0)
	{
		/* 关闭文件*/
	 f_close(&file);
		/* 打开文件 */
	 result = f_open(&file, PID_SETUP_FILE, FA_OPEN_EXISTING | FA_READ);
	  if (result !=  FR_OK)
	 {
		/* 卸载文件系统 */
	  f_mount(NULL, "0:", 0);
		return -4;
	 }
		/* 读取PID配置文件 */
	 result = f_read(&file, &pid_setup.raw_data, sizeof(pid_setup), &bw);
    if(bw > 0)
		{
		 /* 关闭文件*/
	   f_close(&file);
		 	/* 卸载文件系统 */
	   f_mount(NULL, "0:", 0);
			return 1;
		}else
		{
		 /* 关闭文件*/
	   f_close(&file);
		 	/* 卸载文件系统 */
	    f_mount(NULL, "0:", 0);
			return -4;
		}
	}else
  {
	 /* 关闭文件*/
	 f_close(&file);
	 	/* 卸载文件系统 */
	 f_mount(NULL, "0:", 0);
	 return -5;
	}

}

static int32_t Para_WriteSettingToFile(void)
{
	FRESULT result;
	uint32_t bw;

 	/* 挂载文件系统 */
	result = f_mount(&fs, "0:", 0);			/* Mount a logical drive */
	if (result != FR_OK)
	{
		/* 如果挂载不成功，进行格式化 */
		result = f_mkfs("0:",0,0);
		if (result != FR_OK)
		{
			 return -1;     //flash有问题，无法格式化
		}
		else
		{
			/* 重新进行挂载 */
			result = f_mount(&fs, "0:", 0);			/* Mount a logical drive */
	   if (result != FR_OK)
      {
			 	/* 卸载文件系统 */
	      f_mount(NULL, "0:", 0);
			 return -2 ;
			}
		}
	}

	/* 打开根文件夹 */
	result = f_opendir(&DirInf, "/"); 
	if (result != FR_OK)
	{
		/* 卸载文件系统 */
	  f_mount(NULL, "0:", 0);
		return -3;
	}

	/* 打开文件 */
	result = f_open(&file, SENSOR_SETUP_FILE, FA_CREATE_ALWAYS | FA_WRITE);
	if (result !=  FR_OK)
	{
	  /* 卸载文件系统 */
	  f_mount(NULL, "0:", 0);
		return -4;
	}

	/* 写入Sensor配置文件 */
	result = f_write(&file, &sensor_setup.raw_data, sizeof(sensor_setup), &bw);
	if (result == FR_OK)
	{
		/* 关闭文件*/
	 f_close(&file);
		/* 打开文件 */
	 result = f_open(&file, PID_SETUP_FILE, FA_CREATE_ALWAYS | FA_WRITE);
	  if (result !=  FR_OK)
	 {
		/* 卸载文件系统 */
	  f_mount(NULL, "0:", 0);
		return -4;
	 }
		/* 写入PID配置文件 */
	 result = f_write(&file, &pid_setup.raw_data, sizeof(pid_setup), &bw);
    if(result == FR_OK)
		{
	 		/* 关闭文件*/
	    f_close(&file);
		 	/* 卸载文件系统 */
	   f_mount(NULL, "0:", 0);
			return 1;
		}else
		{
		  /* 关闭文件*/
	   f_close(&file);
		 	/* 卸载文件系统 */
	    f_mount(NULL, "0:", 0);
			return -4;
		}
	}else
  {
	  /* 关闭文件*/
	  f_close(&file);
		/* 卸载文件系统 */
	  f_mount(NULL, "0:", 0);
	 return -5;
	}

}


static void  Param_SetSettingToFC(void) 
{
	memcpy(&mpu6050.Acc_Offset,&sensor_setup.Offset.Accel,sizeof(xyz_f_t));
	memcpy(&mpu6050.Gyro_Offset,&sensor_setup.Offset.Gyro,sizeof(xyz_f_t));
	memcpy(&ak8975.Mag_Offset,&sensor_setup.Offset.Mag,sizeof(xyz_f_t));
	memcpy(&mpu6050.vec_3d_cali,&sensor_setup.Offset.vec_3d_cali,sizeof(xyz_f_t));
	
	mpu6050.Acc_Temprea_Offset = sensor_setup.Offset.Acc_Temperature;
	mpu6050.Gyro_Temprea_Offset = sensor_setup.Offset.Gyro_Temperature;
  
  memcpy(&ctrl_1.PID[PIDROLL],&pid_setup.groups.ctrl1.roll,sizeof(pid_t));
	memcpy(&ctrl_1.PID[PIDPITCH],&pid_setup.groups.ctrl1.pitch,sizeof(pid_t));
	memcpy(&ctrl_1.PID[PIDYAW],&pid_setup.groups.ctrl1.yaw,sizeof(pid_t));
	
	
	memcpy(&ctrl_2.PID[PIDROLL],&pid_setup.groups.ctrl2.roll,sizeof(pid_t));
	memcpy(&ctrl_2.PID[PIDPITCH],&pid_setup.groups.ctrl2.pitch,sizeof(pid_t));
	memcpy(&ctrl_2.PID[PIDYAW],&pid_setup.groups.ctrl2.yaw,sizeof(pid_t));

}

void Para_ResetToFactorySetup(void)
{
	/* 如果挂载不成功，进行格式化 */
	f_mkfs("0:",1,0);

	/* 以下是所有 PID 默认值，只有收到串口的 恢复默认参数 命令，才会恢复到这些参数 */

	/* ROLL速率 */
	pid_setup.groups.ctrl1.roll.kp  = 0.800;
	pid_setup.groups.ctrl1.roll.ki  = 0.100;
	pid_setup.groups.ctrl1.roll.kd  = 2.000;
	pid_setup.groups.ctrl1.roll.kdamp  = 1;
	/* PITCH速率 */
	pid_setup.groups.ctrl1.pitch.kp = 0.800;
	pid_setup.groups.ctrl1.pitch.ki = 0.100;
	pid_setup.groups.ctrl1.pitch.kd = 2.000;
	pid_setup.groups.ctrl1.pitch.kdamp = 1;
	/* YAW速率 */
	pid_setup.groups.ctrl1.yaw.kp   = 1.200;
	pid_setup.groups.ctrl1.yaw.ki   = 1.000;
	pid_setup.groups.ctrl1.yaw.kd   = 1.000;
	pid_setup.groups.ctrl1.yaw.kdamp   = 1;
	/* ROLL自稳 */
	pid_setup.groups.ctrl2.roll.kp  = 0.500;
	pid_setup.groups.ctrl2.roll.ki  = 0.050;
	pid_setup.groups.ctrl2.roll.kd  = 0.300;
	/* PITCH自稳 */
	pid_setup.groups.ctrl2.pitch.kp = 0.500;
	pid_setup.groups.ctrl2.pitch.ki = 0.050;
	pid_setup.groups.ctrl2.pitch.kd = 0.300;
	/* YAW自稳 */
	pid_setup.groups.ctrl2.yaw.kp   = 0.200;
	pid_setup.groups.ctrl2.yaw.ki   = 0.050;
	pid_setup.groups.ctrl2.yaw.kd   = 0.100;
	/* 气压计高度 */
	pid_setup.groups.hc_sp.kp = 0.3f;
	pid_setup.groups.hc_sp.ki = 0.12f;
	pid_setup.groups.hc_sp.kd = 1.4f;
	/* 超声波高度 */
	pid_setup.groups.hc_height.kp = 1.5f;
	pid_setup.groups.hc_height.ki = 0.0f;
	pid_setup.groups.hc_height.kd = 2.5f;
	/* 位置速率 */
	pid_setup.groups.ctrl3.kp = 0.0f;
	pid_setup.groups.ctrl3.ki = 0.0f;
	pid_setup.groups.ctrl3.kd = 0.0f;
	/* 位置保持 */
	pid_setup.groups.ctrl4.kp = 0.0f;
	pid_setup.groups.ctrl4.ki = 0.0f;
	pid_setup.groups.ctrl4.kd = 0.0f;
	
  Para_WriteSettingToFile();
	Param_SetSettingToFC();
	PID_Para_Init();
}

void PID_Para_Init()
{
	Ctrl_Para_Init();
	h_pid_init();

}

void Para_Init()
{
	int32_t result = Para_ReadSettingFromFile();
  if(result < 0)
  {
	 Para_ResetToFactorySetup();
	 flash_init_error = 1;
	}
	Param_SetSettingToFC();
	
	PID_Para_Init();
}

void Param_SaveAccelOffset(xyz_f_t *offset)
{
 memcpy(&mpu6050.Acc_Offset,offset,sizeof(xyz_f_t));
 memcpy(&sensor_setup.Offset.Accel, offset,sizeof(xyz_f_t));
	
 sensor_setup.Offset.Acc_Temperature = mpu6050.Acc_Temprea_Offset ;
	
 Para_WriteSettingToFile();
}

void Param_SaveGyroOffset(xyz_f_t *offset)
{
 memcpy(&mpu6050.Gyro_Offset,offset,sizeof(xyz_f_t));
 memcpy(&sensor_setup.Offset.Gyro, offset,sizeof(xyz_f_t));
	
 sensor_setup.Offset.Gyro_Temperature = mpu6050.Gyro_Temprea_Offset ;
	
 Para_WriteSettingToFile();
}

void Param_SaveMagOffset(xyz_f_t *offset)
{
 memcpy(&ak8975.Mag_Offset,offset,sizeof(xyz_f_t));
 memcpy(&sensor_setup.Offset.Mag, offset,sizeof(xyz_f_t));
 Para_WriteSettingToFile();
}

void Param_Save_3d_offset(xyz_f_t *offset)
{
 memcpy(&mpu6050.vec_3d_cali,offset,sizeof(xyz_f_t));
 memcpy(&sensor_setup.Offset.vec_3d_cali, offset,sizeof(xyz_f_t));
	
 Para_WriteSettingToFile();
}

void Param_SavePID(void)
{
 memcpy(&pid_setup.groups.ctrl1.roll,&ctrl_1.PID[PIDROLL],sizeof(pid_t));
 memcpy(&pid_setup.groups.ctrl1.pitch,&ctrl_1.PID[PIDPITCH],sizeof(pid_t));
 memcpy(&pid_setup.groups.ctrl1.yaw,&ctrl_1.PID[PIDYAW],sizeof(pid_t));
  
 memcpy(&pid_setup.groups.ctrl2.roll,&ctrl_2.PID[PIDROLL],sizeof(pid_t));
 memcpy(&pid_setup.groups.ctrl2.pitch,&ctrl_2.PID[PIDPITCH],sizeof(pid_t));
 memcpy(&pid_setup.groups.ctrl2.yaw,&ctrl_2.PID[PIDYAW],sizeof(pid_t));
 Para_WriteSettingToFile();
}
extern u16 flash_save_en_cnt;

void Parameter_Save()
{
  if( flash_save_en_cnt !=0 )
	{
		flash_save_en_cnt++;
	}

	if( flash_save_en_cnt > 60 ) // 20 *60 = 1200ms
	{
		flash_save_en_cnt = 0;
		if( !fly_ready )
		{
			Param_SavePID();
		}
	}
}
