makermare/UAV-FlyingControlSystem-LightFlightControl/7. 飞控三方源代码-基础部分/LIGHT飞控三方代码Keil工程12017-07-20/applications/parameter.h

#ifndef _PARAMETER_H
#define	_PARAMETER_H

#include "stm32f4xx.h"

typedef struct
{
	float kp;
	float kd;
	float ki;
	float kdamp;

}pid_t;

typedef struct 
{
  float x;
	float y;
	float z;
}xyz_f_t;

typedef struct 
{
  s16 x;
	s16 y;
	s16 z;

}xyz_s16_t;


typedef union
{
	uint8_t raw_data[64];
	struct
	{
		xyz_f_t Accel;
		xyz_f_t Gyro;
		xyz_f_t Mag;
		xyz_f_t vec_3d_cali;
		uint32_t mpu_flag;
		float Acc_Temperature;
		float Gyro_Temperature;
	}Offset;
}sensor_setup_t; //__attribute__((packed)) 

typedef  struct{
pid_t roll;
pid_t pitch;	
pid_t yaw;	
 }pid_group_t;

typedef union
{
 uint8_t raw_data[192];
 struct
 {
	 pid_group_t ctrl1;
	 pid_group_t ctrl2;
 /////////////////////
	 pid_t hc_sp;
	 pid_t hc_height;
	 pid_t ctrl3;
	 pid_t ctrl4;
 	  
 }groups;

}pid_setup_t;

extern sensor_setup_t sensor_setup;
extern pid_setup_t pid_setup;

void Senser_Calibrat_Read(void);
void PID_Para_Read(void);
void Para_Init(void);

void Para_ResetToFactorySetup(void);
void Param_SavePID(void);
void Param_SaveAccelOffset(xyz_f_t *offset);
void Param_SaveGyroOffset(xyz_f_t *offset);
void Param_SaveMagOffset(xyz_f_t *offset);
void Param_Save_3d_offset(xyz_f_t *offset);
void Parameter_Save(void);
void PID_Para_Init(void);

#endif
