makermare/UAV-FlyingControlSystem-LightFlightControl/7. 飞控三方源代码-基础部分/LIGHT飞控三方代码Keil工程12017-07-20/applications/imu.h

#ifndef _IMU_H_
#define	_IMU_H_

#include "stm32f4xx.h"

#include "parameter.h"
#include "mymath.h"
#include "math.h"

typedef struct 
{
	xyz_f_t err;
	xyz_f_t err_tmp;
	xyz_f_t err_lpf;
	xyz_f_t err_Int;
	xyz_f_t g;
	
}ref_t;

extern xyz_f_t reference_v,acc_3d_hg;
void IMUupdate(float half_T,float gx, float gy, float gz, float ax, float ay, float az,float *rol,float *pit,float *yaw);
extern float Roll,Pitch,Yaw;


#endif
