makermare/UAV-FlyingControlSystem-LightFlightControl/7. 飞控三方源代码-基础部分/LIGHT飞控三方代码Keil工程12017-07-20/drivers/ak8975.h

#ifndef _AK8975_H_
#define	_AK8975_H_

#include "stm32f4xx.h"
#include "stdbool.h"
#include "include.h"

#define CALIBRATING_MAG_CYCLES              2000  //校准时间持续20s

#define AK8975_ADDRESS         0x0c	// 0x18

#define AK8975_WIA     0x00
#define AK8975_HXL     0x03
#define AK8975_HXH     0x04
#define AK8975_HYL     0x05
#define AK8975_HYH     0x06
#define AK8975_HZL     0x07
#define AK8975_HZH     0x08
#define AK8975_CNTL    0x0A

typedef struct 
{
	xyz_s16_t Mag_Adc;			//采样值
	xyz_f_t Mag_Offset;		//偏移值
	xyz_f_t 	Mag_Gain;			//比例缩放	
  xyz_f_t 	Mag_Val;			//纠正后的值
}ak8975_t;

extern ak8975_t ak8975;

bool LIGHT_AK8975_Run(void);
void LIGHT_AK8975_CalOffset_Mag(void);
void LIGHT_AK8975_Read(void);


extern u8 Mag_CALIBRATED;
extern u8 ak8975_ok;

#endif
