makermare/UAV-FlyingControlSystem-LightFlightControl/7. 飞控三方源代码-基础部分/LIGHT飞控三方代码Keil工程12017-07-20/drivers/ms5611.h

#ifndef _MS5611_H
#define _MS5611_H

#include "stm32f4xx.h"
#include "i2c_soft.h"
#include "mpu6050.h"

#define MS5611_ADDR             0x77   //0xee //

#define CMD_RESET               0x1E // ADC reset command
#define CMD_ADC_READ            0x00 // ADC read command
#define CMD_ADC_CONV            0x40 // ADC conversion command
#define CMD_ADC_D1              0x00 // ADC D1 conversion
#define CMD_ADC_D2              0x10 // ADC D2 conversion
#define CMD_ADC_256             0x00 // ADC OSR=256
#define CMD_ADC_512             0x02 // ADC OSR=512
#define CMD_ADC_1024            0x04 // ADC OSR=1024
#define CMD_ADC_2048            0x06 // ADC OSR=2048
#define CMD_ADC_4096            0x08 // ADC OSR=4096
#define CMD_PROM_RD             0xA0 // Prom read command
#define PROM_NB                 8
#define MS5611_OSR							0x08	//CMD_ADC_4096

typedef struct
{
	s32 height;//cm
	
	float relative_height;	
	float h_delta;
	float h_dt;
	
	u8 measure_ok;
	u8 measure_ot_cnt;
}_height_st;

extern _height_st baro;

	//气压计初始化
	void MS5611_Init(void);
	//读取气压计数据
	int MS5611_Update(void);	
	//返回气压高度
	
	int32_t MS5611_Get_BaroAlt(void);

	void MS5611_Reset(void);
	u8 MS5611_Read_Prom(void);
	void MS5611_Start_T(void);
	void MS5611_Start_P(void);
	void MS5611_Read_Adc_T(void);
	void MS5611_Read_Adc_P(void);
	void MS5611_BaroAltCalculate(void);

extern u8 ms5611_ok;



#endif
