makermare/UAV-FlyingControlSystem-LightFlightControl/7. 飞控三方源代码-基础部分/LIGHT飞控三方代码Keil工程12017-07-20/drivers/time.h

#ifndef _TIME_H_
#define _TIME_H_

#include "stm32f4xx.h"

void TIM_INIT(void);
void sys_time(void);

u16 Get_Time(u8,u16,u16);

u32 Get_Cycle_T(u8 );

void Cycle_Time_Init(void);

extern volatile uint32_t sysTickUptime;
extern int time_1h,time_1m,time_1s,time_1ms;

void Delay_us(uint32_t);
void Delay_ms(uint32_t);
void SysTick_Configuration(void);
uint32_t GetSysTime_us(void);
#endif
