makermare/UAV-FlyingControlSystem-LightFlightControl/7. 飞控三方源代码-基础部分/LIGHT飞控三方代码Keil工程12017-07-20/drivers/usart.h

#ifndef _USART_H
#define _USART_H

#include "stm32f4xx.h"

extern u8 Rx_Buf[];
void Usart2_Init(u32 br_num);
void Usart2_IRQ(void);
void Usart2_Send(unsigned char *DataToSend ,u8 data_num);

void Uart4_Init(u32 br_num);
void Uart4_IRQ(void);

void Uart5_Init(u32 br_num);
void Uart5_IRQ(void);
void Uart5_Send(unsigned char *DataToSend ,u8 data_num);
#endif
