makermare/UAV-FlyingControlSystem-LightFlightControl/8. 飞控三方源代码结合OpenMV/LIGHT飞控代码201708-光流定点(OpenMV串级PID)/applications/data_transfer.h

#ifndef _DATA_TRANSFER_H
#define	_DATA_TRANSFER_H

#include "stm32f4xx.h"
#include "height_ctrl.h"


typedef struct
{
    u8 msg_id;
    u8 msg_data;
    u8 send_check;
    u8 send_version;
    u8 send_status;
    u8 send_senser;
    u8 send_senser2;
    u8 send_pid1;
    u8 send_pid2;
    u8 send_pid3;
    u8 send_pid4;
    u8 send_pid5;
    u8 send_pid6;
    u8 send_rcdata;
    u8 send_offset;
    u8 send_motopwm;
    u8 send_power;
    u8 send_user;
    u8 send_speed;
    u8 send_location;

} dt_flag_t;

extern dt_flag_t f;


void LIGHT_DT_Data_Exchange(void);
void LIGHT_DT_Data_Receive_Prepare(u8 data);
void LIGHT_DT_Data_Receive_Anl(u8 *data_buf,u8 num);
void LIGHT_DT_Send_Version(u8 hardware_type, u16 hardware_ver,u16 software_ver,u16 protocol_ver,u16 bootloader_ver);
void LIGHT_DT_Send_Status(float angle_rol, float angle_pit, float angle_yaw, s32 alt, u8 fly_model, u8 armed);
void LIGHT_DT_Send_Senser(s16 a_x,s16 a_y,s16 a_z,s16 g_x,s16 g_y,s16 g_z,s16 m_x,s16 m_y,s16 m_z);
void LIGHT_DT_Send_Senser2(s32 bar_alt,u16 csb_alt);
void LIGHT_DT_Send_RCData(u16 thr,u16 yaw,u16 rol,u16 pit,u16 aux1,u16 aux2,u16 aux3,u16 aux4,u16 aux5,u16 aux6);
void LIGHT_DT_Send_Power(u16 votage, u16 current);
void LIGHT_DT_Send_MotoPWM(u16 m_1,u16 m_2,u16 m_3,u16 m_4,u16 m_5,u16 m_6,u16 m_7,u16 m_8);
void LIGHT_DT_Send_PID(u8 group,float p1_p,float p1_i,float p1_d,float p2_p,float p2_i,float p2_d,float p3_p,float p3_i,float p3_d);
void LIGHT_DT_Send_User(void);
void LIGHT_DT_Send_Speed(float,float,float);
void LIGHT_DT_Send_Location(u8 state,u8 sat_num,s32 lon,s32 lat,float back_home_angle);

#endif
