makermare/UAV-FlyingControlSystem-LightFlightControl/8. 飞控三方源代码结合OpenMV/LIGHT飞控代码201708-光流定点(OpenMV串级PID)/applications/filter.h

#ifndef __FILTER_H
#define __FILTER_H

#include "parameter.h"

#define LPF_1_(hz,t,in,out) ((out) += ( 1 / ( 1 + 1 / ( (hz) *6.28f *(t) ) ) ) *( (in) - (out) ))

#define LPF_1(A,B,C,D) LPF_1_((A),(B),(C),*(D));

typedef struct
{
	float a;
	float b;
	float e_nr;
	float out;
} _filter_1_st;

void filter_1(float base_hz,float gain_hz,float dT,float in,_filter_1_st *f1);

void Moving_Average(float moavarray[],u16 len ,u16 *fil_cnt,float in,float *out);
s32 Moving_Median(s32 moavarray[],u16 len ,u16 *fil_p,s32 in);
#define _xyz_f_t xyz_f_t
void simple_3d_trans(_xyz_f_t *ref, _xyz_f_t *in, _xyz_f_t *out);

#endif
