makermare/UAV-FlyingControlSystem-LightFlightControl/8. 飞控三方源代码结合OpenMV/LIGHT飞控代码201708-光流定点(OpenMV串级PID)/applications/fly_mode.h

#ifndef __FLY_MODE_H
#define __FLY_MODE_H

#include "stm32f4xx.h"
#include "include.h"
#include "parameter.h"

enum
{
	BARO=0,
	GPS,
	BACK_HOME,
};

extern u8 mode_value[],mode_state;


void mode_check(float *ch_in,u8 *mode_value);
#endif
