makermare/UAV-FlyingControlSystem-LightFlightControl/8. 飞控三方源代码结合OpenMV/LIGHT飞控代码201708-光流定点(OpenMV串级PID)/applications/scheduler.h

#ifndef _SCHEDULER_H_
#define _SCHEDULER_H_

#include "stm32f4xx.h"

typedef struct
{
	u8 check_flag;
	u8 err_flag;
	s16 cnt_1ms;
	s16 cnt_2ms;
	s16 cnt_5ms;
	s16 cnt_10ms;
	s16 cnt_20ms;
	s16 cnt_50ms;
	u16 time;
}loop_t;

void Loop_check(void);

void Duty_Loop(void);

void Inner_Loop(float);

void Outer_Loop(float);

#endif
