makermare/UAV-FlyingControlSystem-LightFlightControl/(commit log)

2022-06-07 删除文件 README.en.md
2022-06-10 Makemare is your best Teacherr
    [LIGHT飞控专属通信协议-1.2.xlsx]
2022-07-04 Makermare is your best Teacher!
    [LIGHT飞控专属通信协议-1.2.xlsx]
